kiogimwenda/AR_Windscreen/hardware/README.md

# Hardware

The custom hardware of the two-box hub: `docs/BUILD_GUIDE.md` Part 4.8 is the design, Part 14
Phase 12B the plan.

| Directory | Contents | Status (2026-10-06) |
|---|---|---|
| `gen/` | The board descriptions, the power board's drawing, and the tools that turn them into KiCad files and check them | Done |
| `pod_board/` | KiCad 10 project: STM32F405RGT6, 8 MHz crystal, USB-C, diode-OR'd 5 V to 3.3 V, IMU / GNSS / gesture / SWD / ELM327 headers, status LEDs, DB-25 with series resistors and input filters. 4-layer. | Schematic done, ERC clean, cross-checked; **placed** (77 parts, 0 DRC errors, matches the schematic); **routing to do** (`LAYOUT_GUIDE.md`) |
| `power_board/` | KiCad 10 project: 12 V fuse, TVS and reverse-polarity diode; TPS54360 5 V (TI reference design); 3.3 V; 74HCT244 buffer; BTS7960 and ACS712 module headers; magnet and relay MOSFETs with flyback diodes; fail-safe pull-downs; SN65HVD230 CAN; presence MOSFET; PC817 brake-light input; terminals for the kill relay, E-stop, relays, actuator, LiDAR and OBD lead; DB-25. 2-layer, 2 oz. | Schematic done, ERC clean, cross-checked; **placed** (82 parts, 0 DRC errors, matches the schematic); **routing to do** (`LAYOUT_GUIDE.md`) |
| `enclosures/` | OpenSCAD: LiDAR roof mount, power-box chassis and box drilling templates; shared board outlines (`common/boards.scad`). See its README. | LiDAR mount and power box designed; pod, E-stop and gesture puck wait for the parts and the car |

Each board folder also has `<board>.pdf` (the schematic, for reading without KiCad) and
`<board>_bom.csv` (parts grouped by value and footprint).

## How the schematics are made and checked

```bash
hardware/gen/check.sh
```
1. `gen/generate.py` writes both `.kicad_sch` files from `gen/pod_board.py` and
   `gen/power_board.py`. Each part names its KiCad symbol, footprint and value and maps **pin
   numbers to net names**; the generator copies the real library symbols in.
   - **Both boards are drawn (2026-10-07).** `gen/power_board_drawing.py` places every part by hand
     on one of eight function sheets (12 V input, 5 V converter, 3.3 V and feeds, brake actuator,
     signal relays, CAN, status inputs, DB-25), and `gen/kisheet.py` routes **real wires** between
     the pins, puts power symbols on power pins, names each net with a label, and draws a root
     sheet that is the **block diagram**: one box per sheet, the cable signals wired between them.
     Open `power_board.kicad_pro`, start on the block diagram, double-click a box to enter it.
     `gen/pod_board_drawing.py` does the same for the pod: power, USB-C, the MCU (in the middle,
     every pin straight out to a port), sensors and local connectors, status LEDs, and the cable
     interface (series resistors, pull-ups and filters fanning in to the DB-25 without a crossing).
2. KiCad's ERC must report **0 violations**. For each drawn board, the label-only version is also
   generated (in a scratch directory) and `gen/compare_nets.py` requires the two netlists to be
   **identical**: same parts, values and footprints, every net joining the same pins under the
   same name. The drawing therefore cannot have changed the circuit. The wire router never lets two
   nets touch; a wire may only cross another at right angles over a plain run (no dot, no
   connection), never at a bend, pin or junction.
3. `gen/check_nets.py` reads the exported netlists and verifies, against the sources of truth:
   - every pin in `firmware/.../Config.h` is on the right STM32 pin of the pod board;
   - every DB-25 pin on both boards matches the table in BUILD_GUIDE 4.8.3 (parsed from the guide);
   - pod: each cable line passes through a series resistor; inputs read safe when unplugged;
   - power board: every pod-driven line is pulled to its safe state (Part 4.8.4's rule);
   - no misspelt single-connection nets; no pin in two nets (two parts sharing a reference,
     which KiCad's ERC does not report); every footprint exists in KiCad's library.

   It was tested by breaking the design on purpose (a relay moved to the wrong MCU pin, a
   pull-down removed, two cable pins swapped); each was caught.

**Change the design in `gen/*.py`, never only in KiCad's editor**, then run `check.sh`. Edits made
only in the `.kicad_sch` are overwritten by the next generation. (Once layout starts, the
schematic can be frozen and edited in KiCad directly; then stop regenerating and keep running the
netlist check: export the netlist from KiCad and run `check_nets.py` on it.)

## Choices made during schematic capture (see also decisions.md)

- **Reverse polarity: a B560C Schottky, not a P-MOSFET.** SOT-23 P-MOSFETs are rated −30 V, too
  close to the TVS's ~39 V clamp. The diode drops ~0.6 V (~1 W at 2 A) and needs no gate circuit.
- **5 V converter: TI's TPS54360 reference design, unchanged** (datasheet SLVSBB4G, Figure 34):
  600 kHz, 8.2 µH, B560C, 2 × 47 µF, compensation 13.0 k / 6800 p / 39 p, start 8 V / stop 6.25 V.
  Copying a validated design is the right call for a first board; it is rated well beyond our
  ~1 A load.
- **Relays and magnet: logic-level MOSFETs driven straight from the cable lines** (AO3400A turns
  fully on at 2.5 V); the 74HCT244 buffers only the BTS7960 module's three 5 V inputs.
- **Back-powering:** each pod output has a 1 k series resistor (330 Ω on CAN_TX for its 500 kbit/s
  edges), so a pod running on USB cannot push more than ~3 mA per line into an unpowered box.
- **Module headers are placeholders for breakouts** (BNO085, NEO-M8N): the pin order on `J2` and
  `J3` of the pod board must be matched to the actual breakouts bought **before layout**.

## What remains for Phase 12B (Ian's work)

**Both boards are placed (2026-10-08): routing, finishing and ordering remain, step by step in
[`LAYOUT_GUIDE.md`](LAYOUT_GUIDE.md).** `gen/layout.sh` built each `.kicad_pcb` from the board
descriptions: every footprint from KiCad's library, each pad on its net (from KiCad's own
netlist), placed per `gen/placement.py` (each position with its reason, listed in
`<board>/placement.md`, pictured in `<board>/placement.png`), linked to its schematic symbol, the
net classes and fab rules (`gen/pcb_rules.py`, track widths from IPC-2221) and the copper planes
in place; then KiCad's DRC with the schematic-parity check: 0 errors, exact parity. The schematic
generator now gives every object a deterministic id, so the links survive regeneration and the
files only change when the design does.

The notes below are the layout principles the placement follows (and the guide expands).

**Pod board (4-layer: signal / ground / power / signal).**
- Decoupling capacitors (C3–C9) at their VDD pins, each with its own via to the ground plane.
  VCAP capacitors (C10, C11) right at pins 31 and 47.
- Crystal (Y1, C12, C13) within ~5 mm of PH0/PH1, nothing routed underneath, guard with ground.
- USB D+/D− as a matched pair (~90 Ω differential), short, the ESD chip (U4) right at the socket.
- The GNSS breakout at the board edge that faces the glass, away from the MCU and the USB; keep
  the ground plane unbroken under it.
- The IMU breakout on standoffs at a fixed, known orientation (record it: Part 12.2.2 calibrates
  it, but a sensible starting orientation makes the calibration easy to check).
- DB-25 at one end, the series resistors and input filters right behind it.
- Status LEDs on the edge that faces the driver.

**Power board (2-layer, 2 oz copper).**
- The TPS54360's power loop is the critical path: input capacitors (C21, C22), the IC, the catch
  diode (D13) and the inductor (L1) as close together as possible, the SW node small (it is the
  board's noise source), the feedback divider (R44, R45) away from L1 and the SW node. Follow the
  datasheet's layout example (its "Layout" section) closely.
- Wide traces or pours for the 12 V input, the actuator rail (ACT_12V) and the relay coils' +12 V;
  the actuator's heavy current itself runs in wire on the BTS7960 module, not on this board.
- Fuse holders and terminal blocks along the edges, grouped by what they connect to (12 V in,
  actuator side, car-wiring side).
- The SN65HVD230 and its ESD diode (D20) right at the OBD terminal block.
- The 10 k pull-downs close to the DB-25, so the lines are defined as soon as they enter the board.

**Then:** DRC clean, a 1:1 paper print to check every footprint against the real part, Gerbers,
order (JLCPCB / PCBWay), assemble, and bring up with Part 4.7 before the bench gate is re-run on
this hardware (three consecutive passes of all six items).

## Board outlines: the one constraint shared with the enclosures

```bash
python3 hardware/gen/outlines.py           # --force to overwrite a .kicad_pcb already being laid out
```
`gen/outlines.py` holds each board's size, corner radius, M3 mounting holes and the positions of
its edge connectors (DB-25, USB-C, fuses, terminal blocks, LEDs, headers). It writes the starter
`<board>.kicad_pcb` (outline on Edge.Cuts, hole positions on User.Drawings, connector boxes on
User.Comments: place H1–H4 and the connectors on them) and `enclosures/common/boards.scad`, which
the enclosure models include. Pod board 70 × 53 mm, 4 layers; power board 95 × 66 mm, 2 layers (compacted 2026-10-08 from 80 × 55 and 110 × 80; the power board 5 mm wider again on 2026-10-09 for its silkscreen labels).
If a layout needs a change, change it there and regenerate both. The starter files passed KiCad's
DRC with no errors.

**Placed and routed (2026-10-09):** `gen/layout.sh` places every part (`gen/placement.py`, with
each position's reason and the silkscreen names), `gen/route.sh` routes both boards to the
specification and keeps a board only with 0 unconnected, 0 DRC errors and exact schematic parity,
and `gen/routespec.sh` checks what the DRC cannot (planes, crystal, converter, widths). How it was
done and how to review it: `LAYOUT_GUIDE.md`.
