kiogimwenda/AR_Windscreen/docs/report/final/README.md

# Final report: draft sections

Drafts of the final report's sections that need no test results, following BUILD_GUIDE Part 16.1's
structure. They are written from the design as built (the guide, `docs/decisions.md`, the code)
on 2026-10-16, for Ian to rewrite in his own voice and check against his supervisor's template.

Citations use the proposal's keys, `{{cite:key}}`, so `docs/report/proposal/src/references.py`
can resolve them. Places that need a test result, a photograph or a final figure are marked
**[RESULT: …]** or **[FIGURE: …]**; nothing in these drafts claims a measurement that has not been
made.

| Part 16.1 section | File | State |
|---|---|---|
| 1. Executive Summary | — | after the results |
| 2. Motivation and Scope | `02_motivation_scope.md` | drafted |
| 3. System Architecture | `03_system_architecture.md` | drafted; the diagram to redraw |
| 4. Software Architecture | `04_software_architecture.md` | drafted |
| 5. Actuation Safety Design | `05_actuation_safety.md` | drafted; bench evidence slots |
| 6. Precision Navigation Overlay Design | `06_navigation_overlay.md` | drafted; Part 12.4 figures slot |
| 7. Hardware Bill of Materials | — | needs the actual costs |
| 8. Calibration | — | needs the results |
| 9. Testing and Validation | `09_testing_validation.md` | 9.1 circuit simulations drafted, with their figures (`figures/`); bench and road tests wait |
| 10. Results and Discussion | — | needs the results |
| 11. Future Work | `11_future_work.md` | drafted |
| 12. Conclusion | — | after the results |
