kiogimwenda/AR_Windscreen/hardware/pod_board/placement.md

<!-- Generated by hardware/gen/layout.py from placement.py: do not edit. -->

# pod_board: placement (70 x 53 mm, 4 layers)

x, y: mm from the board's top-left corner (y down); rotation: degrees, counter-clockwise; the position is the footprint's origin (pin 1 for connectors and headers, the centre for most SMD parts). See hardware/LAYOUT_GUIDE.md.

| Ref | Value | x | y | Rot | Why it is there |
|---|---|---|---|---|---|
| C1 | 1u | 49.50 | 18.60 | 0 | LDO input capacitor |
| C2 | 4.7u | 54.50 | 22.40 | 90 | LDO output capacitor |
| C3 | 100n | 26.20 | 7.70 | 0 | 100 nF at VDD pin 64 / VSS 63 (top-left pins) |
| C4 | 100n | 36.60 | 12.50 | 90 | 100 nF at VDD pin 48 (right side) |
| C5 | 100n | 23.90 | 24.60 | 90 | 100 nF at VDD pin 19 / VSS 18 (bottom-left pins) |
| C6 | 100n | 34.30 | 25.60 | 90 | 100 nF at VDD pin 32 |
| C7 | 4.7u | 39.70 | 16.50 | 90 | 4.7 uF bulk beside the MCU |
| C8 | 1u | 15.60 | 23.60 | 90 | 1 uF on VDDA, pin 13 |
| C9 | 100n | 19.00 | 23.30 | 0 | 100 nF on VDDA, pin 13: the smaller capacitor nearer the pin |
| C10 | 2.2u | 32.00 | 25.60 | 90 | 2.2 uF at VCAP1, pin 31: right at the pin |
| C11 | 2.2u | 36.60 | 16.30 | 90 | 2.2 uF at VCAP2, pin 47: right at the pin |
| C12 | 15p | 13.00 | 18.55 | 90 | crystal load capacitor beside Y1 pin 1 |
| C13 | 15p | 13.00 | 10.05 | 90 | crystal load capacitor beside Y1 pin 2 |
| C14 | 100n | 6.60 | 22.00 | 90 | NRST capacitor beside the RESET button |
| C15 | 4.7n | 58.00 | 23.80 | 0 | USB shield capacitor |
| C54 | 10n | 21.15 | 29.90 | 90 | cable line conditioning, in line with DB-25 pin 12 |
| C57 | 10n | 18.38 | 29.90 | 90 | cable line conditioning, in line with DB-25 pin 13 |
| C60 | 10n | 36.38 | 29.90 | 90 | cable line conditioning, in line with DB-25 pin 19 |
| C65 | 100n | 26.69 | 29.90 | 90 | cable line conditioning, in line with DB-25 pin 10 |
| D1 | SS14 | 49.50 | 14.50 | 0 | USB VBUS into the pod supply (diode-OR) |
| D2 | SS14 | 49.50 | 10.20 | 0 | cable +5 V into the pod supply (diode-OR) |
| D3 | green | 10.00 | 2.10 | 0 | POWER LED (green), top edge |
| D4 | blue | 14.20 | 2.10 | 0 | LINK LED (blue), top edge |
| D5 | amber | 18.40 | 2.10 | 0 | ARMED LED (amber), top edge |
| D6 | red | 22.60 | 2.10 | 0 | FAULT LED (red), top edge |
| H1 | M3 | 4.00 | 4.00 | 0 | mounting hole (outlines.py) |
| H2 | M3 | 66.00 | 4.00 | 0 | mounting hole |
| H3 | M3 | 4.00 | 38.50 | 0 | mounting hole, above the DB-25 band |
| H4 | M3 | 66.00 | 38.50 | 0 | mounting hole, above the DB-25 band |
| J1 | USB-C | 65.80 | 13.50 | 90 | USB-C opening on the right edge (enclosure cut-out) |
| J2 | IMU (BNO085 breakout) | 42.00 | 4.50 | 270 | IMU breakout header on the top edge: the breakout stands above the top-middle area on standoffs |
| J3 | GNSS (NEO-M8N breakout) | 60.50 | 4.50 | 270 | GNSS cable header at the top edge: the antenna lead goes up to the pod's roof face |
| J4 | Gesture puck (JST-GH) | 66.00 | 25.50 | 90 | Gesture puck cable (JST-GH) on the right edge, below the USB |
| J5 | SWD (ST-Link) | 3.50 | 9.40 | 0 | SWD header on the left edge: reachable with the board mounted |
| J6 | ELM327 fallback (USART3) | 12.00 | 27.00 | 0 | ELM327 fallback header: an internal lead to the module inside the pod, so inboard, leaving the left edge to the programming controls |
| J7 | DB-25 to power box | 51.62 | 45.22 | 0 | DB-25 on the bottom edge, flange flush, centred (the enclosure's cut-out) |
| J8 | IMU reset (optional wire) | 46.00 | 4.50 | 0 | IMU reset pin beside J2: an optional jumper wire to the breakout's RST |
| R1 | 10k | 9.50 | 13.50 | 90 | BOOT0 pull-down |
| R2 | 5.1k | 57.80 | 9.30 | 0 | USB-C CC1 5.1 k, at the socket |
| R3 | 5.1k | 57.80 | 17.80 | 0 | USB-C CC2 5.1 k, at the socket |
| R4 | 1M | 58.00 | 21.30 | 0 | USB shield bleed resistor |
| R5 | 4.7k | 41.50 | 8.50 | 0 | IMU I2C pull-up (SCL), below J2 |
| R6 | 4.7k | 41.50 | 11.00 | 0 | IMU I2C pull-up (SDA), below J2 |
| R7 | 2.2k | 59.00 | 27.20 | 0 | gesture I2C pull-up (SCL), beside J4 |
| R8 | 2.2k | 59.00 | 29.70 | 0 | gesture I2C pull-up (SDA), beside J4 |
| R30 | 1k | 10.00 | 5.20 | 0 | POWER LED resistor |
| R31 | 1k | 14.20 | 5.20 | 0 | LINK LED resistor |
| R32 | 1k | 18.40 | 5.20 | 0 | ARMED LED resistor |
| R33 | 1k | 22.60 | 5.20 | 0 | FAULT LED resistor |
| R40 | 1k | 40.54 | 41.00 | 90 | cable line conditioning, in line with DB-25 pin 5 |
| R41 | 1k | 35.00 | 41.00 | 90 | cable line conditioning, in line with DB-25 pin 7 |
| R42 | 1k | 32.23 | 41.00 | 90 | cable line conditioning, in line with DB-25 pin 8 |
| R43 | 1k | 29.46 | 41.00 | 90 | cable line conditioning, in line with DB-25 pin 9 |
| R44 | 1k | 50.23 | 37.30 | 90 | cable line conditioning, in line with DB-25 pin 14 |
| R45 | 1k | 47.46 | 37.30 | 90 | cable line conditioning, in line with DB-25 pin 15 |
| R46 | 1k | 44.69 | 37.30 | 90 | cable line conditioning, in line with DB-25 pin 16 |
| R47 | 1k | 41.92 | 37.30 | 90 | cable line conditioning, in line with DB-25 pin 17 |
| R48 | 1k | 39.15 | 37.30 | 90 | cable line conditioning, in line with DB-25 pin 18 |
| R49 | 330 | 33.61 | 37.30 | 90 | cable line conditioning, in line with DB-25 pin 20 |
| R50 | 1k | 28.07 | 37.30 | 90 | cable line conditioning, in line with DB-25 pin 22 |
| R51 | 1k | 22.53 | 37.30 | 90 | cable line conditioning, in line with DB-25 pin 24 |
| R52 | 1k | 21.15 | 41.00 | 90 | cable line conditioning, in line with DB-25 pin 12 |
| R53 | 10k | 21.15 | 33.60 | 90 | cable line conditioning, in line with DB-25 pin 12 |
| R55 | 1k | 18.38 | 41.00 | 90 | cable line conditioning, in line with DB-25 pin 13 |
| R56 | 10k | 18.38 | 33.60 | 90 | cable line conditioning, in line with DB-25 pin 13 |
| R58 | 1k | 36.38 | 37.30 | 90 | cable line conditioning, in line with DB-25 pin 19 |
| R59 | 10k | 36.38 | 33.60 | 90 | cable line conditioning, in line with DB-25 pin 19 |
| R61 | 100 | 30.84 | 37.30 | 90 | cable line conditioning, in line with DB-25 pin 21 |
| R62 | 10k | 30.84 | 33.60 | 90 | cable line conditioning, in line with DB-25 pin 21 |
| R63 | 100 | 25.30 | 37.30 | 90 | cable line conditioning, in line with DB-25 pin 23 |
| R64 | 1k | 26.69 | 41.00 | 90 | cable line conditioning, in line with DB-25 pin 10 |
| R66 | 100k | 26.69 | 33.60 | 90 | cable line conditioning, in line with DB-25 pin 10 |
| SW1 | RESET | 2.10 | 24.20 | 270 | RESET button on the left edge, below the SWD header |
| SW2 | BOOT | 2.10 | 30.00 | 270 | BOOT button (hold at reset for USB DFU) on the left edge, below RESET |
| U1 | STM32F405RGT6 | 28.00 | 16.00 | 0 | STM32F405 in the middle: every subsystem fans out to it |
| U3 | AP2112K-3.3 | 49.50 | 22.40 | 0 | 3.3 V LDO between the supply diodes and the MCU |
| U4 | USBLC6-2SC6 | 57.50 | 13.50 | 0 | USB ESD protection right at the socket's data pins |
| Y1 | 8MHz | 17.60 | 14.30 | 90 | 8 MHz crystal, upright, within 5 mm of OSC_IN/OUT (pins 5, 6); nothing routed under it |
