kiogimwenda/AR_Windscreen/hardware/power_board/placement.md

<!-- Generated by hardware/gen/layout.py from placement.py: do not edit. -->

# power_board: placement (95 x 66 mm, 2 layers)

x, y: mm from the board's top-left corner (y down); rotation: degrees, counter-clockwise; the position is the footprint's origin (pin 1 for connectors and headers, the centre for most SMD parts). See hardware/LAYOUT_GUIDE.md.

| Ref | Value | x | y | Rot | Why it is there |
|---|---|---|---|---|---|
| C20 | 47u 63V | 20.40 | 38.00 | 0 | 47 uF bulk on +12 V before the converter |
| C21 | 2.2u 100V | 36.60 | 20.50 | 90 | input capacitor right above VIN (pin 2): the hot loop |
| C22 | 2.2u 100V | 40.00 | 20.50 | 90 | second input capacitor, beside the first |
| C23 | 100n | 40.40 | 27.00 | 270 | bootstrap capacitor beside U1, between BOOT (pin 1) and SW (pin 8) |
| C24 | 47u | 57.50 | 22.00 | 90 | output capacitor at the inductor's output |
| C25 | 47u | 57.50 | 28.00 | 90 | second output capacitor |
| C26 | 6800p | 29.80 | 41.60 | 0 | compensation capacitor, below R46 |
| C27 | 39p | 29.80 | 39.10 | 180 | compensation high-frequency capacitor |
| C28 | 10u | 37.00 | 43.20 | 0 | LDO input capacitor |
| C29 | 10u | 37.00 | 50.80 | 0 | LDO output capacitor |
| C30 | 10u | 30.00 | 19.80 | 0 | 5V_POD capacitor after the polyfuse |
| C31 | 100n | 67.00 | 32.50 | 0 | 74HCT244 decoupling |
| C32 | 100n | 41.50 | 50.50 | 0 | transceiver decoupling, beside its VCC pin 3 (the right side stays clear for the CAN_STBY line to pin 8) |
| D10 | SMCJ33CA | 21.50 | 15.50 | 90 | TVS straight after the fuse: clamps transients before anything else |
| D11 | B560C | 21.50 | 26.50 | 90 | reverse-polarity Schottky after the TVS |
| D12 | green | 16.40 | 40.40 | 0 | 12 V present LED near the input |
| D13 | B560C | 37.50 | 35.00 | 180 | catch diode right below the SW pin, cathode to it: the hot loop |
| D14 | SS14 | 82.00 | 45.50 | 180 | magnet flyback diode right below the magnet terminal J7: its cathode on the actuator-rail zone, its anode facing inboard (clear of the rail) for MAG_NEG |
| D15 | SS14 | 55.00 | 46.00 | 90 | relay LEFT flyback diode, beside its MOSFET |
| D16 | SS14 | 60.08 | 46.00 | 90 | relay RIGHT flyback diode, beside its MOSFET |
| D17 | SS14 | 65.16 | 46.00 | 90 | relay HAZARD flyback diode, beside its MOSFET |
| D18 | SS14 | 70.24 | 46.00 | 90 | relay HORN flyback diode, beside its MOSFET |
| D19 | SS14 | 75.32 | 46.00 | 90 | relay BEAM flyback diode, beside its MOSFET |
| D20 | NUP2105L | 51.00 | 50.30 | 0 | CAN ESD diode between the transceiver and the terminal |
| D21 | 1N4148W | 17.20 | 47.00 | 0 | opto LED reverse protection |
| F1 | 3A | 4.50 | 10.00 | 0 | 3 A input fuse, top-left (reachable when the lid is off) |
| F2 | 500mA | 34.00 | 12.00 | 0 | 500 mA polyfuse for the pod's supply, near DB-25 pins 1-2 |
| F3 | 3A | 4.50 | 18.00 | 0 | 3 A LiDAR fuse, below F1 |
| H1 | M3 | 4.00 | 4.00 | 0 | mounting hole |
| H2 | M3 | 91.00 | 4.00 | 0 | mounting hole |
| H3 | M3 | 4.00 | 51.50 | 0 | mounting hole, above the bottom terminal row |
| H4 | M3 | 91.00 | 51.50 | 0 | mounting hole, above the bottom terminal row |
| J1 | DB-25 to pod | 28.38 | 7.78 | 180 | DB-25 on the top edge, flange flush (the box's front-wall cut-out) |
| J2 | 12 V ACC in | 5.75 | 27.92 | 270 | 12 V ACC input terminal on the left edge, below its fuse |
| J3 | LiDAR 12 V out | 5.75 | 39.42 | 270 | LiDAR 12 V terminal on the left edge, below J2 |
| J4 | Relay coils | 55.00 | 60.80 | 0 | relay coils: common +12 V and five returns |
| J5 | Actuator 12 V from kill relay | 89.25 | 16.08 | 90 | actuator 12 V from the kill relay: right edge, the 10 A path starts here |
| J6 | BTS7960 B+ / B- | 89.25 | 27.58 | 90 | to the BTS7960's B+/B-: next to J5, so the 10 A path is ~12 mm |
| J7 | Cable magnet | 89.25 | 39.08 | 90 | cable magnet, on the same actuator rail |
| J8 | Kill relay coil feed | 3.60 | 60.80 | 0 | kill relay coil feed (via the E-stop) |
| J9 | E-stop sense contact | 15.12 | 60.80 | 0 | E-stop sense contact |
| J10 | Brake-light switch | 26.72 | 60.80 | 0 | brake-light switch input |
| J11 | OBD-II lead | 38.34 | 60.80 | 0 | OBD-II lead (CAN-H, CAN-L, GND) |
| J12 | Bench: HX711 | 58.00 | 32.50 | 0 | bench HX711 header (bench only), beside the converter's output |
| J13 | BTS7960 module | 75.00 | 11.50 | 0 | BTS7960 logic header, beside its module (the box puts it next to this edge) |
| J14 | ACS712 module | 75.00 | 35.50 | 0 | ACS712 module header |
| L1 | 8.2u | 48.50 | 25.00 | 0 | inductor on the SW side; keep the SW copper small |
| Q2 | AO3400A | 63.00 | 37.00 | 0 | cable-magnet MOSFET |
| Q3 | AO3400A | 55.00 | 52.00 | 0 | relay LEFT MOSFET, beside its J4 terminal |
| Q4 | AO3400A | 60.08 | 52.00 | 0 | relay RIGHT MOSFET, beside its J4 terminal |
| Q5 | AO3400A | 65.16 | 52.00 | 0 | relay HAZARD MOSFET, beside its J4 terminal |
| Q6 | AO3400A | 70.24 | 52.00 | 0 | relay HORN MOSFET, beside its J4 terminal |
| Q7 | AO3400A | 75.32 | 52.00 | 0 | relay BEAM MOSFET, beside its J4 terminal |
| Q8 | 2N7002 | 62.00 | 13.50 | 0 | BOX_PRESENT MOSFET near DB-25 pin 13 |
| R40 | 4.7k | 16.40 | 43.20 | 0 | its resistor |
| R41 | 523k | 30.00 | 25.10 | 0 | UVLO divider (top) left of U1, its EN pad on the channel |
| R42 | 84.5k | 30.00 | 27.20 | 180 | UVLO divider (bottom), its EN pad on the channel |
| R43 | 162k | 30.00 | 29.30 | 180 | RT resistor (600 kHz), its RT pad on the channel |
| R44 | 53.6k | 29.80 | 34.10 | 0 | feedback divider (top): its FB pad right below R45's (one straight link) |
| R45 | 10.2k | 29.80 | 31.60 | 180 | feedback divider (bottom) beside FB, pin 5, away from L1 and the SW node |
| R46 | 13.0k | 29.80 | 36.60 | 180 | compensation resistor, its COMP pad facing pin 6 |
| R47 | 10k | 70.00 | 35.00 | 0 | current-sense divider (top), by the ACS712 header |
| R48 | 20k | 70.00 | 37.50 | 0 | current-sense divider (bottom) |
| R50 | 10k | 39.46 | 12.50 | 90 | fail-safe resistor in line with DB-25 pin 5, where the line enters the board |
| R51 | 10k | 45.00 | 12.50 | 90 | fail-safe resistor in line with DB-25 pin 7, where the line enters the board |
| R52 | 10k | 47.77 | 12.50 | 90 | fail-safe resistor in line with DB-25 pin 8, where the line enters the board |
| R53 | 10k | 50.54 | 12.50 | 90 | fail-safe resistor in line with DB-25 pin 9, where the line enters the board |
| R54 | 10k | 29.77 | 16.20 | 90 | fail-safe resistor in line with DB-25 pin 14, where the line enters the board |
| R55 | 10k | 32.54 | 16.20 | 90 | fail-safe resistor in line with DB-25 pin 15, where the line enters the board |
| R56 | 10k | 35.31 | 16.20 | 90 | fail-safe resistor in line with DB-25 pin 16, where the line enters the board |
| R57 | 10k | 38.08 | 16.20 | 90 | fail-safe resistor in line with DB-25 pin 17, where the line enters the board |
| R58 | 10k | 40.85 | 16.20 | 90 | fail-safe resistor in line with DB-25 pin 18, where the line enters the board |
| R59 | 10k | 46.39 | 16.20 | 90 | fail-safe resistor in line with DB-25 pin 20, where the line enters the board |
| R60 | 10k | 51.93 | 16.20 | 90 | fail-safe resistor in line with DB-25 pin 22, where the line enters the board |
| R61 | 10k | 66.50 | 12.50 | 0 | presence gate divider (top) |
| R62 | 100k | 66.50 | 15.00 | 0 | presence gate divider (bottom) |
| R63 | 4.7k | 17.20 | 50.50 | 0 | opto LED resistor |
| U1 | TPS54360DDA | 36.00 | 27.00 | 270 | TPS54360 at the heart of the converter block, turned so its SW pin (8) is the corner nearest both D13 and L1: the switch node is a few mm, on the top layer |
| U2 | AP2112K-3.3 | 37.00 | 47.00 | 0 | 3.3 V LDO for the transceiver |
| U3 | 74HCT244 | 67.00 | 24.00 | 0 | 74HCT244 buffer between the DB-25 lines and the BTS7960 header |
| U4 | SN65HVD230 | 44.00 | 46.00 | 0 | SN65HVD230 right above the OBD terminal: the bus stub is the lead only |
| U5 | PC817 | 24.00 | 46.50 | 0 | PC817 optocoupler above the brake-light terminal |
