kiogimwenda/AR_Windscreen/docs/decisions.md

# Implementation Decisions

A short index of implementation choices made where `BUILD_GUIDE.md` was ambiguous, under-specified,
or internally inconsistent. One line of rationale each — the detailed narrative lives in
`progress-log.md`, and the two files are never merged.

---

## Phase 0 — Scaffold

**Repository root name.** The guide's Part 1 tree is rooted at `ar-drive-assist/`; this repository
is `AR_Windscreen`. The tree's *contents* were created at the repository root rather than nested
inside a second `ar-drive-assist/` directory, since the guide's tree describes repository layout,
not a subdirectory.

**`cmake/` directory.** Not listed in Part 1's tree, but Part 5.2 requires
`cmake/FindTensorRT.cmake`. Created at the repository root, which is where Part 5.2's relative path
points.

**`FindTensorRT.cmake` include path.** Part 5.2 writes
`include(${CMAKE_SOURCE_DIR}/../cmake/FindTensorRT.cmake)`. That snippet assumed `host/` was the
top-level CMake source directory; here the repository root is, so `${CMAKE_SOURCE_DIR}/..` would
resolve outside the repository. Changed to `${CMAKE_CURRENT_SOURCE_DIR}/../cmake/...`, which is
correct both now and if the tree is relocated.

**`host/src/` mirrors `host/include/` with header-only exceptions.** Part 1 says "one .cpp per .h".
Six headers are header-only by nature and were given no `.cpp`: `common/Types.h`,
`common/RingBuffer.h` (a template), `vehicle/HubProtocol.h` (packed structs),
`vehicle/Crc16.h` (a single `inline` function), `lidar/GroundPlaneModel.h` (a struct), and
`render/DisplaySink.h` (a pure-virtual interface). An empty translation unit for each would add
build-graph noise with no benefit. `vehicle/Crc16.h` and `vehicle/HubProtocol.h` additionally must
stay byte-for-byte identical to their firmware counterparts, so nothing may be moved out of them.

**`common/schemas/` and `common/RingBuffer.h`.** Not in Part 1's tree, but required by Part 3.5 and
Part 5.3 respectively. Created as stubs in Phase 0 alongside everything else so the structure is
stable; contents land in Phase 3.

**`.clang-format` added.** CI's `format-check` job (Part 13.5) runs `clang-format --dry-run
--Werror` but the guide specifies no style file, which would leave CI enforcing LLVM defaults by
accident. Pinned to Google style with a 100-column limit and 4-space indents, matching the code
samples throughout the guide itself.

**`host/test/CMakeLists.txt` does not add `test/unit/`.** Part 5.2's `add_subdirectory(test)` and
Part 13.1's "unit tests build as their own lightweight CMake project" pull in opposite directions.
Resolved in favour of 13.1, which states the reason explicitly: pulling `unit/` into the main build
would silently give it CUDA/TensorRT/SDL2 dependencies and break the GPU-less CI runner. The unit
suite is configured separately via `cmake -S host/test/unit -B host/test/unit/build`.

**`file(GLOB_RECURSE ...)` given `CONFIGURE_DEPENDS`.** The guide specifies a bare glob, which only
re-evaluates on reconfigure — meaning a newly added `.cpp` silently fails to build until something
else triggers a reconfigure. `CONFIGURE_DEPENDS` costs a stat sweep per build and removes that
failure mode.

**LICENSE: MIT.** The guide lists `LICENSE` in the tree without specifying a license. MIT chosen as
a permissive default; change it if the institution's FYP submission rules require otherwise.

**Firmware build is not driven from the top-level `CMakeLists.txt`.** The firmware is a PlatformIO
project with its own toolchain (Part 4.7). Keeping the two build systems separate mirrors the hard
host/hub boundary from Part 0.

## Phase 0 — Environment

**OpenCV 4.14.0-pre (source build at `/usr/local`) accepted in place of the guide's 4.10.0.** Part
2.5 pins 4.10.0, but the OpenCV already installed on this machine is a 4.14.0 source build with
CUDA 13.1 + cuDNN 9.19.1 and working `cv::cuda` on `sm_120`. Part 2.4's stronger rule — use the
CUDA/TensorRT versions already validated here, do not mix major versions — points the same way:
4.10.0 predates CUDA 13 and would not build against the installed toolkit. `find_package(OpenCV
4.10 REQUIRED)` is a minimum-version check, so the guide's CMake is unchanged. The Python `cv2`
4.10.0 in `~/ml-env` is an unrelated pip wheel with no CUDA and is not what the C++ build links.

**PCL requested by component, not as a whole.** Debian 13's VTK 9.3 CMake package declares link
dependencies on targets it never calls `find_dependency()` for (`JsonCpp::JsonCpp`, then
`MPI::MPI_C`, and more behind those), so any PCL lookup that reaches VTK fails at configure time.
Requesting `common filters segmentation kdtree search sample_consensus` avoids VTK entirely and is
correct on its own terms — Part 8.1 needs exactly those, and this project renders through OpenCV
and SDL2, never `pcl::visualization`. `io` is excluded specifically because it re-admits VTK; if
Phase 6 wants debug point-cloud dumps, write the PCD directly.

**`lib_deps = FreeRTOS` replaced with `stm32duino/STM32duino FreeRTOS@^10.3.3`.** Part 4.1's bare
name resolves to feilipu's AVR-only `Arduino_FreeRTOS_Library` and fails on `<avr/io.h>` when
cross-compiling for ARM. The STM32 port exposes the native FreeRTOS API (`xTaskCreate`,
`vTaskStartScheduler`) that Part 4.3 uses directly, so no Part 4.3 code needs rewriting — a
CMSIS-RTOS wrapper would have forced that.

**OSRM built from source (v6.0.0) rather than `apt install osrm-tools`.** Part 2.7's package does
not exist in Debian 13 under any name. Built against system Boost 1.83 and oneTBB 2022.1 into
`~/src/osrm-backend`. The same gap affects Part 13.5's CI job, which installs `libosrm-dev` on
`ubuntu-latest` — that will need addressing before Phase 8 puts anything in `test_map_matcher.cpp`.

**STM32 board left as the guide's `blackpill_f411ce` placeholder.** Part 4.1 says to substitute the
exact board on hand; that board has not been identified yet. To be revisited at the start of
Phase 2.

**OSRM built as a pinned v6.0.0 against system Boost/oneTBB, installed to `/usr/local`.** Source
kept in `~/src/osrm-backend`, outside this repository — it is a system dependency, not project
source. Using the distribution's Boost 1.83 and oneTBB rather than bundled copies keeps a single
copy of each in the host process, which matters because the host binary links OSRM alongside PCL
and PCL also uses Boost. Its build needs `-Wno-error=array-bounds` and friends passed via
`CMAKE_CXX_FLAGS_RELEASE` (not `CMAKE_CXX_FLAGS`, where OSRM's own appended `-Werror` would defeat
them) to get past GCC 14 false positives in OSRM's vendored fmt/sol2 headers.

## Phase ordering under a hardware-free start

**Phase 0 treated as complete-except-check-4, rather than blocking all work.** Part 2.10's camera
check cannot pass until hardware is purchased. The guide's rule against starting a phase before the
previous one's exit criteria are met exists so that later work is not built on an unverified
foundation — and nothing in Phase 1 (the shared protocol and its CRC tests) depends on a camera
existing. Blocking Phase 1 on check 4 would serve the letter of the rule against its purpose. The
check stays explicitly open in `progress-log.md` rather than being waived.

## Phase 1 — Shared protocol

**`#include <cstddef>` added to `Protocol.h`.** Part 3.1's snippet uses `size_t` while including
only `<cstdint>`, which compiles only where `<cstdint>` transitively provides it.

**Frame geometry constants added** (`HEADER_SIZE`, `CRC_SIZE`, `CRC_COVERED_OFFSET`,
`MAX_FRAME_SIZE`). Derived from Part 3.1's frame diagram, which otherwise leaves `VehicleInterface`
and `CommsTask` to re-derive the same offsets independently. The CRC covered range especially: a
mismatch there leaves both ends self-consistent and mutually incompatible, which surfaces only on
a bench.

**`static_assert` on every struct size and on `sizeof(float)`/`sizeof(double)`.** The two ends are
different architectures and compilers; `#pragma pack(push, 1)` removes padding but nothing
otherwise verifies that it did. These turn a silent layout disagreement into a build failure on
whichever side drifts. Negative-tested on the ARM cross-compile, not assumed.

**HEARTBEAT defined as a zero-payload message.** Part 3.3 requires it but specifies no struct.
Nothing needs to travel in it: the hub only needs evidence the host is alive, and staleness of an
actual request is already covered by `ActuationCommand::hostTimestampMs`.

**CRC test vectors duplicated in the host and firmware suites rather than shared.** The point of
Part 3's "implemented twice, kept identical" rule is independent confirmation. `protocol-sync-check`
proves the files match; the two suites prove each copy independently yields the standard results. A
shared vector header would reduce that to a single point of failure.

**`CommsTask.cpp` includes `Protocol.h` while still otherwise a stub.** `static_assert`s only fire
in a translation unit that compiles the header, and both test suites run on x86-64 — so without
this, the cross-architecture layout claim would be untested on the architecture it is about. A bare
`pio run` now checks it on ARM. `CommsTask` owns framing per Part 4.3, so the include belongs here.

**`[env:native]` added to `platformio.ini`, with `default_envs = stm32f4_hub`.** Gives Phase 1 an
automatable firmware-side test with no board attached, while keeping a bare `pio run` — which is
what CI's `firmware-build` job runs — building only the STM32 target.

**`.clang-format-ignore` patterns need `**`, not `*`.** Patterns are globs relative to the ignore
file and `*` does not cross `/`, so `.pio/*` matches nothing useful.

## Hardware procurement

**Bill of materials kept at `docs/bill-of-materials.md`.** Part 1's tree has no BOM file; it lives
beside `decisions.md` because it is a planning record, not code. Sourcing assumes Kenya (the dev
machine's timezone is Africa/Nairobi), local shops first, imports only where nothing local exists.

**STM32F401CC Black Pill proposed over the guide's F411.** The F411 is out of stock locally; the
F401 (K-Technics, KES 900) still meets Part 4.1's minimum. If bought, `platformio.ini`'s board
becomes `blackpill_f401cc` at the start of Phase 2.

**Level converters on every 3.3 V → 5 V module input.** BTS7960 boards' 74HC input buffers and
opto relay boards do not switch reliably from 3.3 V; marginal logic on a brake PWM line is not
acceptable under the Part 0 safety rule.

**Brake actuator purchase deferred pending a mechanical design decision.** Locally sold actuators
are non-back-drivable lead screws, which would hold the brake applied after a power cut if rigidly
coupled, contradicting the hard rule. Candidate direction (pull-only cable, fail-safe electromagnet
release, fast low-force actuator) recorded in the BOM's note B for supervisor review, not adopted.

**Two guide gaps flagged, not yet changed:** brake-light-switch sensing via optocoupler as a
fallback for `obdBrakePedalActive` (BOM note C), and Part 15.2's USB-C PD laptop charger being
undersized for an RTX 5060 laptop (BOM note D).

## Phase 3 — Host skeleton (software part)

**Phase 3 split: software parts built before Phase 2.** `RingBuffer`, `EventLog` and
`SystemManager` need no hardware. `VehicleInterface` and the Phase 3 exit test (loopback against the
real hub) wait for Phase 2. Phase 3 is not marked complete until then.

**`RingBuffer` drop-oldest is done by the consumer (`popLatest`), not the producer.** In an SPSC
queue only the consumer owns `tail_`; a producer that discarded the oldest item would race the
consumer reading that slot. `push` returns false when full and the caller applies the policy, as
Part 5.3's own comment on `push` says.

**`RingBuffer` capacity must be a power of two, and is exactly N.** Monotonic counters with
`% N` are only correct across counter wrap when N divides 2^64.

**Bus messages are FlatBuffers object-API structs (`--gen-object-api`), not serialized buffers.**
In-process hops gain nothing from serialisation; the byte form stays available for replay.

**`flatc` 24.3.25 built from OSRM's vendored source and installed to `/usr/local/bin`.** OSRM
installs FlatBuffers 24.3.25 headers into `/usr/local/include`, shadowing Debian's 23.5.26, and its
own public headers need them, so the host standardises on 24.3.25. `FlatBufferSchemas.cmake` fails
configure if `flatc` and the headers disagree.

**`EventLog`: raw `write()` per line; `fsync()` only for actuation, ack and fault lines.** `write()`
alone survives a process crash (Part 11.6's requirement). `fsync` adds power-loss durability where
it matters, without its cost on routine lines.

**`EventLog` failure latches `healthy()` false rather than throwing mid-run.** A throw from a logging
call inside a subsystem thread would take the thread down. The flag lets Phase 10's arbiter refuse
to actuate without an evidence trail.

**`OSRM::osrm` defined in `cmake/FindOSRM.cmake` instead of the guide's bare `osrm`.**
`libosrm.a` is static and records none of its dependencies, and OSRM's `libosrm.pc` is broken
(CMake target names in `Libs.private`). The target names Boost date_time/iostreams/thread, TBB,
zlib and rt explicitly.

**yaml-cpp added as a dependency.** Part 2.3 lists no YAML library, but the config files are
YAML. yaml-cpp is packaged on both Debian and Ubuntu and is CPU-only, so the unit suite stays
GPU-free.

**`start<T>(args...)` forwards constructor arguments** instead of Part 11.5's
`start<T, Sinks...>(Sinks&...)`. Phase 11 will construct the `WindowedSink` and pass it, e.g.
`start<ArRenderer>(sink)`.

**Subsystem contract: `void run(const std::atomic<bool>& stop)`.** Part 11.5 leaves it
unspecified. A throw or early return from `run()` shuts the whole system down.

**Shutdown joins every subsystem before the final-command hook runs.** That guarantees the zeroed
command is the last thing sent. The heartbeat gap during joins may trip the hub watchdog, which
fails safe.

**Crash signals write a pre-registered zeroed frame with one `write()`, then re-raise.** It is the
only async-signal-safe way to meet Part 5.4's "crash-triggered" shutdown requirement.

**`main` defaults: `host/config` and `logs/session.log`, run from the repo root.** Part 5.4's
`"config/"` assumed a working directory of `host/`, while `logs/` is at the repository root.
Both are overridable by argv.

**CI installs no OSRM until Phase 8.** `libosrm-dev` does not exist on Ubuntu.

## Phase 5 — ML inference

**Lane model: UFLDv2 CULane ResNet-18 at 320×1600.** Part 7.1's 800×288 is UFLD v1's size; v2
ships 320×800 (TuSimple) or 320×1600 (CULane). CULane's conditions are nearer Nairobi roads.

**Depth model: MiDaS v2.1 Small at 256×256.** "v3.1 Small at 384×384" matches no checkpoint.
v3.1's SwinV2-T weights do not load under timm ≥ 0.7, and timm 0.6 does not run on Python 3.13.
Depth is relative and secondary to LiDAR range.

**Detector: COCO-pretrained YOLOv8m. Part 7.1's classes are a mapping from COCO classes.** COCO
has no generic "obstacle" class.

**Exports verified against PyTorch through ONNX Runtime; UFLD loads with `strict=True` and
`weights_only=True`.** UFLD's own demo uses `strict=False`, which silently leaves mismatched
layers random.

**Export environment layered over `~/ml-env` rather than installing into it.** `~/ml-env` is
shared with unrelated CUDA work.

**`TrtEngine` targets TensorRT 10's name-based API; inference is split into `enqueue()` and
`sync()`.** Part 7.4's single `infer()` would serialise the three models. The engine rejects
dynamic shapes, non-FP32 I/O and multiple inputs at load.

**GPU tests live in `host/test/integration/` under ctest label `gpu`, outside CI.** Consistent
with Part 13.1 and Part 13.5.

**YOLOv8m at 1280×736 instead of 640×640.** At ~70° HFOV, a pedestrian stays ≥12 px out to
~148 m (enough for ~100 km/h plus tracking), and close objects stay within YOLOv8's trained scale
range (≤ ~960 px). Measured 6.6 ms median; camera-native 2560 measured 26.5 ms and would push close
objects outside that range. Revisit once Phase 4 measures the real FOV.

**MiDaS at 448×256 (16:9), ~1.75× its standard scale; UFLD stays 1600×320.** MiDaS's own small
transform caps the long side at 256 (256×128 for 16:9). 448×256 is a moderate increase for sharper
depth edges. The same entry previously said "native 256 short side", which was wrong (corrected
2026-09-24, after reading MiDaS's transform). UFLD's fully-connected head fixes its input size.

**`build_tensorrt_engines.sh` omits Part 7.3's `--shapes`.** TensorRT rejects it for fully static
models. The script verifies the built engine's input shape instead.

**UFLD export substitutes a no-op `utils.common` and reads its config with `runpy`.** Its real
`utils.common` pulls in DALI, tensorboard and other training-only packages. `strict=True` loading
proves every weight is replaced.

**COCO → Part 7.1 class map.** Motorcycles are Cyclists (two-wheelers with exposed riders). Large
animals are Obstacles. Birds and non-road classes are dropped. Classes are mapped before NMS.

**Post-processing never suppresses a pedestrian box because of overlap with another class.** No
"rider suppression": a missed pedestrian is the unsafe error.

**The lane model sees a CULane-shaped (2.78:1) band of the frame, positioned by config.** It is not
fed the whole 16:9 frame squashed.

**`MlInferenceEngine` loads its engines in the constructor, not a separate `init()`.** A bad model
set then fails at `SystemManager::start`, before any thread runs.

**Depth maps travel on their own bus; `DetectionFrame::depth_map_ref` is the frame sequence
number.** This follows Part 3.5's "handle, not inlined" without shared mutable storage.

**Lane band top defaults to 0.32 of frame height.** It was tuned on the Kraków footage and must be
re-tuned in Part 12 for the real camera mount.

**Offline footage: Kraków city drive (CC BY 3.0), 2560×1440.** It is used for pipeline and timing
validation only, not as an accuracy measure for Kenyan roads.

## Phase 5 extension — road-sign behaviours (design)

**A fourth model, a dedicated sign detector trained on MTSD, is added beyond the guide.** Ian
observed that COCO-trained YOLOv8m misses most signs. COCO knows only stop signs and traffic
lights. Part 7.2 allows fine-tuning for a failure mode found in testing.

**Sign behaviours are specified in `docs/architecture/sign-behaviours.md`.** Signs inform and never
actuate. Signs are shown only after multi-frame confirmation, in priority order, drawn under hazard
boxes, and degrade to screen-fixed banners when road geometry is missing. A detected sign confirms
or overrides OSM priors.

**Horizontal-flip augmentation is disabled for sign training.** Flipping swaps the meanings of
left/right-specific signs (no-left-turn and no-right-turn, keep-left and keep-right).

## Phase 5 extension — traffic-sign detector (overnight run)

**Only the fully annotated MTSD parts are downloaded.** Ian's signed MTSD links cover 11 zips. They
were identified by the MD5 lists shipped beside them and by reading each zip's central directory
from a ranged request: annotations (0.12 GB), val (4.57 GB, 5,320 images), train.0/1/2 (10.4 GB
each, ~11.8k images each), test (8.96 GB, 10,544 images; labels not public, skipped) and the
partially annotated set (annotations + 4 zips of ~11.9 GB, skipped). The three train zips are
assigned .0/.1/.2 by the alphabetical key range of their contents; the MD5 list confirms this
after download.

**Bandwidth forces training on train.0 only.** The measured aggregate download rate was ~2 MB/s
over five parallel streams, so the 35.8 GB needed would finish at ~03:30, leaving 2 h of training.
Following the plan's fallback, train.1 and train.2 were paused so that annotations + val + train.0
(15 GB) get all the bandwidth, and training starts as soon as those are unpacked. train.1/2 then
continue downloading in the background for later runs.

**Kenyan evaluation imagery comes from KartaView only (plus any openly licensed Commons photos).**
KartaView's v2 API rejects bounding-box sequence queries ("Restricted access"), so sequences are
listed through the v1 `list` endpoint over 0.05° tiles and each sequence's photos are fetched
through the v2 photo endpoint. Every 12th photo is kept, at most 10 per sequence, to spread the
set over many roads. The already-blurred ("proc") images are used.

**Plan change at ~23:55 (Ian): wait for ALL fully annotated training data, train until 08:00.**
This supersedes the "train on train.0 only" choice above. A run had been started at 23:53 on the
6,314 train images extracted by then; it was stopped within two minutes, before its first epoch
ended, so it produced no weights. Its directory is kept as
`host/models/training/signs_v1_partial_superseded/` (only `args.yaml`). train.1 and train.2 were
resumed. If the downloads are not complete by 03:00 EAT, training starts on everything complete
by then.

**Speed-limit variants whose unit is mph or unclear are dropped, not merged.** Crops of every
`maximum-speed-limit-*` variant were inspected. The round red-ringed designs (g1, and the LED
variants) are km/h and are merged into the speed classes. The rectangular white "SPEED LIMIT NN"
designs are US/Canadian and so usually mph: `30--g3`, `40--g3`, `40--g6` (a "41"-like sign) and
`50--g6` (plain white rectangle, unit unclear) have their boxes dropped (listed in
`host/scripts/mtsd_uncertain_unit_speed_variants.json`). Speed values with no target class (5, 15,
25, 35, 45, 55, 65 and the truck limit) go to other_regulatory. `100--g3` ("MAXIMUM 100 km/h")
is km/h and is kept.

**Narrow merges.** keep_left_or_right is keep-left, keep-right, pass-on-either-side and the
US-style warning "pass left or right". Mandatory turn-only / straight-only signs are NOT merged
into it (different meaning) and stay in other_regulatory. no_overtaking excludes the
heavy-goods-vehicle variant. end_of_restriction is end-of-maximum-speed-limit-*,
end-of-prohibition and end-of-speed-limit-zone; end-of-no-parking, end-of-priority-road and the
end-of-lane-type signs stay in other_regulatory. road_hump is warning--road-bump only (uneven-road
stays in other_warning).

**`information--pedestrians-crossing` (2,272 boxes, the blue square European design) is dropped**
as the brief requires for all information--* labels, so only the warning-triangle designs train
pedestrian_crossing. This is a real loss of a common sign: a blue pedestrian-crossing square will
be background to this model. Flagged for Ian.

**Panoramas are skipped** (260 of the images converted so far): equirectangular images with boxes
that wrap the edge, unlike the forward-facing production camera.

**Back to the original timeline (00:00).** The requested extension of training to 08:00 could not
be applied in this unattended run (the change was blocked by the session's permission checks, as
it moved the hard 07:00 deadline). The original brief therefore stands: training ends by 05:30
and the report is due by 06:45. Under that brief, a full download (~03:10 at the measured
2.2 MB/s) would leave well under 4 h of training, so its fallback applies: train.1/train.2 are
paused again, train.0 gets all the bandwidth, and training starts as soon as annotations + val +
train.0 are complete and converted. train.1/2 resume downloading after that, for later runs.
Ian should decide whether to retrain on the full set.

## Guide amendment: GPU overlay rendering (2026-09-25, at Ian's instruction)

**Part 10 now renders AR overlays on the GPU (OpenGL shaders in `WindowedSink`) instead of OpenCV
CPU drawing.** The holographic style (translucency, glow, gradients, pulsing) is per-pixel blending
over several full-screen 2K layers per frame, which would compete with the pipeline for the frame
budget on the CPU.

**The Part 10.1 `DisplaySink` interface changed:** `CompositedFrame` now carries the video frame
plus an `OverlayScene` (a draw list) instead of pre-composited pixels. It is the cleaner seam for
the optical phase: a `ProjectorSink` can draw only the overlays. **The FYP report's description
of this interface must be updated to match.**

**Road-locked overlay items are given in vehicle-frame metres and projected in the vertex shader
with the Part 12 calibration.** Barriers and the route band therefore land where perception places
them.

**Driver view shows hazard highlights styled by threat level, not a box around every detection.**
Per-class boxes with confidences remain in the debug viewer.

**Video upload via PBO; CUDA/GL interop not assumed under WSLg.** WSLg's OpenGL runs on Mesa's
D3D12 layer, not NVIDIA's GL driver. To be confirmed in the 10.4 benchmark.

## Hazard overlays replace boxes (2026-09-25, Ian's design)

**No rectangles on the driver display.** Hazards use the same road-placed language as signs:
- barriers at collision-risk objects;
- an amber → red route-line grade;
- a following-distance zone for tailgating;
- a red lane-line glow towards a swerving neighbour;
- ground rings under pedestrians and animals.

In addition, the object itself gets a subtle shimmering glow along its outline, coloured by a
risk level `r` (TTC + Part 9.2 flags, thresholds in config). Ordinary traffic gets nothing.

**Rule 4 changed from "draw nothing over a hazard" to "never hide a hazard".** The glow is a rim
plus ≤ ~25% tint. Road graphics are masked by object silhouettes so they appear behind objects.

**Object detection moves to YOLOv8m-seg (COCO).** The glow needs per-object masks, and boxes alone
would make it rectangular. It is the same class set and export path, plus a mask output. The work
is deferred until the sign-detector training finishes, so the GPU isn't shared with training.
A missing mask falls back to a soft ellipse.

**`sign-behaviours.md` became `docs/architecture/ar-overlay-design.md`** (signs + hazards + a
shared visual-language table). Earlier log entries naming the old file are left as written.

**`BUILD_GUIDE.md` Part 7.1 brought up to date:** YOLOv8m-seg, the sign detector row, and the
actual lane/depth models and sizes. The Part 7.3 commands are superseded by the scripts.
`detections.fbs` gains `mask_ref` in the guide. The schema file itself changes with the seg
implementation.

## Mask-based LiDAR fusion and startup extrinsic check (2026-09-25, Ian's proposal)

**Part 8.3 associates LiDAR points with objects through their YOLOv8m-seg masks,** not boxes or
cluster centroids. A box is mostly background, and box-selected points mix a pedestrian's range
with the wall behind. The rules are: motion-compensate, erode masks, take the nearest dominant
depth cluster, depth-test for parallax, report "no range" honestly, locate signs via
high-intensity returns inside their box, and treat unexplained LiDAR clusters in the corridor as
`UNKNOWN` obstacles. The camera may never veto the LiDAR.

**Part 12.2.1 adds `ExtrinsicMonitor`: startup and continuous verification with *bounded*
refinement** (~1°, ~3 cm) around the Part 12.2 checkerboard baseline. It is not a from-scratch
self-calibration, which can converge confidently to a wrong answer on a poor scene.
- It scores edge alignment plus mask agreement.
- It accepts a refinement only with enough varied evidence, held-out improvement, and a solution
  off the bounds.
- `DEGRADED` keeps the baseline, logs a fault, falls back to screen-fixed display, and makes the
  arbiter use LiDAR-only corridor ranges.
- Every start begins from the baseline, so errors don't accumulate.
- Intrinsics and camera-to-vehicle are not auto-adjusted.
- Braking never depends on an unverified refinement.

## Motion prediction (2026-09-25, Ian's proposal)

**Part 9.1's constant-velocity tracker is replaced by an IMM tracker with a `MotionPredictor`.**
- Models: CV for pedestrians, animals and unknown obstacles; CTRV via a UKF, with an explicit ω→0
  branch, for vehicles; a stopping model.
- Per-class process noise in `config/motion_prediction.yaml`.
- Tracking in a world-fixed frame via the EKF pose.
- The Appendix Q.7 loop (predict → Mahalanobis → Hungarian → gate → update → lifecycle) is kept.

**Prediction is object-level, measured from mask-fused LiDAR points**: L-shape fits and cluster
registration, never centroids. The non-repetitive Livox scan has no point-to-point
correspondence. Centroid shifts from changing visibility fake lateral velocity, which would
falsely trip the swerving rule.

**Risk for warnings and display uses closest point of approach and collision probability**
against a predicted ego path. TTC alone is blind to crossing traffic and cut-ins.

**Predictions are distributions, not lines.** Horizons above ~1.5 s are treated as intent, not
physics (uncertainty ≈ √(σv²t² + σa²t⁴/4)). Honesty is checked by NIS (chi-square) and by
ADE/FDE on recordings.

**Braking (Part 9.3 rule 1) uses only the current tracked range and closing speed,** never
forecasts, CPA, collision probability or IMM model probabilities. This avoids phantom braking and
keeps the brake rule auditable. Because the IMM changes the closing-speed estimate,
`test_motion_predictor.cpp` must bound its error and lag before Phase 10.

**Physics-based (verifiable) first.** Map-aware prediction next; a learned predictor only as a
display-only stretch goal.

**The renderer draws object-anchored overlays at their positions predicted for display time**
(latency compensation), plus predicted-path ribbons and `PREDICTED_ONLY` ghosts.

**YOLOv8m-seg masks are decoded on the CPU at prototype-grid resolution (¼), cropped to the box.**
Cost is small (≈ +1.8 ms whole-pipeline, measured), and it is exact to ultralytics for large
objects and slightly generous at box edges for tiny ones. Upsampling to full resolution is left to
the renderer.

**The engine type is recognised by its outputs** (two = segmentation). `mask_ref` was appended
last in `detections.fbs`, as FlatBuffers schema evolution requires.

## Phase 7 — Fusion and tracking

**EKF (ego): CTRV with IMU yaw rate as a measurement, not a control input.** IMU longitudinal
acceleration is unused in v1 (OBD observes speed). Joseph-form updates. `VehiclePose.heading_deg`
is the maths convention (CCW from east); compass conversion happens only at display.

**Tracker IMM: shared [px, py, ψ, v, ω] state, UKF prediction, asymmetric switching (rare entry
into STOP).** Symmetric rates biased cruise speed ~9% low (measured).

**Two-point velocity initialisation on a track's second sighting.** The speed+heading state
cannot learn direction from rest. A Cartesian CV model for pedestrians is the recorded
improvement for the remaining post-birth speed overshoot.

**Late measurements are replayed from snapshots within 500 ms.** Anything older than every
snapshot is dropped and counted, never applied out of order.

**Per-class motion noise lives in `config/motion_prediction.yaml`, as starting values.** They are
tuned against recordings via the NIS check (Part 9.1.3), never by eye.

**Collision probability is a Monte-Carlo estimate over sampled futures, drawn with exactly the
filter's own process noise, seeded by track id.** CPA (t*, d*) covers crossing traffic that
range/closing-speed TTC misses. Neither ever reaches the brake (Part 9.3).

**Prediction still uses the tracking noise, and that overstates lateral spread for
lane-following vehicles (measured: head-on 0.75, oncoming-in-other-lane 0.25).** Warning
thresholds are set on these measured values. The fixes are recorded, not applied by tuning:
prediction-specific noise calibrated on recorded drives (ADE/FDE, Part 9.1.4), then lane-aware
prediction once lanes are tracked.

**The filter reports speed as non-negative.** The models may internally hold (−v, ψ). The
reported state is flipped to (v, ψ+π), so the models are never flipped one by one and mixing
stays coherent.

**Mask-based fusion is pure geometry on plain values; bus adaptation waits for LidarProcessor
(Phase 6).** Every Part 8.3 rule is then testable on synthetic scenes.

**Fusion tests use ray-cast scenes, not hand-placed points.** The LiDAR is on the roof, offset
from the camera, and its angular scan stops at the first surface. Occlusion, parallax and angular
point density are therefore physically right, and camera-view masks are ray-cast too.

**Rules 2 (erosion) and 4 (depth test) are defence in depth behind rule 3.** In the test scenes,
rule 3 alone still recovered the range. What the two rules measurably do is raise the share of
mask-selected points that belong to the object:
- erosion: 49% → 89%;
- depth test: 35% → 85%.

That share is published as `points / maskPoints` for ExtrinsicMonitor (Part 12.2.1), since a
falling average is a symptom of extrinsic drift.

**Unexplained LiDAR obstacles ignore points more than 2.5 m above the road.** Gantries and
branches cannot hit the car. An object's points hidden by the depth test are still claimed by it
(inside its mask, within its depth band), so it never reappears as a duplicate UNKNOWN obstacle.

**MiDaS estimates fit rel = a/z + b** (MiDaS is affine-invariant in inverse depth, not only
scale-invariant) to at least two LiDAR-ranged objects in the frame. They are flagged ESTIMATED
and are never usable for braking.

## Navigation: three-layer road status, TomTom live layer (2026-09-26, Ian's requirement)

**Test area: Nairobi and everything within 100 km of its CBD.** Geofabrik Kenya, clipped with
`osmium extract` to lon 35.92–37.72, lat −2.19 to −0.38 (the box enclosing the 100 km circle).
The first box stopped at 1.10°S and missed Thika; Ian asked for a 100 km radius.

**Road status comes from three layers:**
- base OpenStreetMap, refreshed nightly (atomic swap, a failed build keeps the previous map);
- a live network layer (traffic and incidents) when connected;
- the car's own sensors.

The offline base stays because navigation must work without signal, and map-matching at 5–10 Hz
needs local geometry.

**Rule: the map is an expectation, the sensors are the truth.** Map and live data plan beyond
sensor range and never overrule what the sensors measure ahead. Nothing from a map reaches
braking.

**Live provider: TomTom (Intermediate Traffic API), behind a provider-neutral adapter.**
- TomTom's coverage table lists Kenya for flow and incidents.
- Its OpenLR references decode onto OSM, so traffic re-weights our own OSRM graph (MLD,
  `osrm-customize`, shared-memory hot swap).

Rejected alternatives:
- **HERE:** Kenya not in its traffic coverage table.
- **Waze for Cities:** public agencies and road operators only.
- **Google:** gives finished routes, not per-road speeds, and its terms on use with non-Google
  maps are unconfirmed.

Several providers are not used at the start: the conflict-resolution and cost burden come before
any evidence it is needed, and the sensors are already an independent second source.

**Gate on the live layer:**
- access and cost;
- quality on three of Ian's own Nairobi drives;
- terms for caching and display.

If any check fails, the live layer is deferred and layers 1 and 3 ship alone.

## Phase 8 — Navigation

**CI stays OSRM-free.** `libosrm-dev` does not exist on Ubuntu, and building OSRM 6 in CI costs
about 20 minutes per run. Instead:
- `MapMatcher`'s logic and the route geometry run in CI behind a `MatchBackend` interface, with a
  fake backend.
- `RoadStatus`'s rules are pure, so they run in CI too.
- OSRM routing, matching and re-weighting are `osrm`-labelled integration tests. They run against
  an OSM network the test writes with known geometry, and against the real Nairobi map.

**One local frame, on the WGS-84 ellipsoid.** SensorFusion and MapMatcher share
`common/Geo.h`'s `LocalFrame`. It uses the meridional radius M for north and N·cos(lat) for east,
at the origin. The first frame used the equatorial radius for both, which read north-south
distances 0.67% long at Nairobi (7 m per km) and disagreed with OBD speed. The EKF projection test
had encoded that error and was corrected against reference values (110.574 km per degree of
latitude at the equator).

**Route arc lengths use the same tangent-plane metric as projection.** Progress, offsets and step
positions share one scale. Step positions are projected onto our geometry, not taken from OSRM's
own distances.

**Road re-weighting: pristine copy plus reload, not shared memory.** See the guide amendment to
11.2.1. It was measured at 1.2 s from closure to reroute on the Nairobi map.

**Map matching sends a trace.** Committed points are at least 1 s apart, and the newest is
replaced by the current pose. Progress is clamped non-decreasing. Off route and wrong way each
need 3 consecutive matches. The throttle applies after failed matches too.

**A moving car departs within ±45° of its heading** (OSRM bearings), so a route never starts with
a U-turn across a dual carriageway.

**`LiveRoadStatus` (TomTom) is deferred until its three gates are checked** (access and cost,
Nairobi quality, terms). `RoadStatus` already holds provider-neutral live records, so the adapter
is the only missing piece.

**Sign detector: v2 stays deployed; v3 (ambiguous signs painted out) is rejected (2026-09-27).**
On v2's unmasked validation set, v3 was lower on mAP50 (0.702 vs 0.716), mAP50-95 (0.564 vs 0.581)
and recall. On Kenyan imagery it lost a correct 30 below the 0.5 floor and grew more confident in
a 30 → 50 misread (0.798 vs 0.574). Details: `docs/experiments/2026-09-26-sign-detector.md` §9.
Speed-digit errors are the next target: a digit-reading second stage, and Kenyan data.

## Phase 9 — Road-surface projector

**The projector outputs vehicle-frame 3D points as well as image points, with their pose
timestamp.** Fields are appended to `road_projected_route.fbs`. The renderer needs 3D to draw a
road-space band and to move the line with ego motion.

**Lanes give two corrections.** Heading is a pose error, so it rotates the whole line. Lateral is
the lane position: it holds along the current road and tapers out after the next turn.
`lateral_correction_max_m` is applied as a per-frame rate limit on a persistent correction. An
absolute cap would never reach a normal 1.75 m lane offset from the OSM centre line.

**Heights:**
- measured patch (onMeasuredSurface);
- fitted plane where the patch has a gap, NOT marked measured;
- flat ground beyond the LiDAR's range.

**One camera model (`common/Camera.h`) for fusion and projection,** with an iterative inverse
distortion for pixel → ground.

**For Phase 11, noted now (Part 10.3 latency compensation):** in video see-through, the driver
sees a camera frame that is already old. Overlays must be placed where things were **when the
displayed frame was captured**, not at the display time. Predicting to display time would make
overlays lead the video they sit on. What compensation must cover is the gap between the
detection/pose data and the capture time of the frame actually shown: the renderer may show a
newer frame than the one the detections came from. The 10.3 wording ("predicted for the display
time") should be read that way, and amended when the renderer is built.

**TomTom live-layer checks, first results (2026-09-27, Ian's free key).** The key is stored
outside the repo, in `~/.config/ar_windscreen/`, mode 600, and never printed.

1. **Access: partly met.**
   - The **Intermediate Traffic** feed (bulk, OpenLR) is **not self-service**. TomTom's docs:
     "a secure API that uses an API Key in combination with a client certificate". An evaluation
     variant has "limited geographic coverage".
   - The standard **Traffic API works** on the free key: flow segment data v4, incident details
     v5.
   - Design consequence: without the bulk feed, the live layer polls flow along the ROUTE, not
     the whole network. It uses incidents by bounding box.
2. **Quality: first look only** (Sunday 09:35; the real test is a weekday rush hour, plus Ian's
   drives).
   - **Flow:** major roads covered (Thika Rd, Uhuru Hwy, Mombasa Rd, Waiyaki Way; confidence
     0.98–1.0). At zoom 18, minor roads partly covered: Ngong Rd and a Kileleshwa estate road
     yes, Eastleigh 1st Avenue no (snapped 1.5 km away). Segments are long (3–20 km), so speeds
     are coarse averages. Most roads read current = free-flow speed at that hour, so the data
     could not yet be told apart from a default.
   - **Incidents:** 78 in central Nairobi (19 jams, 54 road closed, 5 road works).
     - Of the 54 closures, 51 are only "probable", 15 were last reported over 30 days ago, and
       5 over a year ago (oldest 2024-08-04, Ralph Bunche Rd ↔ Woodlands Rd), none with an end
       time.
     - **Rule added for when the layer is built:** a live closure makes a road impassable only if
       it is "certain" or was reported within 24 h. Older "probable" closures become a routing
       penalty, not a closure. Sensor closures are unaffected and still win.
3. **Terms: not yet checked.** TomTom's terms page loads its text with JavaScript, which the
   available tools cannot read. Caching and display terms remain unconfirmed.

**TomTom gate 3 (terms): NOT met for our use → the live layer (11.2.1 layer 2) stays deferred
(2026-09-27).**
Source: TomTom Portal Terms & Conditions (docs.tomtom.com/legal/terms-and-conditions), read from
Ian's 23-page PDF export of 2026-09-27. A few lines are lost at the PDF's page breaks; none of the
clauses below is affected. This is a reading of the terms, not legal advice.

- **2.1:** the licence to use the Maps APIs excludes "any **Automotive Usage** or **Navigation
  Functionality** except as specifically permitted to you by TomTom under a **separate written
  agreement**".
  - "Automotive Usage" means a solution "integrated with a vehicle".
  - "Navigation Functionality" means "the real-time provision of directions ... that guide a user
    through each turn in a route ... and which may include the ability to change the route in
    real time".
  
  The AR windscreen is both.
- **2.2:** the free licence is for "**Evaluation Use only**", defined as "internal evaluation and
  testing".
- **11.4:** results may be cached only when cache-control headers are present, and no longer than
  their max-age. (Our 15-minute staleness window must also respect the header.)
- **11.6.1:** no "secondary or derived database populated wholly or partially" with the delivered
  content. Re-weighting our own OSRM graph with TomTom speeds is at least arguably that.
- **11.6.9:** no use "in connection with ... high-risk systems ... critical to the health and
  safety ... of people". A driver-assistance system with a braking path is at least arguably one,
  even though map data never reaches the brake here.
- **20.2.3:** no combining TomTom content with open data or software in a way that could make it
  subject to an open-source or copyleft licence. Our base map is OpenStreetMap (ODbL,
  share-alike).
- **18:** API keys are confidential information. The key is already kept outside the repo and
  never printed.

**Consequence:**
- The checks already done (a few hundred requests, on the desk) fit "internal evaluation and
  testing".
- Routing a car with TomTom data, even for our own test drives, needs TomTom's written permission.
  Merging it into the OSM graph conflicts with 11.6.1 and 20.2.3 regardless.
- Per 11.2.1, layer 2 is deferred. Layers 1 (refreshed OSM) and 3 (own sensors) are complete on
  their own.
- If a live layer is wanted later, the route is a written request to TomTom (for an academic
  research prototype, stating the in-vehicle use and the OSM combination). Only an explicit
  permission changes this decision.

**The terms PDF is not committed.** It is TomTom's copyrighted document, and a 6 MB binary; the
reference above is the URL.

## Phase 10 — Decision / Arbiter

**Rule 1's conditions are explicit and each is tested:**
- ARMED means: a fresh hub report (≤ 100 ms), kill switch off, an AckStatus with no fault, and a
  healthy EventLog. Unknown is not armed.
- Only a CONFIRMED track with a LiDAR-measured range (≤ 200 ms), in the ego path, closing, with
  finite values, may brake.
- The gap is measured from the front bumper.

**Triple clamp on the brake intensity:** `brake_request_intensity`, then
`brake_actuator_max_intensity`, then the hub's compiled 90. SystemManager refuses a configured
ceiling above 90. The Phase 3 loader accepted up to 255, and that test was changed deliberately.

**The warning and the brake share one ego-frame computation (`toEgoFrame`),** so they cannot
disagree about what is in the lane.

**Tailgating = the ego car's time gap to its lead**, matching the overlay design's
following-distance zone.

**Swerving threshold 0.25 m, from a discrimination table.** Slow weaves (period ~4 s) are not
separable from quick lane changes in a 3 s history, and are not flagged (documented limit).

**Tracker two-point initiation fixed (Phase 7 defect, found by Phase 10):**
1. **The second sighting of a new track is gated by the class's maximum plausible speed in any
   direction** (`max_speed_mps` in motion_prediction.yaml), not by the velocity-less filter.
   Before, any object moving more than ~0.5 m per frame, which includes every car on a real road
   in the world frame, restarted its track every frame and was never confirmed.
2. **Two-point initiation re-seeds position AND velocity** from the two measurements (with the
   consistent cross-covariance) instead of Kalman-updating the position from the birth prior.
   The prior's thin covariance dragged the position back up to 1.5 m for fast objects travelling
   off-axis.

## Phase 11 — AR renderer and display

**Display path: WSLg (Part 10.4).**
- Measured render and swap rate at 2560×1440 with the full overlay scene: 54–82 fps against a
  24 fps target.
- WSLg ignores vsync, so the on-screen rate is checked by eye, and again with the real camera.
- The native-Windows fallback is not needed now.

**GPU selection is explicit.** WindowedSink sets `GALLIUM_DRIVER=d3d12` and
`MESA_D3D12_DEFAULT_ADAPTER_NAME=NVIDIA` before the GL context exists, then verifies
`GL_RENDERER`. The defaults were llvmpipe (software), and, forced to D3D12, the integrated Intel
GPU.

**The sink draws into an offscreen framebuffer at video resolution, then scales it into the
window.** The same frame can be read back, so rendering is checked by eye (captures) and by GPU
tests.

**Road items interpolate perspective-correctly.** The vertex shader projects with distortion
itself, then outputs w = depth. With w = 1, band edges were a sawtooth (seen in the first
capture).

**Rule 4 is depth-aware** (occluders carry depth). **The route band is translucent** (core 60%),
so lane markings show through.

**`DisplaySink::init` takes the camera model.** The shader's projection is tested against
`CameraModel::project` to 2 px, through distortion. The test samples separate dashes near the
image edge, because a continuous-band version could not see distortion errors.

**`SignTracker`** implements rules 2, 3 and 7 and speed-value agreement. **Map-geometry
behaviours** (no-turn barriers, roundabout exits) are banners until the map supplies junction
geometry.

**Renderer tuning values are code defaults** until Part 13 tunes them. Then they move to config.

## Phase 12 preparation — hub firmware and bench tooling (no hardware yet)

**Ian has no hub hardware yet; the brake actuator design (BOM note B) is pending supervisor
approval.** Phase 12's gate is physical. The code is prepared so bring-up can start the day parts
arrive; nothing here counts toward the gate.

**Every hub safety rule is in one hardware-free class (SafetyCore), tested natively.** Tasks are
thin wrappers. WatchdogTask releases directly, without the core mutex.

**Re-arm only on a heartbeat received while all other conditions hold; disarm forgets the
command.** Zeroed commands always release. Commands that request something must have a strictly
newer `hostTimestampMs`.

**Kill-switch sense line: NC to ground, pull-up, HIGH = engaged,** so a broken wire reads engaged.

**Parser resynchronisation.** Re-scanning after a failure, plus early delivery of a frame embedded
behind a corrupted length. Without it, a bit error in a length field could hold back ~300 ms of
heartbeats and trip the 200 ms link timeout (safe, but spurious).

**`BENCH_TELEMETRY` (0x05) appended to both protocol copies; sent by the bench build only.**
Item 5 (USB unplug) is measured BY THE HUB, because nothing is observable from the laptop while
the cable is out. An oscilloscope on the BTS7960 enable line is the recommended independent
cross-check.

**The firmware ceiling is now a literal (90) in `BrakeActuatorDriver.h`,** so the host's
`RealConfigMatchesTheFirmwareCeiling` test switched from "documented value" to an exact
cross-check.

**Bench tool: `tools/bench_rig/log_actuator_bench.py`** (`selftest`, `checklist --attempt N`,
`status`). It records all five items per attempt under `bench_runs/`. Those records are the
actuation evidence for the report and are meant to be committed. Items 1, 3 and 4 need the
operator's confirmation; the tool cannot pass the push-back check by itself.

## Two-box hub: windscreen pod, power box, roof LiDAR (2026-09-30, Ian's design)

**Ian's design, agreed after discussion (2026-09-29/30): a custom-PCB hub split into a windscreen
pod behind the mirror (MCU, camera, IMU, GNSS) and an under-dash power box, with the LiDAR on the
roof.** BUILD_GUIDE Part 4.8 is the full design; this is the index of the choices inside it.

**The LiDAR is not in the pod.** The Livox manual forbids anything, glass included, in its field
of view; a windscreen reflects and refracts 905 nm at its shallow angle (and athermic coatings block
much of it); the cabin would hide most of the 360°; the Mid-360 is rated to 55 °C; 265 g is too
much for a glass-bonded mount. It goes on the roof **tilted 15° forward**: level, its −7° lower edge
reaches the road only 12.6 m ahead, tilted about 4–5 m (bonnet-limited), where the 10 km/h brake
decision is made.

**The MCU is in the pod (Option A), not in the power box with a CAN link to a pod sensor node
(Option B).** One MCU and one firmware; Ian agreed. The cost is a 25-way cable (DB-25, sold
locally). It is made safe by one rule: **every line into the power board has a 10 kΩ pull-down**, so
reset, power loss or an unplugged cable leaves the brake released, the magnet off and the relays
off, in hardware. Relays therefore became active-high (MOSFET drivers with gate pull-downs); the old
relay module was active-low and would not have been off by default.

**STM32F405RGT6 instead of the F411 placeholder:** two bxCAN controllers, LQFP64 (hand-solderable),
sold locally as a development board (BOM 1.1). **An 8 MHz crystal is mandatory:** USB needs 48 MHz
within ±0.25 %, the internal oscillator is ~1 %, and the F405 has no crystal-less USB recovery. The
firmware sets its own clock (`src/SystemClock.cpp`), falling back to the internal oscillator rather
than halting if the crystal fails (hub alive and released; the unreliable link never arms it).

**OBD-II straight from the car's CAN bus replaces the ELM327 + HC-05**, which stay as a build-time
fallback (`env:hub_elm327`) for a pre-CAN car. Imports now entering Kenya must be first registered in
2019 or later (KEBS, from January 2026), and CAN has been the OBD norm since about 2008. The code
follows one rule: never disturb the car's bus. Listen silently at each candidate rate before ever
transmitting; send each request once (no retransmission); only service 01; ~20 requests/s at most.
All of it is in `include/hub/ObdCan.h`, tested natively.

**The CAN transceiver sits in the power box, beside the OBD lead, not in the pod.** Running CAN_H/L
2.5 m up to the pod would hang a long unterminated stub on the car's bus, which reflects at
500 kbit/s. 3.3 V logic (TX, RX, standby) goes up the cable instead; the transceiver's standby and
TX lines are pulled to "silent" on the power board.

**The pod has two power sources, diode-OR'd:** +5 V from the power box and USB VBUS. With the USB
cable out, the pod stays up and its firmware watchdog is what releases (bench item 5 stays a test of
the watchdog, measured by the hub); with the inter-box cable out, the pod stays up on USB and reports
the power box's absence.

**Power-box absence is fault 5**, above the kill switch in priority (an unplugged cable also opens
the kill-sense line: report the cause). **The current reading is ignored while the box is absent**:
the floating line reads ~0 V, which the ACS712 conversion turns into ~25 A, and trusted it would latch
a false overcurrent needing a power cycle. The presence line is pulled low by a MOSFET fed from the
box's own 5 V, so "present" means connected **and** powered; it also gives `ignitionOn`, which was a
hard-coded 1.

**A sixth bench item:** pull the inter-box cable with the actuator applied. Phase 12's gate is now
six items, three consecutive passes, and a new **Phase 12B** (PCBs and enclosures) must pass it again
on the PCB hardware.

**The IMU is tilted with the camera, so its readings are rotated into the vehicle frame
(`fusion/ImuMount`) and calibrated** in two steps from data the hub already sends: roll and pitch
from gravity at rest, yaw from straight-line acceleration and braking (sign from OBD speed). At a
12° pitch, raw readings would make the yaw rate 2 % low and add 21 % of the body's roll rate in
corners. `tiltErrorDeg()` detects a knocked pod at every stop.

**Version 1 PCBs keep the risky parts as modules:** BNO085 and NEO-M8N breakouts on standoffs, the
BTS7960 and ACS712 modules on the power board. What goes onto the boards is what was never the risk
(MCU, power, buffering, connectors).

**Found while doing this: the existing firmware had no USB stack.** `-DUSB_CDC_ON_BOOT=1` is an
ESP32 flag; STM32duino needs `-D PIO_FRAMEWORK_ARDUINO_ENABLE_CDC`, without which `Serial` was a
hardware UART and the host link could never have worked. It would have surfaced on the first day of
Phase 2 bring-up. Fixed; confirmed by the USB device symbols now in the linked firmware.

## Phase 12B, part 1 — hub PCB schematics (2026-10-06)

**The schematics are generated from Python descriptions and checked against the firmware and the
guide.** `hardware/gen/` describes each part (KiCad symbol, footprint, value, pin-number-to-net map);
`check.sh` writes KiCad 10 schematics, requires 0 ERC violations, and `check_nets.py` verifies the
netlists against `Config.h` (by STM32 pin name), the BUILD_GUIDE 4.8.3 cable table (parsed from the
guide, both boards), the fail-safe pull rules and footprint existence. Reason: the pins already
live in the firmware and the pinout in the guide; one description checked against both turns a
disagreement into a failed check instead of a respin. The checker was mutation-tested (wrong MCU
pin, missing pull-down, swapped cable pins): all caught.

**Reverse polarity: B560C Schottky instead of a P-MOSFET.** The SOT-23 P-MOSFETs in the library are
−30 V parts, too close to the bidirectional SMCJ24CA's ~39 V clamp. ~1 W at 2 A is acceptable.
*(The TVS became an SMCJ33CA on 2026-10-16, clamping at up to ~53 V: the diode, rated 60 V, still fits.)*

**5 V: TI's TPS54360 5 V reference design, unchanged** (SLVSBB4G Fig. 34). Proven values over a
custom design for a first board.

**Relays and magnet driven directly by logic-level MOSFETs from the cable lines** (with the 10 k
pull-downs); the 74HCT244 only buffers the BTS7960's three 5 V inputs. Fewer parts, same fail-safe
default.

**Pod outputs have 1 k series resistors (330 ohm on CAN_TX)**, limiting back-power into an unpowered
power box to ~3 mA per line. Inputs from the cable: 10 k pull-up to the safe reading, 1 k + 10 nF
filter (none on CAN_RX/HX711_DOUT, which are data).

**Four more MCU pins are wired and defined in Config.h but not used yet:** BNO085 INT (PC4) and RST
(PC5), APDS-9960 INT (PC7), GNSS PPS (PB4). Free to route now, costly to add later.

**The IMU and GNSS headers are placeholders for breakouts:** their pin order must be matched to the
purchased boards before layout (hardware/README.md).

## Hub reports into the EKF (2026-10-06)

**A pure feeder (`fusion/HubReportFeeder`) between the decoded SensorReport and SensorFusion**, so
every rule is tested without hardware; VehicleInterface calls it once it exists (Phase 3, with the
hub).

**Each field at its own sensor's rate, not the report's 50 Hz.** GNSS only on a new fix (valid and
moved), OBD speed at most every 100 ms, compass at most once a second (the in-car magnetometer is
biased; GNSS motion corrects heading), gyro every report. Repeats would make the filter falsely
confident.

**Hub time, not host arrival time**, for dt; gaps over 1 s and hub resets are not predicted across.

**Protocol semantics tightened (no layout change):** the firmware now sends `gpsFixValid = 1` only
while the fix is under 1.5 s old, and `obdSpeedKph = NaN` when OBD has no valid reading. Before,
a lost GNSS kept reporting its last fix as valid indefinitely, and a lost OBD reported 0 km/h, which
the EKF would have taken as "stopped". Both protocol copies updated identically (field comments).

**The IMU's longitudinal acceleration became the EKF's control input** (`predict(dt, a)`), with
`accelInputStd = 1.5 m/s^2` chosen by sweeping 0.5/1.0/1.5/2.0 in a simulated drive whose
accelerometer carries a 3 % grade's bias: 0.5 trusted the biased input over OBD (0.60 m/s steady
error); 1.5 gave 0.26 m/s steady and 0.17 m/s lag after 3 s of -3 m/s^2 braking, against 1.13 m/s
with no input. The plain `predict(dt)` is unchanged for other callers.

**The IMU mount comes from `vehicle_params.yaml: imu_mount_rpy_deg`**, validated at startup (three
angles, each within +-180 deg).

## VehicleInterface, built against a simulated hub (2026-10-06)

**Built and tested before the hub exists, against `tools/hub_sim`, which compiles the firmware's
own SafetyCore and FrameParser** (only HubSim.cpp sees the firmware headers: the two protocol
copies cannot share a translation unit). The host is therefore tested against the hub logic the
STM32 will run, not against a mock of it.

**The host has its own frame codec (`FrameDecoder`), written independently and tested against the
firmware's** in both directions, byte for byte, with every single-bit corruption rejected.

**A zeroed command after 150 ms without a new request, and a 300 ms hold on brake commands.**
Part 3.3 requires "no request" to be said explicitly; this also means a stalled arbiter cannot leave
a brake standing (measured: released 134 ms after the last request, with the link healthy).

**Heartbeats every 50 ms**, twice the 10 Hz minimum, so one late heartbeat never brushes the 200 ms
watchdog.

**Acks are logged when they show the brake applied or the hub's state changes**, not every one: a
persisting fault would otherwise fsync a line seven times a second.

**The port opens in the constructor when started from main**, so a missing hub fails startup naming
the device, instead of failing on the subsystem thread after "running" was printed. The EKF objects
are declared before SystemManager so they outlive its threads.

**ModemManager** (desktop Linux) probes new ACM devices with AT commands; that would trip the hub's
frame-error fault at every connection. Documented in Appendix D (found via the simulator's
pseudo-terminal echo, which did the same).

## Board outlines and the first enclosures (2026-10-06)

**One file sets both boards' outlines, holes and edge-connector positions** (`hardware/gen/outlines.py`),
and writes both the starter KiCad PCBs and `hardware/enclosures/common/boards.scad`. The enclosure
standoffs and cut-outs therefore move with the board; the two can only disagree if someone edits a
generated file. Pod board 80 × 55 mm (was "about 70 × 50": the DB-25 alone is 53 mm wide and the
corners need M3 holes); power board 110 × 80 mm (room for the 2 oz high-current tracks and ten
terminal blocks along one edge).

**LiDAR mount: two aluminium plates and a printed wedge, rather than a bent or machined bracket.**
Flat 3 mm plates can be cut by any fabricator from the DXF, or drilled by hand from the 1:1
templates; the 15° lives in the printed part, so a different tilt (set at installation from the
bonnet, Part 4.8.6) is a re-print, not a new bracket. The top plate is the Livox heatsink. Pot
magnets with rubber coating hold without touching the paint; the tether is not optional.

**Power box: a bought ABS junction box with a printed chassis plate, not a printed box.** Six
automotive relays (28 mm sockets) beside the 110 × 80 board need about 240 × 140 mm of floor; a
printed box that size exceeds a 220 × 220 bed, and an IP65 junction box is stronger and sealed. The
chassis is screwed up through the floor into inserts, so nothing depends on the bought box's
internal bosses. The board sits against the front wall so the DB-25 passes straight through it;
all car-side leads leave through glands in the opposite wall.

**Drilling templates are generated from the models' own hole lists** (`make_templates.py`), and
checked for true scale by rasterising at 10 px/mm, so the paper and the model cannot disagree.

## The power board schematic drawn as wired sheets (2026-10-07)

**Ian found the label-only schematics hard to follow**, and he was right: connecting every pin by
net label is exact, but parts that touch in the circuit can sit far apart, and the reader has to
match names by eye. The power board is now **eight function sheets under a block-diagram root**,
with real wires.

**Still generated, not hand-drawn.** The circuit stays in `power_board.py`; a separate drawing file
says only where each part goes and which way round; a small maze router draws the wires. So the
existing checks (Config.h, the 4.8.3 cable table, the fail-safe pull-downs, footprints) keep
running, and a later change to the circuit redraws itself. Hand-tidying the old sheet in KiCad
was the alternative: it would have ended regeneration, and every later change would be by hand.

**Proof that the drawing did not change the circuit:** `check.sh` builds the label-only version as
well and requires the two exported netlists to be identical (82 parts with the same values and
footprints, 59 nets joining the same pins under the same names). The router itself never lets two
nets touch: a crossing is allowed only at right angles over a plain run, where KiCad does not
connect.

**Pull-downs moved next to the circuits they protect** (actuator, relay and CAN sheets), so the
fail-safe rule is visible at the point where it acts, rather than in a block of its own.

**Pod board, the same (2026-10-07).** Six function sheets around an MCU sheet. The MCU is drawn with
every pin running straight out to a hierarchical port, the usual way to draw a large chip: its
support parts (reset, boot, crystal, VCAP capacitors) sit beside the pins they serve, and nothing
else crowds it. Where many lines fan into a connector (the DB-25 on the cable sheet), each line's
vertical run is assigned a column so that the fan-in has no crossings. Power symbols now show the
rail's name (+3V3, VBUS, +5V, +12V), which the first drawing of the power board lacked.

## Camera pipeline: undistorted frames carry their own camera model (2026-10-07)

**The frames on frameBus are undistorted, and the camera model that describes them is published
with them: `CameraPipeline::frameModel()` (zero distortion, the new camera matrix).** Part 6 says to
undistort; `CameraModel::project()`, used by SceneReconstruction and RoadSurfaceProjector, applies
the lens distortion itself. Both are right only if the model handed to the projectors describes the
frames they see. Given the raw calibration, they would distort an already-undistorted image again:
34.7 px off near the edges for the test lens (test_camera_pipeline). Undistorting once, at the
source, also gives the lane model straight lines. `getOptimalNewCameraMatrix` with alpha = 0 crops
to valid pixels, so no black border reaches the detector.

**Remap through precomputed maps, not `cv::undistort()` per frame:** identical output, the maps built
once; 3.9 ms per 2K frame on the CPU, so CUDA is not needed (Part 6.2's condition).

**A camera that stops is a fault, not a degraded mode.** Bounded reads (GStreamer read timeout), and
`stall_timeout_s` without a frame shuts the system down, leaving the hub's watchdog to release.

**Phase 4 exit check by measurement:** `camera_check` passes a size only at >= 95 % of the requested
rate with **no lost frame**, because the average hides losses (29.8 fps with a lost frame, on a test
source, is a FAIL). The 2K-or-1080p decision waits for the real camera through usbipd.

## The whole system on a recorded drive, before any hardware (2026-10-07)

**Replay public, synchronised camera + LiDAR + GPS/IMU data (KITTI raw) through the complete host,
with the simulated hub running the firmware's SafetyCore.** Synthesising LiDAR from the video would
have been circular. KITTI is real data with real calibration (checked by projecting the LiDAR into
the image), CC BY-NC-SA 3.0 (non-commercial; credit the authors). It is a Velodyne, not the
Livox Mid-360: good for exercising the pipeline, not for judging the Mid-360's coverage.

**A deterministic frame-by-frame replay (`replay_inspect`) alongside the real-time one.** The same
classes in lock-step make every result reproducible, so a false brake can be traced frame by frame;
the real-time run proves the threads, buses, timing and shutdown.

**The injected test obstacle is fixed in the world on the road the car drove, and seen by both
sensors.** A LiDAR-only box let the camera masks of objects behind it claim its points; a box fixed
in the car's frame swung round with the car in a bend. Each gave misleading results.

**Five changes to perception and the decision, each from a failure on the replay** (progress log):
the ground fitted per scan instead of a flat road; objects measured at their near face; duplicate
measurements of one surface merged; rule 1 needing the straight path as well as the curved one;
rule 1 needing a 200 ms unbroken LiDAR-measured run. The last two change Part 9.3's safety rule
and are for Ian (and the supervisor) to review. A one-missed-frame tolerance on the run was tried
and rejected on the evidence (it let a false brake through).

**Optimised builds by default; the GL library is never unloaded while the process runs** (Mesa's
D3D12 driver threads crashed the process on every shutdown with the window open).

**Two more, from the replay with real-time timing variations (`replay_inspect --jitter SEED`: a
frame sometimes gets the scan before the newest, and the hub clock is shifted up to +-60 ms):**
- *Rule 1 starts braking only once its condition has held on the same target, and the LiDAR has
  measured that target again at least 100 ms after it first qualified* (`brake_confirm_ms`); once
  braking, it continues while any target qualifies. Every false brake
  found under jitter (6 of 40 clean runs) lasted one cycle: a velocity spike from one scan (closing
  at up to 37 m/s while the car did 6 m/s), or a parked car flickering across the path's edge. A
  time, not a count of cycles, so that it spans two LiDAR scans at any camera rate; and a later
  measurement, not a prediction, because predictions now continue through cycles without a scan
  (below) and one carried a kerbside cyclist's track into the path. Cost: 100 ms.
  For Ian to review with the other rule-1 changes.
- *A frame with no usable LiDAR scan is not a miss.* The tracker had treated it as "looked and saw
  nothing": every track missed, every measured run restarted, and with one frame in three without
  a scan a stopped car in the lane was never braked for. Such a batch is now `observed = false`:
  tracks are predicted only. Rule 1's own condition (a LiDAR range within 200 ms) is unchanged, so a
  LiDAR outage still cannot lead to a brake.

## The live Livox Mid-360 capture, built before the LiDAR is bought (2026-10-07)

**Decode the SDK's packets ourselves, from bytes, and hold the offsets to the SDK with
`static_assert`.** The decoding and scan assembly (`lidar/LivoxPackets`) need no SDK, so they are
unit-tested in CI with synthetic packets; `lidar/LivoxCapture` is only the SDK glue, built when the
SDK is installed. A changed SDK layout fails to compile rather than silently mis-decoding.

**Map the LiDAR's clock onto the host's with the smallest observed offset over 2 s**, not PTP: no
PTP master or GNSS pulse is wired to the Mid-360 in this build. The smallest (arrival - LiDAR time)
is the packet that waited least; one late packet never moves it.

**No voxel downsampling or PCL clustering in the capture** (departing from Part 8.1's sketch): fusion
already clusters in linear time; downsampling would only cost near-field detail. To be timed on real
Mid-360 clouds in Part 13.3.

**Appendix C corrected:** the Mid-360's address is 192.168.1.1xx (from its serial number), not .100.

## Calibration tools, and the system's own recorder (2026-10-08)

**The system records itself** (`--record DIR`, `system/Recorder.h`) in the replay format. One
format for KITTI, for the project's own drives and for calibration captures means every tool and
the whole host can be run on any of them. The recorder taps the sensors and queues; it never
blocks them, and it counts what it drops.

**LiDAR–camera calibration from board planes, not hand-picked corners** (departing from Part
12.2): the Mid-360's non-repeating pattern puts no point on a corner, but over a held second it
covers the board. Each held pose gives one plane from the camera; the solve puts the LiDAR's board
points on those planes. It refuses pose sets that leave a direction unconstrained.

**ExtrinsicMonitor: edge alignment, decided on held-out frames.** The score and its safeguards
each came from a failure on KITTI's real frames (BUILD_GUIDE 12.2.1, amended): one-sided depth
edges, texture, a drifting weak axis, a "peak" test that passed a 2.5° error, and a turn read as a
rotation. Rotation only by default. A refinement moves the camera's projection only; braking's LiDAR
geometry stays calibrated. Integration tests, not unit tests (OpenCV), departing from Part 13.1.

**Calibration tests run in CI on synthetic scenes with known answers** (Python): the camera
intrinsics on rendered checkerboards through a known lens, the LiDAR–camera tool on a synthetic
recording. Measured against the truth, the thresholds were set from what such methods achieve
(stated in the tests), not tuned until they passed.

## PCB placement generated and checked (2026-10-08); routing by hand, later reversed (see 2026-10-09)

**Placement is generated from the board descriptions; routing is Ian's.** `hardware/gen/layout.sh`
places every part (each position with its reason, `placement.py`), sets the net classes and rules,
and proves the result with KiCad's own DRC and schematic-parity check. Routing is left to be done
by hand with the guide: it is where the engineering judgement is learnt and examined, and an
autorouter's output would be neither.

**The power board's terminal blocks are on three edges** (car wiring, actuator, input/LiDAR), not
one: they need ~138 mm and the bottom edge has 92. Only the DB-25 passes through a wall.

**Deterministic schematic ids** (seeded per board): the PCB links each footprint to its symbol by
id, so ids that changed on every generation would have broken the links.

**Track widths from IPC-2221** (outer layer, 10 °C rise), checked in code: the actuator rail 4.0 mm
on 2 oz (3.6 needed for its 10 A fuse) or a zone; supplies 1.0 mm (0.68 needed for 3 A).

## Boards compacted to the routability limit (2026-10-08)

**Pod 70 × 53 mm, power 90 × 66 mm**, each squeeze kept only if an autorouted throwaway copy still
routed every signal with no DRC error (`hardware/gen/routecheck.sh`, Freerouting 2.5). The autorouter
is a test of the placement; the routing itself stays by hand (decision above). The power box keeps
its bought size (the relay row sets it); its printed plate shrinks to 210 × 112 mm.

## Both boards routed by script, labelled, terminals turned outward (2026-10-09)

**Routing is generated, not drawn by hand** (reversing 2026-10-08, at Ian's request: "do the PCB
routing too as per specification and design"). `hardware/gen/route.sh` routes each placed board
with Freerouting inside rules that encode LAYOUT_GUIDE's specification, then proves it with
KiCad's DRC and schematic-parity check: it keeps a board only with 0 errors, 0 unconnected and
exact parity. The guide becomes the explanation and the review checklist of that routing.

**Planes are not routed; every pad gets its own via.** GND (both boards) and +3V3 (pod) are
net classes the router is told to ignore. Before routing, each SMD pad on them gets a via beside
it (the pod MCU's: straight out from the pin's tip), and the pod MCU's +3V3 pins a short track
to their decoupling capacitor. Routing them as tracks had made Freerouting neck them down below
the fab minimum at small pins and box pins into islands.

**The converter is fixed by placement, not by laying its tracks first.** Measured on the first
routing, the switch node was 78 mm with four vias and the feedback line 40 mm with four vias: U1's
switch pin faced away from D13. U1 is turned 270° and the converter rearranged around it (TI's
layout): now 16 mm and 7 mm, top layer, no vias. Laying those nets before routing (locked) was
tried and dropped: Freerouting then left +5V in pieces in all 13 attempts.

**5V_POD has its own 0.5 A class** (it is behind the pod's 500 mA polyfuse), not the 3 A supply
class: the width check had demanded 0.68 mm of a net that cannot carry more than 0.5 A.

**Fabrication outputs are generated and gated** (`hardware/gen/finish.sh`): the bottom-silkscreen
identification, then gerbers, drill, BOM and positions from the board's bottom-left corner, only
when the DRC passes. Teardrops stay a manual GUI step (KiCad's scripting cannot make them; the fab
does not need them).

**What Freerouting gets wrong is mended, then checked, in code:** a neck-down below the minimum
width is widened (or, on GND only, removed when widening would crowd another net); a group of
plane copper left unjoined (a pin or a piece of pour boxed in by tracks) gets a short track to
the main group; a scrap of pour touching nothing is removed. Freerouting varies run to run, so a
board that fails is routed again from a fresh placement (up to five attempts).

**Facts found on the way** (Specctra export): KiCad exports rule areas as keepouts that block vias
too, and Freerouting treats even a wire_keepout as closed to vias: the pod's In1 is declared a
power layer instead. The session import replaces all wiring, so what was placed before routing is
put back. `routecheck.sh` let the router use In1 for signals, so its "routable" verdicts for the
compaction were optimistic; `route.sh` is the real test.

**Screw terminals turned to open outward.** The 3D view showed every power-board terminal's wire
entry facing into the board (wires would have crossed the parts). They are rotated 180° with
their bodies in the same place, the bottom row 0.55 mm further out (flush with the edge, clear of
the holes); the relay drivers sit one terminal pitch left of their J4 pins (J4 pin 1 is the
coils' common +12 V) so D14 keeps its place.

**RESET and BOOT are side-push switches on the pod's left edge** (Panasonic EVQ-P7C, plungers
flush with the edge, below the SWD header), pressed through pin-holes in the enclosure wall: all
programming controls on one edge, recessed against accidental presses. The ELM327 fallback header
(an internal lead) moved inboard to make room.

**Every terminal, port, header and button is named on the silkscreen**, title with reference plus
each pin, from `placement.LABELS`; header pins carry the breakout module's pin names. Reference
designators move to the first clear spot; where none exists they stay on the fab layer only.
The power board grew 5 mm (95 × 66) for the right edge's names; the box is unchanged (the plate
already had room). **USB-C footprint:** GCT USB4105 (same 16 pins), because KiCad has no 3D model
of the HRO part.

## Module headers checked against the parts in the BOM (2026-10-11)

**Pod J2 is the Adafruit 4754's JP1 row, pin for pin** (VIN, 3Vo, GND, SCL, SDA, INT), read from
Adafruit's own board file. The old J2 (3V3, GND, SCL, SDA, INT, RST) would have put ground on the
breakout's 3.3 V regulator output and shifted every signal by a pin. 3Vo stays open. RST is on the
breakout's other row: the firmware does not use it (it re-initialises on the sensor's reset report),
so it moved to a one-pin header **J8** for an optional jumper rather than a second socket over the MCU.

**Pod J6 (HC-05 fallback) is fed the pod's 5 V**, not 3.3 V: the HC-05 board needs 3.6–6 V on VCC;
its serial pins are 3.3 V logic.

**Leads, not sockets, for the rest:** GNSS, BTS7960, ACS712 and HX711 boards order their header pins
differently from seller to seller, so they connect by leads matched by name (the silkscreen carries
the module's pin names). The BTS7960 header follows the standard IBT-2 order.

**A buy list per footprint** is in `bill-of-materials.md` §10: the parts each footprint was drawn for.

## A reviewer's two points adopted; the converter simulated (2026-10-15)

**No via in a surface-mount pad, and 0.6 mm round the terminal and fuse-holder pins.** An engineer
reviewing the boards pointed at a via on a ground pad and thin tracks close to the terminals. Both
measured true (9 vias touching ground pads on the power board, 2 on the pod; 5 places under
0.3 mm from a terminal pin). Vias came from stitching and mending steps that let a via sit on its
own net's pad; now no via touches any surface-mount pad. KiCad does not pass a pad's own clearance
to the autorouter, so the terminal pins reach it as copies grown by 0.35 mm; the real pads carry
the 0.6 mm clearance and the DRC checks it. `routespec.sh` checks both rules.

**The 5 V converter simulated with TI's own model** (`hardware/sim/run_buck.sh`), in KiCad's
ngspice: start-up, a 0.2–1.5 A load step (stability) and 9–30 V input, against stated limits;
all pass. TI's model is downloaded on use, not committed (TI's copyright).

## TVS D10: SMCJ33CA instead of SMCJ24CA (2026-10-16)

**Chosen by simulation** (`hardware/sim/run_input.sh`). In a centrally suppressed load dump
(ISO 16750-2 test B: 35 V for up to 400 ms, what modern cars do) the SMCJ24CA, breaking down at
~27 V, tried to hold the car's whole supply down: ~100 ms at up to 141 W, 7 J, against roughly
152 W allowed for that length. The SMCJ33CA breaks down at ~37 V: it does not conduct during that
dump (the rail reaches 33 V; the buck, C20, C21/C22 and D11 are rated 60 V or more) and still
clamps the ISO 7637-2 spikes. Same SMC footprint: the value changed, not the copper. An
unsuppressed load dump (older cars, up to ~100 V) would overwhelm either; then the 3 A fuse opens.

## Boards ordered assembled by the fab (2026-10-16)

**Ian's decision: order the boards already assembled** (JLCPCB's PCB Assembly; PCBWay takes the
same files), 2 of each, instead of hand-soldering them. `finish.sh` now also writes each board's
fab-format BOM and placement file from `hardware/gen/sourcing.py`, which ties every BOM line to an
exact part number (the buy list's, passives from the makers the fab stocks cheaply) and fails if a
part has none. Where the exact number is not certain (the DB-25's 4.94 mm offset, the crystal's
12 pF, the PC817's suffix) the line says what to match, and the fab's matches are checked against
it before ordering. Through-hole parts are assembled too, for boards that arrive complete. The
PCB budget becomes ~KES 30,000–61,000 (was 15,000–28,000 with hand assembly). Tag `pcb-rev1.1`
marks the design ordered.

## Enclosures designed before the parts are bought (2026-10-16)

The E-stop housing, the windscreen pod and the gesture puck are designed around typical
dimensions (a 38 × 38 M12 board camera, a NEO-M8N board with stacked patch, the GY-9960 APDS-9960
module, a 27° windscreen), every such number marked VERIFY in its model, so the printing waits
only on a measurement, not a design. The pod stands upright (79 × 52 × 75 mm) instead of the
guide's 110 × 70 × 45 estimate, so the vertical board and the camera share one carrier wall. The
gesture window has no cover (a clear one reflects the sensor's IR LED back into it).

## R63 4.7 kΩ and the pod's C1/C2 1 µF / 4.7 µF (2026-10-16, Ian's decision)

**From the brake-light and pod-supply simulations** (`hardware/sim/run_brake.sh`,
`run_pod_supply.sh`). R63, the optocoupler LED's resistor, was 2.2 kΩ: 237 mW in a 60 s, 24 V
jump-start, against an 0805's 125 mW; at 4.7 kΩ it is 111 mW, and the weakest PC817 (CTR 25 %)
still reads pressed from 6 V. The pod's C1 and C2 were 10 µF each: with the decoupling about
22 µF behind the USB socket, an 88 µC inrush at attach against USB 2.0's 50 µC; at 1 µF and
4.7 µF (the AP2112K needs 1 µF each side) it is 28 µC. Value changes only, same footprints:
the routed boards' values were edited in place (copper and teardrops untouched), the fab files
regenerated, both simulations rerun with the new values (ALL PASS). The tag `pcb-rev1.1` still
marks the design before these two changes; **`pcb-rev1.2`** (on a0c0c57) marks the design to
order: use its fab files.
