kiogimwenda/AR_Windscreen/hardware/enclosures/estop/drilling_template.pdf

## dash panel: 1:1 drilling template

100 mm: measure before drilling Dash panel behind the E-stop base, seen from the driver, 56 × 56 mm. Coordinates from the bottom-left corner. Measure the box first; if it differs, change box_in in the model and regenerate. Tape the outline to the panel's edges. Print at 100 % (actual size). Centre-punch each red cross, pilot-drill 2.5 mm, then drill to size (a step drill for the large holes). Deburr.

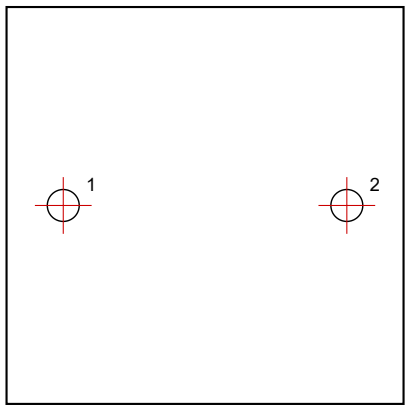
[picture p1: figure]

# | Size | For | (x, y) mm

1 | Ø 4.5 mm | M4 to the dash panel | (8.0, 28.0)
2 | Ø 4.5 mm | M4 to the dash panel | (48.0, 28.0)
