kiogimwenda/AR_Windscreen/hardware/enclosures/pod/drilling_template.pdf

## glass plate: 1:1 drilling template

100 mm: measure before drilling Aluminium 3 mm, bonded to the glass (VHB), seen from the cabin; roof end up, 50 × 60 mm. Coordinates from the bottom-left corner. Measure the box first; if it differs, change box_in in the model and regenerate. Tape the outline to the panel's edges. Print at 100 % (actual size). Centre-punch each red cross, pilot-drill 2.5 mm, then drill to size (a step drill for the large holes). Deburr.

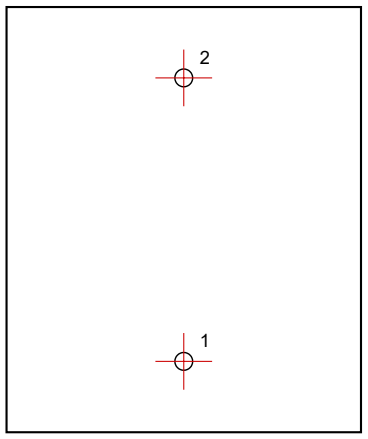
[picture p2: figure]

# | Size | For | (x, y) mm

1 | Ø 2.5 mm | drill 2.5, tap M3 (rail screws) | (25.0, 10.0)
2 | Ø 2.5 mm | drill 2.5, tap M3 (rail screws) | (25.0, 50.0)
