kiogimwenda/AR_Windscreen/hardware/enclosures/power_box/drilling_templates.pdf

## front wall: 1:1 drilling template

100 mm: measure before drilling Front wall (DB-25), seen from outside, 246 × 98 mm. Coordinates from the bottom-left corner. Measure the box first; if it differs, change box_in in the model and regenerate. Tape the outline to the panel's edges. Print at 100 % (actual size). Centre-punch each red cross, pilot-drill 2.5 mm, then drill to size (a step drill for the large holes). Deburr.

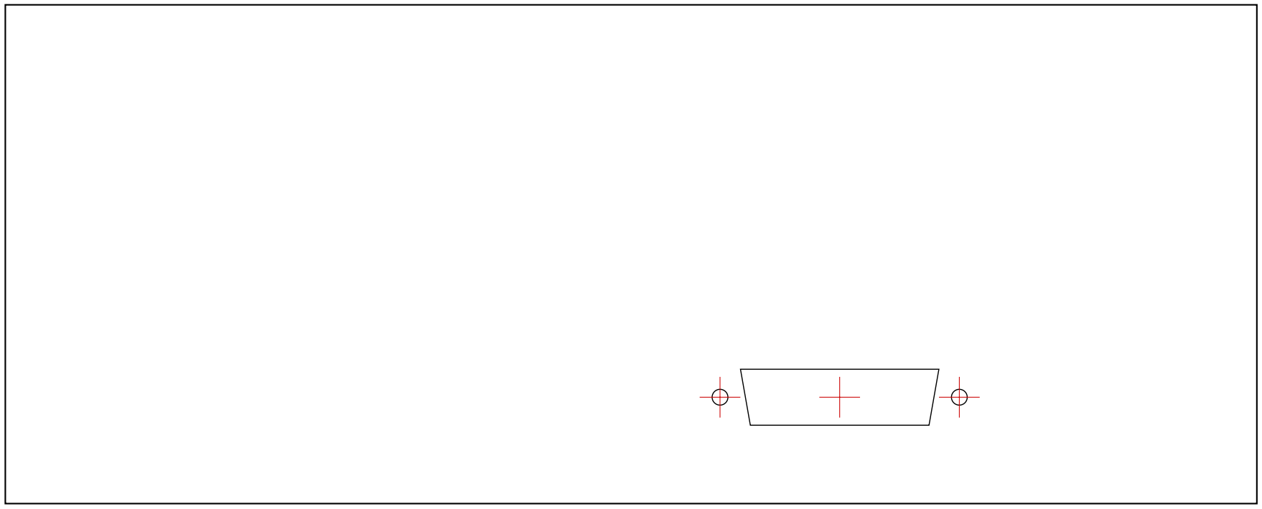
[picture p3: figure]

# | Size | For | (x, y) mm

D | 39 × 11 mm D, 2 × Ø 3.1 on 47.04 | DB-25 to the pod: VERIFY the shell against the cut-out. Drill the corners, cut, file to the line. | (164.0, 20.9)

## rear wall: 1:1 drilling template

Rear wall (cable glands), seen from outside, 246 × 98 mm. Coordinates from the bottom-left corner. Measure the box first; if it differs, change box_in in the model and regenerate. Tape the outline to the panel's edges. Print at 100 % (actual size). Centre-punch each red cross, pilot-drill 2.5 mm, then drill to size (a step drill for the large holes). Deburr.

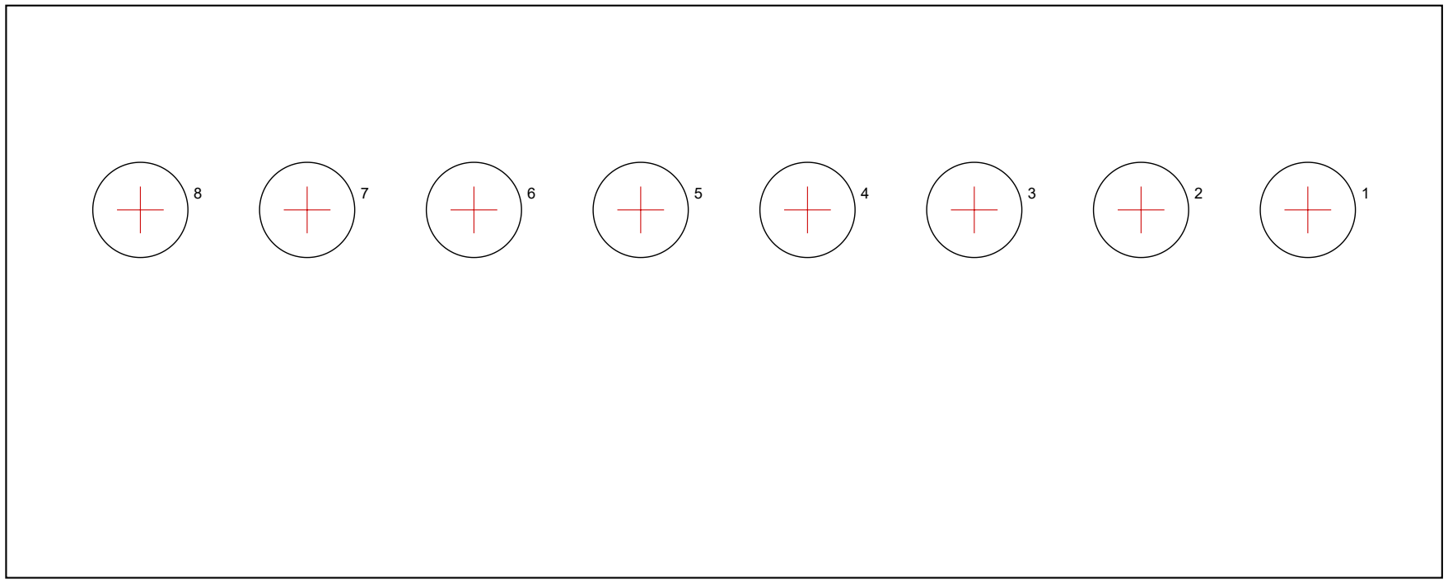
[picture p4: figure]

# | Size | For | (x, y) mm

1 | Ø 16.3 mm | M16 gland: LiDAR 12 V (M12 lead) | (223.0, 63.0)
2 | Ø 16.3 mm | M16 gland: OBD-II lead (CAN, keep it ~0.5 m) | (194.4, 63.0)
3 | Ø 16.3 mm | M16 gland: brake-light switch | (165.9, 63.0)
4 | Ø 16.3 mm | M16 gland: relay contacts to the car's switch wiring | (137.3, 63.0)
5 | Ø 16.3 mm | M16 gland: 12 V ACC (switched) in | (108.7, 63.0)
6 | Ø 16.3 mm | M16 gland: E-stop (kill relay coil) | (80.1, 63.0)
7 | Ø 16.3 mm | M16 gland: actuator + cable magnet | (51.6, 63.0)
8 | Ø 16.3 mm | M16 gland: 12 V battery feed (fused at the battery) | (23.0, 63.0)

## left wall: 1:1 drilling template

Left wall (vents by the BTS7960 heatsink), seen from outside, 146 × 98 mm. Coordinates from the bottom-left corner. Measure the box first; if it differs, change box_in in the model and regenerate. Tape the outline to the panel's edges. Print at 100 % (actual size). Centre-punch each red cross, pilot-drill 2.5 mm, then drill to size (a step drill for the large holes). Deburr.

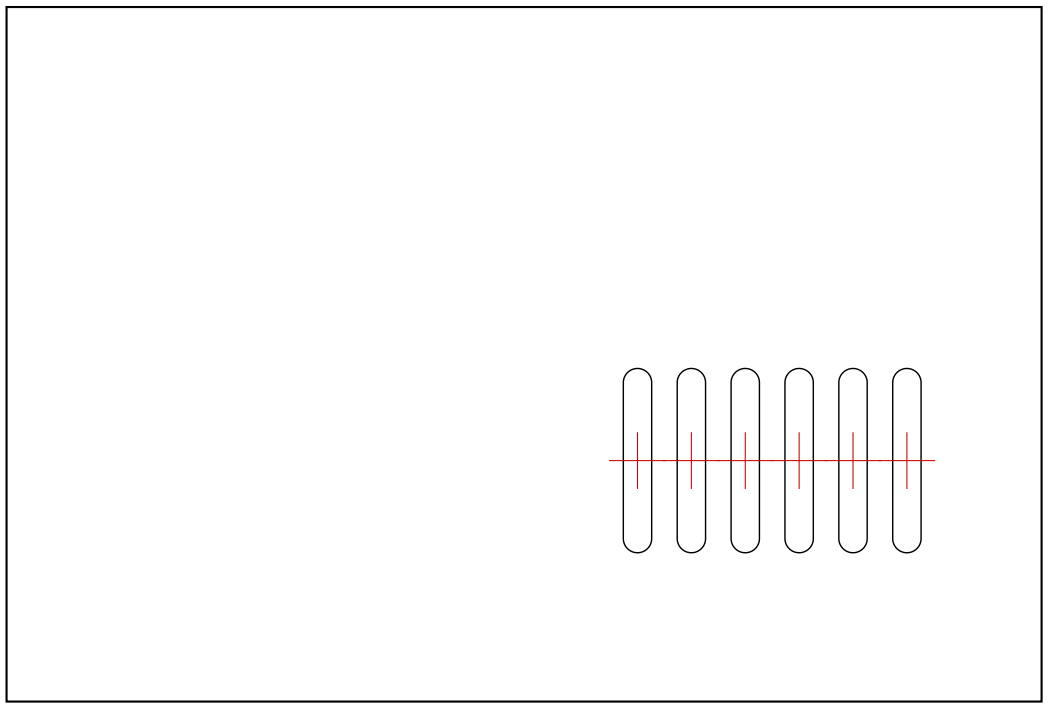
[picture p5: figure]

# | Size | For | (x, y) mm

slot | 4 × 26 mm | vent slot | (127.0, 34.0)
slot | 4 × 26 mm | vent slot | (119.4, 34.0)
slot | 4 × 26 mm | vent slot | (111.8, 34.0)
slot | 4 × 26 mm | vent slot | (104.2, 34.0)
slot | 4 × 26 mm | vent slot | (96.6, 34.0)
slot | 4 × 26 mm | vent slot | (89.0, 34.0)

## floor: 1:1 drilling template

Box floor, seen from INSIDE with the front wall at the bottom (or mark through the printed chassis), 240 × 140 mm. Coordinates from the bottom-left corner. Measure the box first; if it differs, change box_in in the model and regenerate. Tape the outline to the panel's edges. Print at 100 % (actual size). Centre-punch each red cross, pilot-drill 2.5 mm, then drill to size (a step drill for the large holes).

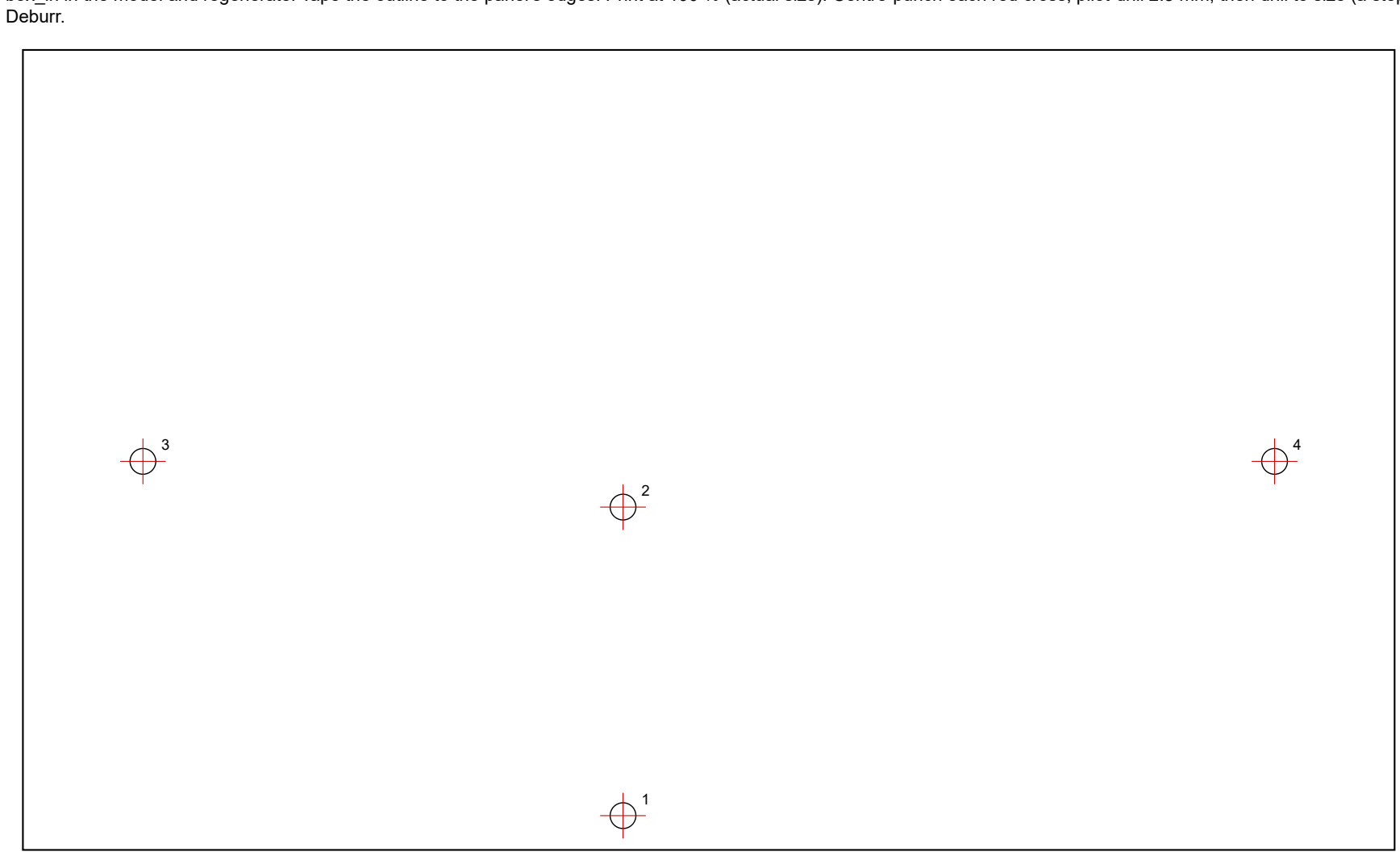
[picture p6: figure]
Deburr.

# | Size | For | (x, y) mm

1 | Ø 4.5 mm | M4 to the chassis insert | (105.0, 6.0)
2 | Ø 4.5 mm | M4 to the chassis insert | (105.0, 60.0)
3 | Ø 4.5 mm | M4 to the chassis insert | (21.0, 68.0)
4 | Ø 4.5 mm | M4 to the chassis insert | (219.0, 68.0)
