kiogimwenda/AR_Windscreen/docs/report/evidence/figures/fig_ar_views.png

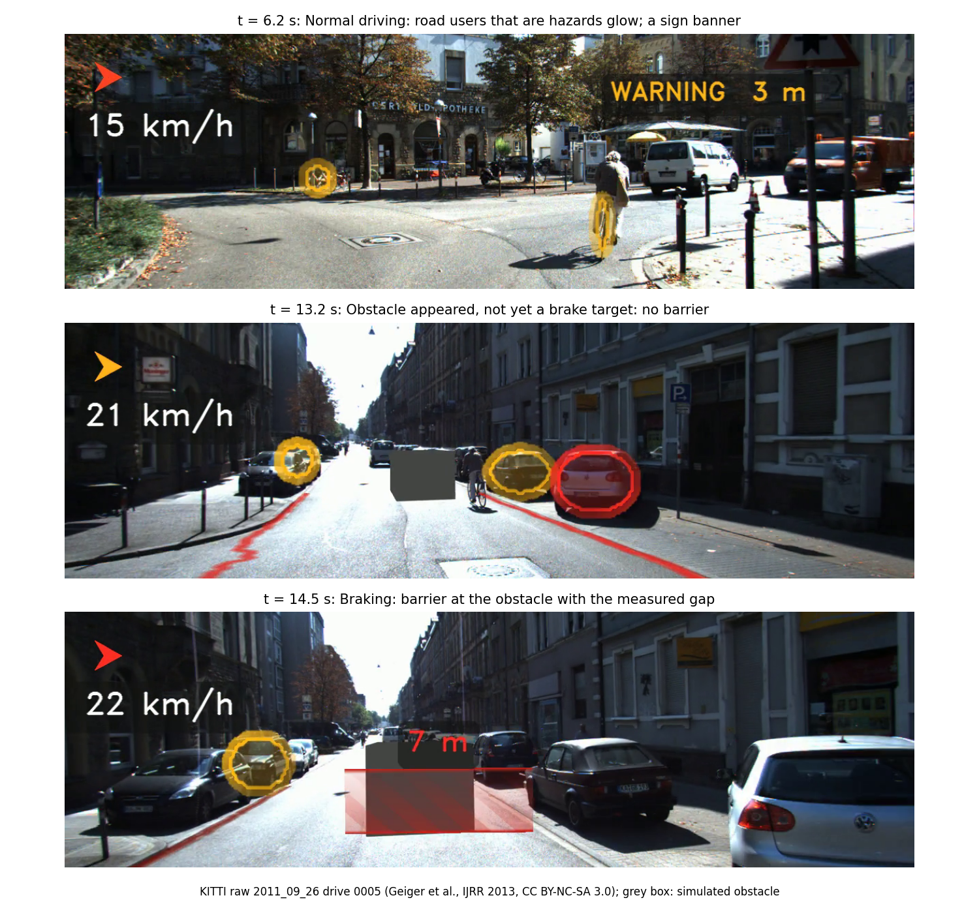
docs/report/evidence/figures/fig_ar_views.png
