kiogimwenda/AR_Windscreen/docs/report/evidence/figures/fig_brake_timeline.png

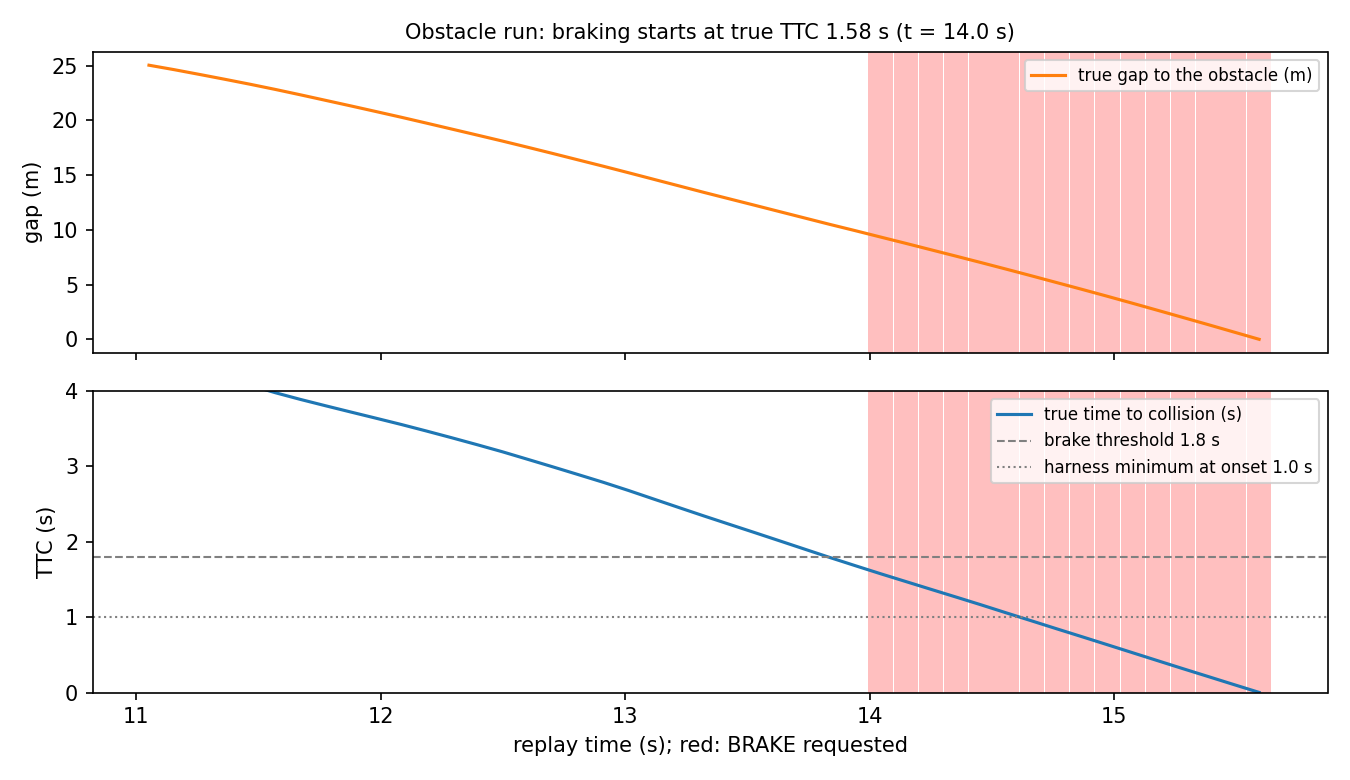
docs/report/evidence/figures/fig_brake_timeline.png
