kiogimwenda/AR_Windscreen/docs/report/evidence/figures/fig_demo_frame.png

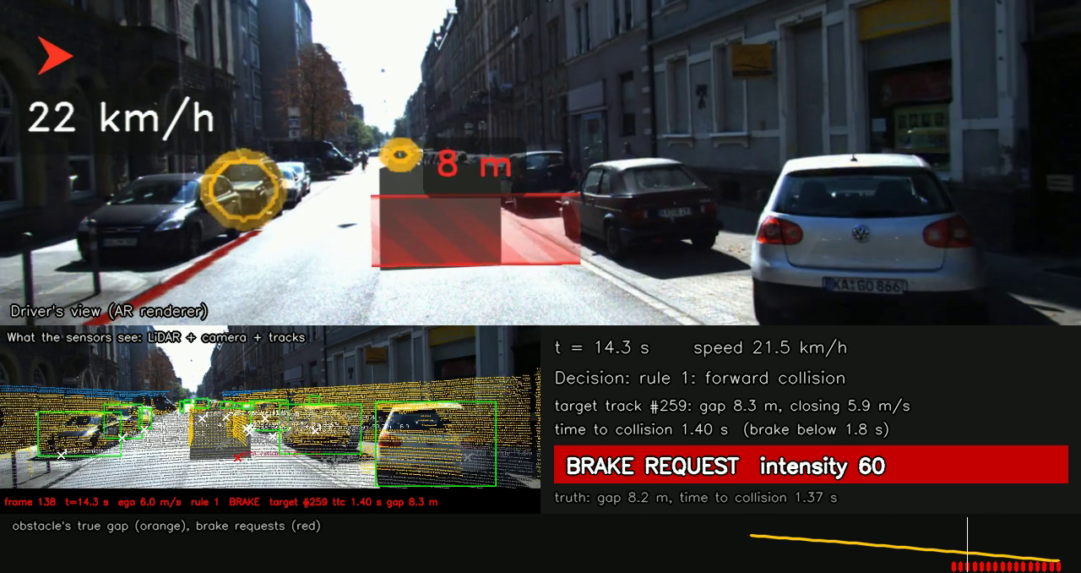
docs/report/evidence/figures/fig_demo_frame.png
