kiogimwenda/AR_Windscreen/docs/report/evidence/figures/fig_jitter.png

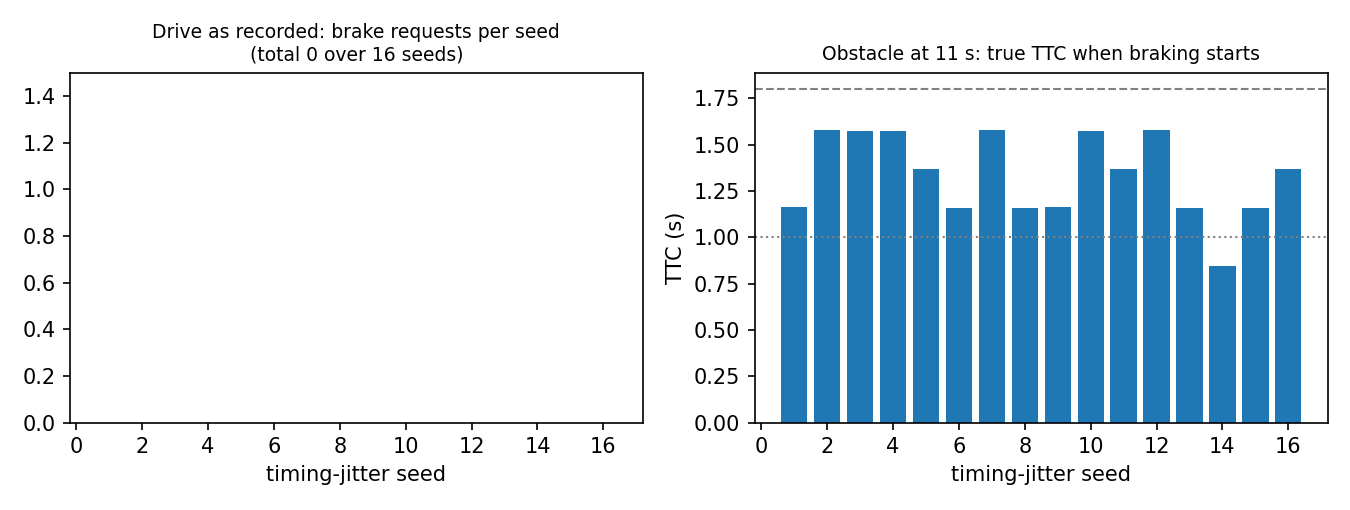
docs/report/evidence/figures/fig_jitter.png
