kiogimwenda/AR_Windscreen/docs/report/proposal/figures/ar_render_krakow.jpg

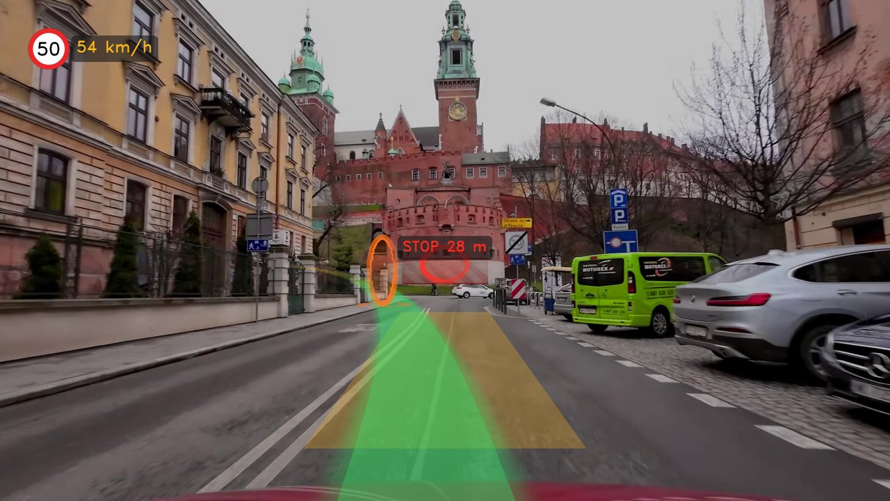
docs/report/proposal/figures/ar_render_krakow.jpg
