kiogimwenda/AR_Windscreen/docs/report/proposal/figures/perception_krakow_lanes.jpg

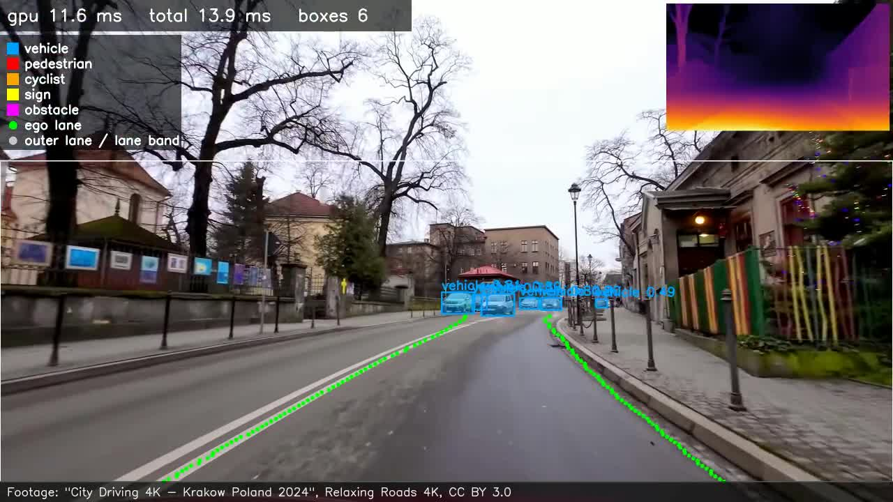
docs/report/proposal/figures/perception_krakow_lanes.jpg
