kiogimwenda/AR_Windscreen/docs/report/proposal/figures/perception_krakow_seg.jpg

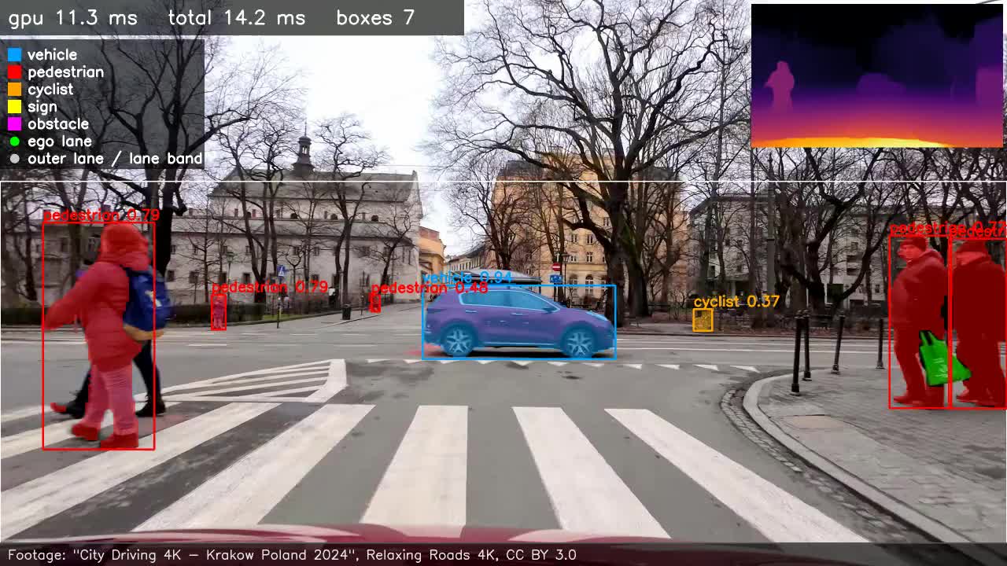
docs/report/proposal/figures/perception_krakow_seg.jpg
