kiogimwenda/AR_Windscreen/docs/report/proposal/figures/sign_speed_hump_kenya.jpg

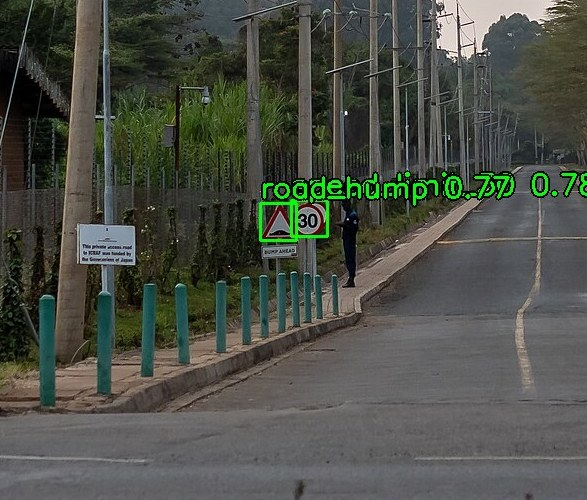
docs/report/proposal/figures/sign_speed_hump_kenya.jpg
