kiogimwenda/AR_Windscreen/docs/report/proposal/figures/sign_stop_kenya.jpg

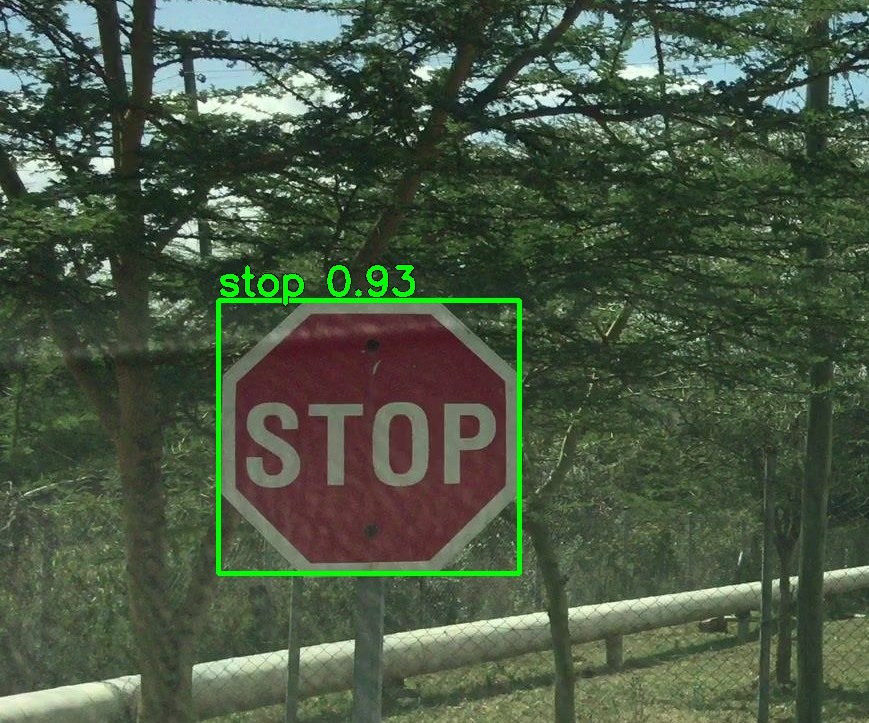
docs/report/proposal/figures/sign_stop_kenya.jpg
