kiogimwenda/AR_Windscreen/hardware/enclosures/lidar_mount/side.png

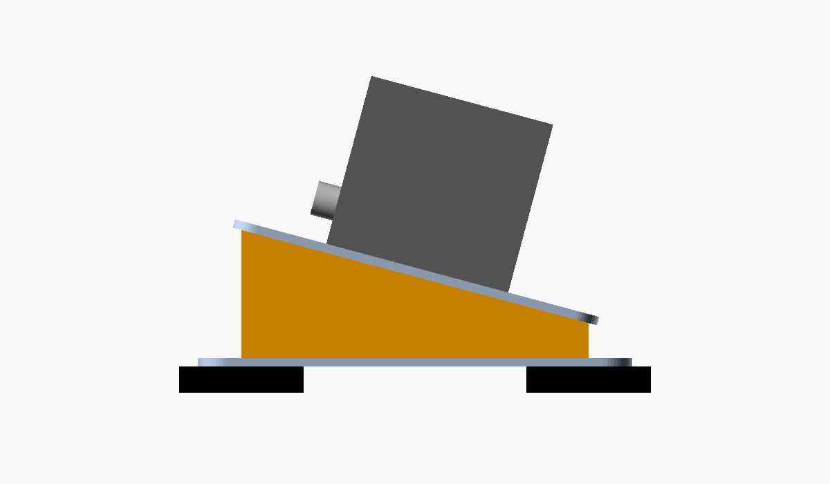
hardware/enclosures/lidar_mount/side.png
