kiogimwenda/AR_Windscreen/hardware/enclosures/pod/rear.png

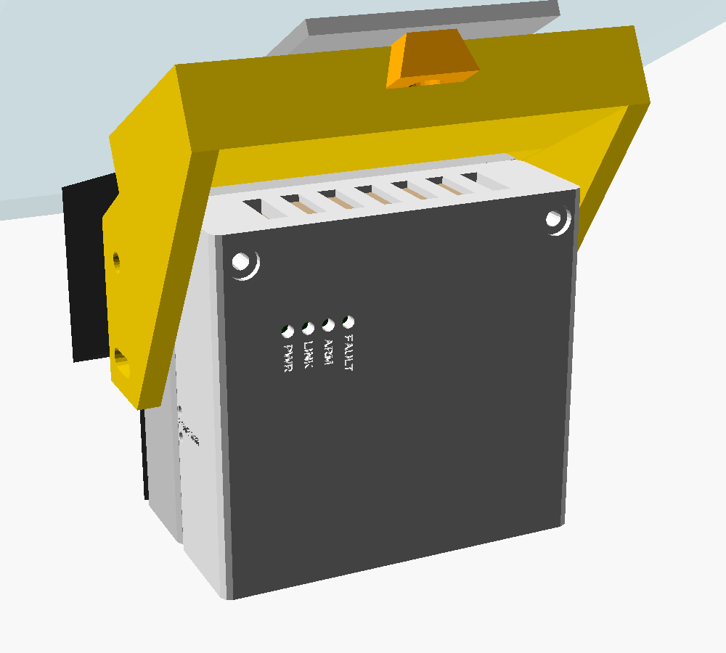
hardware/enclosures/pod/rear.png
