kiogimwenda/AR_Windscreen/hardware/enclosures/pod/side.png

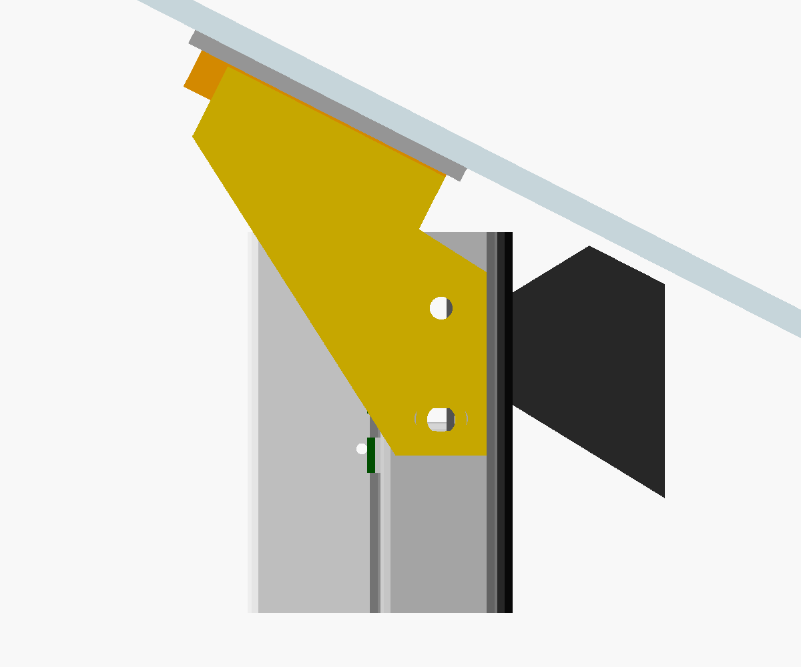
hardware/enclosures/pod/side.png
