kiogimwenda/AR_Windscreen/hardware/enclosures/power_box/top.png

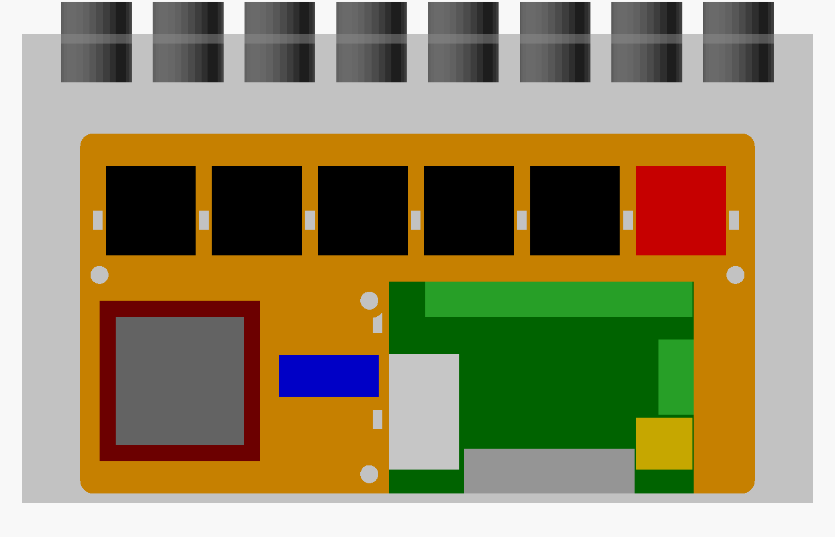
hardware/enclosures/power_box/top.png
