kiogimwenda/AR_Windscreen/hardware/pod_board/fab/review/B_Cu.png

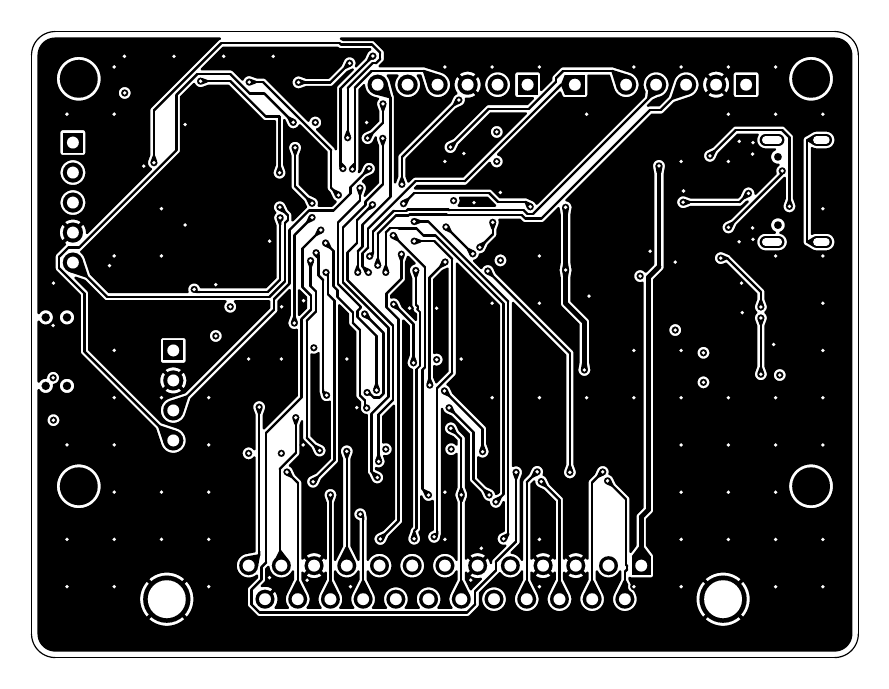
hardware/pod_board/fab/review/B_Cu.png
