kiogimwenda/AR_Windscreen/hardware/pod_board/fab/review/B_Mask.png

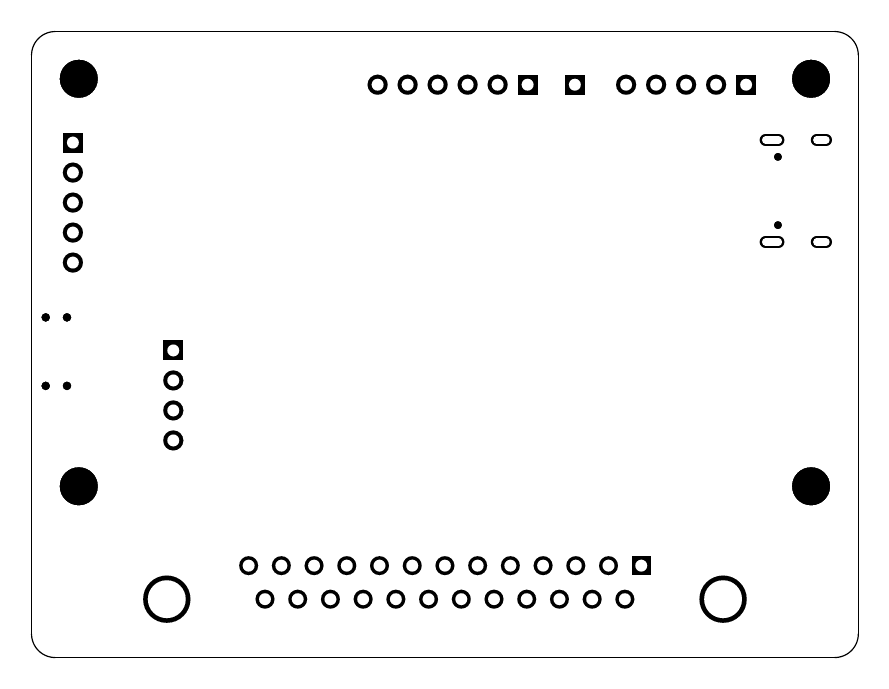
hardware/pod_board/fab/review/B_Mask.png
