kiogimwenda/AR_Windscreen/hardware/pod_board/fab/review/B_Paste.png

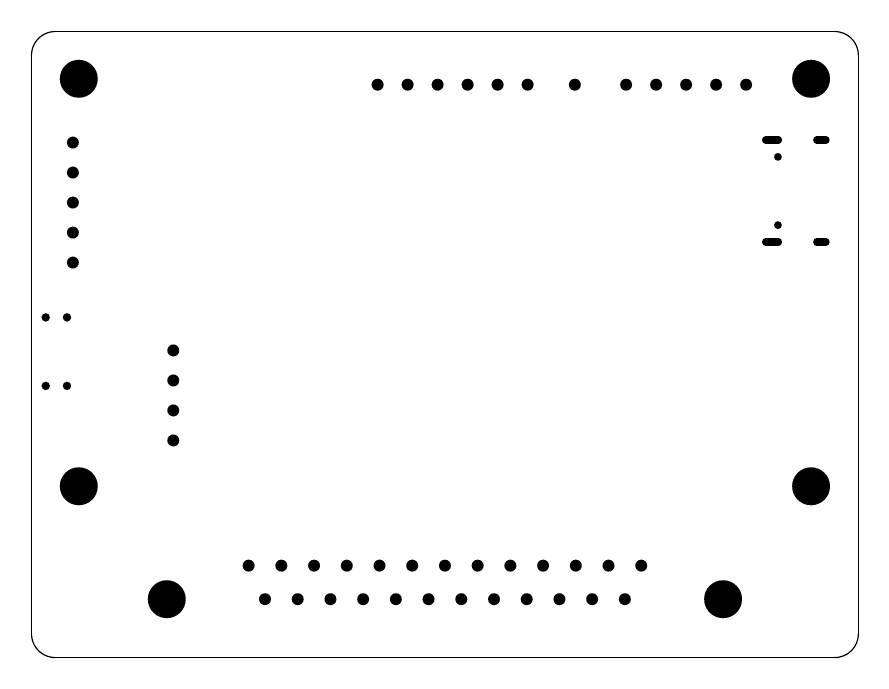
hardware/pod_board/fab/review/B_Paste.png
