kiogimwenda/AR_Windscreen/hardware/pod_board/fab/review/F_Cu.png

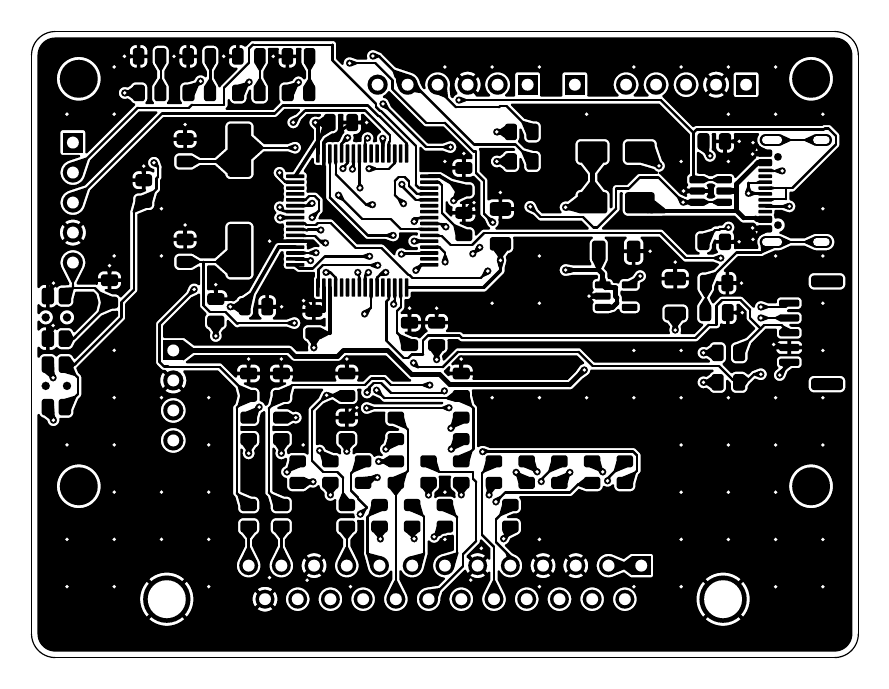
hardware/pod_board/fab/review/F_Cu.png
