kiogimwenda/AR_Windscreen/hardware/pod_board/fab/review/F_Mask.png

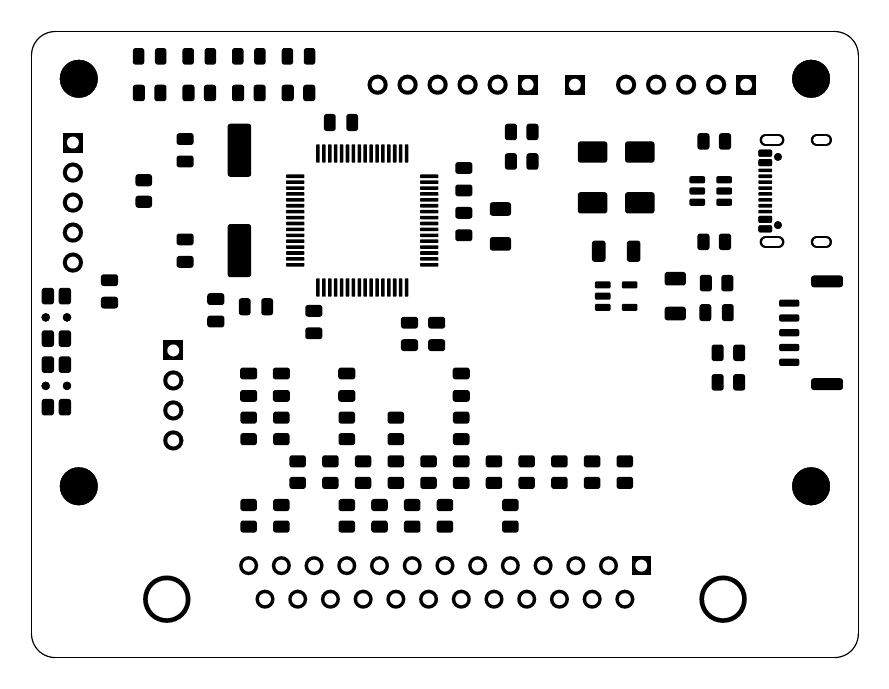
hardware/pod_board/fab/review/F_Mask.png
