kiogimwenda/AR_Windscreen/hardware/pod_board/fab/review/F_Paste.png

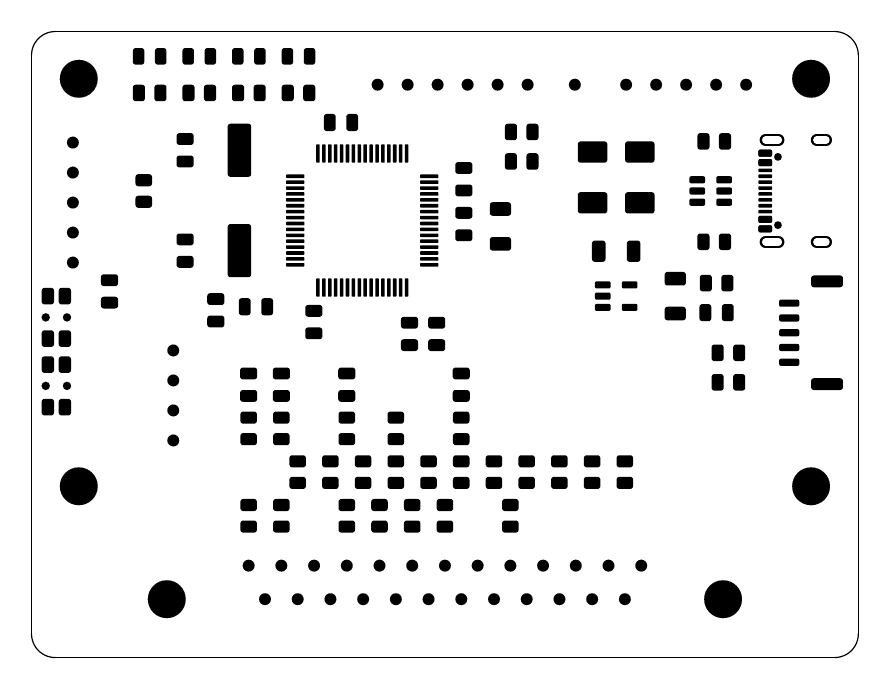
hardware/pod_board/fab/review/F_Paste.png
