kiogimwenda/AR_Windscreen/hardware/pod_board/fab/review/F_Silkscreen.png

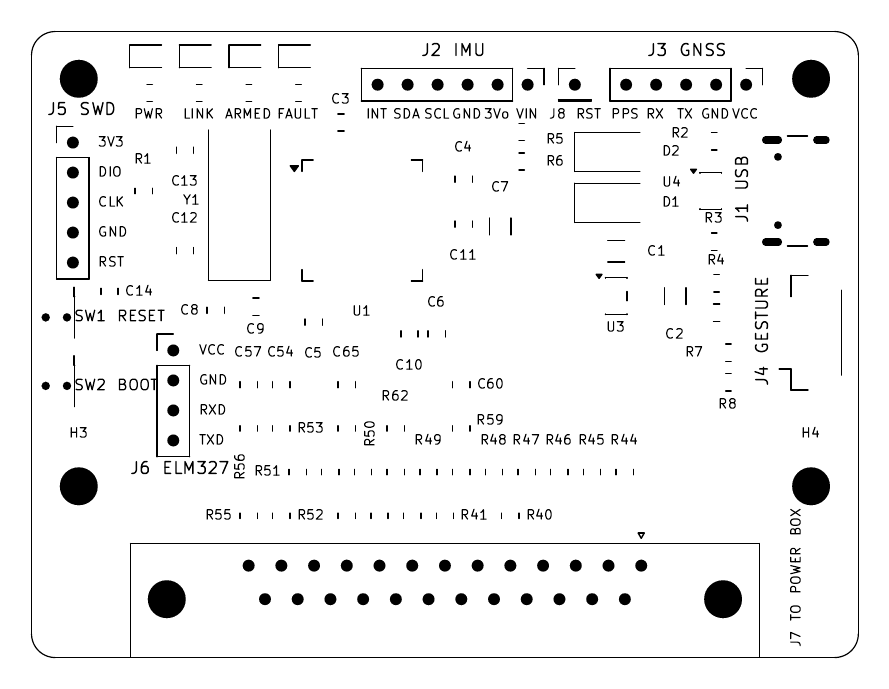
hardware/pod_board/fab/review/F_Silkscreen.png
