kiogimwenda/AR_Windscreen/hardware/pod_board/fab/review/In1_Cu.png

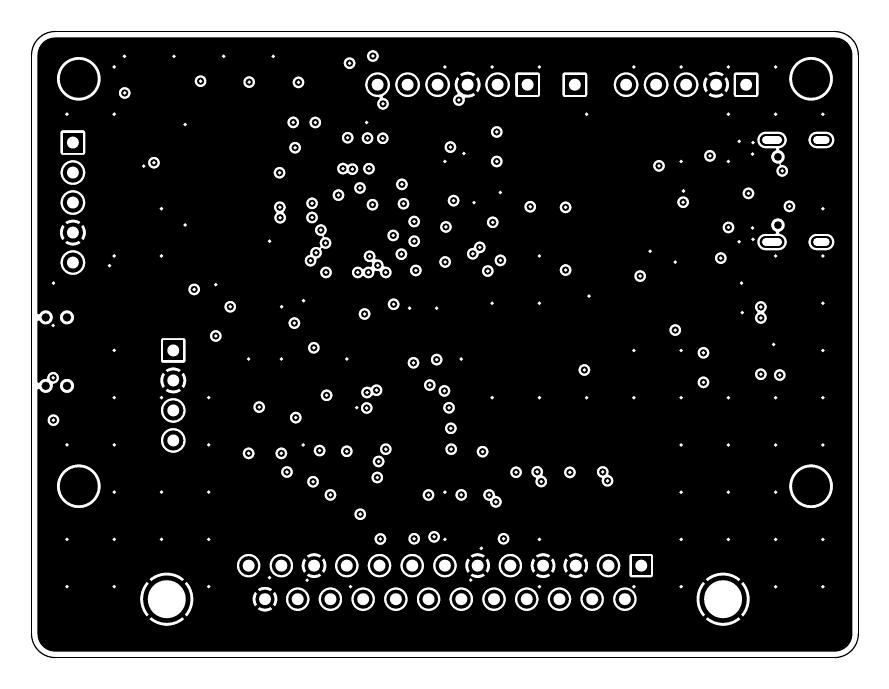
hardware/pod_board/fab/review/In1_Cu.png
