kiogimwenda/AR_Windscreen/hardware/pod_board/fab/review/In2_Cu.png

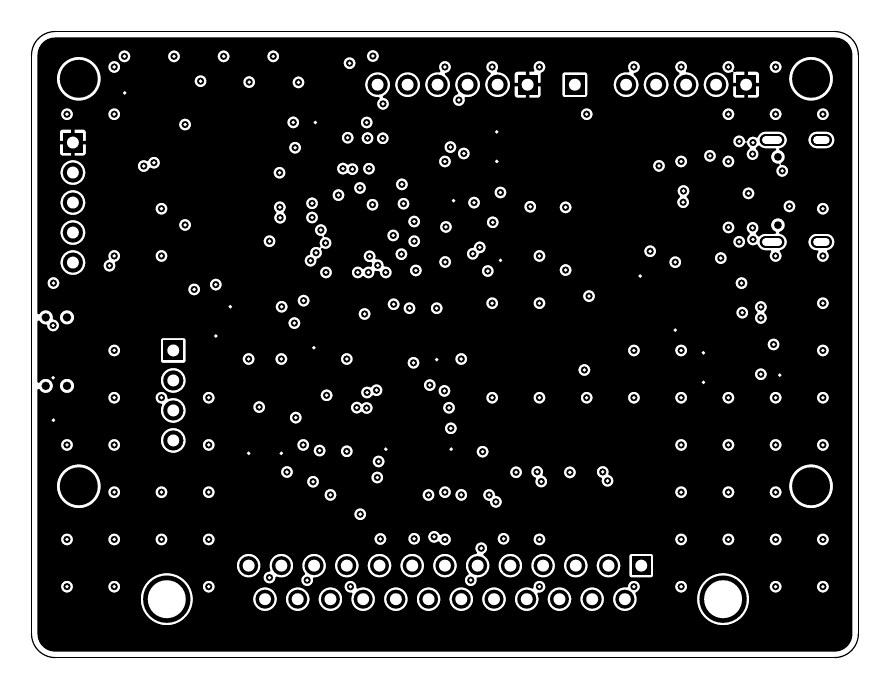
hardware/pod_board/fab/review/In2_Cu.png
