kiogimwenda/AR_Windscreen/hardware/pod_board/routed.png

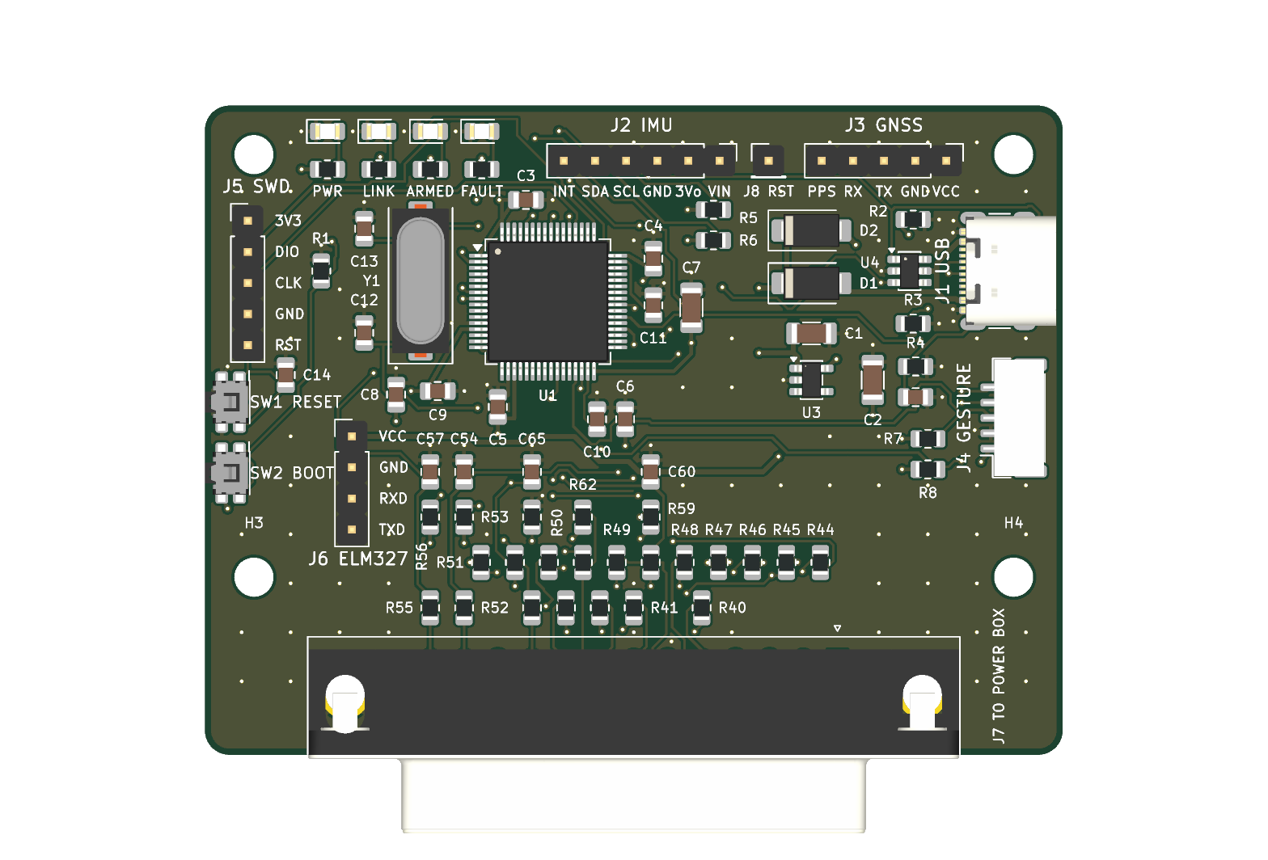
hardware/pod_board/routed.png
