kiogimwenda/AR_Windscreen/hardware/power_board/fab/review/B_Cu.png

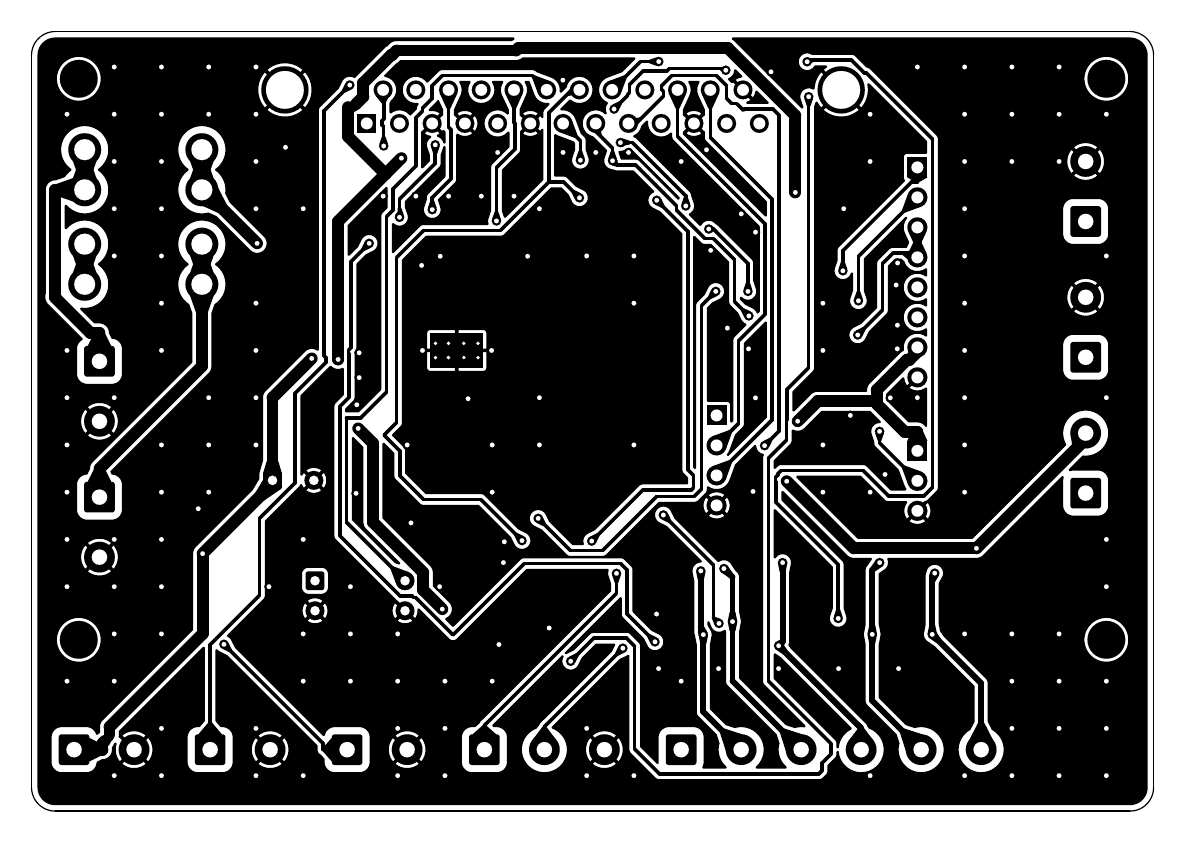
hardware/power_board/fab/review/B_Cu.png
