kiogimwenda/AR_Windscreen/hardware/power_board/fab/review/B_Mask.png

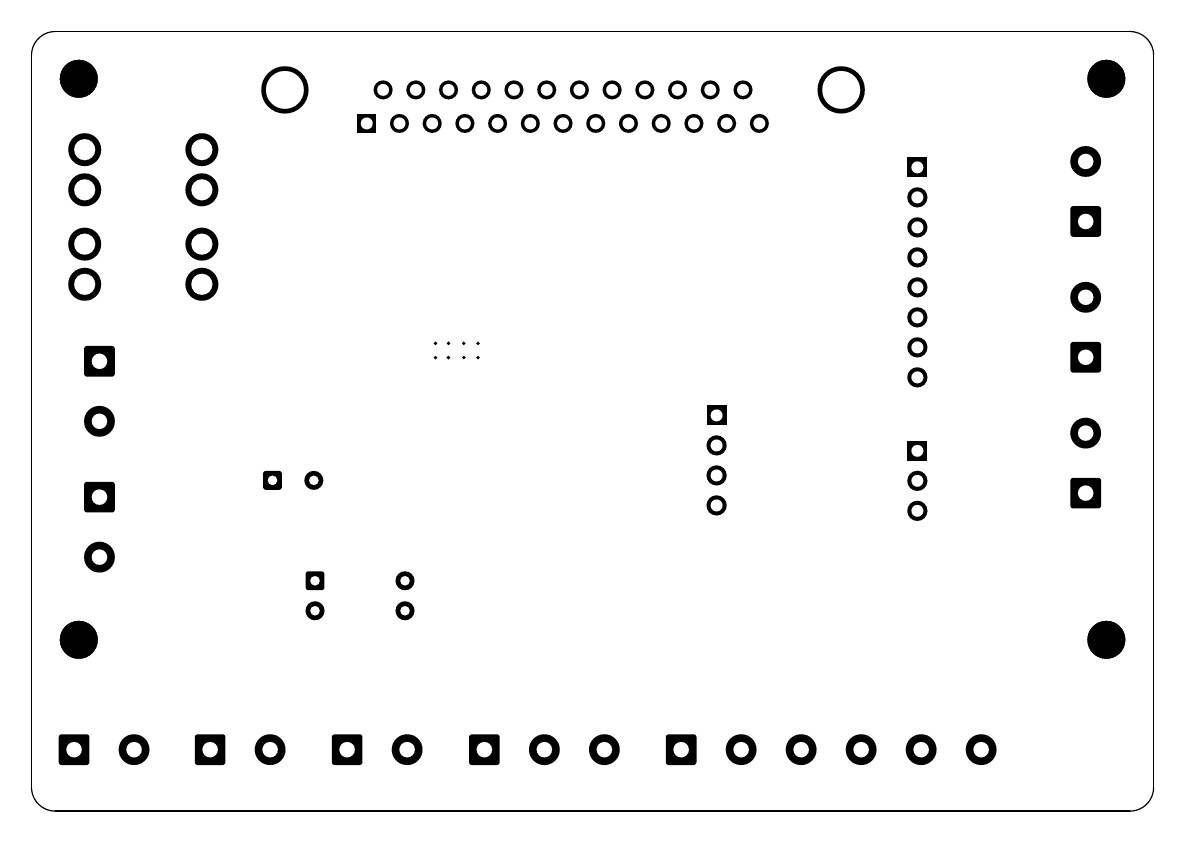
hardware/power_board/fab/review/B_Mask.png
