kiogimwenda/AR_Windscreen/hardware/power_board/fab/review/B_Paste.png

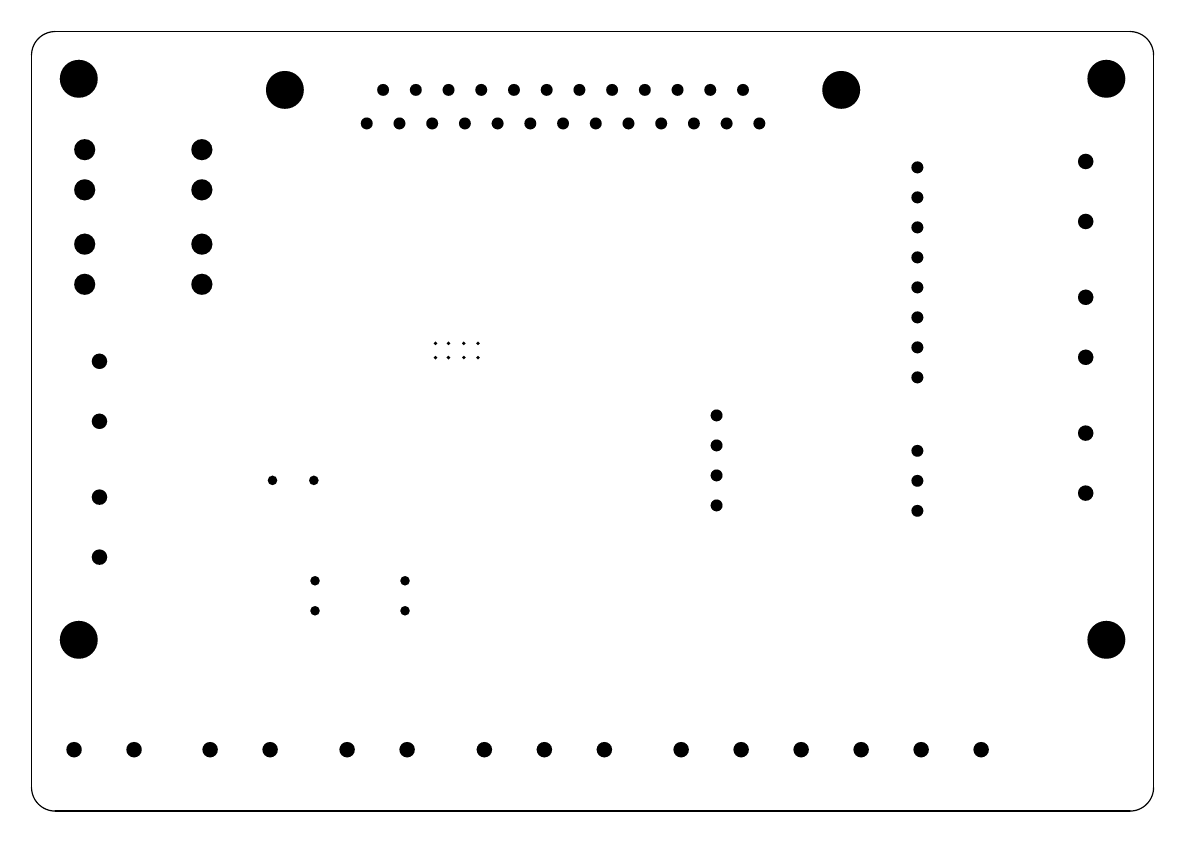
hardware/power_board/fab/review/B_Paste.png
