kiogimwenda/AR_Windscreen/hardware/power_board/fab/review/F_Cu.png

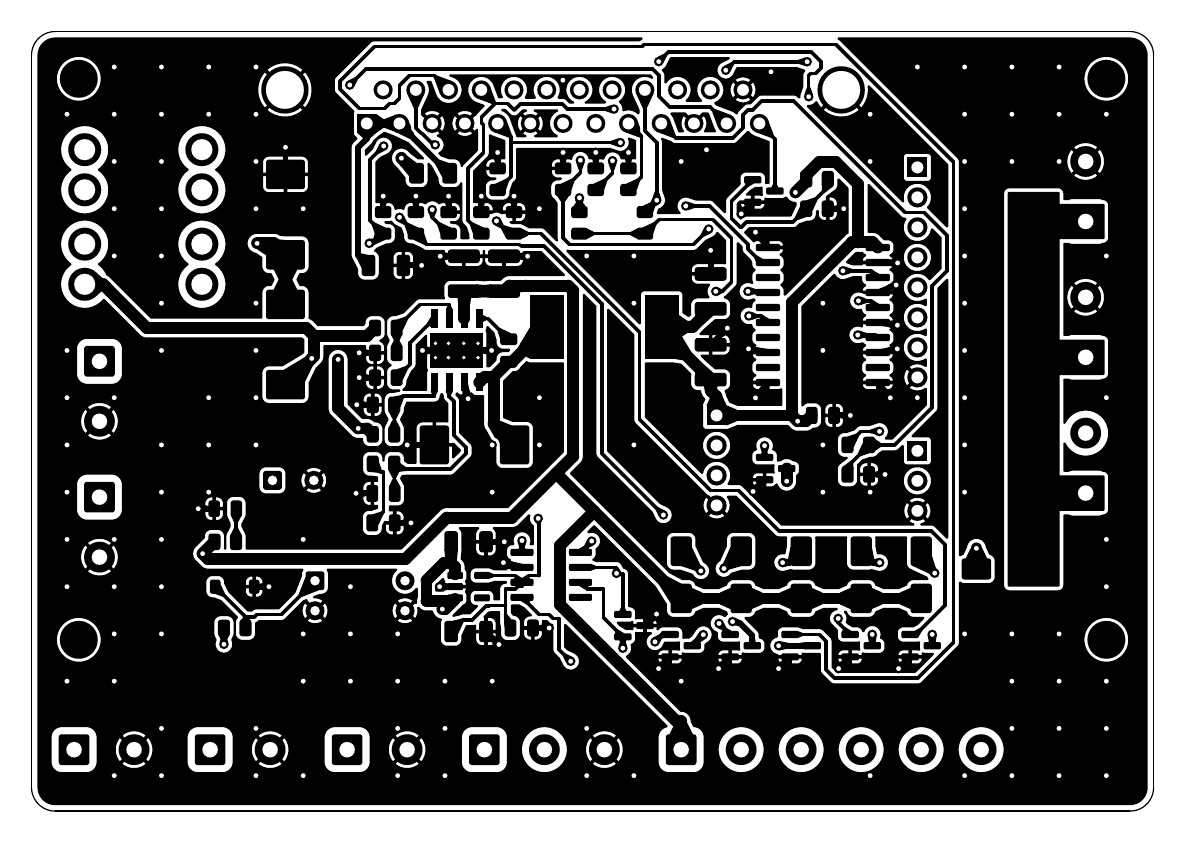
hardware/power_board/fab/review/F_Cu.png
