kiogimwenda/AR_Windscreen/hardware/power_board/fab/review/F_Mask.png

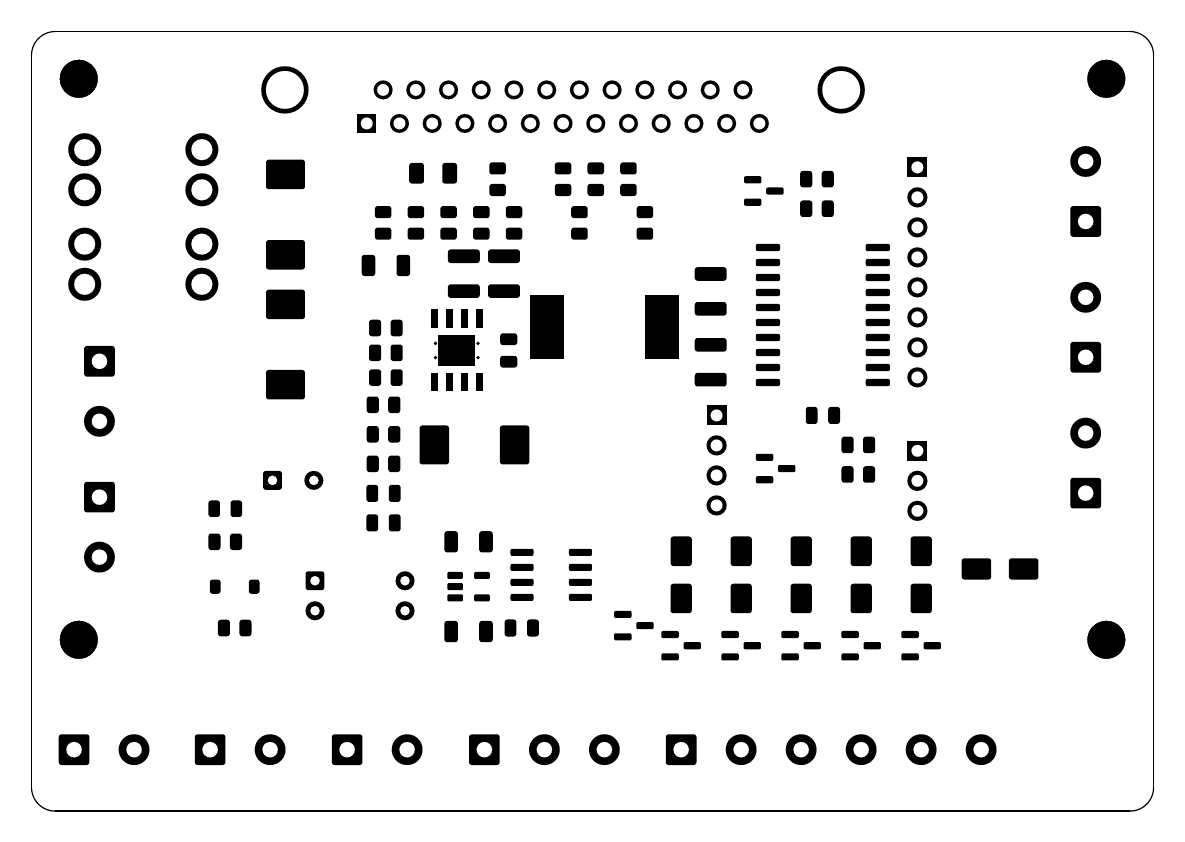
hardware/power_board/fab/review/F_Mask.png
