kiogimwenda/AR_Windscreen/hardware/power_board/fab/review/F_Paste.png

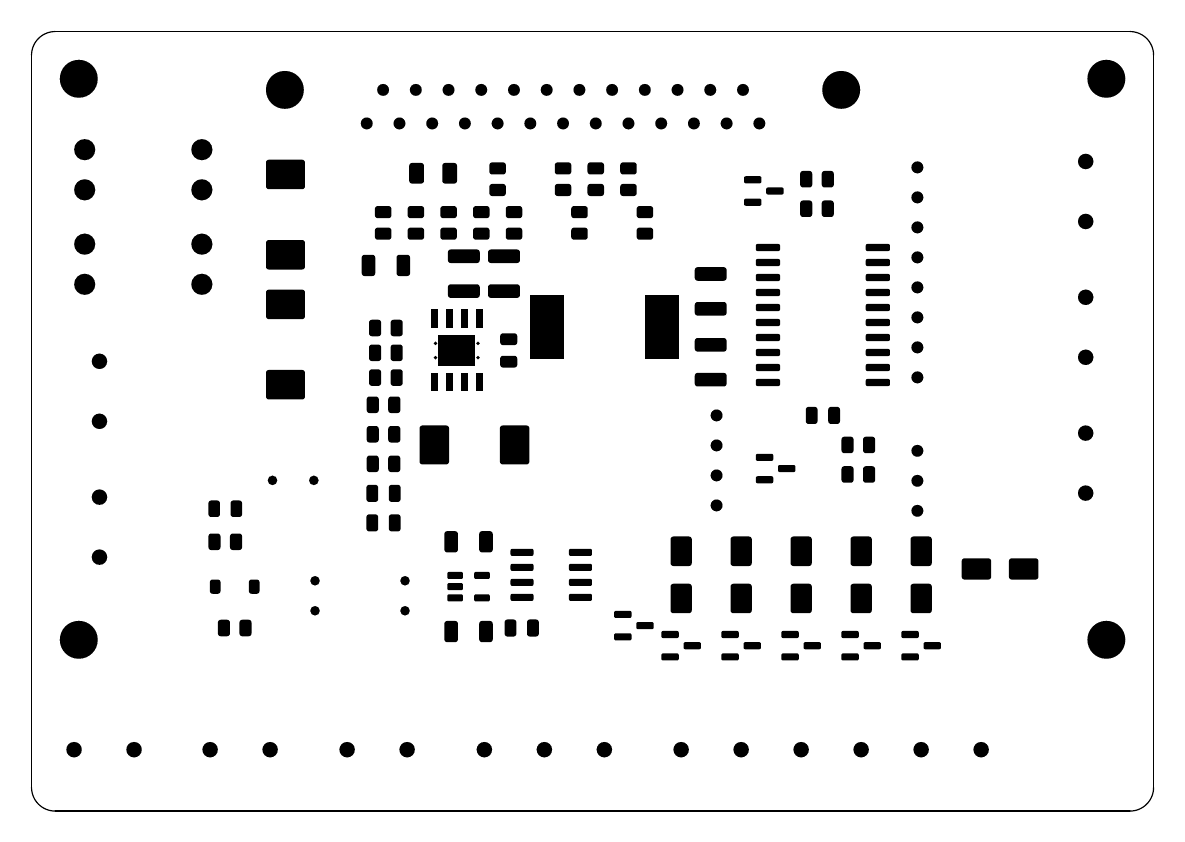
hardware/power_board/fab/review/F_Paste.png
