kiogimwenda/AR_Windscreen/hardware/power_board/fab/review/F_Silkscreen.png

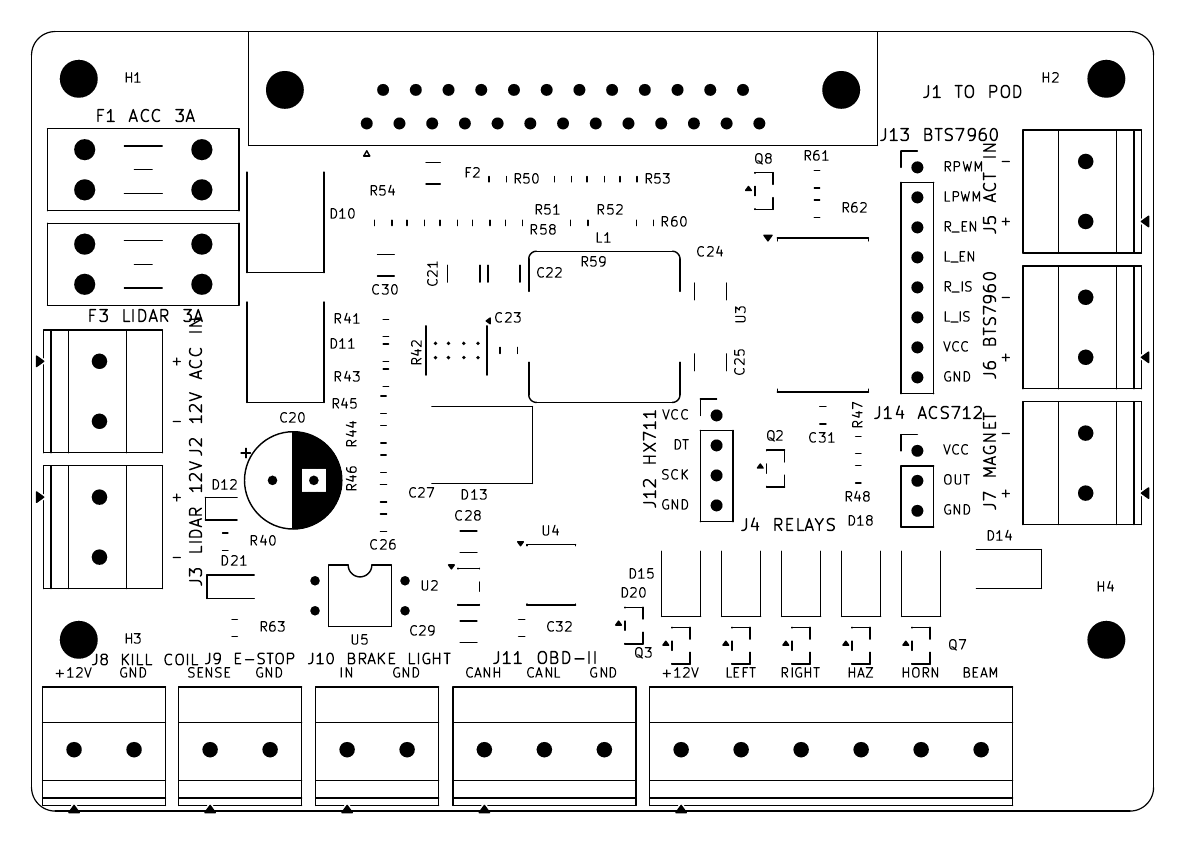
hardware/power_board/fab/review/F_Silkscreen.png
