kiogimwenda/AR_Windscreen/hardware/power_board/routed.png

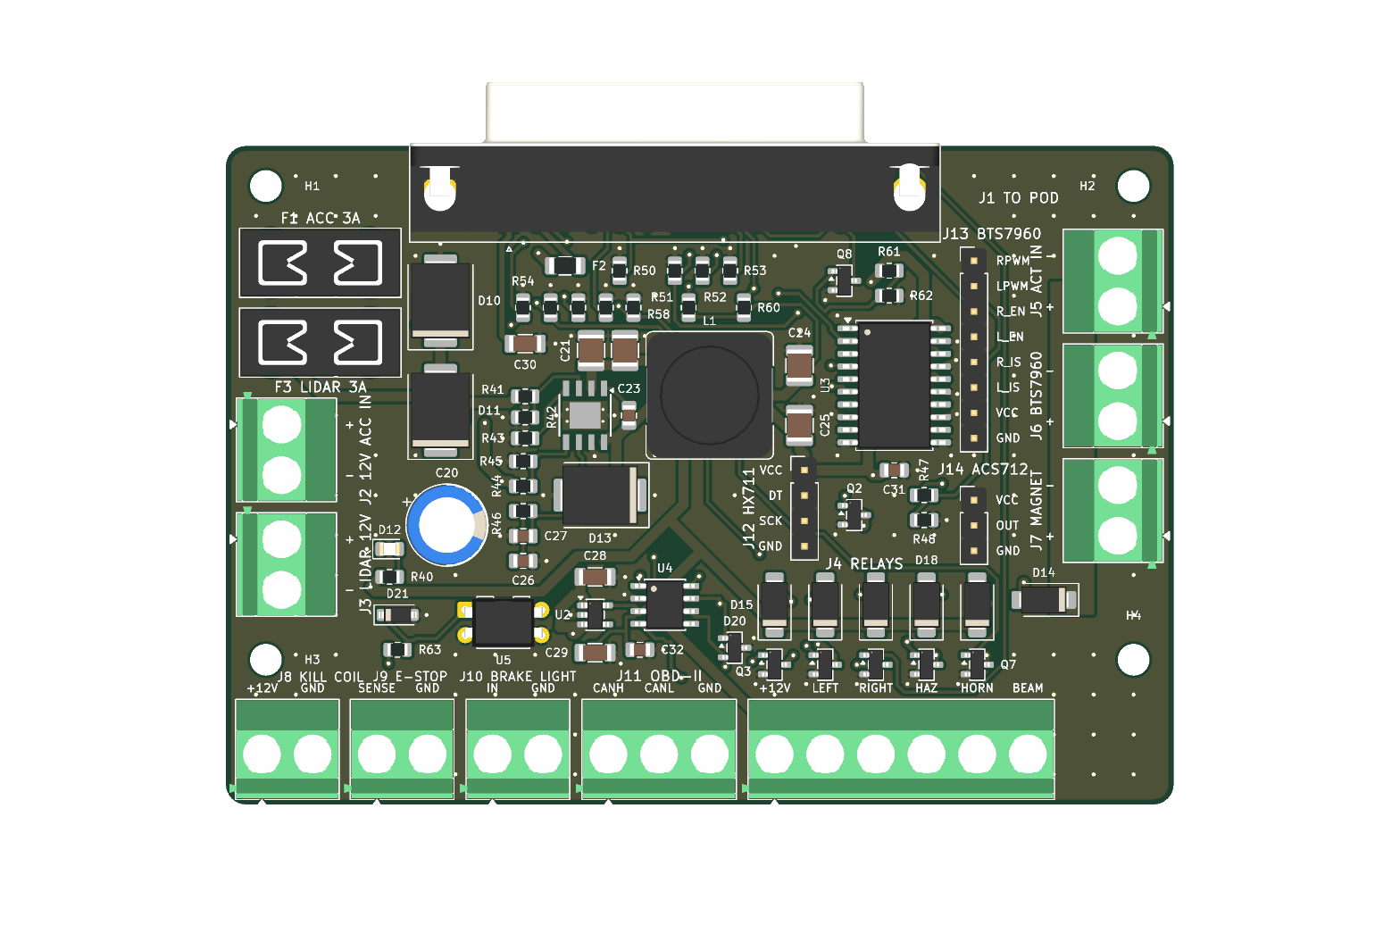
hardware/power_board/routed.png
