kiogimwenda/AR_Windscreen/docs/bill-of-materials.md

# Bill of Materials

Hardware needed to take the build past Phase 1. Every line traces to a section of `BUILD_GUIDE.md`.
Sourcing is **Kenya-first**: a local supplier is listed wherever one was found online, and an import
route is given only where nothing suitable is sold locally.

> **Amended 2026-09-30: the two-box hub** (`BUILD_GUIDE.md` Part 4.8, `decisions.md`). The hub is
> now a windscreen pod (MCU, camera, IMU, GNSS) and an under-dash power box, joined by a 25-way
> cable, later built on two custom PCBs (§9). OBD-II is read straight from the car's CAN bus. Items
> marked **Superseded** stay listed for the record; do not buy them unless their note says so.
> New prices below are **estimates** made on 2026-09-30, not shop quotes: confirm before buying.

Prices were researched on **2026-09-24**. Kenyan maker shops go out of stock often, and several items
below showed as sold out that day. **Before you travel to a shop, confirm stock by phone or WhatsApp.**
"Est." means no price was published and the figure is a market estimate.

**Local suppliers used**

| Shop | Where | Contact |
|---|---|---|
| K-Technics | Munyu Rd Business Centre, 2nd flr, Rm C6, Nairobi CBD | +254 712 799 123 · ktechnics.com |
| Pixel Electric | Nairobi | pixelelectric.com |
| Nerokas | Nairobi | store.nerokas.co.ke |
| ArduinoTech Kenya | Nairobi CBD pickup | +254 724 011 572 (WhatsApp) · arduinotech.co.ke |
| Jumia / Kilimall | Online, countrywide delivery | jumia.co.ke · kilimall.co.ke |
| Auto-spares strip (Kirinyaga Rd / Luthuli Ave), used-parts yards | Nairobi | walk-in |

---

## 1. Sensor & Actuator Hub (Part 4)

| # | Item | Spec that matters | Source | Price (KES) | Status |
|---|---|---|---|---|---|
| 1.1 | **STM32F405RGT6 development board** (bring-up, until the pod board exists) | The pod board's MCU (two bxCAN controllers for OBD over CAN, LQFP64). **Check it has an 8 MHz crystal** (USB needs it; the firmware assumes 8 MHz, `HSE_VALUE`). | K-Technics | 3,200 | In stock |
| 1.1b | ~~STM32F401CCU6 "Black Pill" v3.0~~ | **Superseded 2026-09-30:** no CAN controller. | K-Technics | 900 | — |
| 1.2 | ST-Link V2 (mini clone) | SWD flashing and real breakpoint debugging. USB DFU can also flash, but it cannot debug a stuck FreeRTOS task. | K-Technics | 750 | In stock |
| 1.3 | ~~Logic-level converter, 4-ch (×2)~~ | **Superseded 2026-09-30:** a 74HCT244 on the power board (item 1.6) does the level shifting and adds the fail-safe pull-downs. Note A still explains why. | K-Technics | 150 each | — |
| 1.4 | Perfboard, header pins, JST/Dupont leads, screw terminals | Bring-up: the pod side and "power box v0" | K-Technics / Pixel | ~1,000 est. | Common |
| 1.5 | **DB-25 male + female connectors (×2 pairs) and a shielded 25-core cable, ~2 m, ALL 25 wired** | The inter-box cable (Part 4.8.3). Cheap printer cables often skip pins: buy loose shielded multicore, or check every pin. | Electronics shops, Luthuli Ave / Jumia | est. 1,000–1,500 | Common |
| 1.6 | 74HCT244, logic-level MOSFETs (AO3400A ×8, 2N7002 ×2), 10 k/100 k resistors, 1N4007/SS14 diodes | Power box v0: buffered, pulled-down outputs (fail-safe with the cable out), relay and magnet drivers | Pixel / Nerokas / K-Technics | est. 500–1,000 | Common |
| 1.7 | **SN65HVD230 CAN transceiver breakout** (3.3 V) | OBD-II over the car's CAN bus, at the power box beside the OBD lead | Pixel / K-Technics / Jumia | est. 400–700 | Listed |
| 1.8 | **OBD-II (J1962) male plug with a ~0.5 m pigtail** | Pins 4/5 ground, 6 CAN_H, 14 CAN_L, 16 battery. Keep it short: it is the stub on the car's CAN bus. | Jumia / auto-electrical shops | est. 800–1,500 | Listed |

**1.1 is the firmware target** (`platformio.ini`: `genericSTM32F405RG`, since 2026-09-30). The F405
runs at 168 MHz with 1 MB of flash and two CAN controllers. Before buying, confirm the board's
crystal is 8 MHz (printed on the metal can): USB depends on it, and the firmware assumes it. A board
with a different crystal needs `HSE_VALUE` and `Config.h`'s `kHseHz` changed to match.

## 2. Sensors (Part 4.2, Part 6, Part 8)

| # | Item | Spec that matters | Source | Price (KES) | Status |
|---|---|---|---|---|---|
| 2.1 | **BNO085 IMU breakout** (Adafruit 4754 or equivalent) | On-chip sensor fusion. Part 4.1 already pins the `Adafruit BNO08x` library. | **Import.** No Kenyan listing found. | ~US$25 | See §7 |
| 2.1b | *Local fallback:* BNO055 breakout | Similar fusion IMU, but needs a different driver library (decision needed). | Jumia | est. 2,500–4,000 | Listed |
| 2.2 | **u-blox NEO-M8N GPS** with antenna | 72-ch multi-GNSS, UART. Get a board with a u.FL/SMA connector if the antenna will go on the roof (Part 15.2 step 1). | Pixel Electric (GY-GPSV3) / Nerokas (with EEPROM + antenna) | 1,800 | **Both sold out.** Ring them. NEO-6M (~1,100) is a fallback at lower accuracy. |
| 2.3 | ELM327 OBD-II adapter, Bluetooth | **Fallback only (2026-09-30):** buy only if the test car turns out to be pre-CAN (K-line). Then get a genuine PIC18F25K80 ("v1.5"). | Jumia / Kilimall | est. 1,000–2,000 | Only if needed |
| 2.4 | HC-05 Bluetooth module | **Fallback only**, with 2.3, on the pod's USART3 header. | K-Technics 650 / Pixel 600 | 600–650 | Only if needed |
| 2.5 | APDS-9960 gesture sensor | I2C, shares the bus with the IMU | Pixel Electric | 800 | **Sold out.** Ring them, or check Jiji. PAJ7620 (Pixel) is a fallback but needs a different library. |
| 2.6 | **USB camera, 1440p ("2K")** | Must allow **manual focus lock** over UVC/V4L2. Autofocus invalidates the Part 12.1 intrinsics every time it moves. Check this before buying. Serves the bench (Phases 4–13). | Jumia (e.g. UGREEN CM778, other 2K models) | 6,000–13,000 | Listed |
| 2.6b | *Recommended for the pod:* **UVC board camera, 2K, M12 lens with locking ring** (e.g. ELP modules) | Fits the pod on the carrier plate; focus fixed by construction; glass lens; operating range to **≥ 60 °C** (behind the windscreen). Choose a lens giving ~90° horizontal field of view. | **Import**, add to §7 | ~US$40–70 | See §7 |
| 2.7 | **Livox Mid-360 LiDAR** | 360°×59° FoV, 9–27 V DC, 100 Mbit Ethernet, the Livox-SDK2 device Part 2.8 installs | **Import.** No Kenyan stockist found. | ~US$749 list | See §7 |
| 2.8 | Livox three-wire aviation cable (M12 → RJ45 + power + function) | **Not included** with the Mid-360. Without it you cannot power or talk to the LiDAR. | Import with 2.7 (DJI or third-party) | ~US$20 | See §7 |
| 2.10 | Active GNSS antenna, roof (magnetic, SMA) | **Only if** the windscreen's coating blocks GNSS at the pod (Part 4.8.2). | Jumia | est. 800–1,500 | If needed |
| 2.9 | USB 3.0 → Gigabit Ethernet adapter | **Only if your laptop has no RJ45 port.** Part 2.2/Appendix C also use it as the `usbipd` fallback. | Jumia (UGREEN, generic) | est. 1,000–2,500 | Listed |

## 3. Actuation and safety (Part 4.2, Part 13.3, Part 15.2)

> **Do not buy the brake actuator yet.** See note B. The actuator's mechanical design is an open
> safety decision, and the obvious local purchase would violate the guide's hard rule.

| # | Item | Spec that matters | Source | Price (KES) | Status |
|---|---|---|---|---|---|
| 3.1 | **BTS7960 43 A H-bridge module** | PWM plus direction, with built-in current-sense (IS) pins | Jumia (listed) / Pixel (1,800, sold out) | est. 1,200–1,800 | Listed on Jumia |
| 3.2 | ACS712-20A current sensor | An independent, calibratable current reading for Part 4.5's overcurrent latch and Part 13.3 logging. The BTS7960's IS pins vary ±20 % part-to-part. | Nerokas / K-Technics / Jumia | est. 400–600 | Listed |
| 3.3 | **Brake actuator** | *Pending note B.* Pull-only coupling, bounded force, fast enough to matter. | — | — | **Blocked on design** |
| 3.4 | **Emergency-stop switch**, 22 mm mushroom, twist-release, **NC contact + a second contact block** | Driver-reach kill switch (Part 0 property 2). The second contact drives the hub's sense line. | Industrial electrical suppliers (Luthuli Ave / Industrial Area). Not found online. | est. 800–1,500 | Walk-in |
| 3.5 | 12 V automotive relay, 40 A, SPST-NO, with socket (×2) | The E-stop switches this relay's **coil**, and the relay carries the actuator current. Contacts are closed only while the E-stop is released, so the kill path fails safe. | Auto-spares strip | est. 300–500 each | Common |
| 3.6 | **12 V automotive relays with sockets (×5)** | Indicators, hazards, horn, high beam, driven by MOSFETs on the power board (active-high, off by default). **Replaces** the 4-ch 5 V relay module (superseded 2026-09-30: its active-low inputs are not off by default when the cable is out). | Auto-spares strip | est. 1,500–2,500 | Common |
| 3.7 | PC817 optocoupler module (2-ch) | *Recommended addition, not in the guide.* Reads the car's brake-light switch so the hub knows the driver is braking. See note C. | Pixel / K-Technics | est. 150–300 | Common |

## 4. Power (Part 15.2 step 8)

| # | Item | Spec that matters | Source | Price (KES) | Status |
|---|---|---|---|---|---|
| 4.1 | 12 V → 5 V buck converter, **rated to 60 V input**, ≥ 1 A | The power box's 5 V (pod, buffer, ACS712, transceiver). 60 V because the TVS (4.1b) lets ~39 V through a load dump; MP1584 (28 V) and LM2596 (40 V) modules are not enough. Relay coils are 12 V now. | Jumia / Nerokas (or on the power board, §9) | est. 800–1,500 | Check listing |
| 4.1b | SMCJ33CA TVS diode, B560C Schottky (reverse polarity; also the buck's catch diode), 3 A and 10 A fuses | Input protection of the logic feed (Part 4.8.4) | Pixel / auto-spares | est. 500 | Common |
| 4.2 | Inline blade-fuse holders plus assorted ATO fuses | Separate fuses for the peripheral rail, the actuator rail and the LiDAR | Auto-spares strip | est. 500 | Common |
| 4.3 | Wire: 1.5 mm² and 2.5 mm² automotive, red and black; heat-shrink; crimp ring terminals | Actuator and LiDAR runs | Auto-spares / electrical shops | est. 1,500 | Common |
| 4.4 | **Laptop in-car power**. See note D. | The guide's USB-C PD car charger will not run this laptop under GPU load. | — | — | **Decision needed** |

## 5. Bench rig (Part 4.7, Part 13.3)

| # | Item | Spec that matters | Source | Price (KES) | Status |
|---|---|---|---|---|---|
| 5.1 | Bench 12 V supply, ≥10 A (or a car battery plus charger) | Powers the actuator, LiDAR and hub off-vehicle | Jumia / electrical shops | est. 2,500–5,000 | Common |
| 5.2 | Load cell, 50 kg, with HX711 amplifier | Measures the **applied force** Part 13.3 step 2 logs. Without it, "force" is only inferred from current. | Nerokas (50 kg cell 1,700; HX711 separately) | ~2,000 | Check stock |
| 5.3 | Used brake-pedal assembly (any car) | The "pedal fixture" in Part 13.3 step 1. A real pedal, pivot and return spring. | Used-parts yards | est. 1,000–3,000 | Walk-in |
| 5.4 | Plywood/steel base, brackets, bolts | Rigid mounting so the rig measures the actuator, not the rig flexing | Hardware store | est. 1,500 | Common |
| 5.5 | Multimeter (skip if you own one) | — | K-Technics / Pixel | est. 1,500 | Common |

## 6. Installation (Part 15)

| # | Item | Source | Price (KES) |
|---|---|---|---|
| 6.1 | Adjustable laptop mount (seat-bolt or passenger-side floor pole) | Jumia | est. 3,000–6,000 |
| 6.2 | Windscreen pod glass bracket (small aluminium/steel plate) and **3M VHB tape**; isopropyl alcohol | Fabricator / hardware store | est. 500–1,000 |
| 6.3 | LiDAR roof mount: **3 mm aluminium plate ≥ 100 × 100 mm on a 15° wedge** (Livox: ≥ 3 mm, ≥ 10,000 mm² as heatsink), roof-bar clamps or magnetic base, safety tether. *Designed 2026-10-06:* two plates 130² and 150² (DXF for laser cutting, or drill from the templates), 4 × D43 rubber-coated pot magnets (M6), M3 × 7, 3 × 5 dowels, M4 inserts and screws (`hardware/enclosures/README.md`) | Fabricator (Kariokor / Industrial Area) | est. 3,000–5,000 |
| 6.3b | **3D-printing filament, ASA or PETG, 1 kg** (never PLA: softens at ~55 °C) and printing time | Pod, power box, gesture puck | Nairobi 3D-printing shops / Jumia | est. 2,500–4,500 |
| 6.3c | Power-box enclosure: ABS junction box ~250 × 150 × 100 mm (IP65), 8 × M16 cable glands, M3/M4 heat-set inserts and screws (amended 2026-10-06: the 150 × 100 × 60 box cannot hold the six relays; parts list in `hardware/enclosures/README.md`) | Holds the printed chassis | Electrical shops | est. 1,500–3,000 |
| 6.4 | Add-a-fuse tap for the switched ACC circuit | Auto-spares strip | est. 300 |
| 6.5 | Cable ties, split loom, trim tools | Auto-spares strip | est. 800 |

---

## 7. Import order: bundle it into one shipment

Four items were not found in any Kenyan shop: the **Mid-360 (2.7)**, its **cable (2.8)**, the
**BNO085 (2.1)**, and, depending on note B, the **actuator (3.3)**. Put them in **one** order.
*(2026-09-30: add the M12 board camera (2.6b) to it. The PCBs of §9 come from the board house as a
separate parcel; order them early enough to clear customs with the rest if possible.)* Duty and
clearing costs are per consignment, so four separate parcels cost roughly four times as much to clear.

Rough landed cost for the Mid-360 bundle, assuming ≈ US$810 CIF and an exchange rate of about
129 KES/USD:

| Charge | Basis | Approx. |
|---|---|---|
| Import duty | 0–25 % of CIF depending on how KRA classifies a LiDAR; assume the worst case | up to US$200 |
| IDF | 2.5 % of CIF | US$20 |
| RDL | 2 % of CIF | US$16 |
| VAT | 16 % of (CIF + duty + IDF + RDL) | ~US$168 |
| **Landed** | | **≈ US$1,050–1,220 → KES 135k–157k** |

**Get a written quote from a clearing agent before paying for anything.** A university purchase order
can sometimes qualify for education duty relief. Ask your department before you order, not after the
parcel is held at customs.

DJI's own store returned "not available in your country/region" when fetched on 2026-09-24. Verify from
Kenya. If it holds, buy from an authorised Livox reseller that ships to Kenya, and confirm it is a
genuine unit with a serial number. The Mid-360's default IP is derived from that serial number.

## 8. Budget summary

| Block | Approx. KES |
|---|---|
| Hub + sensors bought locally (§1, §2 excl. 2.1/2.7/2.8; ELM327/HC-05 now fallback only) | 15,000 – 26,000 |
| Actuation + safety, excluding the actuator (§3) | 5,500 – 9,500 |
| Power, excluding the laptop solution (§4) | 3,000 – 4,000 |
| Bench rig (§5) | 8,000 – 13,000 |
| Installation, including the pod bracket, LiDAR wedge plate and enclosures (§6) | 10,000 – 18,000 |
| **Local subtotal** | **≈ 41,000 – 71,000** |
| Import bundle (§7), dominated by the LiDAR (+ the M12 camera) | ≈ 140,000 – 170,000 |
| Custom PCBs, assembled by the fab, and their shipping (§9) | ≈ 30,000 – 61,000 |
| Actuator + laptop power | open, see notes B and D |
| **Total** | **≈ 210,000 – 303,000**, plus the notes B/D items |

*Amended 2026-09-30:* the two-box hub adds about KES 25,000–50,000 over the single-box estimate
(≈ 170,000–220,000): the F405 board, cable and connectors, automotive relays, protection parts,
enclosures and the two custom PCBs. It removes the ELM327, HC-05, level shifters and relay module.

The LiDAR is about three-quarters of the budget. If that is a problem, raise it with your supervisor
**before** buying. Dropping it breaks Part 8, the near-field ground model in Part 11.4, and the
guide's headline navigation-precision objective. It is not a cheap substitution.

---

## 9. Custom PCBs (Phase 12B, `BUILD_GUIDE.md` Part 4.8)

Estimates for version 1, made 2026-09-30; get a quote from the board house's online calculator
before ordering.

| # | Item | Notes | Est. |
|---|---|---|---|
| 9.1 | Pod board, 4-layer, 70 × 53 mm, ×5 | Four layers for a solid ground under the GNSS and IMU | US$15–35 |
| 9.2 | Power board, 2-layer, 2 oz copper, 95 × 66 mm, ×5 | 2 oz for the actuator and relay currents | US$10–25 |
| 9.3 | **Assembly by the fab** (JLCPCB PCBA; PCBWay alike), **2 of each board**: the parts (bought by the fab, matched from `hardware/<board>/fab/<board>-jlc-bom.csv`, every line with its part number: §10), setup, stencil, "extended part" fees, through-hole assembly (terminals, DB-25, fuse holders, headers, C20, U5) | Decided 2026-10-16: boards arrive assembled. Parts the fab does not stock (some connectors) are bought through its global sourcing or sent to it; the quote shows which | US$150–300 |
| 9.4 | Spares for repair: STM32F405RGT6, TPS54360DDAR, AO3400A ×5, SS14 ×5, mini blade fuses 3 A ×10 | Bought with the order | US$20–30 |
| 9.5 | Courier to Kenya and duty/VAT | Express courier; duty and VAT on the declared value (higher for assembled boards) | US$40–80 |
| | **Total** | at ~129 KES/US$ | **≈ KES 30,000 – 61,000** |

The BNO085 and NEO-M8N stay as breakouts on standoffs in version 1 (2.1, 2.2); the BTS7960 and
ACS712 stay as modules on the power board (3.1, 3.2). Only the parts that were never the risk go
onto the boards themselves.

---

## 10. PCB parts list (Rev 1.1, assembled by the fab)

*Changed 2026-10-16:* the boards are ordered **assembled by the fab**. The fab buys and fits these
parts from `hardware/<board>/fab/<board>-jlc-bom.csv` (made from `hardware/gen/sourcing.py`, the
same part numbers as below); this list is what to check its matches against, and what to buy for
repairs. Every part below fits the footprint on the board; **a substitute must have the same package
and ratings**. A different package will not fit its pads. Quantities are **per board**; for two
assembled boards of each, buy ×2 and add spares (10 % on passives, which come in strips of 10–50;
one spare of each IC). Generated from the boards' own BOMs (`hardware/<board>/fab/<board>-bom.csv`,
2026-10-11). Sources: LCSC, Mouser or DigiKey (§9.3); "e.g." parts are examples of the right type.

**Common passives (both boards):** resistors 0805, 1 %, 1/8 W, thick film (e.g. Yageo RC0805FR-07…);
capacitors 0805/1206/1210 MLCC, X7R or X5R unless C0G is stated, voltage as listed.

### 10.1 Pod board (70 × 53 mm)

| Refs | Qty | Part | Fits footprint | Notes |
|---|---|---|---|---|
| U1 | 1 | **STM32F405RGT6** | LQFP-64 10×10, 0.5 mm | |
| U3 | 1 | **AP2112K-3.3TRG1** (3.3 V LDO, 600 mA) | SOT-23-5 | |
| U4 | 1 | **USBLC6-2SC6** (USB ESD) | SOT-23-6 | |
| Y1 | 1 | 8.000 MHz crystal, HC-49/US **SMD**, load capacitance **12 pF**, ≤ 50 ppm | HC49-SD | 12 pF to suit C12/C13 = 15 pF |
| J1 | 1 | **GCT USB4105-GF-A** (USB-C, 16-pin) | USB4105 | |
| J7 | 1 | DB-25 **female**, right-angle PCB, through-hole, 2.77 × 2.84 mm pitch, **4.94 mm** front-face-to-pin offset, board locks (e.g. TE 2311766-1, Norcomp 178-025 series) | DSUB-25 socket, EdgePinOffset 4.94 mm | **check the 4.94 mm offset on the datasheet** before buying |
| SW1, SW2 | 2 | **Panasonic EVQP7C01P** (side-push tactile) | SW_SPST_EVQP7C | distributors list it as 3.5 × 2.9 mm |
| J2 | 1 | 1×6 **female** socket, 2.54 mm (e.g. Sullins PPTC061LFBN-RC) | PinHeader 1×06 | the BNO085 breakout plugs in (§10.3) |
| J3, J5 | 2 | 1×5 male pin header, 2.54 mm | PinHeader 1×05 | leads to GNSS / ST-Link |
| J6 | 1 | 1×4 male pin header, 2.54 mm | PinHeader 1×04 | fallback HC-05 only |
| J8 | 1 | 1×1 male pin, 2.54 mm (cut from a strip) | PinHeader 1×01 | optional IMU reset wire |
| J4 | 1 | **JST SM05B-GHS-TB(LF)(SN)** + mating GHR-05V-S housing and crimped leads | JST GH 5-pin | gesture puck cable |
| D1, D2 | 2 | **SS14** (1 A 40 V Schottky) | SMA | |
| D3 / D4 / D5 / D6 | 1 each | 0805 LEDs: green / blue / amber / red (e.g. Kingbright APT2012SGC, -QBC/D, -SYCK, -SURCK) | LED 0805 | **D4 blue: see note below** |
| C1 / C2 | 1 / 1 | 1 µF 50 V X7R / 4.7 µF 25 V X5R | 1206 | Samsung CL31B105KBHNNNE / CL31A475KAHNNNE; no larger: USB attach inrush (`hardware/sim/run_pod_supply.sh`, 2026-10-16) |
| C7 | 1 | 4.7 µF 25 V X5R | 1206 | |
| C3–C6, C9, C14, C65 | 7 | 100 nF 50 V X7R | 0805 | e.g. CL21B104KBCNNNC |
| C8 | 1 | 1 µF 25 V X7R | 0805 | |
| C10, C11 | 2 | 2.2 µF 16 V X7R, low ESR | 0805 | the MCU's VCAP pins: ceramic only |
| C12, C13 | 2 | 15 pF 50 V **C0G** | 0805 | crystal load |
| C15 | 1 | 4.7 nF 100 V X7R | 0805 | USB shield |
| C54, C57, C60 | 3 | 10 nF 50 V X7R | 0805 | |
| R30–R33, R40–R48, R50–R52, R55, R58, R64 | 19 | 1 kΩ | 0805 | |
| R1, R53, R56, R59, R62 | 5 | 10 kΩ | 0805 | |
| R2, R3 | 2 | 5.1 kΩ | 0805 | USB-C CC |
| R4 / R66 | 1 / 1 | 1 MΩ / 100 kΩ | 0805 | |
| R5, R6 / R7, R8 | 2 / 2 | 4.7 kΩ / 2.2 kΩ | 0805 | I2C pull-ups |
| R49 / R61, R63 | 1 / 2 | 330 Ω / 100 Ω | 0805 | |
| H1–H4 | 4 | M3 × 6 mm standoffs and screws | 3.2 mm hole | |

**Note on D4 (LINK, blue):** it is driven from a 3.3 V pin through 1 kΩ, and a blue LED needs about
2.9–3.2 V, so it will glow faintly at best. Either buy a blue LED rated **≤ 2.8 V at 1 mA**, or fit
any other colour (the silkscreen says "LINK", not a colour).

### 10.2 Power board (95 × 66 mm, order with 2 oz copper)

| Refs | Qty | Part | Fits footprint | Notes |
|---|---|---|---|---|
| U1 | 1 | **TPS54360DDAR** (60 V 3.5 A buck) | SO-8 PowerPAD (DDA) | solder its thermal pad |
| L1 | 1 | **Bourns SRR1260-8R2Y** (8.2 µH) | SRR1260 | Isat > 4.5 A |
| U2 | 1 | **AP2112K-3.3TRG1** | SOT-23-5 | |
| U3 | 1 | **SN74HCT244DWR** | SOIC-20 **wide** (7.5 mm) | HCT, not HC |
| U4 | 1 | **SN65HVD230DR** | SOIC-8 | |
| U5 | 1 | **PC817** (e.g. Sharp PC817X) | DIP-4 | |
| Q2–Q7 | 6 | **AO3400A** (30 V N-MOSFET) | SOT-23 | |
| Q8 | 1 | **2N7002** | SOT-23 | |
| D10 | 1 | **SMCJ33CA** (TVS, bidirectional, 33 V) | SMC | not the 24 V part: see BUILD_GUIDE 4.8.4 |
| D11, D13 | 2 | **B560C-13-F** (5 A 60 V Schottky) | SMC | |
| D14–D19 | 6 | **SS14** | SMA | flyback |
| D20 | 1 | **NUP2105LT1G** (CAN ESD) | SOT-23 | |
| D21 | 1 | **1N4148W-7-F** | SOD-123 | |
| D12 | 1 | green LED (e.g. Kingbright APT2012SGC) | LED 0805 | |
| F1, F3 | 2 | **Keystone 3568** mini-blade fuse holder + **3 A mini-blade (ATM) fuses** | Keystone 3568 | buy spare fuses |
| F2 | 1 | 500 mA polyfuse, ≥ 6 V (e.g. Bourns MF-NSMF050-2) | 1206 | |
| J1 | 1 | DB-25 female, same part as the pod's J7 | as pod J7 | |
| J2, J3, J5–J10 | 8 | **Phoenix MKDS 1,5/2-5,08** (1715721) | MKDS 2-pin 5.08 | |
| J11 | 1 | **Phoenix MKDS 1,5/3-5,08** (1715734) | MKDS 3-pin | |
| J4 | 1 | **Phoenix MKDS 1,5/6-5,08** (1715763) | MKDS 6-pin | |
| J13 / J14 / J12 | 1 / 1 / 1 | male pin headers 1×8 / 1×3 / 1×4, 2.54 mm | PinHeader | leads to the modules |
| C20 | 1 | 47 µF **63 V** aluminium, Ø 8 mm, 3.5 mm pitch, 105 °C (e.g. Panasonic EEU-FR1J470) | CP radial 8 mm | |
| C21, C22 | 2 | 2.2 µF **100 V** X7R (e.g. Murata GRM32ER72A225KA35L) | 1210 | the converter's input |
| C24, C25 | 2 | 47 µF 16 V X5R (e.g. Murata GRM32ER61C476KE15L) | 1210 | the converter's output |
| C23, C31, C32 | 3 | 100 nF 50 V X7R | 0805 | |
| C26 / C27 | 1 / 1 | 6.8 nF 50 V X7R / 39 pF 50 V **C0G** | 0805 | compensation |
| C28–C30 | 3 | 10 µF 25 V X5R | 1206 | |
| R47, R50–R61 | 13 | 10 kΩ | 0805 | |
| R41 / R42 / R43 | 1 each | 523 kΩ / 84.5 kΩ / 162 kΩ, **1 %** | 0805 | converter EN and frequency |
| R44 / R45 / R46 | 1 each | 53.6 kΩ / 10.2 kΩ / 13.0 kΩ, **1 %** | 0805 | converter feedback, compensation |
| R40 / R48 / R62 / R63 | 1 each | 4.7 kΩ / 20 kΩ / 100 kΩ / 4.7 kΩ | 0805 | R63 4.7 kΩ, not 2.2 kΩ: a 24 V jump-start (`hardware/sim/run_brake.sh`, 2026-10-16) |
| H1–H4 | 4 | M3 standoffs and screws | 3.2 mm hole | |

### 10.3 Modules and breakouts: how they connect (pin orders checked 2026-10-11)

| Board header | Module | Connection | Checked against |
|---|---|---|---|
| Pod **J2** | BNO085 breakout, **Adafruit 4754** (2.1) | **Plugs straight in**, face up, body over the board: J2 is its JP1 row pin for pin (VIN, 3Vo, GND, SCL, SDA, INT; 3Vo left open). Solder a **male** header on its JP1 row only. Its RST (JP2 pin 4) to pod **J8** by an optional wire. | Adafruit's board file (Adafruit-BNO085-PCB, JP1/JP2 pad nets) |
| Pod J3 | NEO-M8N board (2.2) | A 4-wire lead, **matching names**: the board's labels are the module's (VCC, GND, TX, RX). These boards' 4-pin headers come in different orders and most have **no PPS pin**: J3's PPS stays free unless yours has one. Takes 3–5 V. | sellers' listings (orders differ) |
| Pod J6 | HC-05 (2.4, fallback) | A lead, matching names; **J6's VCC is the pod's 5 V** (the HC-05 board needs 3.6–6 V); RXD/TXD are 3.3 V logic. | HC-05 (ZS-040) listings |
| Power J13 | BTS7960 / IBT-2 (3.1) | 8-wire lead, **pin for pin**: RPWM, LPWM, R_EN, L_EN, R_IS, L_IS, VCC, GND, the standard IBT-2 order. Check your board's silkscreen: one seller lists another order. | Handsontec IBT-2 datasheet |
| Power J14 | ACS712-20A (3.2) | 3-wire lead, matching names (VCC, OUT, GND); clones order these differently. | sellers' listings (orders differ) |
| Power J12 | HX711 (5.2, bench) | 4-wire lead, matching names (VCC, DT, SCK, GND); orders differ between boards. | sellers' listings (orders differ) |

## Notes

**A. 3.3 V logic against 5 V modules.** *(2026-09-30: now solved by the power board's 74HCT244,
whose TTL input threshold of 2.0 V reads 3.3 V logic correctly; the reasoning below still applies.)* The STM32 drives 3.3 V. Most BTS7960 boards put a 74HC-family
buffer in front of the IC, powered at 5 V, and that buffer needs about 3.5 V to see a logic "high".
3.3 V sits just below that line, so the output works on some boards and fails on others. Opto-isolated
relay boards have the reverse problem: with the input driven to 3.3 V, the opto LED can stay partly
lit, so the relay chatters or never fully releases. On a brake PWM line, "works on some boards" is
not acceptable. Put a level converter on every output that goes to these modules.

**B. The brake actuator: do not buy the obvious one.** The local listings (Nerokas 900 N lead-screw
actuator, Jumia generic 12 V actuators) are all **lead-screw** designs. Three problems follow, and
each one conflicts with the guide's hard rule:

1. **A lead screw is not back-drivable.** When power is cut, it stays wherever it stopped. If it is
   rigidly linked to the pedal, a kill-switch cut or watchdog release leaves the brake **applied**.
   That is the exact opposite of "defaults released on any fault."
2. **900 N is well above a driver's push.** A rigid linkage at that force can out-force the driver.
3. **It is too slow.** These actuators move at 5–15 mm/s, so pressing a pedal 40 mm takes 3–8 s. That
   is useless for a TTC-triggered brake.

A design direction worth taking to your supervisor, not a decision made here:
- a **pull-only coupling**: a cable or strap that can pull the pedal down but goes slack if the driver
  presses further, so the pedal linkage can never be blocked;
- a **fail-safe release in that cable**: for example, a 12 V holding electromagnet powered through the
  kill-switch relay (3.5). If power is lost for any reason, the cable drops free. Its rated holding
  force also becomes a **mechanical force ceiling** that no firmware bug can exceed. That would be a
  third ceiling after the arbiter and `kMaxSafeIntensity`;
- a **faster, lower-force actuator**, around 50–100 mm/s and 100–200 N, which on a boosted brake is
  already enough for firm braking. These are mostly import items (AliExpress "high speed linear
  actuator"), so fold one into the §7 bundle once the design is agreed.

Measure the chosen design on the §5 rig, per Part 13.3, before anything else depends on it.

**C. Brake-pedal detection.** Part 3.1's `obdBrakePedalActive` comes from an OBD PID that many cars do
not expose. In that case it reads `0xFF` and the arbiter cannot tell whether the driver is already
braking. Tapping the brake-light switch through an optocoupler (3.7) works on every car and is
galvanically isolated from the vehicle wiring. This is a suggested addition to Part 4.2, not a change
made yet.

**D. Laptop power.** A laptop with an RTX 5060 and a Core Ultra 7 275HX ships with a roughly 200–280 W
barrel-jack adapter. A 100–140 W USB-C PD car charger (Part 15.2 step 8) cannot keep up under
inference load, so the battery drains during a drive. Options:
- a **300 W+ pure-sine inverter** wired to the battery through its own fuse, running the laptop's own
  adapter (a cigarette-lighter socket is usually fused at 10–15 A, which is too little);
- accept **battery-only** runs for the short Stage B–D test windows, and charge between runs.
Either way, record it in `decisions.md` when Phase 15 arrives. The second option costs nothing and
may be sufficient.
