kiogimwenda/AR_Windscreen/hardware/power_board/power_board_bom.csv

Reference | Value | Footprint | QUANTITY | Description
C20 | 47u 63V | Capacitor_THT:CP_Radial_D8.0mm_P3.50mm | 1 | bulk: damps the harness inductance
C21,C22 | 2.2u 100V | Capacitor_SMD:C_1210_3225Metric | 2
C23,C31,C32 | 100n | Capacitor_SMD:C_0805_2012Metric | 3
C24,C25 | 47u | Capacitor_SMD:C_1210_3225Metric | 2
C26 | 6800p | Capacitor_SMD:C_0805_2012Metric | 1
C27 | 39p | Capacitor_SMD:C_0805_2012Metric | 1
C28-C30 | 10u | Capacitor_SMD:C_1206_3216Metric | 3
D10 | SMCJ33CA | Diode_SMD:D_SMC | 1 | fast-transient clamp, above the 35 V suppressed load dump (bidirectional: survives reversed leads)
D11,D13 | B560C | Diode_SMD:D_SMC | 2 | catch diode,reverse-polarity protection: 60 V, 5 A; ~0.6 V drop, ~1 W at 2 A
D12 | green | LED_SMD:LED_0805_2012Metric | 1
D14-D19 | SS14 | Diode_SMD:D_SMA | 6 | flyback
D20 | NUP2105L | Package_TO_SOT_SMD:SOT-23 | 1 | CAN bus ESD
D21 | 1N4148W | Diode_SMD:D_SOD-123 | 1 | reverse protection for the opto LED
F1,F3 | 3A | Fuse:Fuseholder_Blade_Mini_Keystone_3568 | 2 | LiDAR feed
F2 | 500mA | Fuse:Fuse_1206_3216Metric | 1 | the pod's supply up the cable
H1-H4 | M3 | MountingHole:MountingHole_3.2mm_M3 | 4
J1 | DB-25 to pod | Connector_Dsub:DSUB-25_Socket_Horizontal_P2.77x2.84mm_EdgePinOffset4.94mm_Housed_MountingHolesOffset4.94mm | 1 | shield (shell) bonded to ground at this end only
J2 | 12 V ACC in | TerminalBlock_Phoenix:TerminalBlock_Phoenix_MKDS-1,5-2-5.08_1x02_P5.08mm_Horizontal | 1 | switched ACC (ignition) feed; its own fuse at the car's fuse box too
J3 | LiDAR 12 V out | TerminalBlock_Phoenix:TerminalBlock_Phoenix_MKDS-1,5-2-5.08_1x02_P5.08mm_Horizontal | 1
J4 | Relay coils | TerminalBlock_Phoenix:TerminalBlock_Phoenix_MKDS-1,5-6-5.08_1x06_P5.08mm_Horizontal | 1 | five 12 V automotive relays in sockets; coil common to +12V
J5 | Actuator 12 V from kill relay | TerminalBlock_Phoenix:TerminalBlock_Phoenix_MKDS-1,5-2-5.08_1x02_P5.08mm_Horizontal | 1 | the 40 A kill relay's contacts (BOM 3.5); its coil via the E-stop (J8)
J6 | BTS7960 B+ / B- | TerminalBlock_Phoenix:TerminalBlock_Phoenix_MKDS-1,5-2-5.08_1x02_P5.08mm_Horizontal | 1 | the module's motor supply, from the kill relay
J7 | Cable magnet | TerminalBlock_Phoenix:TerminalBlock_Phoenix_MKDS-1,5-2-5.08_1x02_P5.08mm_Horizontal | 1 | 12 V holding magnet; powered only through the kill relay
J8 | Kill relay coil feed | TerminalBlock_Phoenix:TerminalBlock_Phoenix_MKDS-1,5-2-5.08_1x02_P5.08mm_Horizontal | 1 | +12V -> E-stop NC contact -> 40 A relay coil -> GND (off-board wiring)
J9 | E-stop sense contact | TerminalBlock_Phoenix:TerminalBlock_Phoenix_MKDS-1,5-2-5.08_1x02_P5.08mm_Horizontal | 1 | E-stop second contact block, NC: closed (released) pulls KILL_SENSE low
J10 | Brake-light switch | TerminalBlock_Phoenix:TerminalBlock_Phoenix_MKDS-1,5-2-5.08_1x02_P5.08mm_Horizontal | 1
J11 | OBD-II lead | TerminalBlock_Phoenix:TerminalBlock_Phoenix_MKDS-1,5-3-5.08_1x03_P5.08mm_Horizontal | 1 | J1962 pin 6 CAN_H, pin 14 CAN_L, pins 4/5 ground; ~0.5 m
J12 | Bench: HX711 | Connector_PinHeader_2.54mm:PinHeader_1x04_P2.54mm_Vertical | 1 | load-cell amplifier on the bench rig only
J13 | BTS7960 module | Connector_PinHeader_2.54mm:PinHeader_1x08_P2.54mm_Vertical | 1 | module header: RPWM LPWM R_EN L_EN R_IS L_IS VCC GND (R_EN and L_EN tied)
J14 | ACS712 module | Connector_PinHeader_2.54mm:PinHeader_1x03_P2.54mm_Vertical | 1
L1 | 8.2u | Inductor_SMD:L_Bourns_SRR1260 | 1 | SRR1260-8R2Y or similar, Isat > 4.5 A
Q2-Q7 | AO3400A | Package_TO_SOT_SMD:SOT-23 | 6
Q8 | 2N7002 | Package_TO_SOT_SMD:SOT-23 | 1
R40,R63 | 4.7k | Resistor_SMD:R_0805_2012Metric | 2 | ~2.3 mA LED current at 12 V; 4.7k keeps a 24 V jump-start within 0805
R41 | 523k | Resistor_SMD:R_0805_2012Metric | 1 | UVLO: start 8 V
R42 | 84.5k | Resistor_SMD:R_0805_2012Metric | 1 | UVLO: stop 6.25 V
R43 | 162k | Resistor_SMD:R_0805_2012Metric | 1 | 600 kHz
R44 | 53.6k | Resistor_SMD:R_0805_2012Metric | 1
R45 | 10.2k | Resistor_SMD:R_0805_2012Metric | 1
R46 | 13.0k | Resistor_SMD:R_0805_2012Metric | 1
R47,R50-R61 | 10k | Resistor_SMD:R_0805_2012Metric | 13 | fail-safe: off when not driven,present = connected AND powered,recessive when not driven,standby (cannot transmit) when not driven,x2/3 divider: nothing above 3.3 V on the cable
R48 | 20k | Resistor_SMD:R_0805_2012Metric | 1
R62 | 100k | Resistor_SMD:R_0805_2012Metric | 1
U1 | TPS54360DDA | Package_SO:TI_SO-PowerPAD-8_ThermalVias | 1 | 60 V, 3.5 A buck
U2 | AP2112K-3.3 | Package_TO_SOT_SMD:SOT-23-5 | 1 | 3.3 V for the CAN transceiver
U3 | 74HCT244 | Package_SO:SOIC-20W_7.5x12.8mm_P1.27mm | 1 | TTL-threshold buffer: 3.3 V logic in, 5 V out to the BTS7960 module
U4 | SN65HVD230 | Package_SO:SOIC-8_3.9x4.9mm_P1.27mm | 1 | beside the OBD lead: the stub on the car's bus is the lead only. No termination.
U5 | PC817 | Package_DIP:DIP-4_W7.62mm | 1
