kiogimwenda/AR_Windscreen/hardware/enclosures/estop/body.stl

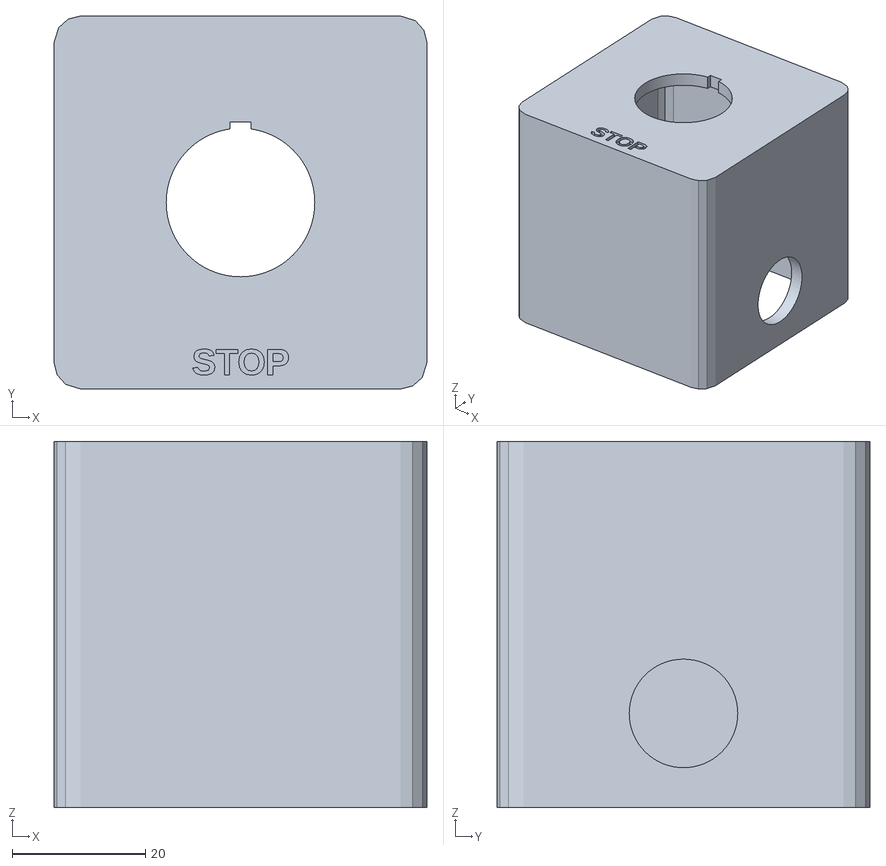
[picture p38: CAD file, 2026-10-16]
hardware/enclosures/estop/body.stl
56.0 x 56.0 x 55.0
