kiogimwenda/AR_Windscreen/hardware/enclosures/gesture_puck/base.stl

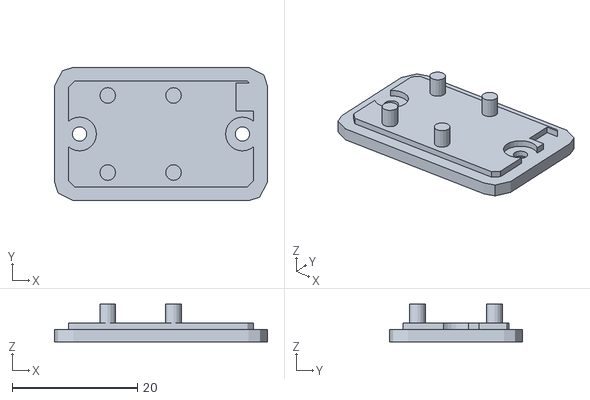
[picture p39: CAD file, 2026-10-16]
hardware/enclosures/gesture_puck/base.stl
34.0 x 21.3 x 6.00
