kiogimwenda/AR_Windscreen/hardware/enclosures/lidar_mount/base_plate_2d.dxf

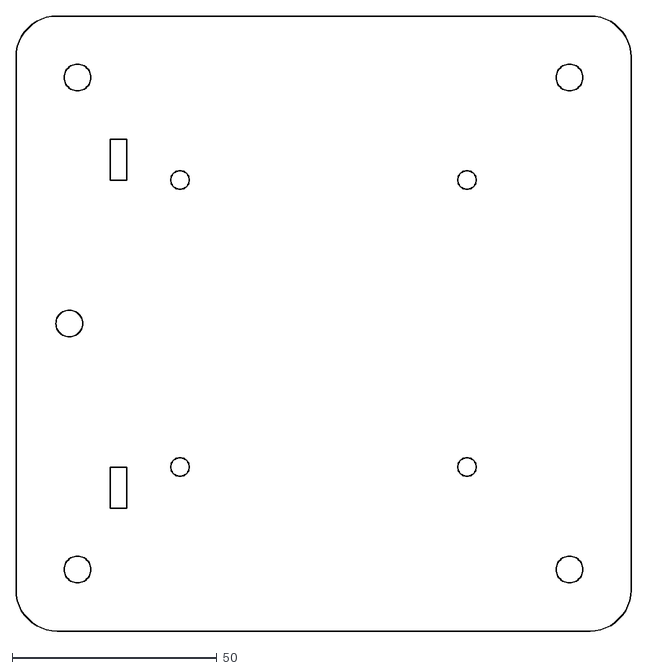
[picture p40: CAD file, 2026-10-07]
hardware/enclosures/lidar_mount/base_plate_2d.dxf
150.0 x 150.0
