kiogimwenda/AR_Windscreen/hardware/enclosures/pod/front_plate.stl

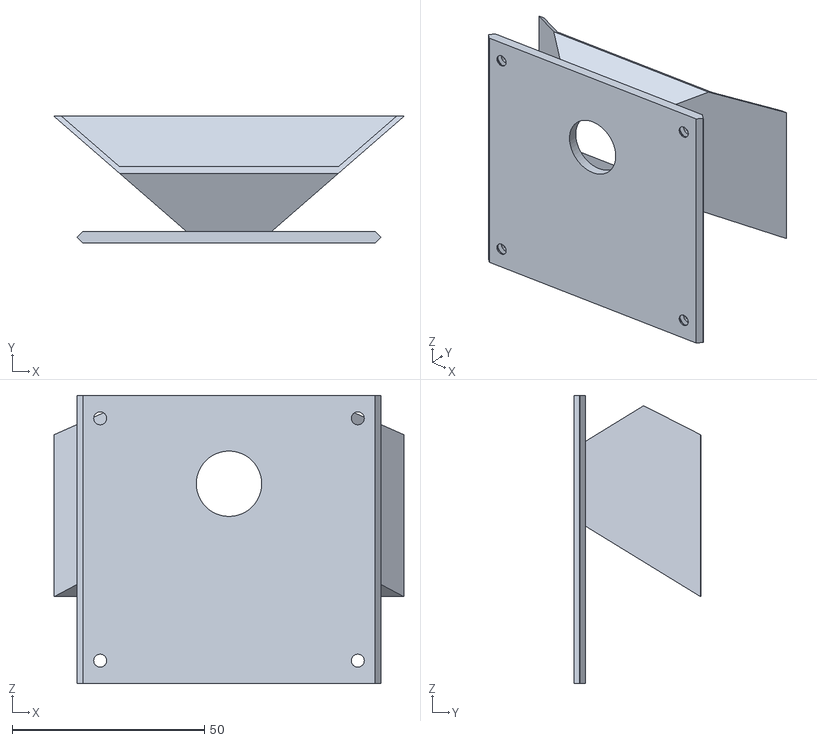
[picture p41: CAD file, 2026-10-16]
hardware/enclosures/pod/front_plate.stl
91.0 x 33.0 x 75.0
