kiogimwenda/AR_Windscreen/hardware/enclosures/power_box/chassis.stl

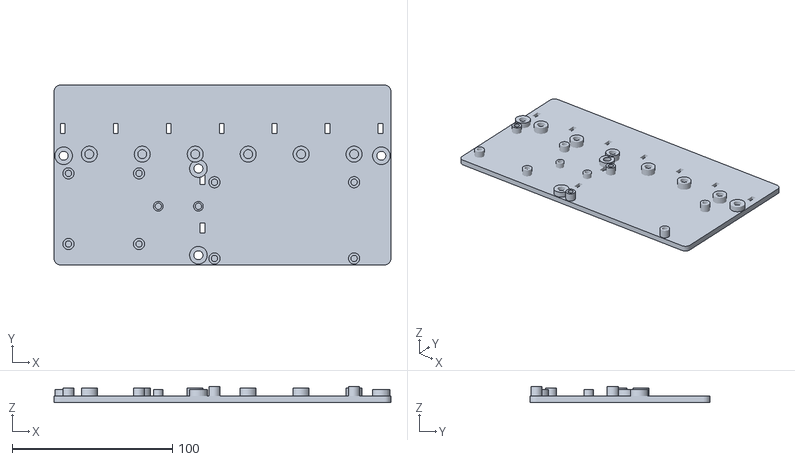
[picture p42: CAD file, 2026-10-11]
hardware/enclosures/power_box/chassis.stl
210.0 x 112.0 x 10.0
