kiogimwenda/AR_Windscreen/hardware/enclosures/estop/base.stl

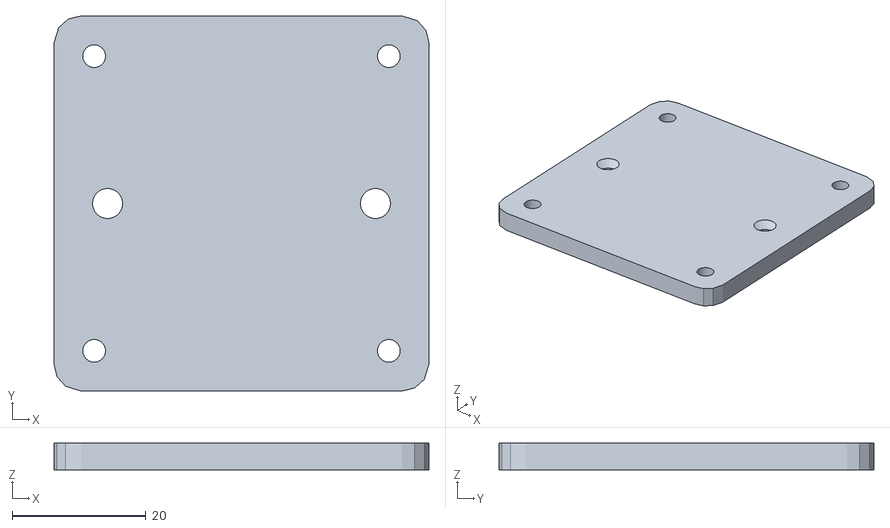
[picture p43: CAD file, 2026-10-16]
hardware/enclosures/estop/base.stl
56.0 x 56.0 x 4.00
