kiogimwenda/AR_Windscreen/hardware/enclosures/gesture_puck/shell.stl

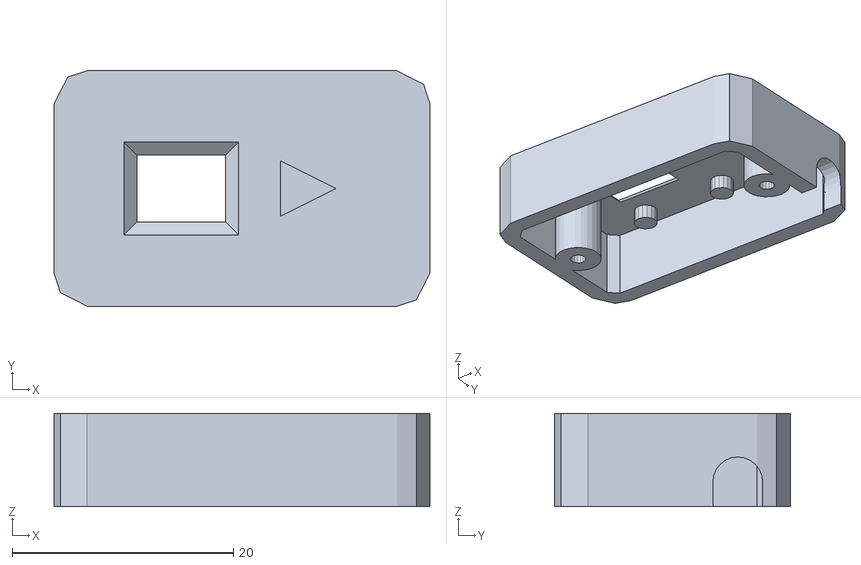
[picture p44: CAD file, 2026-10-16]
hardware/enclosures/gesture_puck/shell.stl
34.0 x 21.3 x 8.45
