kiogimwenda/AR_Windscreen/hardware/enclosures/lidar_mount/top_plate_2d.dxf

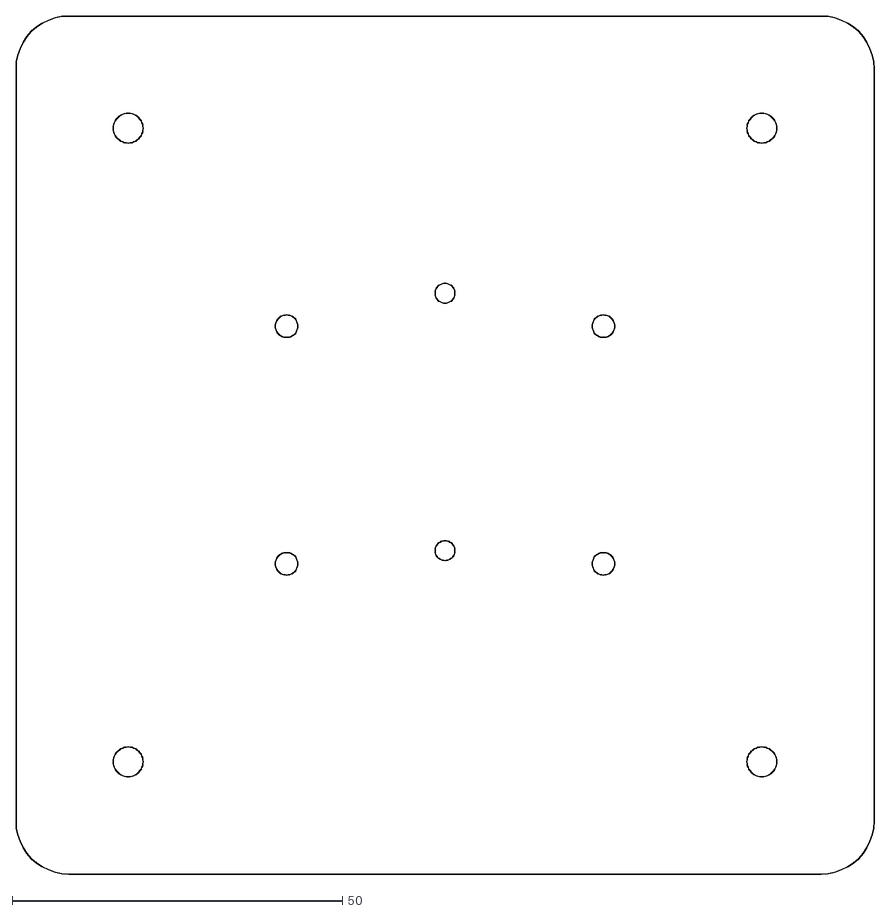
[picture p45: CAD file, 2026-10-07]
hardware/enclosures/lidar_mount/top_plate_2d.dxf
130.0 x 130.0
