kiogimwenda/AR_Windscreen/hardware/enclosures/pod/rail.stl

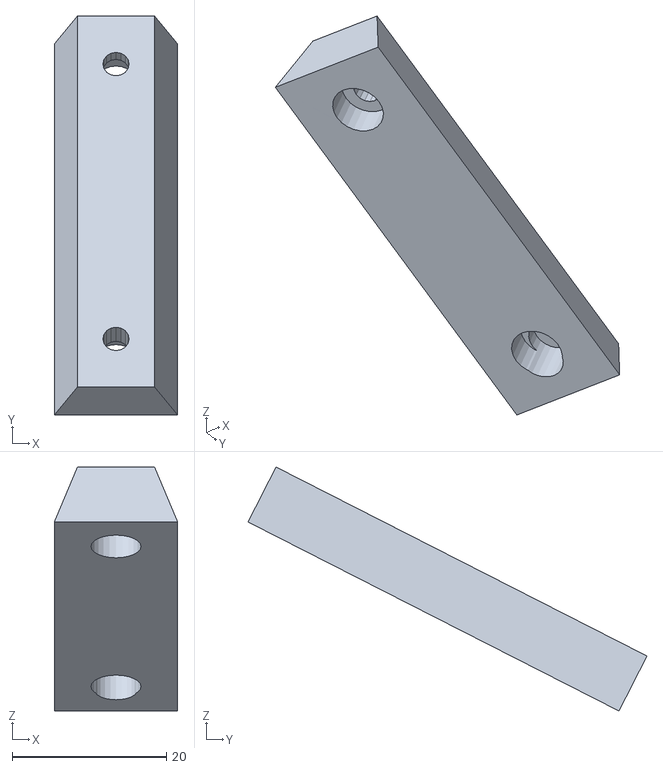
[picture p46: CAD file, 2026-10-16]
hardware/enclosures/pod/rail.stl
16.0 x 51.7 x 31.6
