kiogimwenda/AR_Windscreen/hardware/enclosures/lidar_mount/wedge.stl

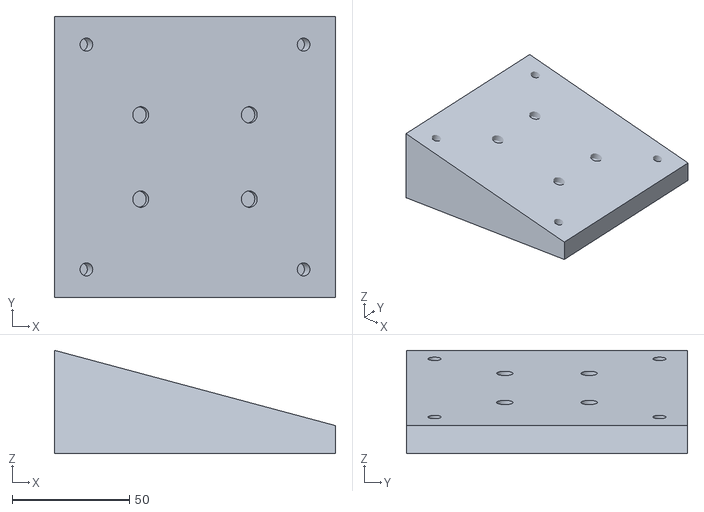
[picture p47: CAD file, 2026-10-07]
hardware/enclosures/lidar_mount/wedge.stl
120.0 x 120.0 x 44.2
