kiogimwenda/AR_Windscreen/hardware/enclosures/pod/front_shell.stl

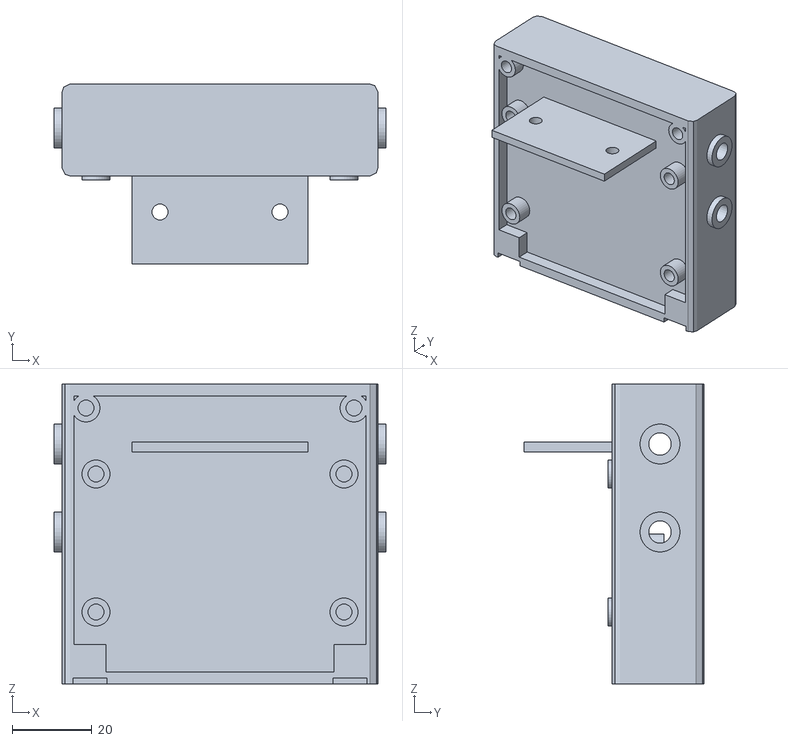
[picture p48: CAD file, 2026-10-16]
hardware/enclosures/pod/front_shell.stl
83.0 x 45.0 x 75.0
