kiogimwenda/AR_Windscreen/hardware/enclosures/pod/rear_cover.stl

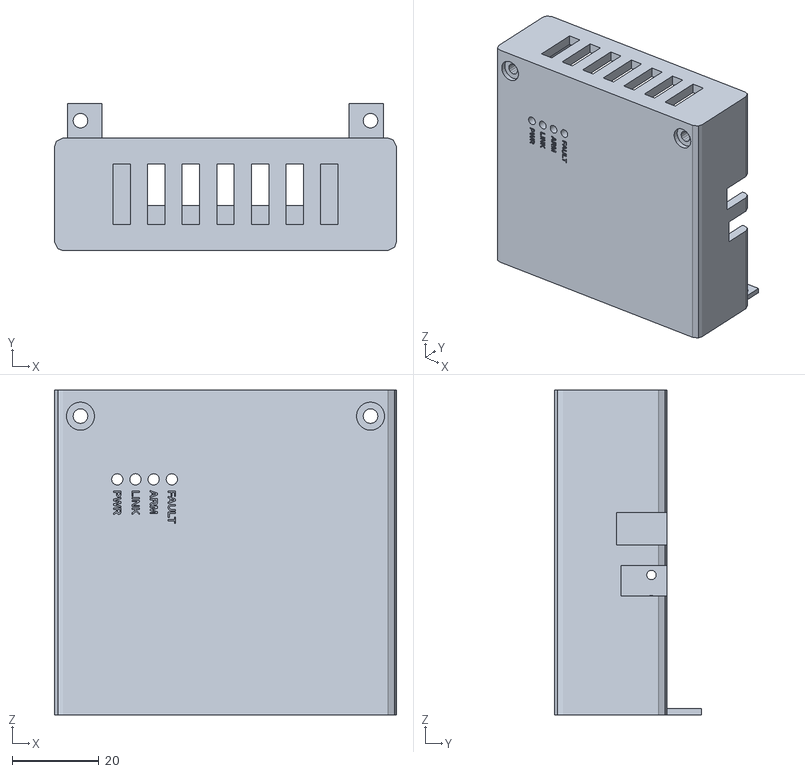
[picture p49: CAD file, 2026-10-16]
hardware/enclosures/pod/rear_cover.stl
79.0 x 34.0 x 75.0
