kiogimwenda/AR_Windscreen/hardware/enclosures/pod/cradle.stl

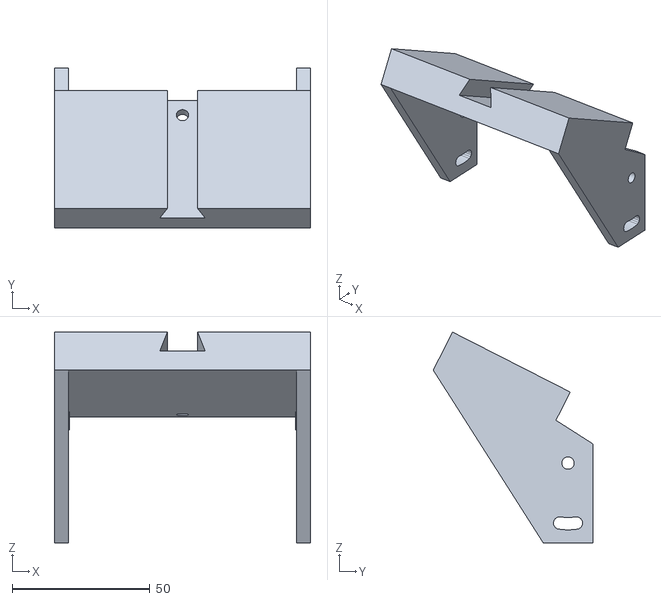
[picture p50: CAD file, 2026-10-16]
hardware/enclosures/pod/cradle.stl
93.0 x 58.0 x 76.6
