kiogimwenda/AR_Windscreen/hardware/enclosures/common/boards.scad

// Generated by hardware/gen/outlines.py: do not edit; change the board there.
// Board origin: top-left corner, x right, y DOWN (KiCad). Units: mm.

pod_board = [70.0, 53.0, 1.6];  // w, h, thickness
pod_board_r = 2.0;
pod_board_holes = [[4.0, 4.0], [66.0, 4.0], [4.0, 38.5], [66.0, 38.5]];
pod_board_keeps = [[8.5, 39.0, 53.0, 14.0], [60.5, 8.0, 9.5, 11.0], [8.0, 0.5, 17.0, 3.0], [0.5, 7.5, 6.0, 25.5], [63.0, 20.0, 7.0, 11.0]];  // x, y, w, h
// pod_board_keeps[0]: DB-25 (J7): flange flush with the bottom edge, centred
// pod_board_keeps[1]: USB-C (J1): flush with the right edge
// pod_board_keeps[2]: Status LEDs D3-D6: top edge, facing the driver
// pod_board_keeps[3]: SWD header (J5) and the RESET/BOOT plungers (SW1, SW2): left edge
// pod_board_keeps[4]: Gesture cable (J4): right edge, below the USB

power_board = [95.0, 66.0, 1.6];  // w, h, thickness
power_board_r = 2.0;
power_board_holes = [[4.0, 4.0], [91.0, 4.0], [4.0, 51.5], [91.0, 51.5]];
power_board_keeps = [[18.5, 0.0, 53.0, 14.0], [0.5, 7.5, 17.5, 16.0], [0.5, 55.0, 83.0, 11.0], [73.0, 7.5, 22.0, 36.0], [0.0, 24.5, 11.0, 23.5]];  // x, y, w, h
// power_board_keeps[0]: DB-25 (J1): flange flush with the top edge
// power_board_keeps[1]: Fuse holders F1, F3: top-left
// power_board_keeps[2]: Car-wiring terminals J8-J11, J4: bottom edge
// power_board_keeps[3]: Actuator terminals J5-J7 + module headers J13, J14: right edge
// power_board_keeps[4]: Input and LiDAR terminals J2, J3: left edge
