kiogimwenda/AR_Windscreen/docs/assembly/README.md

<!-- Generated by hardware/gen/assembly.py from hardware/gen/{power,pod}_board.py. Do not edit: change the board description or the generator, then run it. -->

# Assembly day

Generated from the board descriptions, so a pin or a value here always matches the schematics. In
order:

1. [`db25_cable.md`](db25_cable.md): build and test the inter-box cable, alone.
2. [`power_board_bringup.md`](power_board_bringup.md): the power board, current-limited, then its
   fail-safe state, then each line by hand.
3. [`power_box_wiring.md`](power_box_wiring.md): the box's off-board wiring and its checks.
4. [`pod_board_bringup.md`](pod_board_bringup.md): the pod on USB, flashing, Part 4.7's checks,
   then with the box.
5. [`bench_rig.md`](bench_rig.md): Part 13.3's gate, before any vehicle.

Regenerate after any board change: `python3 hardware/gen/assembly.py` (`--check` in review).
