kiogimwenda/AR_Windscreen/docs/assembly/bench_rig.md

<!-- Generated by hardware/gen/assembly.py from hardware/gen/{power,pod}_board.py. Do not edit: change the board description or the generator, then run it. -->

# Bench rig: setup

BUILD_GUIDE Part 13.3, the mandatory gate before the vehicle. The actuator and a pedal fixture on a
bench, **never in a car**. The run itself is `tools/bench_rig/log_actuator_bench.py checklist`
(it records everything under `bench_runs/`).

1. **Supply:** a 12 V bench supply able to deliver the actuator's stall current (see its
   datasheet; at least 10 A), feeding the power box's battery input (through the 10 A fuse and the
   kill relay, exactly as in the car) and J2 (logic).
2. **Pedal fixture** with the load cell between the actuator's cable and the pedal; the HX711
   amplifier on power board **J12** (pin 1: +5V, pin 2: HX711_DOUT, pin 3: HX711_SCK, pin 4: GND), which
   travels up the cable on pins 23/24.
3. **Pod** on USB to the laptop, running the bench build: `pio run -e bench -t upload`.
4. **E-stop** wired and within reach of the person at the pedal.
5. **Oscilloscope** (once, recommended) on J13 pin 3 (EN_5V): the independent timing of item 5.
6. Before the first sweep: `log_actuator_bench.py selftest`, then `status` shows the load cell
   valid and the hub armed only when expected.
7. Run `log_actuator_bench.py checklist --attempt N` three times on three separate occasions (Part
   13.4 Stage A). **Item 3, the push-back, is the most important check in the project.**
