kiogimwenda/AR_Windscreen/hardware/enclosures/estop/assembly.png

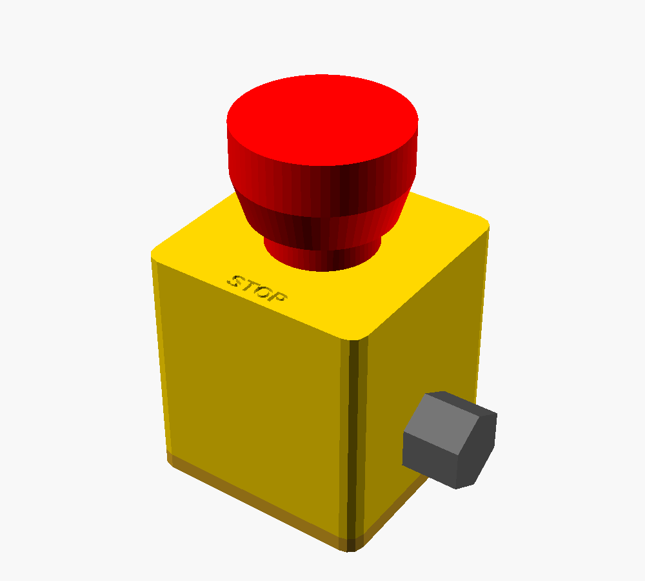
hardware/enclosures/estop/assembly.png
