kiogimwenda/AR_Windscreen/hardware/enclosures/gesture_puck/assembly.png

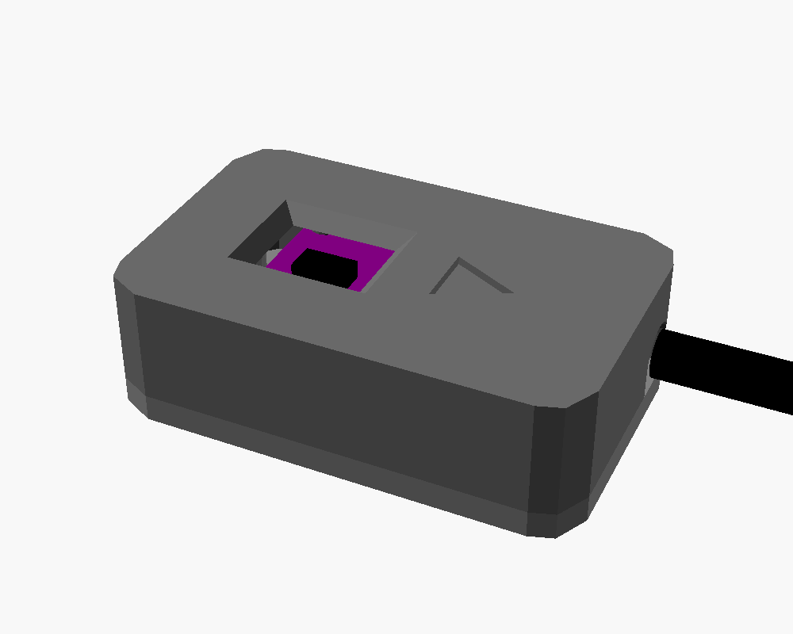
hardware/enclosures/gesture_puck/assembly.png
