kiogimwenda/AR_Windscreen/hardware/enclosures/lidar_mount/assembly.png

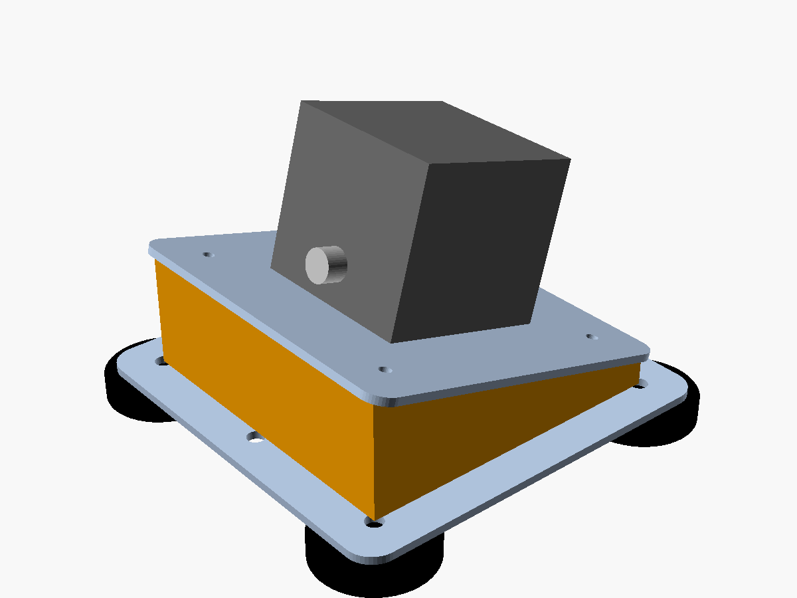
hardware/enclosures/lidar_mount/assembly.png
