kiogimwenda/AR_Windscreen/hardware/enclosures/pod/assembly.png

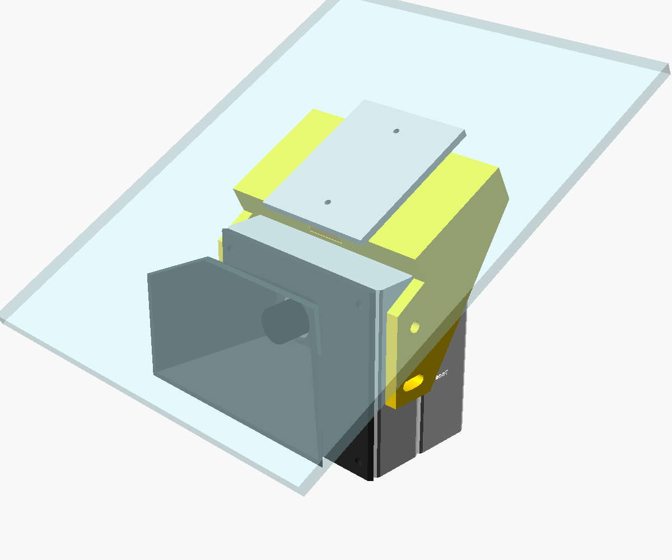
hardware/enclosures/pod/assembly.png
