kiogimwenda/AR_Windscreen/hardware/enclosures/power_box/assembly.png

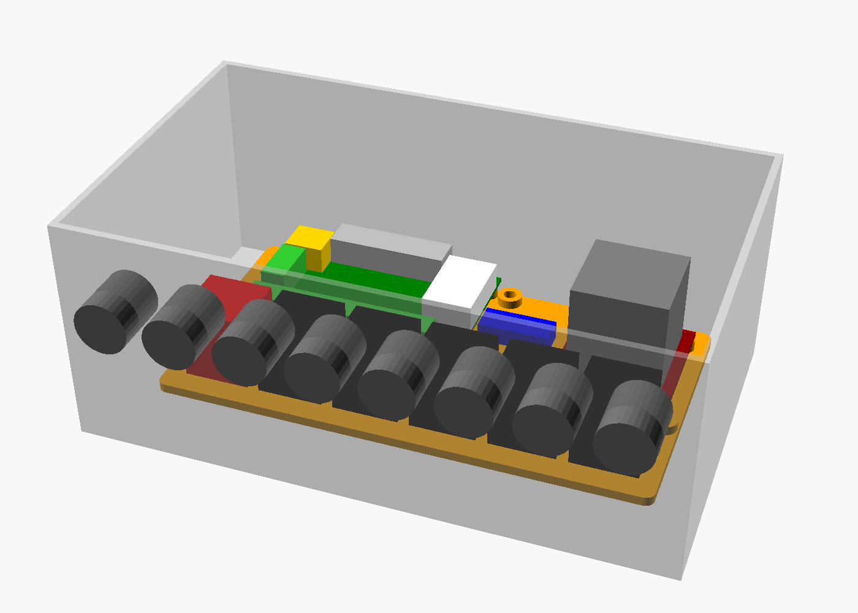
hardware/enclosures/power_box/assembly.png
