kiogimwenda/AR_Windscreen/docs/assembly/pod_board_bringup.md

<!-- Generated by hardware/gen/assembly.py from hardware/gen/{power,pod}_board.py. Do not edit: change the board description or the generator, then run it. -->

# Pod board: bring-up

BUILD_GUIDE Parts 4.7 and 4.8.2. The pod is powered by USB (VBUS through D1) or by the cable's
5 V (through D2); bring it up on **USB through a USB power meter** first, cable unplugged.

## 1. Before power

- Under magnification: U1 (STM32F405, LQFP-64) pin 1 and no bridges; U3 (AP2112K) and U4 (USBLC6)
  orientation; D1/D2 bands; the crystal Y1 and its load capacitors C12/C13.
- Resistance to GND: VIN_POD (C1 +) and +3V3 (C2 +) well above 1 kΩ.

## 2. First power: USB through a power meter

1. USB-C to a USB power meter, then to a charger (not yet the laptop). Expect tens of milliamps;
   over 200 mA means a fault: unplug.
2. **D3** (green, power) lights. +3V3 at C2 +: **3.30 V**. VIN_POD at C1 +: USB's 5 V less D1's
   drop, about 4.7 V.

## 3. Flash

- **ST-Link on J5** (SWD: 3V3, SWDIO, SWCLK, GND, NRST):
  `cd firmware/sensor_actuator_hub && pio run -t upload` (the vehicle build), or
  `pio run -e bench -t upload` for the bench rig (Part 13.3; never in the car).
- **Without an ST-Link, USB DFU:** hold **BOOT** (SW2), press and release **RESET** (SW1), release
  BOOT: the MCU's ROM bootloader enumerates as `0483:df11`. Then
  `dfu-util -a 0 -s 0x08000000:leave -D .pio/build/stm32f4_hub/firmware.bin`.
- Reset. The firmware enumerates as an **ST virtual COM port, `0483:5740`**, which also proves the
  8 MHz crystal runs (Part 4.7: on the internal oscillator USB may not enumerate at all). Attach it
  to WSL2 (`attach_usb_devices.ps1`); it appears as `/dev/ttyACM0`.

## 4. Part 4.7's checks, cable still unplugged

- `SensorReport` at **50 Hz** (`log_actuator_bench.py status`, or the host).
- The cable-side inputs read their fail-safe values (the pod's own pull-ups):

| Pin | Line | Unplugged |
|---|---|---|
| 12 | KILL_SENSE | 3.3 V (10 k pull-up): reads as E-stop **engaged** |
| 13 | BOX_PRESENT | 3.3 V (10 k pull-up): reads as box **absent** (`ignitionOn` 0) |
| 19 | BRAKE_LIGHT | 3.3 V (10 k pull-up): reads as pedal **not pressed** |
| 21 | CAN_RX | 3.3 V (10 k pull-up): recessive: the bus looks idle |

- Hence `killSwitchEngaged = 1`, `ignitionOn = 0`, AckStatus fault **5** (box absent), and nothing
  can be armed.
- The three status LEDs: LINK (blue, D4), ARMED (amber, D5), FAULT (red, D6) as the firmware drives
  them.
- Sensors one at a time, fitted to J2 (IMU), J3 (GNSS), J4 (gesture): each appears in
  `SensorReport` (Part 4.7). **Match each breakout's pin order to the header before fitting**
  (J2/J3 were drawn before the exact breakouts were chosen).

## 5. With the power box

Cable (tested per `db25_cable.md`) between pod J7 and power board J1, the box on its bench supply:
the cable sheet's "once both boards are up" table, then Part 4.7's remaining checks (a relay from a
hand-crafted `ActuationCommand`; release within 200 ms of pulling USB) and the bench rig.
