kiogimwenda/AR_Windscreen/docs/assembly/power_board_bringup.md

<!-- Generated by hardware/gen/assembly.py from hardware/gen/{power,pod}_board.py. Do not edit: change the board description or the generator, then run it. -->

# Power board: bring-up

BUILD_GUIDE Parts 4.7 and 4.8.4. **Nothing connected but the bench supply** until step 6. A bench
supply with a current limit, a multimeter, and (once, step 5) a 3.3 V source through 1 kΩ.

## 1. Before any power: look, then measure

- Under magnification: every IC's pin 1 where the silkscreen says (U1 TPS54360, U2 AP2112K,
  U3 74HCT244, U4 SN65HVD230, U5 PC817), the diodes' bands (D10 is bidirectional; D11, D13-D19, D21
  band to the cathode), no bridges on U1's PowerPAD or U3's pins.
- Resistance to GND, supply off (a short here is found now, not with smoke):

| Net | Measure at | Expect |
|---|---|---|
| +12V | D11 cathode / C20 + | well above 1 kΩ (the UVLO divider R41+R42 is 608 kΩ; C20 charges from the meter at first) |
| +5V | C24 + | well above 1 kΩ (feedback divider R44+R45: 63.8 kΩ) |
| +3V3 | C29 + | well above 1 kΩ |
| 5V_POD | DB-25 pin 1 | the same as +5V (F2 is a polyfuse, a few ohms when cold) |

- The fail-safe resistors, at the DB-25 (J1) pins, supply off:

| Pin | Net | Expect |
|---|---|---|
| 5 | BRAKE_RPWM | 10 kΩ to GND (R50) |
| 7 | BRAKE_LPWM | 10 kΩ to GND (R51) |
| 8 | BRAKE_EN | 10 kΩ to GND (R52) |
| 9 | MAGNET_EN | 10 kΩ to GND (R53) |
| 14 | RELAY_LEFT | 10 kΩ to GND (R54) |
| 15 | RELAY_RIGHT | 10 kΩ to GND (R55) |
| 16 | RELAY_HAZARD | 10 kΩ to GND (R56) |
| 17 | RELAY_HORN | 10 kΩ to GND (R57) |
| 18 | RELAY_BEAM | 10 kΩ to GND (R58) |
| 20 | CAN_TX | 10 kΩ to +3V3 (R59) |
| 22 | CAN_STBY | 10 kΩ to +3V3 (R60) |

## 2. First power: current-limited

1. Bench supply to **J2** (ACC_IN, GND): 12.0 V, current limit **100 mA**.
2. Switch on. The supply must not sit in current limit. Idle current with nothing connected: tens
   of milliamps at most (D12's LED ~2 mA, the buck's own quiescent current and the 5 V dividers).
   If it limits: off, and find the short (step 1 again, then U1's area).
3. **D12** (green) lights: 12 V is through F1 and D11 (D10, the TVS, only clamps to ground).

## 3. Rails

| Rail | Measure at | Expect |
|---|---|---|
| +12V | C20 + | the supply less D11's drop: about 0.3-0.5 V below it at this current |
| +5V | C24 + | **5.00 V** (0.8 V reference x (1 + 53.6k/10.2k)), within 2 % |
| +3V3 | C29 + | 3.30 V (AP2112K-3.3) |
| 5V_POD | DB-25 pin 1 | as +5V |
| LIDAR_12V | J3 pin 1 | as +12V (through F3) |

**Under-voltage lockout** (R41/R42): lower the supply slowly: +5V collapses near **6.25 V**; raise
it: +5V returns near **8 V**. A car's cranking dip must not brown the board out half-way.

## 4. The fail-safe state, with the pod NOT connected

| Check | Measure | Expect |
|---|---|---|
| BTS7960 inputs off | J13 pins 1-3 (RPWM_5V, LPWM_5V, EN_5V) to GND | 0 V |
| Relays off | Q3-Q7 drains (J4 pins 2-6) | 12 V (coils not pulled down) |
| Magnet off | Q2 drain (J7 pin 2, MAG_NEG) | no voltage across J7 |
| CAN silent | U4 pin 8 (Rs) and pin 1 (D) | 3.3 V: standby, recessive |
| Present | DB-25 pin 13, with the 3.3 V source through 10 kΩ on it; supply on / off | near 0 V (Q8 on) / 3.3 V |
| Current sense idle | DB-25 pin 10 to GND, ACS712 module fitted | **1.67 V** (2.5 V zero-current output x0.667) |

## 5. Each pod-driven line, by hand

With the 3.3 V source through 1 kΩ, touch each DB-25 pin in turn (the pull-down holds it low
otherwise):

| Pin | Line | Expect while high |
|---|---|---|
| 14-18 | RELAY_LEFT .. RELAY_BEAM | that relay clicks (fit the relays in their sockets first); the others stay off |
| 9 | MAGNET_EN | 12 V across J7 (an LED + resistor stands in for the magnet) |
| 8 | BRAKE_EN | J13 pin 3 rises to ~5 V |
| 5 | BRAKE_RPWM | J13 pin 1 rises to ~5 V |
| 7 | BRAKE_LPWM | J13 pin 2 rises to ~5 V (**never** used in the car: the drive is one-directional) |
| 22 | CAN_STBY pulled LOW instead (through 1 kΩ to GND) | U4 pin 8 goes low: the transceiver is enabled |

Release each: it returns to off by itself. That is the property the whole split rests on.

## 6. The off-board parts, one at a time

Wire each per `power_box_wiring.md`, and check:
- **Kill chain:** with J8 wired through the E-stop to the 40 A relay coil, the relay pulls in at
  power-up and drops the instant the E-stop is pressed (ACT_12V at J5 goes to 0 V); KILL_SENSE (DB-25
  pin 12) is 0 Ω to GND released and open pressed.
- **Brake light:** 12 V on J10 pulls DB-25 pin 19 low; removing it releases it.
- **BTS7960 and ACS712:** only on the bench rig, with the actuator, through Part 13.3 (`bench_rig.md`).

Then the pod: `pod_board_bringup.md`, and the cable sheet's "once both boards are up" table.
