kiogimwenda/AR_Windscreen/hardware/sim/brake/results.md

<!-- Generated by the simulation script: do not edit. -->

# Brake-light input simulation results

Overall: **ALL PASS**. Plots: `brake_results.png`.

| Case | Check | Result | Limit | |
|---|---|---|---|---|
| sweep_ctr25 | pin at 9 V (pressed) | 0.20 V | <= 0.99 V | PASS |
| sweep_ctr25 | reads pressed from | 5.99 V | reported |  |
| sweep_ctr25 | LED current at 9 / 12 / 16 V | 1.7 / 2.3 / 3.2 mA | reported |  |
| sweep_ctr25 | R63 dissipation at 16 V | 47 mW | <= 125 mW | PASS |
| sweep_ctr25_2k2 | pin at 9 V (pressed) | 0.15 V | <= 0.99 V | PASS |
| sweep_ctr25_2k2 | reads pressed from | 3.38 V | reported |  |
| sweep_ctr25_2k2 | LED current at 9 / 12 / 16 V | 3.6 / 4.9 / 6.7 mA | reported |  |
| sweep_ctr25_2k2 | R63 dissipation at 16 V | 100 mW | <= 125 mW | PASS |
| sweep_ctr25 | LED current, maximum (16 V) | 3.2 mA | <= 50 mA | PASS |
| sweep_ctr600 | pin at 0.5 V on the line (released) | 3.30 V | >= 2.31 V | PASS |
| sweep_ctr600 | stops reading released (pin < 2.31 V) from | 0.98 V | reported |  |
| sweep_ctr600 | reads pressed from | 1.12 V | reported |  |
| reverse | LED reverse voltage | 0.63 V | <= 6 V | PASS |
| reverse | D21 current | 2.9 mA | <= 300 mA | PASS |
| reverse | pin (reads released) | 3.30 V | >= 2.31 V | PASS |
| jump_24 | R63 dissipation (60 s) | 111 mW | <= 125 mW (0805) | PASS |
| jump_24 | LED current | 4.9 mA | reported |  |
| jump_24_2k2 | R63 dissipation (60 s) | 237 mW (0805 rated 125 mW) | reported |  |
| jump_24_2k2 | LED current | 10.4 mA | reported |  |
| dump_35 | R63 dissipation (400 ms) | 244 mW | <= 780 mW (short-time overload) | PASS |
| dump_35 | LED current | 7.2 mA | reported |  |
| timing | line on -> pin reads pressed | 27 us | reported |  |
| timing | line off -> pin reads released | 173 us | reported |  |

Models: no SPICE model is published for the PC817; it is built from the datasheet (see `brake.py`). CTR 25 % is the 50 % minimum halved for heat, ageing and the low LED current; 600 % is the datasheet's maximum (an unranked PC817 may be anywhere between).

MCU thresholds: 0.3 x VDD and 0.7 x VDD, the CMOS levels the STM32F405's datasheet guarantees.

**Findings.** (1) The input's threshold is the LED's forward voltage: a strong PC817 reads pressed from about 1 V on the line, a weak one from about 6 V. A lamp-outage check that puts a volt or more on a dark brake-lamp line would read as the pedal pressed (the safe direction: the system yields to the driver). A resistor across the LED (1 k on a later revision: nothing conducts below about 3 V) would make the threshold definite. (2) R63 was 2.2 k: 100 mW at 16 V, within its 125 mW, but 237 mW during a 60 s, 24 V jump-start (the `_2k2` cases). Changed to 4.7 k on 2026-10-16 (a value change, same footprint): the weakest part still reads pressed from 6 V.
