kiogimwenda/AR_Windscreen/hardware/sim/pod_supply/results.md

<!-- Generated by the simulation script: do not edit. -->

# Pod supply simulation results

Overall: **ALL PASS**. Plots: `pod_supply_results.png`.

| Case | Check | Result | Limit | |
|---|---|---|---|---|
| cable_only | +3V3, lowest (with the gesture LED's pulses) | 3.294 V | >= 3.2 V | PASS |
| cable_only | VIN_POD, lowest / LDO headroom | 4.20 V / 907 mV | reported |  |
| cable_only | from the cable / from USB (mean) | 237 mA / -0 mA | reported |  |
| cable_only | F2 current (mean) | 237 mA | <= 500 mA (hold) | PASS |
| cable_only | LDO dissipation | 204 mW (SOT-23-5: ~0.4 W at 70 C ambient) | reported |  |
| usb_only | +3V3, lowest (with the gesture LED's pulses) | 3.294 V | >= 3.2 V | PASS |
| usb_only | VIN_POD, lowest / LDO headroom | 3.90 V / 603 mV | reported |  |
| usb_only | from the cable / from USB (mean) | -0 mA / 237 mA | reported |  |
| both | +3V3, lowest (with the gesture LED's pulses) | 3.294 V | >= 3.2 V | PASS |
| both | VIN_POD, lowest / LDO headroom | 4.55 V / 1256 mV | reported |  |
| both | from the cable / from USB (mean) | 60 mA / 178 mA | reported |  |
| cable_only_10u | +3V3, lowest (with the gesture LED's pulses) | 3.294 V | >= 3.2 V | PASS |
| cable_only_10u | VIN_POD, lowest / LDO headroom | 4.27 V / 979 mV | reported |  |
| cable_only_10u | from the cable / from USB (mean) | 236 mA / -0 mA | reported |  |
| cable_out | +3V3, lowest after the cable is pulled | 3.294 V | >= 3.0 V | PASS |
| cable_out_10u | +3V3, lowest after the cable is pulled | 3.294 V | >= 3.0 V | PASS |
| usb_plugin | inrush peak | 4.38 A | reported |  |
| usb_plugin | inrush charge (above the running load), first 100 us | 28 uC | <= 50 uC (USB 2.0) | PASS |
| usb_plugin | +3V3 up (to 3.2 V) after attach | 36 us | reported |  |
| usb_plugin_10u | inrush peak | 8.83 A | reported |  |
| usb_plugin_10u | inrush charge (above the running load), first 100 us | 88 uC (limit 50 uC) | reported |  |
| usb_plugin_10u | +3V3 up (to 3.2 V) after attach | 61 us | reported |  |
| backfeed | current into the sleeping laptop's VBUS (25 C model) | 0.2 uA, VBUS at 0.18 V | reported |  |

Models: no SPICE model is published for the AP2112K; it is behavioural, from the datasheet (see `pod_supply.py`): it shows dropout and current limiting, not the regulator's own fast transient response, which the datasheet gives as tens of millivolts for a 100 mA step. SS14 as in the relay simulation; its leakage at 25 C (it rises about tenfold by 75 C).

USB inrush: USB 2.0 allows a device to present at most 10 uF at attach (the 50 uC figure). With the 10 uF C1 and C2 first fitted (the `_10u` cases) the pod presented about 22 uF and drew 88 uC; C1 and C2 became 1 uF and 4.7 uF on 2026-10-16 (value changes, same footprints; the AP2112K needs 1 uF on each side).
