kiogimwenda/AR_Windscreen/hardware/sim/input/results.md

<!-- Generated by the simulation script: do not edit. -->

# 12 V input protection simulation results

Overall: **ALL PASS**. Plots: `input_results.png`.

| Case | Check | Result | Limit | |
|---|---|---|---|---|
| normal_12 | rail never above 60 V | max 11.5 V | <= 60 V | PASS |
| normal_12 | rail never below -1 V | min 0.00 V | >= -1 V | PASS |
| normal_12 | rail / fuse current | 11.45 V / 1.90 A | reported |  |
| normal_12 | D11 drop / dissipation | 0.38 V / 0.72 W | reported |  |
| normal_12 | fuse current within its 3 A | 1.90 A | <= 2.4 A (80 %) | PASS |
| normal_12 | TVS (SMCJ33CA) | not conducting | reported |  |
| normal_14.4 | rail never above 60 V | max 13.9 V | <= 60 V | PASS |
| normal_14.4 | rail never below -1 V | min 0.00 V | >= -1 V | PASS |
| normal_14.4 | rail / fuse current | 13.86 V / 1.83 A | reported |  |
| normal_14.4 | D11 drop / dissipation | 0.38 V / 0.68 W | reported |  |
| normal_14.4 | fuse current within its 3 A | 1.83 A | <= 2.4 A (80 %) | PASS |
| normal_14.4 | TVS (SMCJ33CA) | not conducting | reported |  |
| reverse | rail never above 60 V | max 0.0 V | <= 60 V | PASS |
| reverse | rail never below -1 V | min -0.00 V | >= -1 V | PASS |
| reverse | current drawn from the reversed battery | 0.0 mA | reported |  |
| reverse | TVS (SMCJ33CA) | not conducting | reported |  |
| reverse | fuse I^2t (a 3 A blade fuse melts at a few A^2s) | 0.00 A^2s | reported |  |
| jump_24 | rail never above 60 V | max 23.4 V | <= 60 V | PASS |
| jump_24 | rail never below -1 V | min 0.00 V | >= -1 V | PASS |
| jump_24 | rail / fuse current | 23.44 V / 1.98 A | reported |  |
| jump_24 | D11 drop / dissipation | 0.38 V / 0.75 W | reported |  |
| jump_24 | fuse current within its 3 A | 1.98 A | <= 2.4 A (80 %) | PASS |
| jump_24 | TVS (SMCJ33CA) | not conducting | reported |  |
| ld_SMCJ24CA | rail never above 60 V | max 30.7 V | <= 60 V | PASS |
| ld_SMCJ24CA | rail never below -1 V | min 0.00 V | >= -1 V | PASS |
| ld_SMCJ24CA | TVS (SMCJ24CA) peak power vs its rating for 97.4 ms | 141 W | <= 152 W | PASS |
| ld_SMCJ24CA | TVS energy | 6.96 J | reported |  |
| ld_SMCJ24CA | fuse I^2t (a 3 A blade fuse melts at a few A^2s) | 3.66 A^2s | reported |  |
| ld_SMCJ33CA | rail never above 60 V | max 33.2 V | <= 60 V | PASS |
| ld_SMCJ33CA | rail never below -1 V | min 0.00 V | >= -1 V | PASS |
| ld_SMCJ33CA | TVS (SMCJ33CA) | not conducting | reported |  |
| ld_SMCJ33CA | fuse I^2t (a 3 A blade fuse melts at a few A^2s) | 1.97 A^2s | reported |  |
| p1_SMCJ24CA | rail never above 60 V | max 3.1 V | <= 60 V | PASS |
| p1_SMCJ24CA | rail never below -1 V | min 0.00 V | >= -1 V | PASS |
| p1_SMCJ24CA | TVS (SMCJ24CA) peak power vs its rating for 1.4 ms | 398 W | <= 1269 W | PASS |
| p1_SMCJ24CA | TVS energy | 0.28 J | reported |  |
| p1_SMCJ24CA | fuse I^2t (a 3 A blade fuse melts at a few A^2s) | 0.08 A^2s | reported |  |
| p1_SMCJ33CA | rail never above 60 V | max 3.1 V | <= 60 V | PASS |
| p1_SMCJ33CA | rail never below -1 V | min 0.00 V | >= -1 V | PASS |
| p1_SMCJ33CA | TVS (SMCJ33CA) peak power vs its rating for 1.3 ms | 492 W | <= 1329 W | PASS |
| p1_SMCJ33CA | TVS energy | 0.31 J | reported |  |
| p1_SMCJ33CA | fuse I^2t (a 3 A blade fuse melts at a few A^2s) | 0.06 A^2s | reported |  |
| p2a_SMCJ24CA | rail never above 60 V | max 28.6 V | <= 60 V | PASS |
| p2a_SMCJ24CA | rail never below -1 V | min 0.00 V | >= -1 V | PASS |
| p2a_SMCJ24CA | TVS (SMCJ24CA) peak power vs its rating for 0.0 ms | 43 W | <= 9764 W | PASS |
| p2a_SMCJ24CA | TVS energy | 0.00 J | reported |  |
| p2a_SMCJ24CA | fuse I^2t (a 3 A blade fuse melts at a few A^2s) | 0.07 A^2s | reported |  |
| p2a_SMCJ33CA | rail never above 60 V | max 29.2 V | <= 60 V | PASS |
| p2a_SMCJ33CA | rail never below -1 V | min 0.00 V | >= -1 V | PASS |
| p2a_SMCJ33CA | TVS (SMCJ33CA) | not conducting | reported |  |
| p2a_SMCJ33CA | fuse I^2t (a 3 A blade fuse melts at a few A^2s) | 0.07 A^2s | reported |  |

Models from datasheet figures (no vendor SPICE models): see `input.py`. The converter and the LiDAR are constant-power loads (6 W, 8 W), all five relay coils on.

Suppressed load dump (ISO 16750-2 test B): the car's own suppression holds the supply at 35 V for up to 400 ms. A TVS that starts conducting below 35 V tries to hold the whole car's supply down through its fuse: far beyond its rating. One that starts above 35 V lets the 35 V through to the 60 V-rated converter and clips only the fast spikes.
