kiogimwenda/AR_Windscreen/hardware/sim/relay/results.md

<!-- Generated by the simulation script: do not edit. -->

# Relay and magnet driver simulation results

Overall: **ALL PASS**. Plots: `relay_results.png`.

| Case | Check | Result | Limit | |
|---|---|---|---|---|
| relay_9 | gate high level | 2.99 V | >= 2.5 V | PASS |
| relay_9 | MOSFET on-voltage | 3.2 mV | <= 100 mV | PASS |
| relay_9 | coil current / voltage | 106 mA / 9.00 V | reported |  |
| relay_9 | drain peak at turn-off | 9.3 V | <= 30 V | PASS |
| relay_9 | diode peak current | 107 mA | <= 1 A | PASS |
| relay_9 | current down to 10 % after switch-off | 8.5 ms | reported |  |
| relay_9 | gate rise (to 90 %) | 2.5 us | reported |  |
| relay_12 | gate high level | 2.99 V | >= 2.5 V | PASS |
| relay_12 | MOSFET on-voltage | 4.3 mV | <= 100 mV | PASS |
| relay_12 | coil current / voltage | 141 mA / 12.00 V | reported |  |
| relay_12 | drain peak at turn-off | 12.3 V | <= 30 V | PASS |
| relay_12 | diode peak current | 152 mA | <= 1 A | PASS |
| relay_12 | current down to 10 % after switch-off | 8.7 ms | reported |  |
| relay_12 | gate rise (to 90 %) | 2.6 us | reported |  |
| relay_14.4 | gate high level | 2.99 V | >= 2.5 V | PASS |
| relay_14.4 | MOSFET on-voltage | 5.1 mV | <= 100 mV | PASS |
| relay_14.4 | coil current / voltage | 169 mA / 14.39 V | reported |  |
| relay_14.4 | drain peak at turn-off | 14.7 V | <= 30 V | PASS |
| relay_14.4 | diode peak current | 170 mA | <= 1 A | PASS |
| relay_14.4 | current down to 10 % after switch-off | 8.8 ms | reported |  |
| relay_14.4 | gate rise (to 90 %) | 2.3 us | reported |  |
| magnet_12 | gate high level | 2.99 V | >= 2.5 V | PASS |
| magnet_12 | MOSFET on-voltage | 7.6 mV | <= 100 mV | PASS |
| magnet_12 | coil current / voltage | 250 mA / 11.99 V | reported |  |
| magnet_12 | drain peak at turn-off | 12.3 V | <= 30 V | PASS |
| magnet_12 | diode peak current | 258 mA | <= 1 A | PASS |
| magnet_12 | current down to 10 % after switch-off | 6.6 ms | reported |  |
| magnet_12 | gate rise (to 90 %) | 2.6 us | reported |  |
| magnet_14.4 | gate high level | 2.99 V | >= 2.5 V | PASS |
| magnet_14.4 | MOSFET on-voltage | 9.1 mV | <= 100 mV | PASS |
| magnet_14.4 | coil current / voltage | 300 mA / 14.39 V | reported |  |
| magnet_14.4 | drain peak at turn-off | 14.8 V | <= 30 V | PASS |
| magnet_14.4 | diode peak current | 307 mA | <= 1 A | PASS |
| magnet_14.4 | current down to 10 % after switch-off | 6.7 ms | reported |  |
| magnet_14.4 | gate rise (to 90 %) | 2.3 us | reported |  |
| unplugged | coil current | 0.00 uA | < 1 mA | PASS |
| unplugged | gate | 0.000 V | < 0.5 V | PASS |

Models: no vendor SPICE model is published for the AO3400A or SS14; both are built from their datasheet figures (see `relay.py`). The coils are typical values for parts not yet bought: relay 85 Ohm / 0.35 H, magnet 48 Ohm / 0.15 H. Measure the real ones and rerun.

Release time: with a plain flyback diode the coil current decays with the coil's own time constant (L/R), so a relay or the magnet lets go some milliseconds after switch-off. A relay drops out well before its current reaches 10 %; the 10 % figure is the slow, cautious bound.
