kiogimwenda/AR_Windscreen/hardware/sim/buck/results.md

<!-- Generated by hardware/sim/run_buck.sh: do not edit. -->

# 5 V converter (TPS54360) simulation results

Overall: **ALL PASS**. Plots: `buck_results.png`. Model: TI's TPS54360 transient model (Final 1.10) with the power board's component values.

| Case | Check | Result | Limit | |
|---|---|---|---|---|
| startup | reaches 4.75 V | 2.26 ms | yes | PASS |
| startup | overshoot | 0.9 % | <= 3 % | PASS |
| step | 0.2 -> 1.5 A: deviation | 179 mV (3.6 %) | <= 5 % | PASS |
| step | 0.2 -> 1.5 A: back within 1 % | 123 us | <= 300 us | PASS |
| step | 0.2 -> 1.5 A: ringing (sign changes > 0.3 %) | 0 | <= 2 | PASS |
| step | 1.5 -> 0.2 A: deviation | 129 mV (2.6 %) | <= 5 % | PASS |
| step | 1.5 -> 0.2 A: back within 1 % | 147 us | <= 300 us | PASS |
| step | 1.5 -> 0.2 A: ringing (sign changes > 0.3 %) | 2 | <= 2 | PASS |
| vin_9 | output | 5.002 V | 4.90-5.10 V | PASS |
| vin_9 | ripple | 8.0 mV | <= 50 mV | PASS |
| vin_9 | switching | 602 kHz | 540-660 kHz | PASS |
| vin_9 | efficiency at 1 A | 95 % | reported |  |
| vin_12 | output | 5.002 V | 4.90-5.10 V | PASS |
| vin_12 | ripple | 7.4 mV | <= 50 mV | PASS |
| vin_12 | switching | 602 kHz | 540-660 kHz | PASS |
| vin_12 | efficiency at 1 A | 94 % | reported |  |
| vin_14.4 | output | 5.002 V | 4.90-5.10 V | PASS |
| vin_14.4 | ripple | 7.6 mV | <= 50 mV | PASS |
| vin_14.4 | switching | 602 kHz | 540-660 kHz | PASS |
| vin_14.4 | efficiency at 1 A | 94 % | reported |  |
| vin_30 | output | 5.001 V | 4.90-5.10 V | PASS |
| vin_30 | ripple | 35.1 mV | <= 50 mV | PASS |
| vin_30 | switching | 602 kHz | 540-660 kHz | PASS |
| vin_30 | efficiency at 1 A | 92 % | reported |  |

Assumptions: output ceramics 2 x 25 uF (47 uF derated at 5 V), 3 mOhm ESR; input 2 x 2.2 uF; L1 8.2 uH, 17 mOhm; D13 a generic 5 A / 60 V Schottky; supply 20 mOhm. See the docstring of `buck.py`.

What this does and does not show: it checks the converter's DESIGN (the values: output voltage, switching frequency, compensation, start-up) with TI's model. It does not include the board's layout (track inductance, switch-node ringing, noise), the real diode's forward voltage (the efficiency is somewhat optimistic for that reason), or temperature. The load-step and steady cases start from a preset state and settle for their first 0.3 ms; the measurements skip it.
