kiogimwenda/AR_Windscreen/docs/report/evidence/figures/fig_calibration.png

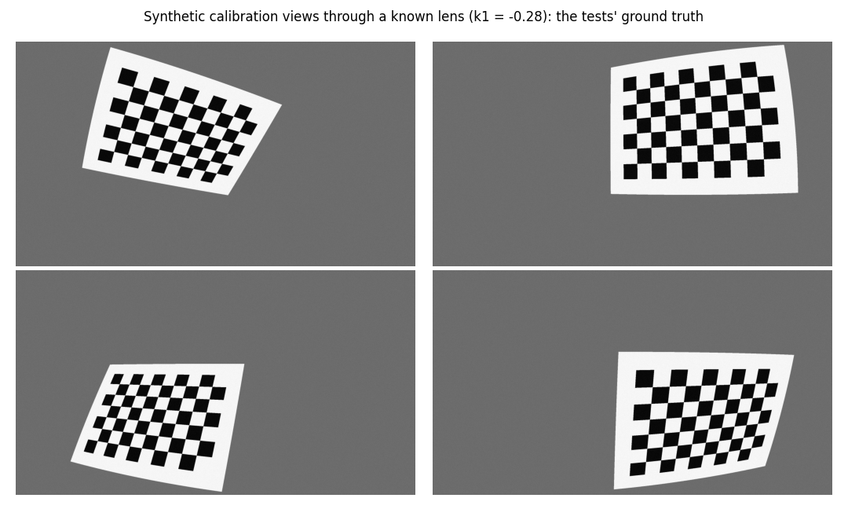
docs/report/evidence/figures/fig_calibration.png
