kiogimwenda/AR_Windscreen/hardware/sim/buck/buck_results.png

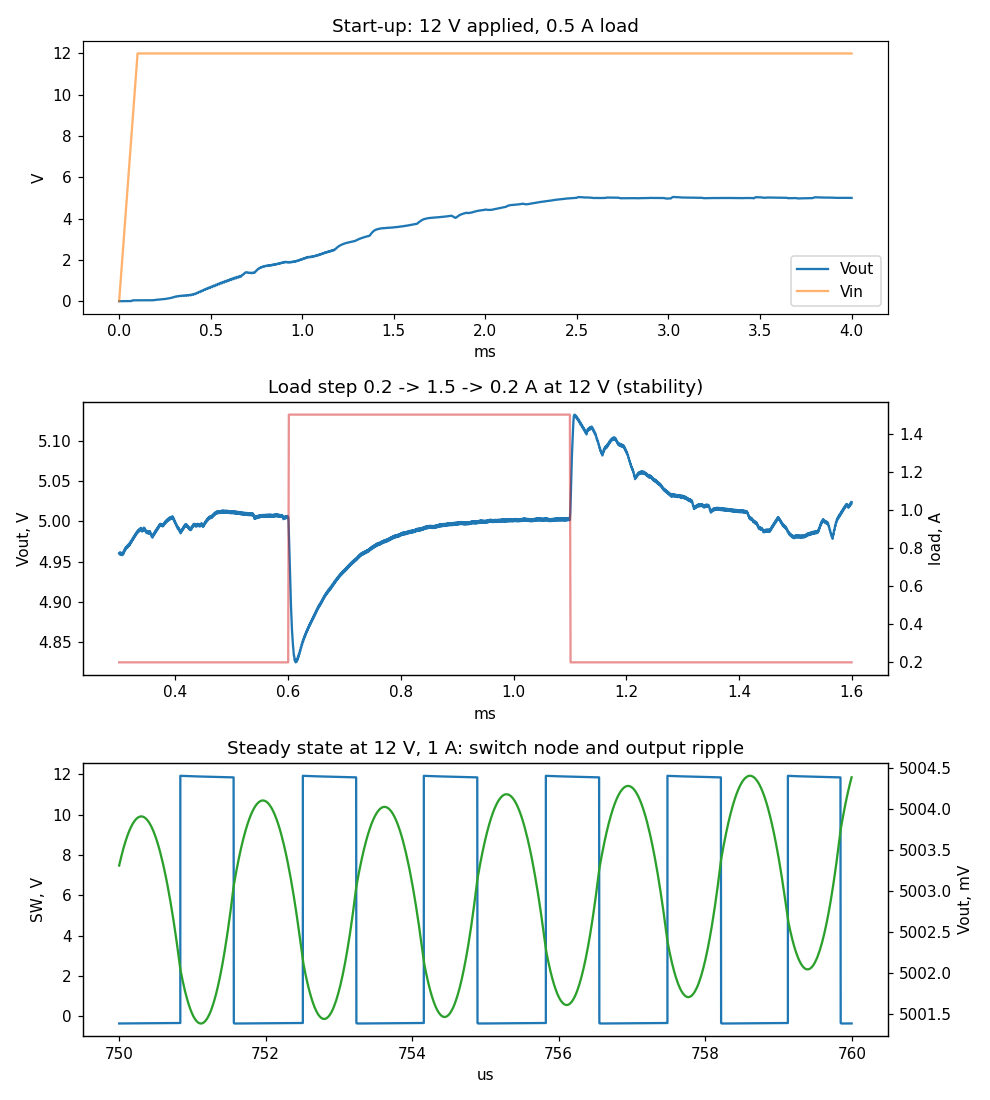
hardware/sim/buck/buck_results.png
