kiogimwenda/AR_Windscreen/hardware/sim/input/input_results.png

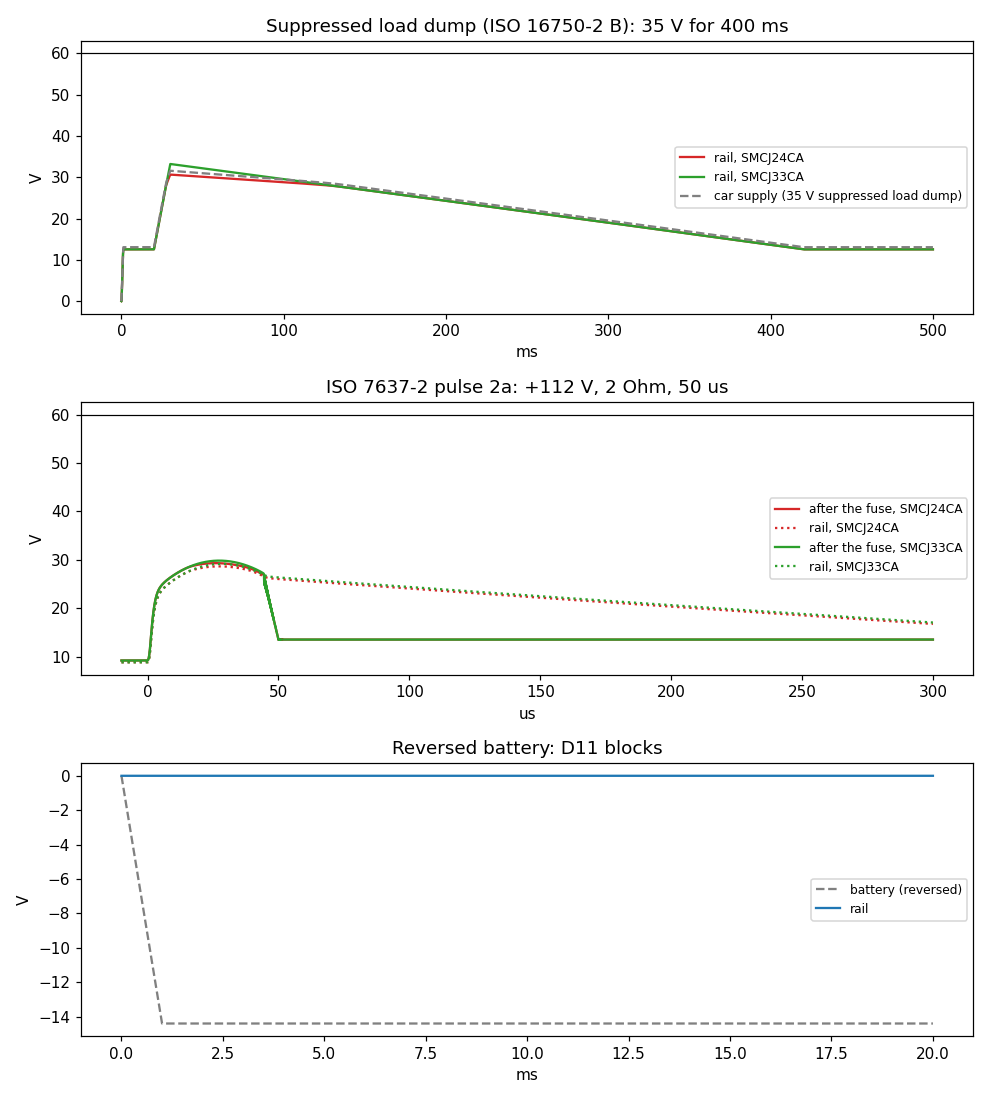
hardware/sim/input/input_results.png
