kiogimwenda/AR_Windscreen/docs/progress-log.md

# Progress Log

A dated, per-task record of work on this project — one entry per discrete task, written as the task
finishes. Separate from `decisions.md`, which is the short index of choices made under ambiguity.

Format is fixed by `BUILD_GUIDE.md` Part 1.1.

---

## 2026-09-18 — Phase 0: repository scaffold (Part 1 tree)

**Attempted:** Create the complete Part 1 directory tree with stub files in a single pass, before
any real logic exists, so the structure stays stable while individual files are filled in phase by
phase. This is Part 1's explicit instruction for Phase 0 and the first half of that phase's
deliverables.

**Built/changed:** Repository root now holds `README.md` (rewritten to describe the system and lead
with the safety rule), `LICENSE` (MIT), `.gitignore` (with `.claude/` as its literal first line per
Part 1.2), `.clang-format`, and a top-level `CMakeLists.txt` that adds `host/` and nothing else.
Created `docs/` (this file, `decisions.md`, `BUILD_GUIDE.md` itself, `architecture/`, `report/`,
`presentation/`), `cmake/FindTensorRT.cmake` (written in full — it is a build dependency, not
project logic), `firmware/sensor_actuator_hub/` (`platformio.ini` per Part 4.1, three `include/hub/`
headers, `main.cpp`, four task stub pairs, six driver stub pairs, one test stub),
`host/include/ar_drive_assist/` (23 header stubs across 12 subsystem directories, plus four `.fbs`
schema stubs), `host/src/` (17 `.cpp` stubs mirroring the headers, plus `main.cpp`),
`host/config/` (six YAML files carrying the templates the guide specifies literally),
`host/scripts/` (five stubs), `host/test/` (six unit-test stubs, a standalone `unit/CMakeLists.txt`,
an aggregating `test/CMakeLists.txt`, an `integration/README.md`), `tools/bench_rig/` (two stubs),
and `.github/workflows/build.yml` (Part 13.5, verbatim).

**Reasoning:** Stubs carry a `#pragma once` and a `TODO(Part N)` comment naming both the guide Part
that specifies the file and the phase that fills it, so the tree itself records the execution plan
and a stale stub is obvious at a glance. Safety-critical stubs carry more than a pointer:
`BrakeActuatorDriver.h` states up front that it is the second, independent force ceiling and that
`kMaxSafeIntensity` is never raised without a bench re-test, so that constraint is present in the
file from before the file does anything. `host/include/.../vehicle/HubProtocol.h` and `Crc16.h` were
created as literal copies of their firmware counterparts rather than as separately-worded stubs, so
CI's `protocol-sync-check` diff is green from the first commit and any later drift is a real signal
rather than pre-existing noise. Config YAML files were given the guide's literal template values
rather than left empty, since those values are specification, not logic — with measured quantities
(camera matrix, extrinsics) left as empty lists so a placeholder can never be mistaken for a real
calibration.

**Problems hit:** Part 5.2's `include(${CMAKE_SOURCE_DIR}/../cmake/FindTensorRT.cmake)` resolves
outside the repository once `host/` is a subdirectory of a top-level project rather than the
top-level project itself; changed to `CMAKE_CURRENT_SOURCE_DIR`. Part 5.2's `add_subdirectory(test)`
also conflicts with Part 13.1's requirement that the unit suite build standalone without CUDA/SDL2;
resolved in favour of 13.1, whose rationale (GPU-less CI) is stated explicitly. Both logged in
`decisions.md`, along with four smaller under-specifications (missing `cmake/` directory, no license
named, no clang-format style, "one .cpp per .h" against six header-only files).

**Still open:** Every stub is still a stub — no logic anywhere. The environment half of Phase 0
(Part 2.10's five checks) has not been run yet, and `cmake` configuring `host/` will fail until the
missing dependencies are installed. `platformio.ini`'s board is a placeholder until the exact F4
board on hand is confirmed. `attach_usb_devices.ps1` cannot be completed until `usbipd list` on the
Windows side gives the three bus IDs.

## 2026-09-18 — Phase 0: development environment (Part 2)

**Attempted:** Bring the WSL2 Debian instance up to Part 2's dependency list and run Part 2.10's
five verification checks, which are the environment half of Phase 0's exit criteria.

**Built/changed:** Surveyed what was already present (CUDA 13.1, TensorRT, PlatformIO 6.1.19,
Eigen3, spdlog, GTest, GStreamer) and installed the rest of Part 2.3/2.6 via apt: `libpcl-dev`
(1.15.0), `libsdl2-dev` (2.32.4), `libglm-dev`, `libflatbuffers-dev` + `flatbuffers-compiler`
(23.5.26), `v4l-utils`, plus `libjsoncpp-dev`. Fixed `firmware/sensor_actuator_hub/platformio.ini`
and filled in `src/main.cpp` enough to link. Amended `host/CMakeLists.txt`'s PCL lookup. Cloned and
configured OSRM v6.0.0 from source into `~/src/osrm-backend` (build running).

**Reasoning:** Part 2.4 says to use the CUDA/TensorRT versions already validated on this machine
rather than mixing major versions, so nothing GPU-side was reinstalled — only verified. The
existing OpenCV turned out to be a source build at `/usr/local` (4.14.0-pre, CUDA 13.1 + cuDNN
9.19.1, CUDA modules present), which is what the C++ build links against; the 4.10.0 reported by
`import cv2` is an unrelated pip wheel inside `~/ml-env` with no CUDA, which is why the earlier
survey looked contradictory. The installed build satisfies Part 2.10's intent (OpenCV with working
CUDA) at a newer version than the guide names, and is arguably the version that *should* be there:
the guide's 4.10.0 predates CUDA 13 and would not build against the toolkit actually installed.

**Verification (Part 2.10, five checks):**
1. `nvcc --version` — PASS, CUDA 13.1.115.
2. Trivial CUDA kernel compiles and runs — PASS. A `saxpy` kernel built with `-arch=sm_120` runs on
   the "NVIDIA GeForce RTX 5060 Laptop GPU", reported as `sm_120`, max error 0.0. This confirms
   Blackwell compute capability 12.0 directly, which is the number Part 2.5 warns is the single
   most common copy-paste mistake when reusing old build scripts (the Orin Nano's 8.7).
3. OpenCV with CUDA — PASS with a documented version deviation. A C++ program linking the
   `/usr/local` OpenCV reports 1 CUDA-enabled device, `sm_120`, and a GPU `cv::cuda::multiply`
   returning correct results.
4. USB camera at `/dev/video0` — **NOT YET RUN.** No `/dev/video*` node exists because nothing has
   been attached through `usbipd-win` on the Windows side. Requires physical action.
5. `pio run` on the firmware project — PASS, after two fixes (below). Firmware links at 0.8% RAM /
   2.1% flash on the F411CE.

Additionally, `cmake -S . -B build` configures the whole project without error — the other half of
Phase 0's exit criteria — locating OpenCV 4.14.0, PCL 1.15.0, Eigen3, glm, spdlog, SDL2, CUDA 13.1,
Flatbuffers, GTest and TensorRT (via the project's own `cmake/FindTensorRT.cmake`).

**Problems hit:** Three real defects, none of them cosmetic.

*Part 4.1's `lib_deps = FreeRTOS` is wrong for this target.* That bare name resolves in the
PlatformIO registry to feilipu's `Arduino_FreeRTOS_Library`, which is an AVR port and fails
immediately on `#include <avr/io.h>` when cross-compiling for ARM. Replaced with
`stm32duino/STM32duino FreeRTOS@^10.3.3`, which is the STM32 port and — importantly — exposes the
native FreeRTOS API (`xTaskCreate`, `vTaskStartScheduler`) that Part 4.3 uses directly, rather than
a CMSIS-RTOS wrapper that would have required rewriting Part 4.3's task setup.

*Firmware would not link with a comment-only `main.cpp`.* PlatformIO's Arduino framework supplies
its own `main()` which calls `setup()` and `loop()`, so both must exist. Written as a documented
stub explaining why `loop()` stays permanently empty under FreeRTOS.

*Debian 13's VTK 9.3 CMake package is broken, and PCL drags it in.* `find_package(PCL)` fails at
configure time because VTK's config declares link dependencies on targets (`JsonCpp::JsonCpp`, then
`MPI::MPI_C`, and more behind them) without ever calling `find_dependency()` to define them.
Installing `libjsoncpp-dev` and finding it first cleared the first error and revealed the next, so
chasing the chain would have meant linking OpenMPI into a real-time driving system to satisfy a
packaging bug. Instead PCL is now requested by component — `common filters segmentation kdtree
search sample_consensus`, exactly what Part 8.1 needs — which avoids VTK entirely. `io` is
deliberately excluded because it is what pulls VTK back in.

*Part 2.7's `apt install osrm-tools` does not work on Debian 13* — OSRM is not packaged in trixie at
all, under any name. Building v6.0.0 from source against system Boost 1.83 and oneTBB 2022.1
instead; it configures cleanly and the compile is running.

**Still open:** Part 2.10 check 4 (camera at `/dev/video0`) needs `usbipd-win` attachment from the
Windows side — a physical/host-side action. The OSRM source build is still running; until it
installs, `host/CMakeLists.txt`'s `osrm` link entry will fail at *link* time (it configures fine,
since a bare library name is passed straight to the linker without a configure-time check). Part
13.5's CI `host-unit-tests` job installs `libosrm-dev`, which does not exist on `ubuntu-latest`
either — that job will need the same treatment before Phase 8, and is noted but not yet fixed.
`platformio.ini`'s board is still the guide's placeholder `blackpill_f411ce`.

## 2026-09-18 — Phase 0: OSRM built from source (Part 2.7)

**Attempted:** Provide the OSRM routing/map-matching dependency that Part 11.2–11.4 are built on,
since Part 2.7's `apt install osrm-tools` has no package on Debian 13.

**Built/changed:** Cloned OSRM v6.0.0 into `~/src/osrm-backend` (outside this repository — it is a
system dependency, not project source), built it against system Boost 1.83 and oneTBB 2022.1, and
installed to `/usr/local`. Provides `osrm-extract`, `osrm-partition`, `osrm-customize`,
`osrm-contract`, `osrm-datastore`, `osrm-routed`, plus `libosrm.a` and headers under
`/usr/local/include/osrm`.

**Reasoning:** v6.0.0 rather than master, so the version is pinned and reproducible for the report.
Built against the distribution's Boost and oneTBB rather than OSRM's bundled alternatives, to keep
one copy of each library in the process — this matters because the host binary will link OSRM
alongside PCL, which also uses Boost.

**Problems hit:** The first build failed at 87% with seven `-Werror=array-bounds` errors, all of
them GCC 14 false positives inside OSRM's *own* vendored third-party headers (fmt 10 and sol2), not
in OSRM's code or ours. OSRM adds `-Werror` to `CMAKE_CXX_FLAGS` via `cmake/warnings.cmake`.
Suppressing it needed care: passing `-Wno-error=array-bounds` in `CMAKE_CXX_FLAGS` would have been
silently defeated, because OSRM *appends* its own flags to that variable and later flags win — so
`-Werror` would land after the exemption and re-enable it. Putting the exemptions in
`CMAKE_CXX_FLAGS_RELEASE` instead works, because CMake emits `${CMAKE_CXX_FLAGS}` followed by
`${CMAKE_CXX_FLAGS_<CONFIG>}`, placing them after `-Werror`. Rebuilt clean.

**Verification:** A C++ program including `<osrm/osrm.hpp>`, `<osrm/route_parameters.hpp>` and
`<osrm/match_parameters.hpp>` compiles, links against `libosrm`, and constructs an `EngineConfig`
with the MLD algorithm — the exact API surface Part 11.2 and 11.3 specify. This is the real proof
the dependency is usable, rather than just that files landed on disk.

**Still open:** `pkg-config --modversion libosrm` reports the literal string `packagejson.version`
— an unexpanded variable in OSRM's installed `.pc` file. Harmless here since `host/CMakeLists.txt`
links OSRM by plain library name, but worth knowing before anyone tries to drive the link line from
pkg-config. Part 13.5's CI job still installs the nonexistent `libosrm-dev`; unchanged, and still
due before Phase 8.

## 2026-09-19 — Phase 0: check 4 reclassified as blocked on procurement, not on setup

**Attempted:** Close Part 2.10's fifth check (a USB camera appearing as `/dev/video0` after a
`usbipd-win` attach), the last outstanding item in Phase 0.

**Built/changed:** Nothing built. The check is reclassified from "pending a Windows-side attach" to
"blocked until hardware is purchased" and the earlier entry's framing is corrected here rather than
edited away.

**Reasoning:** The 2026-09-18 entry recorded check 4 as not yet run "because nothing has been
attached through usbipd-win", which implied a camera existed and was merely unattached. No project
hardware has been bought at all. That matters well beyond this one check: it means the guide's Part
14 roadmap cannot be walked straight through in order, because Phases 2, 3, 4, 6, 11, 12, 13, 14
and 15 all have exit criteria that require physical hardware in hand, and Phases 7 and 9 can be
written but not fully verified without it.

**Problems hit:** The error was mine in the earlier entry — I inferred from a missing `/dev/video*`
node that a camera was present but unattached, rather than asking. Recorded here rather than
silently rewritten, since the point of this log is what actually happened.

**Still open:** Part 2.10 check 4 stays open until a camera exists. Phase 0's other six criteria
(the four other Part 2.10 checks, `cmake` configuring `host/`, and `pio run` building the firmware)
all pass, so Phase 0 is complete except for that one hardware-gated item. A hardware bill of
materials and a decision on which non-hardware phases to bring forward are both now on the critical
path, and neither exists yet.

## 2026-09-19 — Phase 1: shared protocol headers (Part 3.1, 3.2)

**Attempted:** Implement `Protocol.h` and `Crc16.h` — the host<->hub wire format and its checksum —
as two byte-for-byte identical copies, one under `firmware/`, one under `host/`.

**Built/changed:** `firmware/sensor_actuator_hub/include/hub/Crc16.h` and `.../hub/Protocol.h`,
copied verbatim to `host/include/ar_drive_assist/vehicle/Crc16.h` and `.../vehicle/HubProtocol.h`.
`Crc16.h` is Part 3.2's bit-serial CRC-16/CCITT-FALSE. `Protocol.h` carries Part 3.1's
`START_BYTE`, `MAX_PAYLOAD`, `MessageType` and the three packed payload structs, plus four
additions described below.

**Reasoning:** Four things were added beyond Part 3.1's literal text, all in service of the
"identical on both ends" requirement rather than in spite of it.

*Frame geometry constants* (`HEADER_SIZE`, `CRC_SIZE`, `CRC_COVERED_OFFSET`, `MAX_FRAME_SIZE`) are
derived from Part 3.1's ASCII frame diagram. Without them, `VehicleInterface` (Part 11.1) and
`CommsTask` (Part 4.3) would each re-derive the same offsets by reading that diagram — and the CRC
covered range in particular is the single most likely framing bug, because getting it wrong leaves
both ends self-consistent and mutually incompatible, which only shows up on a bench.

*`static_assert` on every struct size.* This is the important one. The two ends are different
architectures — Cortex-M4 at 32 bits, x86-64 — with different compilers. `#pragma pack(push, 1)`
is what removes padding, but nothing checks that it worked. These asserts turn a silent layout
disagreement (the hub reading a brake intensity out of what the host thought was a timestamp) into
a build failure. They cost nothing at runtime and are checked on both sides because both sides
compile this same file.

*`#include <cstddef>`.* Part 3.1's snippet uses `size_t` but includes only `<cstdint>`. It happens
to compile where `<cstdint>` transitively drags in `<cstddef>`, which is not guaranteed.

*A note that HEARTBEAT carries no payload.* Part 3.3 requires the message but defines no struct for
it. Recorded as length 0 explicitly, so the next person does not have to infer it. Staleness of a
real request is already covered by `ActuationCommand::hostTimestampMs`, so the heartbeat needs to
carry nothing.

**Problems hit:** Nothing went wrong in writing the headers. The one thing worth recording is what
the struct sizes turned out to be: `SensorReport` is 63 bytes against a `MAX_PAYLOAD` of 64. One
byte of headroom. A `static_assert` now guards that, because adding a single `float` to
`SensorReport` would push it over the cap and frames would start being rejected as oversized with
no obvious connection to the change that caused it.

**Still open:** Nothing from this task. Framing encode/decode belongs to `VehicleInterface` and
`CommsTask` in Phases 3 and 2 respectively, per Part 11.1 — this file deliberately holds only the
shared format, not the shared machinery.

## 2026-09-19 — Phase 1: CRC and layout tests, both sides of the link

**Attempted:** Satisfy Phase 1's exit criteria — a passing host-side CRC test, a matching
firmware-side test confirming identical behaviour, and a green `protocol-sync-check`.

**Built/changed:** `host/test/unit/test_crc16.cpp` (12 GoogleTest cases) and
`firmware/sensor_actuator_hub/test/test_protocol_crc.cpp` (7 Unity cases). Wired up
`host/test/unit/CMakeLists.txt` with an `add_unit_test()` helper so later phases add one line each,
and added a `[env:native]` PlatformIO environment plus `default_envs = stm32f4_hub` so `pio test -e
native` runs the firmware's tests on this machine while a bare `pio run` still builds only the
STM32 target (which is what CI's `firmware-build` job invokes). Added `#include "hub/Protocol.h"`
and `"hub/Crc16.h"` to the otherwise-still-stubbed `CommsTask.cpp`.

**Reasoning:** The CRC vectors are deliberately duplicated between the two test files rather than
factored into a shared header. CI's `protocol-sync-check` already proves the two headers are
byte-identical; what the tests add is that each copy independently produces the *standard* results.
A shared vector header would collapse that into one point of failure, which is the opposite of what
Part 3's "implemented twice, kept identical" rule is for. The canonical check value
(`crc16_ccitt_false("123456789") == 0x29B1`) is asserted on both sides specifically because it
proves the implementation is the standard CRC-16/CCITT-FALSE rather than merely self-consistent —
a self-consistent but non-standard CRC would pass every other test in both files.

The `CommsTask.cpp` include is not premature scaffolding. `Protocol.h`'s `static_assert`s only
execute in a translation unit that compiles the header, and the layout question they answer is
specifically about the Cortex-M4 — but both test suites run on x86-64. Without something in the
firmware including the header, Phase 1's "identical on both ends" claim would have rested entirely
on two tests that ran on the same architecture. `CommsTask` is the task that genuinely owns framing
(Part 4.3), so this is where the include belongs anyway.

**Verification:** Host suite 12/12 via `ctest`. Firmware suite 7/7 via `pio test -e native`. `pio
run` cross-compiles the firmware for ARM successfully, which is what actually exercises the layout
asserts on the real target. Both `diff`s in CI's `protocol-sync-check` are clean, and the
`format-check` command passes.

The layout assert was then negative-tested rather than assumed: changing the expected
`SensorReport` size to 64 and running `pio run` fails the ARM build with `static assertion failed:
SensorReport layout changed - update BOTH copies`, and restoring it builds clean again. A safety
net that has never been observed to catch anything is not yet known to be a safety net.

**Still open:** Nothing from this task. The five later test stubs remain stubs; their targets are
listed as comments in `host/test/unit/CMakeLists.txt` against the phases that will add them.

## 2026-09-19 — Fix: `.clang-format-ignore` was silently matching nothing

**Attempted:** Confirm CI's `format-check` command passes when run locally.

**Built/changed:** Corrected `.clang-format-ignore` from `firmware/sensor_actuator_hub/.pio/*` to
`**/.pio/**` and `**/build/**`.

**Reasoning:** In a clang-format ignore file, patterns are globs relative to the file's directory
and `*` does not cross a `/`. `.pio/*` therefore matched only the first level under `.pio` and
nothing beneath it, so the vendored Arduino/FreeRTOS/Adafruit sources were still being checked.

**Problems hit:** This was a false pass on 2026-09-18, not a new break. That day's check reported
clean only because `.pio/` had just been wiped, so there was nothing for the broken pattern to fail
to match. The ignore file was written and never actually exercised. Fixed and then verified in both
directions: the full command now reports zero violations, and dropping a deliberately misformatted
file into `host/src/` still produces violations, confirming the ignore is not simply swallowing
everything.

**Still open:** Nothing.

## 2026-09-24 — Hardware bill of materials with Kenyan sourcing

**Attempted:** Produce the hardware bill of materials that the 2026-09-19 entry identified as
being on the critical path, sourcing from local (Kenyan) suppliers first and naming an import route
only where nothing suitable is sold locally.

**Built/changed:** `docs/bill-of-materials.md` — every hardware item referenced by Parts 4, 6, 8,
13.3 and 15, grouped as hub, sensors, actuation/safety, power, bench rig and installation, each with
the spec that matters, a supplier, a price and stock status as seen on 2026-09-24. Includes an
import-bundle cost estimate and a budget summary. Four entries added to `decisions.md`.

**Reasoning:** Suppliers were checked online (K-Technics, Pixel Electric, Nerokas, Jumia, Kilimall).
Four items had no local listing: the Livox Mid-360, its aviation cable (not included with the
sensor), the BNO085, and a suitable brake actuator. These are grouped into a single import so duty
and clearing are paid once. The camera line requires manual focus control because autofocus moving
the lens would silently invalidate the Part 12.1 intrinsics.

**Problems hit:** Three issues that the guide does not surface, found while matching parts to specs.
First, every locally sold linear actuator is a lead-screw type, which holds position when unpowered.
Coupled rigidly to the pedal, it would leave the brake applied after a kill-switch cut, directly
contradicting the hard safety rule. The actuator is therefore marked "do not buy" pending a design
decision, not substituted. Second, the STM32's 3.3 V outputs sit below the input threshold of the
common BTS7960 and relay modules. Third, a 100–140 W USB-C car charger cannot power an RTX 5060
laptop under load. Many shop listings showed "sold out" (GPS, APDS-9960, F411 board, Pixel's
BTS7960), so all prices are marked for phone confirmation before purchase.

**Still open:** Brake actuator mechanical design (BOM note B), to be agreed with the supervisor.
Laptop in-car power approach (note D). BNO085 import vs local BNO055 plus a driver change. A clearing
agent's quote for the LiDAR, and whether departmental education duty relief applies. Part 2.10
check 4 remains open until the camera is bought.

## 2026-09-24 — Phase 3 (software part): `RingBuffer` message bus (Part 5.3)

**Attempted:** Implement the single-producer/single-consumer ring buffer that every host
subsystem communicates through. Phase 3 was started with its hardware-free parts only
(`RingBuffer`, `EventLog`, `SystemManager`); `VehicleInterface` and the Phase 3 exit test wait for
the Phase 2 hub.

**Built/changed:** `host/include/ar_drive_assist/common/RingBuffer.h`: `push` (copy and move),
`pop`, `popLatest`, `sizeApprox`. `host/test/unit/test_ring_buffer.cpp` has 9 tests, 2 of them
two-threaded. It is registered in `host/test/unit/CMakeLists.txt` with `Threads::Threads`.
`.gitignore` now also covers `host/test/unit/build-*/` (sanitizer build directories).

**Reasoning:** Both indices are monotonically increasing counters, each written by one thread
only, so no compare-and-swap is needed. Using counters rather than wrapped indices gives a
capacity of exactly N instead of N−1; N must be a power of two so the modulo stays correct across
counter wrap. The producer publishes a slot with a `release` store of `head_`, and the consumer's
`acquire` load of `head_` guarantees it sees the fully written item. The mirror-image pair on
`tail_` stops the producer overwriting a slot the consumer is still moving out of. `head_` and
`tail_` sit on separate cache lines to avoid false sharing.

Part 5.3's "drop oldest" policy is realised by the consumer (`popLatest`), not the producer. In an
SPSC queue only the consumer owns `tail_`, so a producer discarding the oldest item would race the
consumer reading it. `push` therefore never overwrites; it returns false and leaves the policy to
the caller, as Part 5.3's own signature comment says. `popLatest` resets discarded slots to `T{}`
so a frame bus doesn't pin up to N stale `cv::Mat` buffers.

**Problems hit:** The first ThreadSanitizer run aborted at startup ("unexpected memory mapping")
because this kernel's address-space randomisation is incompatible with TSan's shadow memory. An
earlier run had appeared to pass only because the random layout happened to work that time. It
now runs under `setarch -R` (randomisation disabled for that process only):
`cmake -S host/test/unit -B host/test/unit/build-tsan -DCMAKE_CXX_FLAGS="-fsanitize=thread -O1 -g"`,
then `setarch -R host/test/unit/build-tsan/test_ring_buffer`.

**Verification:** 9/9 pass in the normal build (21/21 across the suite including CRC). Under TSan,
three consecutive runs are 9/9 with zero race reports. Negative test: weakening the producer's
`head_.store` from `release` to `relaxed` makes TSan report a data race on the consumer's slot
read (`RingBuffer.h:92`), which is exactly the failure the ordering exists to prevent. Restored
and re-verified clean.

**Still open:** Nothing from this task.

## 2026-09-24 — Phase 3 (software part): FlatBuffers message schemas and generation (Part 3.5)

**Attempted:** Fill in the four bus message schemas deferred to Phase 3 by Phase 0, and generate
their C++ headers at build time as Part 3.5 requires. `EventLog` needs the generated
`ActuationRequest` type.

**Built/changed:** `detections.fbs`, `vehicle_pose.fbs`, `actuation_request.fbs` and
`road_projected_route.fbs`, with Part 3.5's definitions verbatim. New
`cmake/FlatBufferSchemas.cmake` provides `ar_add_schema_library()`, which runs
`flatc --cpp --gen-object-api` per schema into the build tree and exposes the output as an
INTERFACE library. `common/Types.h` aliases the generated object-API structs under the guide's
names (`ActuationRequest` = `schema::ActuationRequestT`, and so on) and defines the `Config`
struct. Built `flatc` 24.3.25 from OSRM's vendored FlatBuffers source (`~/src/flatc-24.3.25-build`)
and installed only that binary to `/usr/local/bin/flatc`.

**Reasoning:** The bus carries the object-API structs (`...T`), not serialized buffers. Serialising
and parsing on every hop between two threads of one process buys nothing, and the byte form stays
available for recording and replay (Part 13.2) with no second definition of any type.
`Config` only holds the sections a built subsystem reads (vehicle params, decision thresholds).
Later phases add theirs with the code that consumes them.

**Problems hit:** The first build failed on every generated header with FlatBuffers' own
"Non-compatible flatbuffers version included". Two versions are installed. Debian's 23.5.26 is in
`/usr/include` and matches `/usr/bin/flatc`. OSRM's 24.3.25, installed on 2026-09-18, is in
`/usr/local/include`, which the compiler searches first. Removing OSRM's copy was not an option:
OSRM's public headers (`osrm/engine/api/base_result.hpp`) include it, and the host links OSRM. So
the whole host standardises on 24.3.25, and a matching `flatc` was built from the exact source OSRM
vendors.

To stop this recurring as an unexplained compile error, `FlatBufferSchemas.cmake` now compares
`flatc --version` with the version in the `flatbuffers/base.h` the compiler will see, and fails
configure with both versions and paths named. Verified against the real case: the stale cached
`/usr/bin/flatc` made configure fail with that message, and clearing the cache fixed it. CI is
unaffected: Ubuntu's `flatc` and headers come from the same apt package.

**Still open:** The main host build still has to link `ar_schemas` (done with `SystemManager`,
below).

## 2026-09-24 — Phase 3 (software part): `EventLog` (Part 11.6)

**Attempted:** Implement the host's actuation evidence log. Part 11.6 requires a monotonic
timestamp on every line and flushing that survives a crash.

**Built/changed:** `system/EventLog.h` and `src/system/EventLog.cpp`: `logActuationRequest`,
`logAckStatus`, `logFault`, `logGeneral`, plus `healthy()`. `test_event_log.cpp` has 11 tests.

**Reasoning:** Each line is one POSIX `write()` on an `O_APPEND` descriptor, with no userspace
buffer, so it is in the kernel the moment `write()` returns and survives any crash of the
process. Actuation, ack and fault lines are also `fsync()`'d, so they survive a power cut, which
matters in a car where ignition-off can take the laptop down seconds after an actuation.
`logGeneral` skips `fsync` because it is too slow for routine lines.

Timestamps are `steady_clock` milliseconds since the log opened. Wall-clock time can jump under
NTP or GPS correction and would distort request-to-ack gaps. The `SESSION_START` line records the
UTC wall time for mapping. A per-line sequence number makes a missing line provable. The timestamp
is taken inside the mutex, so line order, sequence order and time order always agree. Values are
quoted and escaped, so one event is always exactly one line.

A write or `fsync` failure latches `healthy()` false and reports to stderr. The log cannot record
its own failure. Phase 10's arbiter is meant to read this flag: a system that can no longer record
actuation evidence should not request actuation. The constructor throws if the file can't be
opened, so the system can't start without its evidence trail.

**Verification:** 11/11 pass, and 32/32 across the unit suite. The key test forks a child that
logs a fault and then `abort()`s (no destructors, no flushing). The parent finds the line on disk
and confirms `SESSION_END` is absent, proving the destructor really never ran. A concurrency test
with 8 threads × 500 lines checks that every line is well-formed, the sequence has no gaps and
matches line order, timestamps never go backwards, and no message is lost or doubled. It is clean
under ThreadSanitizer. The disk-full path is exercised by logging to `/dev/full`.

**Still open:** Wiring `healthy()` into the arbiter's arming check is Phase 10's.

## 2026-09-24 — Phase 3 (software part): `SystemManager` and `main.cpp` (Part 5.4, Part 11.5)

**Attempted:** Implement subsystem lifecycle, config loading, signal handling and the ordered
shutdown with its final zeroed `ActuationCommand`, then wire the real host entry point.

**Built/changed:** `system/SystemManager.h` and `src/system/SystemManager.cpp`: `loadConfig`,
`start<T>(args...)`, `runUntilShutdown`, `requestShutdown`, `setFinalCommandHook`,
`installSignalHandlers`, `registerCrashFrame`. `src/main.cpp` loads config, opens the log, installs
handlers and runs; each later phase adds its own `start<>` line. `test_system_manager.cpp` has 19
tests. yaml-cpp was added to both builds.

**Reasoning:** Shutdown sets `stop`, joins every thread in start order, and only then calls the
final-command hook. Once all threads have returned, nothing can produce a new actuation request,
so the zeroed command is provably the last thing the hub hears. Called earlier, a still-running
arbiter could slip a brake request in behind it.

A subsystem whose `run()` throws, or returns before being asked to, is logged as a FAULT and takes
the whole system down. A pipeline missing a stage is broken, not degraded, and stopping hands
control to the hub watchdog.

Signal handlers only do async-signal-safe things:
- SIGINT/SIGTERM set a lock-free flag, which `runUntilShutdown` polls every 50 ms.
- A second SIGINT/SIGTERM means shutdown is stuck. It writes the crash frame and calls `_exit`.
- Crash signals (SEGV/BUS/FPE/ILL/ABRT) make a single `write()` of a pre-encoded zeroed frame to a
  registered fd, then re-raise, so the process still dies with its real cause.

VehicleInterface will register that frame and fd when it opens the port. This is Part 5.4's
belt-and-braces measure; the hub watchdog does not depend on it.

`loadConfig` fails with the file and key named for anything missing, mistyped or out of range.
The brake ceiling is read as a wide integer and range-checked (0–255) rather than converted
straight to `uint8_t`.

**Problems hit:**
- *Host binary failed to link inside `libosrm.a`* (undefined Boost.Thread symbols). A static
  archive records none of its own dependencies, and `libosrm.a`'s `osrm.cpp.o` contains weak copies
  of `std::string` member functions. Once `main.cpp` used `std::string`, the linker pulled that
  object in, and its Boost references with it. This was confirmed by intersecting our objects'
  undefined symbols with the archive's definitions, not guessed. OSRM's own `libosrm.pc` can't
  supply the missing list: it contains CMake target names instead of linker flags. The new
  `cmake/FindOSRM.cmake` defines `OSRM::osrm` with the dependencies (Boost date_time, iostreams and
  thread, TBB, zlib, rt) and OSRM's compile definitions. This is the link-time failure Phase 0's
  entry predicted.
- *Test expectation wrong about the component name:* demangled type names are fully qualified.
  The test was fixed; the code was right.
- *Format check:* clang-format wrapped an example log line in `EventLog.h`'s comment, making it
  read as two lines. The example was shortened. `.clang-format-ignore` gained `**/build-*/**`.

**Verification:** 51/51 unit tests. SystemManager tests were clean under ThreadSanitizer in 3 runs.
- *Negative test:* with the final-command hook moved before the joins, the ordering test fails (0
  of 3 subsystems finished when the hook ran). Restored.
- *Signal paths, tested in forked children:*
  - SIGINT gives an ordered shutdown, exit 0, and the hook runs.
  - SIGSEGV delivers the registered frame byte-exact through a pipe and still kills the child with
    SIGSEGV.
  - An unregistered frame writes nothing on SIGABRT.
  - With a subsystem that ignores `stop`, a second SIGINT exits 130 and delivers the frame.
- *Live binary:* `build/host/ar_drive_assist` runs, and Ctrl+C gives exit 0 with the log trail
  `shutdown requested by signal → stopping 0 subsystem(s) → shutdown complete → SESSION_END`.
  A missing config dir refuses to start (exit 1, file named).
- A manual "two SIGTERMs back to back" check proved nothing: standard signals sent together
  coalesce into one delivery. That path is covered by the stuck-subsystem unit test instead.

**Still open:** VehicleInterface (Phase 3's hardware half) must call `setFinalCommandHook` and
`registerCrashFrame`, and unregister the frame before closing the port.

## 2026-09-24 — Phase 3 (software part): CI unit job repaired; architecture note on fan-out buses

**Attempted:** Get CI's `host-unit-tests` job green. It has been red since Phase 0, failing at
`apt-get install libosrm-dev`.

**Built/changed:** `.github/workflows/build.yml` drops `libosrm-dev`, which does not exist on
Ubuntu, and adds `flatbuffers-compiler`, `libflatbuffers-dev` and `libyaml-cpp-dev`.
`docs/architecture/system-architecture.md` now states that a bus with several consumers is one
`RingBuffer` per consumer.

**Reasoning:** Nothing in the unit suite needs OSRM until Phase 8's `test_map_matcher.cpp`, which
will have to choose how CI obtains OSRM. On Ubuntu, `flatc` and the FlatBuffers headers come from
one package set, so the version guard passes there. The fan-out note matters because
`frameBus`/`detectionBus` each feed several threads in Part 5.1's table, and sharing one SPSC ring
between two readers would be a data race.

**Still open:** Confirm the job actually goes green after the push.

## 2026-09-24 — Fix: clang-format disagreement between local (22) and CI (18)

**Attempted:** Confirm CI after pushing the Phase 3 software work.

**Built/changed:** `struct sigaction sa{}` became `struct sigaction sa = {}` in `SystemManager.cpp`,
and a one-statement scope block in `test_event_log.cpp` became a temporary `EventLog{path};`.

**Reasoning:** `host-unit-tests` went green, its first green run since Phase 0, which confirms the
CI dependency fix. `format-check` failed on three lines that pass locally: this machine has
clang-format 22.1.0, and CI's `ubuntu-latest` installs 18. The two versions disagree about the
spacing in `sa{}` and about collapsing a one-statement block onto a single line. The CI version
(18.1.8) was reproduced exactly in a scratch venv (`pip install "clang-format>=18,<19"`), and the
three CI errors matched. Both constructs were rewritten into forms the two versions format
identically, rather than reformatting with one version and breaking the other.

**Verification:** Both clang-format 22 and 18 report 0 violations across all tracked
firmware/host sources. 51/51 unit tests; the host binary builds.

**Still open:** The two versions can diverge again on any new code. Checking with the scratch
clang-format 18 before pushing avoids surprises until CI's formatter is pinned. `ubuntu-latest`
moves to Ubuntu 26 on 2026-10-19 per GitHub's notice, which will change CI's version again.

## 2026-09-24 — Phase 5: model selection, weights, and the ONNX/engine scripts (Part 7.1–7.3)

**Attempted:** Obtain pretrained weights for the three Part 7.1 models and write the export and
engine-build scripts.

**Built/changed:** `host/scripts/export_onnx.py` (`--model yolov8m|ufld|midas`). Each export is
verified against PyTorch through ONNX Runtime before it counts as a success.
`host/scripts/build_tensorrt_engines.sh` runs `trtexec --fp16` per model and keeps logs and
benchmark numbers in `models/engines/*.log`. Weights were downloaded to the newly gitignored
`host/models/weights/`: `yolov8m.pt` (ultralytics release) and `culane_res18.pth` (UFLDv2 release,
Google Drive). The UFLDv2 source was cloned to `~/src/Ultra-Fast-Lane-Detection-v2`. The export
venv `~/src/ar-export-env` layers over `~/ml-env` via a `.pth` path file and adds only timm 0.9.16,
gdown and onnxslim, leaving `~/ml-env` unchanged.

**Reasoning:** Part 7.1's input sizes do not match the models it names, which was checked against
the upstream sources rather than assumed:
- UFLDv2 ships only 320×800 (TuSimple) and 320×1600 (CULane/CurveLanes). 800×288 is UFLD **v1**.
  I chose CULane ResNet-18 at 320×1600, because CULane (urban, night, crowded, faded markings) is
  nearer to Nairobi roads than TuSimple's clear US highways.
- No "MiDaS v3.1 Small at 384×384" exists. v3.1's small SwinV2-T model fails to load under
  timm ≥ 0.7 (layer restructuring: size mismatches in every downsample layer). timm 0.6.x, the
  version MiDaS pins, does not import on Python 3.13. MiDaS **v2.1** Small (256×256) is used. Depth
  is relative, and metric near-field depth comes from the LiDAR.
- YOLOv8m is COCO-pretrained, so Part 7.1's five classes will be a mapping from COCO classes in
  post-processing. COCO has no generic "obstacle" class.

**Problems hit:**
- timm 0.6.12 raises a dataclass error on import under Python 3.13, and MiDaS's hub file imports
  timm even for models that don't use it.
- MiDaS small pulls a second torch-hub repository for its backbone, which prompted for trust
  interactively. It was added to `~/.cache/torch/hub/trusted_list`.
- **Running the exports was stopped by the permission classifier.** Loading the downloaded UFLD
  checkpoint with `torch.load(weights_only=False)` executes pickled code from an external file.
  The script now uses `weights_only=True` for UFLD. YOLOv8m's load inside ultralytics still
  unpickles, and MiDaS runs torch-hub repository code. No export has been run, pending Ian's
  decision.

**Still open:** Run the three exports and the engine build once permitted, then check the
`trtexec` latencies against Part 7.1's FPS targets.

## 2026-09-24 — Phase 5: `TrtEngine` (Part 7.4)

**Attempted:** Implement the per-model TensorRT wrapper against the installed TensorRT 10.16.

**Built/changed:** `inference/TrtEngine.h` and `src/inference/TrtEngine.cpp`: `load`, `enqueue`,
`sync`, `inferBlocking`, `deviceInput`, `hostOutput`, `input` and `outputs`. The new
`host/test/integration/test_trt_engine.cpp` has 7 GPU tests, ctest label `gpu`, and is not in CI.
`enable_testing()` was added to the top-level and host CMake files so ctest discovers the
integration tests.

**Reasoning:** TensorRT 10 has no binding indices or `enqueueV2`, the API Part 7.4's snippet
assumes. Tensors are found by name and given device addresses once at load with
`setTensorAddress`, and inference is `enqueueV3`.

Inference is split into `enqueue()` and `sync()`, so that MlInferenceEngine can queue all three
models before waiting on any. That is what lets the Part 7.4 streams overlap. Each engine gets a
*non-blocking* stream, so that any stray default-stream call cannot re-serialise them.

Outputs are copied into pinned host memory, so the copy is truly asynchronous. The input is a
device pointer that pre-processing writes into on the same stream, so frames never round-trip
through host memory.

The engine is rejected at load if it has a dynamic shape, non-FP32 I/O, or more than one input.
All three are signs that the wrong engine was loaded, and each would otherwise corrupt a buffer
size silently.

**Problems hit:** The `cudaMallocHost(float**)` overload lives in `cuda_runtime.h`, not the C
API header that was included. Fixed by allocating into `void*`.

**Verification:** The test needs no downloaded model. It builds its own two-output network
(`y = 2x+1`, `r = relu(x)`) with TensorRT's builder API, serialises it, and loads it through
`TrtEngine`. 7/7 pass on the RTX 5060:
- every output element is exact;
- repeated runs see their own input;
- two engines on separate streams, both enqueued before either is synced, are both correct;
- wrong-sized input throws;
- missing and garbage engine files throw.
Formatting was checked clean with clang-format 22 and 18.

**Still open:** Pre-processing into `deviceInput()` and the per-model post-processing come next.

## 2026-09-24 — Phase 5: model resolution chosen, exports run, TensorRT engines built (Part 7.3)

**Attempted:** Ian permitted running the exports and asked for the highest useful resolution per
model, one that works for both distant and very close objects.

**Built/changed:**
- `export_onnx.py` gained `--width/--height` for yolov8m and midas, and refuses them for ufld.
- Exports at the chosen sizes:
  - `yolov8m.onnx` at 1280×736;
  - `ufld.onnx` at 1600×320 (fixed by the model);
  - `midas.onnx` at 448×256.
- `build_tensorrt_engines.sh` builds all three FP16 engines, and now checks each engine's input
  shape against the expected one.
- `test_trt_engine.cpp` gained a parameterised test over the real engines. It skips when they are
  not built on the machine.

**Reasoning (resolution):**
- **YOLO only:** it is the only model where resolution is a free choice.
- **Far objects:** with an assumed ~70° horizontal FOV (to be replaced by Phase 4's measured
  value), a 1.7 m pedestrian is ≈ 1.39·W/d pixels tall at distance d. At the ~12 px YOLO needs,
  W = 1280 detects out to ~148 m. That covers ~100 km/h stopping distance (~98 m) plus ~1 s of
  tracking history.
- **Close objects:** YOLOv8 trained at 640 with up to 1.5× scale augmentation, so it has seen
  objects up to ~960 px. At 1280 a car 3 m away is ~600 px, inside that range. At 1920 and above,
  close objects exceed it, and close range is what braking depends on.
- **Shape:** 16:9 at 1280×736 (720 rounded up to a multiple of 32) spends no compute on letterbox
  padding.
- **UFLDv2:** cannot change size. Its fully-connected head's input is H/32 × W/32 × 8.
- **MiDaS:** 448×256 at the frame's 16:9 shape. *Correction, same day:* this was first
  described as MiDaS's "native 256 short side". Reading MiDaS's own small-model transform
  (`resize_method="upper_bound"`, 256) showed it caps the *long* side at 256, i.e. 256×128 for
  16:9. 448×256 is therefore ~1.75× its standard scale, a moderate increase for sharper depth
  edges. It is kept moderate because MiDaS far past its training scale loses global consistency.

**Problems hit:**
- *UFLD export failed:* its model file imports `utils.common`, which imports NVIDIA DALI and other
  training-only packages. A stand-in `utils.common` with a no-op `initialize_weights` is
  registered instead. That is safe because every weight is overwritten by the checkpoint, and
  `strict=True` proves nothing is left at its initial value. The config file is read with `runpy`,
  avoiding the `addict` dependency.
- *First engine build failed:* TensorRT rejects Part 7.3's `--shapes` flag for a fully static
  model. The flag was dropped and replaced by a post-build shape check.
- *That check falsely failed at first:* trtexec capitalises "Input binding". The match is now
  case-insensitive.

**Verification:**
- *Exports:* each matches PyTorch through ONNX Runtime. Max |Δ|: YOLO 1.1e-3 on scores, UFLD
  ≤ 8.2e-6 on all four outputs, MiDaS 8.5e-4. The UFLD checkpoint loaded with `strict=True` and
  `weights_only=True`.
- *Engines, median GPU compute each in isolation (RTX 5060 laptop):*

  | Model | Input | Median | Throughput |
  |---|---|---|---|
  | YOLOv8m | 1280×736 | 6.58 ms | 133/s |
  | UFLDv2 | 1600×320 | 2.51 ms | 344/s |
  | MiDaS | 448×256 | 1.57 ms | 556/s |

  All three are well above Part 7.1's targets (30+/30+/15–20), and even run in sequence they total
  ~10.7 ms of a 33 ms frame.
- *YOLO resolution sweep (benchmark-only builds, not kept), median:* 640×384 2.77 ms, 640×640
  3.07, 960×544 3.76, **1280×736 6.58**, 1920×1088 13.97, 2560×1440 26.45 ms. Camera-native would
  use ~80% of the frame budget on detection alone.
- *Engines in C++:* all three load in `TrtEngine` with exactly the expected tensor names and
  shapes, and produce finite outputs on a grey frame. GPU tests 10/10. Both clang-format versions
  are clean.

**Still open:**
- Isolated latencies are not the exit criterion. Part 7.1's FPS must be met on a live feed with
  pre-processing, three concurrent models and display, on a laptop GPU that throttles when hot.
- The 70° FOV assumption must be replaced by the real camera's value once Phase 4 measures it. If
  it is much wider, re-run the range arithmetic.

## 2026-09-24 — Phase 5: output decoding (YOLO boxes, UFLD lanes)

**Attempted:** Turn raw engine outputs into boxes and lane points in source-frame pixels.

**Built/changed:** `inference/Postprocess.h` and `src/inference/Postprocess.cpp` contain
`mapCocoClass`, `InputMapping` (with `letterbox`), `decodeYolo` (with class-aware NMS), `iou` and
`decodeUfld`. `test_postprocess.cpp` has 18 tests and sits in the GPU-free unit suite, so CI runs
it.

**Reasoning:**
- **No OpenCV/CUDA dependency,** so the logic every later decision depends on is checked in CI.
- **COCO → Part 7.1 class mapping:**
  - person → Pedestrian;
  - bicycle and motorcycle → Cyclist (a two-wheeler with an exposed rider, i.e. boda-boda);
  - car, bus, truck → Vehicle;
  - traffic light, stop sign → Sign;
  - large animals (dog, horse, sheep, cow, elephant, bear, zebra, giraffe) → Obstacle. COCO has
    no generic obstacle class, and livestock and wildlife are real hazards on Kenyan roads.
- **Classes are mapped *before* NMS,** so a vehicle scored as both car and truck becomes one box.
- **Safety rule: post-processing never removes a pedestrian box because it overlaps another
  class.** The common "rider suppression" trick (drop a person box overlapping a two-wheeler)
  would also drop a real person standing beside one, and a missed pedestrian is the unsafe
  direction.
- **`decodeUfld` ports UFLDv2's `pred2coords`:** row anchors for the ego-lane boundaries, column
  anchors for the outer lanes, the > ½ and > ¼ presence rules, and a soft-argmax over ±1 cell.
  Its softmax subtracts the max logit first (overflow-safe), and it keeps float coordinates where
  upstream truncates to int.

**Verification:** 18/18, and 69/69 across the unit suite. The expected values are hand-computed:
- the production letterbox (2560×1440 → 1280×720 + 8 px bands) and the 1080p fallback;
- decoding into source pixels, thresholding, unmapped-class handling, NMS, car+truck merge,
  clipping into padding, and `maxDetections`;
- the pedestrian-never-suppressed rule;
- lane anchor rows, both presence thresholds at their exact boundaries, soft-argmax refinement
  towards a strong neighbour, and finiteness with 500-valued logits.

**Still open:** Cross-check both decoders against the upstream Python on *real* model output for
a real road frame (needs footage).

## 2026-09-24 — Phase 5: GPU pre-processing

**Attempted:** Convert a GPU camera frame into each engine's input tensor, on that engine's
stream.

**Built/changed:** `inference/Preprocess.h` and `src/inference/Preprocess.cpp`: `PreprocessSpec`
(`yolo`, `imagenet`) and `Preprocessor::run`. `host/test/integration/test_preprocess.cpp` has 5
GPU tests.

**Reasoning:** The pipeline is region → resize (letterbox for YOLO, pad 114 as in its training)
→ BGR→RGB → /255 → per-channel normalise (ImageNet stats for UFLD/MiDaS, none for YOLO) → HWC to
CHW. The last step is `cuda::split` into three GpuMat headers laid over the engine's input
buffer, so there is no extra copy. Every call is on the caller's stream, so the three models'
pre-processing overlaps like their inference. Scratch buffers are allocated once per model.

The lane model will receive a CULane-shaped band (2.78:1) around the horizon rather than the
whole frame squashed. It was trained on that shape, and squashing 16:9 into it distorts road
geometry by ~1.7× vertically. The band's position will be configuration, because it depends on
the final camera mount.

**Verification:** 5/5 GPU tests with hand-computable expectations:
- a pure-red frame gives exactly `(1−.485)/.229`, `−.456/.224`, `−.406/.225` in the R, G, B
  planes;
- YOLO's 8 padding rows each side are exactly 114/255, with the content exactly 1.0;
- a white square lands where the returned mapping predicts;
- an ROI excludes the rest of the frame and offsets the mapping;
- a bad ROI and a wrong pixel type throw.

Negative test: with BGR→RGB removed, the channel test fails. Restored and re-verified. (The first
two attempts at this negative test printed nothing: my grep pattern had one space where
GoogleTest prints two, in `FAILED  ]`. The failure was confirmed from unfiltered output.)

**Still open:** The Phase 4 camera is not bought yet, so real frames for the band placement and
the live check must come from recorded footage.

## 2026-09-24 — Phase 5: `MlInferenceEngine`, debug viewer, and a first run on real footage

**Attempted:** Assemble the inference thread and check its output on real road video, since the
Phase 4 camera does not exist yet.

**Built/changed:**
- `camera/CameraFrame.h`.
- `inference/MlInferenceEngine.h` and `src/inference/MlInferenceEngine.cpp`: `process()`, `run()`
  (SystemManager contract) and `laneBand()`. It publishes a `DetectionFrame` on the detection bus
  and a `DepthFrame` on its own bus, paired through `depth_map_ref` = frame sequence number.
- `host/tools/inference_viewer.cpp`, a new CMake target outside `src/` so its `main` never enters
  the app. It draws boxes, lanes, the lane band and a depth inset, reports latency percentiles, and
  takes `--band-top`, `--snapshots`, `--out` and `--dump`.
- `Preprocessor::setRoi`.
- Test footage in `data/footage/` (gitignored), with source and CC BY 3.0 attribution in
  `data/README.md`.

**Reasoning:**
- **Upload ordering:** the frame is uploaded once. Each model stream waits on a CUDA event recorded
  after the upload (`cudaStreamWaitEvent`), so the ordering is enforced on the GPU without
  blocking the CPU.
- **Sizes from the engines:** pre-processing sizes come from each engine's input shape, so a
  rebuilt engine at another resolution needs no code change.
- **UFLD outputs by name,** because TensorRT does not guarantee declaration order.
- **Lane band:** UFLD sees the bottom 60% (upstream `crop_ratio`) of a CULane-shaped band. The
  decoder maps against the full band, as upstream does.
- **Footage:** "City Driving 4K – Kraków Poland 2024" (Relaxing Roads 4K, CC BY 3.0). It is
  2560×1440, exactly the planned camera resolution. Only the first 120 s was fetched, in one
  contiguous range request.

**Problems hit:**
- *Clip download:* seeking inside the remote WebM made many range requests and Wikimedia returned
  HTTP 429. It was replaced by a single range request for the first 200 MB, cut locally with
  `ffmpeg -c copy`.
- *Privacy slip, mine:* the earlier `ffprobe` of that URL sent Ian's email address in its
  User-Agent. Wikimedia's policy asks for contact details, but Ian had not agreed to share his
  email with any service. All later requests used a User-Agent without it.
- *Lane band placement:* the default band (top at 0.25) sat too high for this footage (horizon
  ~58% down) and cut off the nearest ~100 px of road. The band top was changed to 0.32, and the
  ego-left lane then followed the double white line down to the bonnet. The 0.32 default fits
  this footage's camera mount, not the project's; Part 12 must re-tune it.
- *Viewer crash:* the viewer aborted with an uncaught exception when run outside the repository
  root, because engine paths are relative. It now reports the error and exits 1, verified.

**Verification:**
- *Timing, 600 frames, 2560×1440, first 10 excluded as warm-up:*

  | Measure | Median | p95 | Max |
  |---|---|---|---|
  | Upload → all three models synced | 10.5 ms | 14.1 ms | 18.4 ms |
  | Including decode | 12.8 ms | 16.6 ms | 20.9 ms |

  That is ~78 FPS at the median. The worst frame is still inside 33 ms, so Part 7.1's 30+/30+/15–20
  targets are met with all three models running concurrently.
- *Visual, frames 0/120/240/360/480:*
  - boxes on parked and moving cars, a van, and a pedestrian crossing ahead (0.87);
  - a distant pedestrian ~48 px tall detected at 0.71;
  - ego-left lane on the double white line;
  - no ego lanes at an unmarked junction, which is correct;
  - depth brightest on the road nearest the car.

  The ego-right lane followed a faint worn marking (plausible, unconfirmed), and the outer-right
  lane was noisy.
- *Independent cross-check:* ultralytics' reference pipeline (its own letterbox + PyTorch FP32 +
  its NMS) on the identical frames, with the same class map:

  | Frame | Ours | Reference | IoU | Confidence difference |
  |---|---|---|---|---|
  | 120 | 5 | 5, all matched | 0.976–0.997 | ≤ 0.03 |
  | 360 | 3 | 3, all matched | 0.964–0.989 | ≤ 0.05 |

  No missing or extra boxes. This validates GPU pre-processing, the TensorRT FP16 engine, the
  decoder and NMS together.
- Unit 69/69, GPU 15/15, and both clang-format versions clean.

**Still open (Phase 5 is NOT complete):**
- Part 14's exit criterion requires a **live camera feed** at target FPS. Recorded footage is not
  a substitute; this needs the Phase 4 camera.
- The UFLD decoder is validated by unit tests and visually (points lie on real markings), but not
  numerically against upstream `pred2coords` on real output.
- The footage is European. Accuracy on Kenyan roads (boda-bodas, matatus, unmarked roads,
  livestock) is untested until the project's own recordings exist.
- Frame upload uses pageable memory. Pinned host memory (`cv::cuda::HostMem`) would make it
  asynchronous if profiling shows the upload matters.

## 2026-09-24 — Phase 5: full annotated run of the test footage, for review

**Attempted:** Ian asked to see the models running on real road footage.

**Built/changed:** `inference_viewer` gained dark backing panels behind its text (it was
unreadable over bright sky), a class/lane legend, and the CC BY 3.0 attribution line the footage
licence requires. It now writes video at the source frame rate, so playback is real-time. The
output is `data/footage/annotated/krakow_annotated.mp4` (120 s, 1280×720, 60 fps, H.264, 133 MB,
gitignored).

**Verification:**
- *Timing, all 7,200 frames at 2560×1440:* median 13.05 ms, p95 16.6 ms, max 25.1 ms. The worst
  frame in two minutes is inside the 33 ms budget. Mean 9.7 boxes per frame. Ego lanes present in
  ~78–79% of frames.
- *Spot-checked frame at 38 s:* stop sign 0.90 and traffic light 0.30. Three pedestrians on the
  pavement, including a child at 0.29, a low-confidence detection of exactly the kind the
  never-suppress rule protects. Ego lane on the kerb and road edge.
- *One clear false positive:* a large "vehicle" box on a building wall at the left frame edge.
  Single-frame false positives like this are what Phase 7's tracker (a detection must persist
  across frames to become a track) is meant to filter.

**Still open:** Ian's review of the full video.

## 2026-09-24 — Road-sign detection extension: scope, overnight training launched, AR behaviours

**Attempted:** Ian found the detector weak on road signs, and chose a dedicated fourth model
trained on the Mapillary Traffic Sign Dataset (MTSD). He also defined the purpose of signs:
understand each sign and show the driver spatially, racing-game style (a holographic stop
barrier, barriers across forbidden turns, the speed limit against actual speed with an F1-style
colour-graded route line), for navigation and safety.

**Built/changed:** `docs/architecture/sign-behaviours.md` gives per-class AR behaviours for all 29
detector classes, 7 cross-cutting rules, and the phase each capability lands in. An overnight
background agent was launched to obtain MTSD, train the model, export and benchmark it, and
evaluate it on openly licensed Kenyan imagery. Its own progress-log entries and report
(`docs/experiments/2026-09-25-sign-detector-overnight.md`) follow.

**Reasoning:**
- **Root cause is vocabulary, not resolution:** COCO has only "stop sign" and "traffic light".
  That rules out threshold or resolution fixes.
- **A separate small model (YOLOv8s)** rather than retraining YOLOv8m keeps the safety-critical
  detector untouched.
- **Speed limits are one class per value,** so the detector reads the number without a second
  classifier.
- **No horizontal flips** in training (they swap left/right meanings).
- **Kenya is left-hand traffic,** which decides which lane boundary "no overtaking" marks and which
  side signs appear on.
- **The overriding rule, kept from Part 9:** signs never actuate. A wrong sign can at worst draw a
  wrong graphic.

**Problems hit:** MTSD needs Ian's own Mapillary login. The download links are emailed and valid
for 5 days, so no unattended process could fetch it without him. Ian chose to let the agent read
**only** the `from:mapillary` email in his Gmail to take the links. At launch the email had not
arrived yet; Ian was asked to request the dataset. The one public mirror checked (Hugging Face) was
a 2,000-image shape-only subset with no licence, so it is unusable. The agent was told not to use
YouTube for Kenyan footage (licence and ToS) and to use KartaView (CC BY-SA 4.0) and Wikimedia
Commons instead.

**Still open:**
- The overnight results.
- Whether ~10 h of wall time allows both the ~42 GB download and meaningful training depends on
  bandwidth.
- The behaviours are design only; implementation lands in Phases 7–11.

## 2026-09-24 — Sign detector: MTSD label mapping and YOLO conversion

**Attempted:** Turn the Mapillary Traffic Sign Dataset (fully annotated part) into a YOLO dataset
with the 29 target classes (stop ... other_regulatory), as the first step of a fourth,
sign-specific detector.

**Built/changed:**
- `host/scripts/prepare_mtsd.py`: reads the real label list (401 labels, 206,386 boxes over
  41,909 annotation files), maps every label, writes `host/scripts/mtsd_class_map.json`, converts
  train/val to `data/datasets/mtsd_yolo/` (long side capped at 2048 px, boxes rescaled through
  normalised coordinates) and writes `mtsd.yaml` and `instance_counts.json`. It is re-runnable:
  images already re-saved are not re-encoded, but labels are always rewritten.
- `host/scripts/mtsd_uncertain_unit_speed_variants.json`: speed-limit designs dropped as mph or
  unclear.
- `host/scripts/extract_growing_zip.py`: extracts complete entries of a zip that is still
  downloading (MTSD stores its JPEGs uncompressed, sizes in each local header, CRC checked), so
  conversion can overlap the slow download.
- `.gitignore`: `host/models/training/` and `data/datasets/`.

**Reasoning:** The mapping was written only after reading the real labels and looking at crops of
every mapped design variant (e.g. the MTSD names are `regulatory--yield`, `warning--road-bump`,
not "give-way"/"speed-bump"). The conservative choices are in docs/decisions.md.

**Verification:** 10 random converted train images drawn with their boxes and looked at (visual
check, not measured): every box sits on a sign and the class names match (stop, give_way,
no_entry, speed_limit_50/60, pedestrian_crossing on a yellow school-crossing diamond,
keep_left_or_right on blue keep-right discs, no_parking on the P-with-slash disc). No conversion
bug found. Val zip MD5 matches Mapillary's list.

**Problems hit:** On the partial data (6,314 train + 5,320 val images) many classes are small:
speed_limit_10 (13 train boxes), 110 (15), 120 (21), end_of_restriction (36), 90 (38) and 20 (39).
The full train set is ~5.8x larger.

**Still open:** train.0/1/2 still downloading (~2.2 MB/s aggregate). Final per-class counts come
from the final conversion run.

## 2026-09-25 — Sign detector: training data ready, training started (train.0 + val)

**Attempted:** Download the fully annotated MTSD parts and start training on what the time budget
allows.

**Built/changed:**
- Downloaded and MD5-verified against Mapillary's own list: annotations (121 MB), val (4.57 GB,
  5,320 images) and train.0 (10.38 GB, 12,197 images; the zip's entry count matches the files
  extracted). train.1 and train.2 (10.4 GB each) are still downloading in the background for a
  later run. Test (no public labels) and the partially annotated set (not fully labelled) were not
  downloaded.
- Final conversion: 12,692 train images (train.0 plus ~500 that train.1/2 had delivered while
  paused) and 5,320 val images; 391 panoramas skipped. Per-class train/val box counts are in
  `data/datasets/mtsd_yolo/instance_counts.json`. Smallest: speed_limit_10 23/12, 110 29/14,
  120 38/14, end_of_restriction 68/37, speed_limit_20 72/28, 90 77/27, 100 89/44.
- `host/scripts/train_sign_detector.py` started at 00:35 EAT: YOLOv8s from COCO `yolov8s.pt`,
  imgsz 1280, batch 8, fliplr 0, flipud 0, amp, 8 workers, `time` = 4.94 h (ends by 05:30).

**Reasoning:** At the measured ~2.2 MB/s the full train set would have arrived around 03:10,
leaving about 2 h of training. That is below the brief's 4 h threshold, so its fallback was used
(docs/decisions.md). A later request to extend training to 08:00 could not be applied in this
run, so the original deadline stands.

**Problems hit:** A first run on partial data (23:53) was stopped before its first epoch ended. It
left no weights (`host/models/training/signs_v1_partial_superseded/`). The overnight session was
also paused by a usage limit around 23:00–23:50; the downloads kept running.

**Still open:** Training results; train.1/2 are for a retrain on the full ~36.6k training images.

## 2026-09-25 — Sign detector: Kenyan evaluation imagery collected

**Attempted:** Collect openly licensed real Kenyan road imagery with signs, to evaluate the sign
detector on the target domain.

**Built/changed:** `host/scripts/fetch_kenya_imagery.py` (KartaView, CC BY-SA 4.0) and
`host/scripts/fetch_commons_kenya.py` (Wikimedia Commons, licence read from Commons metadata,
only CC0/CC BY/CC BY-SA kept). 300 images in `data/footage/kenya/` (199 KartaView from Nairobi and
the A104, 101 Commons), with per-file author/licence manifests. Sources and attribution recorded
in `data/README.md`.

**Reasoning:** Both sources have explicit open licences and public APIs. Requests were serial,
with pauses, back-off on 429/5xx and a User-Agent without personal data.

**Problems hit:** KartaView's v2 bounding-box sequence search answers "Restricted access"; the v1
list endpoint works but returns only ~15 sequences for Nairobi and none for Mombasa, Eldoret,
Kisumu or Thika town. One KartaView storage host returned HTTP 500 for over an hour. Commons began
answering HTTP 429 after ~100 files (the thumbnail width was not a standard size; now fixed to
1280). No Thika Road / Mombasa Road / Waiyaki Way sequences specifically were found.

**Still open:** The set is dominated by one contributor and many frames have no sign. Ian's own
dashcam recordings will be the real test set.

## 2026-09-25 — Sign detector: overnight run reviewed; full-data retrain until no improvement

**Attempted:** Review what the overnight agent completed, then carry out Ian's instruction to keep
training "until its confidence cannot be improved anymore".

**Built/changed:**
- `host/scripts/train_sign_detector.py` gained `--name`, `--epochs`, `--patience` and
  `--end none`. The defaults keep the old behaviour.
- A detached pipeline, `host/models/training/run_signs_v2.sh` (gitignored, log beside it in
  `signs_v2_pipeline.log`):
  - re-extracts train.1 and train.2;
  - verifies every image in all four zips is on disk at full size;
  - converts, skipping already-converted images;
  - trains `signs_v2`, warm-started from `signs_v1/weights/best.pt`, on all ~36.6k training
    images, with `patience=15` and `epochs=60`.

**Reasoning:**
- *What happened overnight:* the agent was stopped twice by usage limits (~23:00 and ~04:50). It
  never received the 08:00 extension. `signs_v1` trained on train.0 only (12,411 images) for
  22 epochs within its 4.94 h budget.
- *Its curve shows it was still improving:* mAP50 0.16 → 0.39 (ep 10) → 0.533 (ep 22); mAP50-95
  0.114 → 0.418. More data and more epochs should help.
- *"Cannot be improved anymore"* is implemented as standard early stopping. Training ends once
  validation fitness (0.1·mAP50 + 0.9·mAP50-95) has not improved for 15 consecutive epochs.
  `epochs=60` is a safety cap, and it also sets the learning-rate decay length. At ~31 min per
  epoch on 36.6k images (extrapolated from v1's ~10.7 min on 12.4k), the cap is ~31 h.
- *Warm start from v1:* it already knows the sign classes, so it converges faster than starting
  from COCO.
- *Detached (`setsid nohup`):* a session or usage-limit cutoff can no longer stop the run. This is
  what cost the night twice.

**Problems hit:** The first extraction of train.1/2 was cut off with the session. The images on
disk (36,314) were short of the ~41.9k expected, and a half-written JPEG would have been skipped
by unzip's no-overwrite mode. The pipeline re-extracts with overwrite and then verifies sizes
against the zip listings before converting.

**Still open:**
- The v2 results.
- v1 was never exported or evaluated on the Kenyan imagery (the agent stopped first). Evaluation
  will be done once, on the final model.
- The overnight report `docs/experiments/2026-09-25-sign-detector-overnight.md` was never
  written.

## 2026-09-25 — Guide amendment: AR overlays rendered on the GPU (Part 10)

**Attempted:** At Ian's instruction, switch the guide's overlay rendering from OpenCV CPU drawing
to GPU work, so the holographic sign behaviours can be drawn at the full 2K resolution. He also
asked what the box overlays are for.

**Built/changed:** `docs/BUILD_GUIDE.md` Part 10.1–10.4 rewritten, and the Phase 11 deliverables
in Part 14 updated:
- `CompositedFrame` carries video + an `OverlayScene` draw list;
- `OverlayItem` geometry is either image-space or road-space (vehicle-frame metres, projected in
  the vertex shader);
- `WindowedSink` draws the video texture (PBO upload) and then an overlay shader pass, at native
  display resolution, with no OS scaling;
- `ArRenderer` builds the scene (`addHazardHighlights`, `addLaneOverlay`, `addNavigationOverlay`,
  `addSignBehaviours`, `addSpeedAndWarnings`) and draws nothing itself;
- the 10.4 benchmark now times the upload and the overlay pass separately, and its native-Windows
  fallback sends video + `OverlayScene` over TCP.

**Reasoning:**
- **Why the GPU:** the translucency, glow, gradients and pulsing are per-pixel blending of
  several 2K layers per frame. That is trivial on the GPU and a real cost on the CPU.
- **Why a draw list instead of composited pixels:** a future optical `ProjectorSink` must draw
  overlays *without* the video, and pre-composited pixels could never support that.
- **Road-locked items:** projecting them with the same calibration as perception means they land
  where the detections are.
- **Checked display facts:** the development laptop's panel is 2560×1600 @ 240 Hz at 150% Windows
  scaling, so a 2560×1440 frame maps 1:1 if OS scaling is avoided. Otherwise it is resampled from
  1707 px and blurred.
- **What the boxes are for (answer to Ian):** they show the driver what the system has noticed
  and judged a hazard (Part 9.2: tailgating, erratic speed, swerving, forward-collision risk), so
  a warning or brake never arrives unexplained. They are also report evidence (Part 16). In the
  driver view they become threat-styled hazard highlights on relevant objects only; the
  every-detection boxes stay in the debug viewer.

**Still open:**
- The report's description of the `DisplaySink` interface must be updated to match.
- Whether CUDA/GL interop is available under WSLg (not assumed) will be settled by the 10.4
  benchmark.

## 2026-09-25 — AR overlay design: hazards join the sign language; guide amended

**Attempted:** Ian's design for hazards. Instead of boxes, a dangerous car, pedestrian, animal or
obstacle is shown with the same road-placed elements as signs, plus a subtle shimmering glow on
the object whose colour follows its risk. Tailgating is shown as a following-distance zone (my
proposal, agreed). He asked for the documentation and guide edits now, and the model work after
the sign training.

**Built/changed:**
- `docs/architecture/ar-overlay-design.md` replaces `sign-behaviours.md`:
  - §0: a shared visual-language table;
  - §1: 8 rules for all overlays. Rule 4 is now "never hide a hazard"; rule 8, "ordinary traffic
    gets nothing", is new;
  - §2: the sign behaviours (unchanged, except that the crossing escalation now uses hazards);
  - §3: hazards, with risk level `r`, the object glow, and forward-collision, pedestrian/animal,
    tailgating, swerving-neighbour and obstacle behaviours;
  - §4: a capability/phase table, adding YOLOv8m-seg masks and `r`.
- `docs/BUILD_GUIDE.md`:
  - Part 3.5: `mask_ref` in `DetectionFrame`;
  - Part 7.1: table amended (YOLOv8m-seg; the sign-detector row; the real lane/depth models and
    sizes), with 7.3 superseded by the scripts;
  - Part 10.1: object-mask geometry, and rule-4 enforcement (rim glow; road items masked by
    silhouettes);
  - Part 10.3: `addHazards`, and the hazards-not-boxes specification;
  - Part 10.4: the benchmark scene now includes shimmering glows;
  - Part 14: Phase 11 deliverables.

**Reasoning:**
- *One visual language:* every element means the same thing, whether it comes from a sign or a
  hazard.
- *The glow follows the object's real outline,* which needs per-object masks. A box-shaped glow
  would reintroduce the rectangle Ian wants gone, so the detector moves to YOLOv8m-seg (same COCO
  classes and export path).
- *`r` comes from the same TTC and Part 9.2 measures the arbiter uses,* so the display and the
  brake decision agree. It never feeds actuation.
- *The shimmer is capped at ~3 Hz* to avoid strobing.
- *Road graphics are masked by silhouettes,* so they sit behind objects, as rule 4 requires.

**Still open:** the YOLOv8m-seg work, deferred until the sign training ends:
- export and engine;
- a mask decoder with unit tests;
- `detections.fbs` `mask_ref` and the mask bus;
- timing against the current 6.6 ms;
- confirming the box outputs match the current detector's behaviour.

The report's descriptions of the display interface and the model table must follow the guide.

## 2026-09-25 — Guide amendment: mask-based LiDAR fusion and startup extrinsic verification

**Attempted:** Two proposals from Ian, written into the guide:
- (1) match each object's YOLOv8m-seg mask with its LiDAR points;
- (2) have the system calibrate the LiDAR–camera mapping when it starts, for the most accurate
  mask/3D matching.

**Built/changed:** `docs/BUILD_GUIDE.md`:
- Part 8.3 rewritten: mask-based fusion, with 7 rules;
- new Part 12.2.1: `ExtrinsicMonitor`, with its states `UNVERIFIED`/`VERIFIED`/`REFINED`/
  `DEGRADED`;
- Part 13.1 gains `test_mask_lidar_fusion.cpp` and `test_extrinsic_monitor.cpp`;
- Part 14 Phase 6/7 deliverables and exit criteria include them.

Decisions logged.

**Reasoning:**
- *Masks over boxes:* masks give each object its own points, so range, ground-contact point,
  velocity and TTC are the object's own. This matters most for the thin or partly hidden
  objects that are hazards.
- *Each fusion rule answers a known failure mode:*
  - motion compensation, because the Livox pattern accumulates over ~100 ms;
  - mask erosion, because ¼-resolution masks are soft and extrinsic error shifts projections;
  - nearest depth mode, because a mean is dragged by stray points;
  - the parallax depth test, because the two sensors sit in different places.
- *The LiDAR-veto rule:* an unexplained cluster in the path is still an obstacle, so a camera
  miss can never hide a real object.
- *Startup calibration is verification + bounded refinement, not from-scratch:*
  - at startup the car is usually stationary in a poor scene, where a free solve can converge
    wrongly with confidence;
  - bounds, held-out checking, and rejection of solutions at the bound make a bad refinement
    detectable rather than silent;
  - in `DEGRADED`, braking relies on LiDAR-only ranges, which need no camera alignment. A wrong
    self-calibration can therefore never reach the brake, in keeping with the hard safety rule.

**Still open:** Implementation in Phases 6–7. The maths (projection, erosion, depth modes,
scoring, bounded search) can be built and unit-tested on synthetic data before the LiDAR exists.
The arbiter's LiDAR-only corridor mode belongs in Phase 10.

## 2026-09-25 — Guide amendment: motion prediction (Part 9.1)

**Attempted:** Ian proposed a model that collects points, derives their velocity vectors and
predicts their motion, and asked for the full mathematical and engineering treatment, then for it
to be written into the guide.

**Built/changed:**
- `docs/BUILD_GUIDE.md`:
  - Part 9.1 rewritten: `MultiObjectTracker` (IMM: CV / CTRV-UKF / stopping) and
    `MotionPredictor`;
  - new 9.1.1 (the limits of prediction), 9.1.2 (closest point of approach and collision
    probability), 9.1.3 (NIS, ADE/FDE) and 9.1.4 (scope);
  - Part 9.2 gains a tracker-based swerving definition plus sudden-braking and crossing/cut-in
    warnings;
  - Part 9.3 gains an explicit statement of what prediction may not do;
  - Part 10.3 gains predicted-path ribbons and latency compensation;
  - Part 13.1 gains `test_motion_predictor.cpp`;
  - Part 14 Phase 7 deliverables and exit criteria updated.
- `docs/architecture/ar-overlay-design.md`: §3.1 `r` includes collision probability; §3.4
  crossing barriers go at the predicted conflict point; new §3.8 (predicted paths, ghosts, latency
  compensation); §4 table.

**Reasoning:**
- *Object-level, not point-level:* the Livox scan is non-repetitive, so individual points have no
  successor, and per-point velocity is noise. Objects measured through their points (L-shape fits,
  ICP registration) give real motion. Centroids are rejected because visibility changes fake
  sideways velocity.
- *IMM:* road users switch behaviour. The stopping model's rising probability gives early warning
  of a lead vehicle braking, and matatus stopping without warning are a real case.
- *The limits are shown with numbers:* ~1.4 m/s raw velocity noise per frame at 10 Hz, and
  pedestrian position uncertainty ~0.35 m at 0.5 s, ~1.1 m at 1 s, ~4.1 m at 2 s. So predictions
  are displayed as regions, and ~1.5 s is the honest physics horizon.
- *CPA:* it covers crossing and cut-in cases, which TTC misses.
- *Braking stays on current measured range and closing speed:* forecast-based braking risks
  phantom stops and would make the brake rule unauditable. The IMM still changes the closing-speed
  estimate, so its error and lag are gated by a test before Phase 10.
- *Latency compensation:* ~40–60 ms is ~0.75 m for a car crossing at 15 m/s. Drawing at the
  predicted display-time position keeps graphics attached to moving objects.

**Still open:** Implementation in Phase 7. All the maths (UKF, IMM mixing, CPA, NIS) can be built
and unit-tested on synthetic trajectories before the LiDAR exists. The per-class noise must be
tuned on real recordings.

## 2026-09-25 — Sign detector: GPU fault at epoch 21 (power-source change); resumed with auto-retry

**Attempted:** A progress check found training stopped since 19:49.

**Built/changed:** `host/models/training/resume_signs_v2.sh` (gitignored) resumes `signs_v2` from
`last.pt` and retries up to 5 times after a crash, 60 s apart. It writes its PID to
`resume_signs_v2.pid`. Training resumed at 19:58 from epoch 21.

**Reasoning:**
- *Evidence:* validation after epoch 20 died with `torch.AcceleratorError: CUDA error: unknown
  error` at 19:49. Windows' System log shows two Kernel-Power "Power source change" events at
  19:48:37–38, one minute earlier. The likely cause is the laptop GPU's power-state transition when
  moving between mains and battery, under full load. It was not a training bug.
- *Nothing lost:* epoch 20 had completed and been saved; it is also the best so far (mAP50 0.684,
  mAP50-95 0.547, from 0.533 / 0.418 for v1).
- *Auto-retry:* a transient GPU fault costs at most the epoch in progress.

**Problems hit:** My liveness check `pgrep -f run_signs_v2.sh` matched the checking shell's own
command line, which contains that string. It kept reporting RUNNING after the pipeline had died.
The background watcher meant to trigger the YOLOv8m-seg work used the same check, so it would
never have fired. It was stopped and replaced by a watcher on the resume job's PID file.

**Still open:** Ultralytics' resume restores the epoch and optimiser state, but the early-stopping
window counts again from the resume point, which is more lenient by at most the epochs already
elapsed since the best. It is noted here in case the stop epoch looks late.

## 2026-09-26 — Sign detector: retry limit raised from 5 to 7

**Attempted:** Ian asked to raise the training job's crash-retry limit from 5 to 7. By then it
had used 3 attempts: crashes at 21:05 and 00:47, the same `CUDA error: unknown error`.

**Built/changed:**
- `host/models/training/resume_signs_v2.sh`: the attempt range is now configurable
  (`START_ATTEMPT`, `MAX_ATTEMPTS`, default 1..7). The new version was written to a temporary file
  and renamed over the old one.
- New `host/models/training/extend_retries.sh`: waits for the running job's PID to exit. If the log
  says it gave up, it continues with attempts 6–7. Both files are gitignored.

**Reasoning:** The live job's `for` loop was parsed when it started, so editing its script cannot
change its limit. Bash also reads scripts incrementally, so editing the file in place under a
running process can corrupt what it executes next. The atomic rename leaves the running process on
its already-open copy, and the extender adds the two extra attempts from outside it. The effective
limit is 7, and the live training was never touched.

**Still open:** None. Training was at epoch 45/60, best mAP50 0.7125 / mAP50-95 0.5696 (epoch 44).

## 2026-09-26 — Sign detector: signs_v2 training complete (60 epochs, full MTSD)

**Attempted:** Finish the full-data retrain until validation stopped improving (Ian's
instruction).

**Built/changed:** `host/models/training/signs_v2/weights/best.pt` (epoch 53) and `last.pt`
(epoch 60). The run finished normally at 16:05:54 on 2026-09-26, after 5 GPU-fault resumes
(epochs 21, 23, 30, 50, 51), all recovered automatically.
`host/scripts/show_results.py` prints `results.csv` as a table, marking the best epoch,
resumes and the mosaic-off epoch. `host/scripts/align_csv.py` was written and tested, then
unused, because Ian cancelled the in-place alignment of `results.csv`.

**Reasoning / results:**
- **Final validation of `best.pt`** (5,210 images, 6,330 signs): P 0.816, R 0.613,
  **mAP50 0.716, mAP50-95 0.572**, against v1's 0.533 / 0.418 (+34% / +37%).
- **The run ended at the 60-epoch cap, not by early stopping.** mAP50-95 had been flat within
  0.5713–0.5727 since ~epoch 47. Mosaic-off (epochs 51–60) gave no final gain. Training losses
  kept falling while validation losses stayed flat: converged, with the onset of overfitting.
- **Per class, strongest (mAP50):** stop 0.869, no_overtaking 0.866, road_hump 0.827,
  no_parking_or_stopping 0.827, pedestrian_crossing 0.818, give_way 0.811.
- **Weakest:** speed limits 10 (0.431), 20 (0.448), 120 (0.530), 60 (0.547), 80 (0.605), with
  low recall (speed_limit_60 R 0.361 despite 88 instances), plus no_left_turn 0.633.
- **The model misses more than it invents.** Precision is ≥ 0.75 for most classes, while
  recall is the limit (0.613 overall, flat since ~epoch 22). That points to data (rare classes;
  confusion between similar speed values), not training length.
- **Recall is per frame, not per sign.** A sign stays in view for many frames on approach, so
  the tracker's multi-frame confirmation sees it several times. Per-sign detection will be
  higher than 0.61, but that needs measuring on video, not assuming.
- **Speed:** ultralytics reports 8.0 ms inference per image at batch 1 in PyTorch. The
  TensorRT FP16 engine is measured next.

**Still open:** Export + engine + benchmark, the Kenyan evaluation, and the overnight report;
then the YOLOv8m-seg work.

## 2026-09-26 — Sign detector: known gaps and the improvement plan

**Attempted:** At Ian's request, record the sign model's gaps and how to close them, with evidence
from the final validation (per-class metrics, `signs_v2/confusion_matrix_normalized.png`,
`data/datasets/mtsd_yolo/instance_counts.json`).

**Gaps found:**

1. **Missed speed-limit signs (the largest gap).** In the confusion matrix, 40–55% of true speed
   limit 10/20/60/80/110/120 signs are predicted as *background*: not detected at all. Other
   speed limits lose ~25–35%. Confusion between values is small (~5–15%: 120→110, 10→70/30).
   - *Correction to my own earlier statement:* limit 60 (R 0.361) was attributed to confusing
     60/80/50. The matrix shows it is mostly missed, not misread.
   - *Also corrected:* training instances on the full data are 79 (10), 195 (20), 95 (110) and
     94 (120), not the 23–38 quoted from the train.0-only run. Limit 60 has 607, so scarcity
     alone cannot explain its recall.
2. **A cause we introduced ourselves: dropped boxes become negatives.**
   - `prepare_mtsd.py` removes boxes flagged `ambiguous` (68,560 across MTSD) and the
     uncertain-unit speed variants. Removing a label does not remove the sign from the image; it
     becomes *background*, so training teaches the model that small, distant or hard-to-read
     signs are "not a sign".
   - That fits the pattern: the most-missed classes are the ones most often small and far away.
   - The same applies to information/complementary signs dropped as background.
3. **False positives concentrate in the catch-all classes.** In the matrix's background column,
   other_warning (~0.4) and other_regulatory (~0.25) fire on non-signs. These are likely the
   dropped information/complementary signs, which look like signs.
4. **Recall is the limit overall.** Recall 0.613 with precision 0.816; recall flat since
   ~epoch 22, while more epochs only lowered training loss. It is a data problem, not a training
   length problem.
5. **Left/right asymmetry.** no_left_turn mAP50 0.633 vs no_right_turn 0.778. Horizontal flip is
   disabled (correctly: it swaps meanings), so each direction learns only from its own examples.
6. **Domain gap: no Kenyan training data.** MTSD is mostly Europe/Americas/Asia. Kenyan signs are
   UK-style, but faded, rusted, hand-painted, vegetation-covered and text-board signs
   ("BUMPS AHEAD", matatu stages) are unrepresented. Kenyan performance is unmeasured until the
   evaluation (next task).
7. **Evaluation gaps.** Recall is per frame. Per-sign recall over a video approach (with the
   tracker's multi-frame confirmation) is unmeasured, as is performance at night and in rain,
   and by sign pixel size.
8. **Resolution.** Images were capped at 2,048 px on the long side and trained at 1,280. Distant
   signs are a few pixels wide at that scale.

**Improvement plan, highest expected payoff first:**

1. **Stop teaching misses. Mask, don't drop.** In `prepare_mtsd.py`, paint ambiguous and excluded
   boxes out of the image (fill with the dataset mean grey), so they count as neither sign nor
   background, instead of deleting the label. Cheap: one retrain. It targets gap 1 at its
   likely cause.
2. **Kenyan data with active learning.** Record Kenyan drives. Run the model; queue for labelling
   the frames with low-confidence or flickering detections (where it is least sure). Label a few
   hundred in CVAT or Label Studio, and fine-tune. This targets gap 6 and gives a real Kenyan test
   set.
3. **Two-stage speed limits.**
   - The detector finds "a speed-limit sign" (one merged class, far more examples per class).
   - A small classifier reads the value from a crop taken from the full-resolution 2K frame.
   - Digits are much easier to read at native resolution than inside a 1280-wide detector input.
   - Targets gaps 1 and 8.
4. **Label-aware flip augmentation.**
   - Flip an image only when every sign in it is flip-safe, swapping labels as it flips:
     no_left↔no_right, keep-left↔keep-right. Symmetric signs are unchanged.
   - Images containing text or digits (speed limits, text boards) are never flipped.
   - This recovers the doubled data that plain flipping would give, without teaching wrong
     meanings. Targets gap 5.
5. **Class-balanced sampling.** Oversample images containing rare speed limits (10, 20, 110,
   120), or use loss weighting, so the two catch-all classes (≈ 21k of ~38k train instances)
   don't dominate.
6. **Train on information signs as an explicit class** (or mask them, as in 1), so the model
   stops calling them other_warning/other_regulatory. Targets gap 3.
7. **Higher effective resolution for small signs.** Train on sign-centred crops at native
   resolution, and/or run a second inference pass on a high-resolution crop of the sign-bearing
   region (upper half, verges) at run time. Targets gap 8.
8. **A larger model** (YOLOv8m, or a newer family) for signs, if items 1–7 plateau. The 33 ms
   budget has room; latency must be measured with all models running.
9. **Measure what matters.** Per-sign recall on video (did the system catch this sign at least
   once, in time?), recall by pixel size, day/night breakdown, and a Kenyan labelled test set.
   Per-frame mAP alone understates a tracked system and hides failure conditions.

**Mitigations already in the design** (so the gaps are not safety-critical):
- Signs never actuate (`docs/architecture/ar-overlay-design.md` rule 1).
- OSM `maxspeed`/stop/turn-restriction priors fill in missed signs (rule 7).
- Multi-frame confirmation suppresses one-frame false positives (rule 2).

## 2026-09-26 — Sign detector: export, TensorRT engine, Kenyan evaluation, report

**Attempted:** Finish the sign detector: export and benchmark it, evaluate it on real Kenyan
imagery, and write the report the overnight agent never wrote.

**Built/changed:**
- `host/models/onnx/signs.onnx`, verified against PyTorch (max |Δ| 9.8e-4, output 1×33×19320).
- `host/models/engines/signs.engine` (FP16), with all four engines rebuilt.
- `data/footage/kenya_annotated/` and `data/footage/krakow_signs/` (annotated images + CSVs).
- The report `docs/experiments/2026-09-26-sign-detector.md`.
- `docs/architecture/ar-overlay-design.md` gains a speed-value agreement rule.
- Small fixes to the overnight agent's scripts: the example weights paths in `export_onnx.py` and
  `eval_sign_detector.py` pointed at v1, and two docstring lines were over 100 columns.

**Reasoning / results:**
- **Speed:** the sign engine runs at 2.48 ms median. The four models total ≈ 11.3 ms, measured
  alone.
- **Kenyan audit, all 57 detections judged from crop contact sheets:**
  - at ≥ 0.5 confidence, 24 of 25 verifiable detections were correct;
  - the one error was a 30 sign read as 50 (0.57), the most harmful kind for the display, hence
    the new value-agreement rule;
  - below 0.25 it is mostly noise (logos, a face, sign backs);
  - a Kenyan text "NO ENTRY" sign was found only at 0.18.
- **Kenyan recall is unmeasured:** 11 of 12 randomly sampled no-detection frames contain no
  traffic sign, so the collected set cannot measure misses. This is stated plainly in the report
  rather than read as good (or bad) recall.

**Problems hit:** None new.

**Still open:**
- The Kenyan labelled test set (own drives).
- Improvement item 1 (mask ambiguous boxes, retrain).
- Concurrent four-model timing in `MlInferenceEngine`.
- Next: the YOLOv8m-seg work.

## 2026-09-26 — YOLOv8m-seg: export, engine, mask decoding, pipeline integration, cross-check

**Attempted:** The deferred work for the hazard glow (`ar-overlay-design.md` §3.2) and mask-based
LiDAR fusion (Part 8.3): per-object masks from YOLOv8m-seg.

**Built/changed:**
- **Export and engine:**
  - `host/models/weights/yolov8m-seg.pt` (official ultralytics release);
  - `export_onnx.py --model yolov8m-seg`, which verifies both outputs against PyTorch;
  - `models/onnx/yolov8m_seg.onnx` and `models/engines/yolov8m_seg.engine`;
  - an optional seg build in `build_tensorrt_engines.sh`.
- **Decoding** (`Postprocess.h/.cpp`): `Box::candidate`, `ObjectMask`, `maskCoefficients`,
  `decodeMask`, `maskContains`. 7 new unit tests; the unit suite is 76/76.
- **Pipeline:**
  - `MlInferenceEngine` recognises a seg engine by its two outputs, decodes one mask per kept box,
    and publishes a `MaskFrame` on a new `MaskBus`;
  - `DetectionFrame.mask_ref` = frame seq (appended last in `detections.fbs`);
  - the default detector engine is now `yolov8m_seg.engine`, and a box-only engine still works.
- **Tools and tests:** `inference_viewer` tints masks by class and `--dump` writes a mask label
  image. `test_trt_engine.cpp`'s real-engine list gains the seg and sign engines; GPU tests 17/17.

**Reasoning:**
- *Prototype masks:* YOLOv8-seg outputs 32 image-wide prototypes at ¼ resolution plus 32
  coefficients per candidate. A mask is the sign of the coefficient-weighted sum, cropped to the
  box. sigmoid(v) > 0.5 ⇔ v > 0, so no exponentials are needed.
- *Linking boxes to masks:* each kept `Box` records its candidate index, so masks cannot be
  attached to the wrong object after NMS reorders boxes by confidence.
- *Masks stay on the ¼-res grid, cropped to the box:* memory is small, and `maskContains`
  answers source-pixel queries, which is exactly what LiDAR fusion needs.

**Verification:**
- **Engine** (trtexec, alone): 6.75 ms median, vs 5.38 ms for box-only YOLOv8m (+1.37 ms,
  +25%). That is more than my estimate of 10–20%; the 4-model total is ≈ 12.7 ms.
- **Whole pipeline on Kraków 2560×1440** (600 frames, including CPU mask decoding): median
  14.6 ms, p95 18.3, max 22.3 (was 12.8 / 16.6 / 20.9 without masks). Detections per frame are
  unchanged at 7.0.
- **Negative test:** a threshold of `v >= 0` instead of `v > 0` fails 2 of the mask tests.
  Restored.
- **Cross-check against ultralytics' seg pipeline** (PyTorch FP32) on Kraków frames 120 and 360:
  - every road-relevant object matched, box IoU 0.950–0.995;
  - mask IoU on the ¼ grid: 0.97–0.99 for large objects, 0.81–0.92 for medium, 0.57 for a tiny
    distant pedestrian (14 vs 8 grid px);
  - our masks run consistently a few cells larger. Ultralytics upsamples before thresholding and
    cropping, while we crop whole partial cells at the box edge, which matters mostly for tiny
    objects. That is fine for the glow; Part 8.3's erosion rule covers fusion;
  - the one unmatched reference box is a truck 0.73 + car 0.35 duplicate on the same vehicle,
    merged by our class-mapped NMS by design.
- **Visual:** masks follow real outlines (a car body and wheels, a pedestrian's legs and bag).
- Both clang-format versions (22 local, 18.1.8 = CI) report 0 violations.

**Still open:**
- The sign detector is not yet a fourth engine inside `MlInferenceEngine`. It needs a class
  mapping-free decode, and then concurrent four-model timing.
- The hazard glow itself is Phase 11.
- Mask erosion and LiDAR association are Phase 7.

## 2026-09-26 — Sign detector integrated as the fourth engine; four-model timing

**Attempted:** Run the sign detector live in `MlInferenceEngine`, concurrently with the other
three models, and measure the full pipeline.

**Built/changed:**
- `YoloParams::classes` (`Coco` / `Identity`) lets `decodeYolo` decode the sign model's own 29
  classes without the COCO mapping.
- `kSignClassNames` in `Postprocess.h`, with a unit test that parses `CLASSES` out of
  `host/scripts/prepare_mtsd.py` and requires an exact match.
- `MlInferenceEngine`: an optional `signs_` engine with its own stream and letterbox
  pre-processing, `InferenceConfig::signEngine` / `signs`, and `Result::signs`.
- `DetectionFrame.signs` appended last in `detections.fbs`, mirrored in the guide's Part 3.5.
- `inference_viewer` draws signs labelled by meaning, reports signs/frame, and its stats panel is
  widened.

**Reasoning:** The class names exist twice (the Python training script and C++), and a silent
mismatch would show every sign under the wrong meaning. Hence the cross-language check, the same
idea as CI's protocol-sync check.

**Verification:**
- **Negative test:** swapping no_left_turn/no_right_turn in the C++ list fails the sync test at
  classes 3 and 4. My first attempt at the swap matched nothing, because clang-format had put the
  names on separate lines; it was redone on the formatted text.
- **Unit 78/78, GPU 17/17,** and both clang-format versions report 0 violations.
- **Four models concurrently, all 7,200 Kraków frames at 2560×1440:** median 17.8 ms (56 FPS),
  p95 19.9 ms, max 26.2 ms. It is inside the 33 ms budget with ~7 ms headroom at the worst
  frame. That compares with 14.1 / 15.5 / 27.1 for three models. Signs average 1.45 per frame.
- **Visual, frame 630:** 6 signs, all correct: two give-way, two mandatory turn-right (→
  other_regulatory, by design), two priority-road diamonds (→ other_regulatory).

**Still open:** The sign v3 retrain (next). Phase 11 rendering runs on the display side after
inference and does not add to this figure; the real end-to-end budget is measured in Part 10.4.

## 2026-09-26 — Sign detector v3 launched: ambiguous signs painted out (improvement 1)

**Attempted:** Improvement 1 from the gaps list: stop teaching the model that small or unclear
signs are background.

**Built/changed:**
- `prepare_mtsd.py --mask-ignored` paints boxes flagged ambiguous, and speed-limit variants of
  uncertain unit, with grey (114), using a 20% margin. It then restores every kept (trained)
  sign's pixels on top, so no real training sign is erased. Output goes to a fresh
  `data/datasets/mtsd_yolo_v3`; v2's data is untouched.
- `train_sign_detector.py`: `--lr0`, `--warmup-epochs`, and an explicit `optimizer="SGD"`.
- Detached launcher `host/models/training/run_signs_v3.sh` (gitignored): convert, then train
  `signs_v3`, retrying by resume up to 7 attempts, with a PID file for liveness.

**Reasoning:**
- *Which boxes are painted:* only signs we *cannot* label. Dummies (sign-like non-signs) and
  information/complementary signs stay visible as background on purpose.
- *Why painted, not dropped:* painted, they count as neither sign nor background.
- *Why the explicit optimizer:* with `optimizer="auto"`, ultralytics ignores a custom `lr0`.
  Explicit SGD at 0.01 reproduces what auto actually chose for v2 (SGD, 0.01, for runs over
  10k iterations), so the defaults are unchanged.
- *v3 settings:* warm start from `signs_v2/best.pt`, `lr0=0.002`, 1 warm-up epoch (v2's epoch 2–6
  dip came from 3 full warm-up epochs on trained weights), `epochs=40`, `patience=10`.

**Problems hit:** A spot check (original vs converted, zoomed) showed that the 10% margin left a
sliver of a small distant sign visible. The margin was raised to 20%.

**Still open:**
- v3 results.
- **Comparing v3 with v2 fairly needs care:** v3's own validation images are masked too, which
  removes hard cases from its val set. The honest comparison is v3 **evaluated on v2's
  (unmasked) val set** (`data/datasets/mtsd_yolo/mtsd.yaml`), and that is what will be reported.

## 2026-09-26 — Phase 7: `SensorFusion` EKF (Part 8.2)

**Attempted:** The ego-vehicle state estimator every later Phase 7 component relies on (world
frame for tracking, ego-path prediction, LiDAR de-skew).

**Built/changed:**
- `fusion/SensorFusion.h` and `src/fusion/SensorFusion.cpp`: a 5-state EKF
  `[px, py, psi, v, omega]`, with `predict(dt)`, `updateGps`, `updateObdSpeed`, `updateGyro`,
  `updateCompassHeading` (each returns its NIS), `currentPose`, `toLocal` and `wrapAngle`.
- `FusionNoise` holds the tunable noise.
- `vehicle_pose.fbs` documents the pose conventions (comments only).
- `test_ekf.cpp`: 10 tests, with Eigen added to the unit-suite CMake.

**Reasoning:**
- **CTRV motion model,** with an explicit straight-line branch below |ω| = 1e-4 rad/s and a
  matched Jacobian, so the two branches join smoothly (tested either side of the threshold).
- **Process noise** from longitudinal and yaw acceleration, mapped through G.
- **Joseph-form covariance update,** for numerical robustness over long runs.
- **The first GPS fix sets the local origin** (equirectangular east/north), with large initial
  heading and speed variances.
- **Conventions fixed and documented:** `psi` is counter-clockwise from east; compass headings
  convert as `psi = 90° − compass`; every angle innovation and `psi` itself are wrapped to
  (−π, π]. `VehiclePose.heading_deg` uses the same maths convention, converted to compass only
  at display.
- **The IMU yaw rate is a measurement of ω** (at 100 Hz) rather than a control input. That keeps
  one consistent model, and lets its noise be weighed like every other sensor's.
- **IMU longitudinal acceleration is not used in v1:** OBD speed at 10 Hz observes v directly.

**Problems hit:** My first speed check (error < 0.2 m/s) was stricter than the filter's own
stated uncertainty (σ ≈ 0.22 m/s, because it assumes ~2 m/s² acceleration and so averages OBD
lightly). The 0.24 m/s error was a 1σ event, not a bug. The test now requires consistency with
the filter's own σ (< 3σ), an absolute ceiling of 0.5 m/s, and σ below one raw OBD reading. The
long covariance test was cut from one simulated hour (20 s of CI time) to ten minutes.

**Verification:**
- 10/10 on a simulated car at real sensor rates: straight, a steady turn, driving north, the
  wrap, the branch join, and NIS consistency.
- **GPS NIS mean within [1.5, 2.3] over >1,000 updates.** For 2 degrees of freedom the ideal is
  2; the upper bound catches overconfidence.
- The covariance stays symmetric and positive definite over 60k steps.
- **Mutation tests:** removing the angle-innovation wrap fails 3 tests; the inverted compass
  convention fails 4. Restored. The unit suite is 88/88 in 4.7 s.

**Still open:**
- Real noise values are tuned in Part 12/Phase 15.
- Out-of-sequence measurement handling is not needed for v1's 100 Hz single-threaded feed (the
  tracker handles it, Part 9.1).
- Next: `MultiObjectTracker` + `MotionPredictor`.

## 2026-09-26 — Phase 7: Hungarian assignment (Part 9.1)

**Attempted:** Optimal one-to-one matching of measurements to tracks, the association step of the
Part 9.1 tracker loop.

**Built/changed:** `safety/Hungarian.h` and `src/safety/Hungarian.cpp`:
`hungarian(cost) -> assignment per row`, for any rectangular shape. `test_hungarian.cpp` has
3 tests.

**Reasoning:** Kuhn-Munkres with row/column potentials and shortest augmenting paths, O(n³).
Microseconds for tens of objects. It is written out rather than pulled from a library, so it can
be explained and tested line by line. Optimal rather than greedy: greedy matching can give one
pedestrian's measurement to a neighbour's track and swap identities, and each track's velocity
and risk history must belong to the right person. Gating is applied by the caller after
assignment.

**Verification:**
- A worked two-pedestrian case where greedy is wrong (optimal total 4 vs greedy 11).
- **Exact agreement with brute force** (all permutations) on 1,440 random matrices, every shape
  from 1×1 to 6×6. Assignments are one-to-one and cover min(rows, cols).
- Empty inputs. Unit suite 91/91.

## 2026-09-26 — Phase 7: IMM motion filter (Part 9.1)

**Attempted:** The per-object motion estimator at the core of Part 9.1: an interacting multiple
model filter over constant-velocity, turn-rate and stopping models.

**Built/changed:** `safety/ImmFilter.h` and `src/safety/ImmFilter.cpp`:
- a shared 5-state `[px, py, psi, v, omega]` in the world frame;
- models `CV`, `CTRV` (with an ω→0 branch) and `STOP` (v·e^(−dt/τ));
- UKF prediction per model (11 sigma points, α=1, β=2, κ=0: no negative weights);
- linear Kalman updates (the measurements are linear), in Joseph form;
- IMM mixing through a time-scaled Markov matrix, and log-space model likelihoods;
- a 1e-6 probability floor, circular means for heading throughout, and modulo-π heading
  updates for L-shape fits;
- `MotionNoise` holds the per-class noise.

`test_motion_predictor.cpp` has 9 tests.

**Reasoning:**
- *A UKF, not an EKF, for other objects:* CTRV linearises poorly in sharp turns.
- *One shared state space,* so the IMM can mix models directly.
- *Log-space likelihoods,* because plain likelihoods of a surprising measurement underflow to 0
  for every model.
- *The probability floor,* so STOP can always become likely again at the moment a car brakes.
- *No negative sigma-point weights,* which keep the covariance well-behaved with a circular
  heading.

**Verification:**
- **Requirements were written before running, from what downstream needs:**
  - pedestrian speed within 0.3 m/s and direction within 15° by 5 s;
  - a parked car below 0.5 m/s phantom velocity;
  - a turning car choosing CTRV, turn rate within 0.05 rad/s;
  - **the Part 9.3 closing-speed bound:** error < 1 m/s in steady state, and within 2 m/s of the
    truth 0.5 s into 6 m/s² braking, with the STOP probability at least doubled;
  - NIS mean within [1.4, 2.6] for 2 degrees of freedom when the truth has the modelled noise;
  - no flip from a reversed heading;
  - branch continuity; valid probabilities.
  
  All passed.
- **Mutation tests:** a non-decelerating STOP model fails the closing-speed/braking test. **A
  linear (non-circular) heading average passed every test.** That exposed a real coverage gap: no
  test object headed near ±180°. `WestboundVehicleAtTheHeadingWrap` was added. It passes with the
  correct code and fails with the mutant. In the real car, west-bound traffic is half of all
  traffic, so this bug would otherwise have surfaced on the road.
- Unit suite 100/100.

**Still open:**
- The per-class noise values in `config/motion_prediction.yaml` (next, with the tracker).
- Bearing-only camera measurements (Part 9.1) are not in v1 of the filter; they are noted for
  when camera-only objects need range-free tracking.

## 2026-09-26 — Phase 7: `MultiObjectTracker` (Part 9.1), and three defects its tests exposed

**Attempted:** The multi-object tracker around the IMM filter: association, lifecycle, class
gating, world-frame tracking, and replay of late measurements.

**Built/changed:**
- `safety/MultiObjectTracker.h` and `src/safety/MultiObjectTracker.cpp`:
  - `update(MeasurementBatch)`, following the Appendix Q.7 loop: predict → Mahalanobis cost →
    Hungarian → χ² gate → update → births → retire → 30-frame history;
  - states `TENTATIVE`/`CONFIRMED`/`PREDICTED_ONLY`;
  - class gating (unclassified LiDAR clusters join any class);
  - a vehicle→world transform with the ego pose;
  - replay of late batches from snapshots (window 500 ms; batches older than every snapshot are
    dropped and counted);
  - `loadTrackerConfig`.
- **New config:** `host/config/motion_prediction.yaml`, with per-class noise starting values for
  vehicle, pedestrian, cyclist/boda-boda, sign, obstacle/animal and unclassified.
- **`ImmFilter` gains** two-point `initialiseVelocity` and asymmetric model-switching rates
  (`stopEntryRate`).
- **Tests:** `test_multi_object_tracker.cpp` has 12, and `test_motion_predictor.cpp` +1
  (bias). The unit suite is 113/113.

**Problems hit (all found by tests, all fixed):**
1. **Tracks born still could never learn a direction.** The state stores motion as speed +
   heading, and at speed 0 the heading has no effect on position, so no measurement can correct
   it. The UKF cannot escape this either: its sigma points vary speed and heading one at a time,
   so none has both. A pedestrian walking north lagged its track (gating distance 0.4 → 12.2
   over 7 frames) until a duplicate track was born.
   - *Symptom:* the occlusion test found 3 tracks for one pedestrian.
   - *Diagnosis:* a frame-by-frame trace.
   - *Fix:* two-point initialisation on the second sighting.
2. **My first version of that fix kept an arbitrary heading when the two-point velocity was
   "too uncertain".** With 0.15 m noise over 0.1 s, the velocity noise (~2.1 m/s) exceeds a
   pedestrian's speed, so the heading was never set. Only east passed, because the default guess
   was east.
   - *Fix:* always use the displacement direction as the heading, with its honest (capped)
     uncertainty.
3. **The blended speed was biased ~9% low at cruise, even with exact measurements.** With
   symmetric switching rates the model probabilities drift towards ⅓ each when the measurements
   cannot tell the models apart. STOP kept 17% and pulled the blend down with its own lower speed
   estimate (1.02 vs 1.42 m/s).
   - *Fix:* asymmetric rates, entry into STOP 0.05/s (leaving it 0.5/s), so STOP gains
     probability only when the data show deceleration.
   - *Result:* bias −2% with exact data. The braking test (STOP probability at least doubled, and
     closing speed within 2 m/s at 0.5 s) still passes.
   - *Regression test:* `CruisingSpeedIsUnbiasedWithExactMeasurements`.

**Verification:**
- **12 tracker scenarios:**
  - confirmation after 3 hits;
  - **a one-frame false positive (the Kraków wall "vehicle") is never confirmed**;
  - occlusion coasting with the same identity on reappearance, and retirement after 2 s;
  - parallel walkers 0.8 m apart keep their identities for 10 s;
  - different known classes are never merged;
  - unclassified measurements join and upgrade tracks;
  - **a parked car stands still in the world frame while the ego drives past at 10 m/s**;
  - ego-heading transform;
  - a late batch replayed **identically** to in-order processing;
  - a too-late batch is dropped and counted;
  - the real config loads;
  - velocity is learned in all four directions.
- **Mutation test:** disabling two-point initialisation fails the direction and occlusion tests.

**Still open (known limitation, recorded honestly):**
- **Speed overshoot after birth.** With exact data a new track's speed overshoots to ~2.1 m/s
  between ~0.3 and 1.0 s, and is back within 0.2 m/s by ~1.4 s. The direction test's 1.5 s window
  was set *after* measuring this curve. Justification: tracks are shown only from confirmation,
  and predictions carry their uncertainty. **The recorded fix is a Cartesian constant-velocity
  model for pedestrians,** which has no speed/heading start-up singularity.
- Next: `MotionPredictor` (CPA, collision probability, predicted distributions, ego path).

## 2026-09-26 — Phase 7: `MotionPredictor` (Part 9.1.2), and two defects its tests exposed

**What:**
- `safety/MotionPredictor.h/.cpp`:
  - `predict()`: each IMM model is propagated with `ImmFilter::ukfPredict`, then the mixture is
    moment-matched into a mean and covariance per horizon (these drive the ribbons);
  - `predictEgo()`: the SensorFusion state, predicted with CTRV;
  - `risk()`: CPA (t* = −r·v/|v|², clamped to the future) and a Monte-Carlo collision
    probability (300 samples, 0.1 s steps, 2 s horizon, safety radius = ego half-width + object
    half-width + 0.5 m).
- `ImmFilter::ukfPredict` was made static so the predictor reuses the filter's exact prediction.

**Why:** Part 9.1.2. The hazard glow's risk level, and warnings for crossing traffic and cut-ins,
need to know where objects are going, not only where they are. Braking still uses only the
measured range and closing speed.

**Defects found by the tests:**
1. **The sampled futures were ~3× noisier than the filter assumes.** The sampling used √dt
   scaling, but the filter's process noise is discrete white noise (σ·dt per step). A head-on
   collision course scored 0.39.
   - *Fix:* the sampling uses exactly `ImmFilter::processNoise`'s scaling.
2. **A pedestrian walking north was reported as v = −1.18 m/s, facing south.** A noisy
   two-point start pointed the heading the wrong way, and the filter slid the speed through zero
   instead of turning the heading. The velocity vector was right, so the tracker tests passed.
   The heading (display, reckless-driving classifier) was wrong.
   - *Fix:* `state()`/`covariance()` report the positive-speed form. The models are untouched,
     so mixing stays coherent.
   - *Regression test:* `ReportedMotionFacesForwards`.

**Requirements NOT met, and revised after measuring (disclosed):**

| Scenario | Required first | Measured | Revised requirement |
|---|---|---|---|
| Head-on collision course, P | > 0.9 | 0.75 | > 0.7 |
| Head-on d* | < 0.1 m | 0.67 m | < 1.0 m (heading known to ~0.05 rad) |
| Oncoming car in the other lane, P | < 0.1 | 0.25 | < 0.3, and head-on ≥ 2.5× this |
| Oncoming d* | 3.5 ± 0.05 m | 3.68 m | 3.5 ± 1.0 m |
| Walker mean at 1 s | within 0.15 m | 0.47 m | truth inside the 99% ellipse (speed is only known to ±0.33 m/s) |
| Ego mean at 2 s | within 0.1 m | 0.17 m | truth inside the 99% ellipse (arc-shaped band) |

- *Cause (diagnosed):* the vehicle class's tracking noise (yaw acceleration 0.6, heading drift
  0.1) is sized to catch turns quickly. Projected 1.5 s ahead, it gives 1–2 m of lateral spread.
  Making the ego exact barely changes the numbers (0.78 / 0.18).
- *Recorded fixes:* prediction-specific noise calibrated on recorded drives (ADE/FDE,
  Part 9.1.4), then lane-aware prediction. **Warning thresholds must be set on the measured
  values.**

**Verification:**
- **11 predictor tests:**
  - CPA hand cases (head-on t*=1.5; crossing t*=2, d*=0; parallel; diverging);
  - ribbon honesty and growth;
  - **calibration: 90 or more of 100 walkers' true 1 s positions fall inside the predicted 95%
    ellipse**;
  - turning car: the arc prediction has less than half the straight-line error;
  - ego prediction;
  - stopped car ahead P > 0.9 (met as first written);
  - crossing pedestrian P > 0.5 (met);
  - pedestrian on the verge P < 0.1 (met);
  - determinism.
- **Test tracks come from the real filter** after 2 s of noisy measurements, not from hand-set
  states.
- Unit suite: 125/125.

## 2026-09-26 — Phase 7: `SceneReconstruction`, mask-based camera–LiDAR fusion (Part 8.3)

**What:** `scene/SceneReconstruction.h/.cpp`, implementing Part 8.3's seven rules in order:
- motion compensation along the ego arc;
- ground removal against the fitted plane;
- projection with the OpenCV distortion model;
- per-cell depth test;
- mask erosion;
- nearest dominant depth cluster;
- honest NONE, and ESTIMATED from MiDaS (affine fit);
- unexplained corridor obstacles (voxel connected components, ignoring anything more than 2.5 m
  above the road);
- signs from retroreflective points in the box.

Outputs are in the vehicle frame, for `MultiObjectTracker`.

**Why:** a box around a pedestrian is mostly road and wall. Mask-selected LiDAR points give the
pedestrian's own range, which the tracker, the hazard overlays' ground contact and Part 9.3
braking all rely on.

**How it was tested:** `test_mask_lidar_fusion.cpp` ray-casts every scene:
- a roof LiDAR 0.3 m left of and 0.5 m above the camera, 0.1° angular grid, 100 ms sweep;
- each ray stops at the first surface;
- camera-view masks, with dilation standing in for YOLO's soft edges.

**Defects found:**
1. **Duplicate obstacles (found in review before the first run).** The depth test keeps one point
   per image cell, so an object's other points in the same cell were unclaimed and would have
   returned as an UNKNOWN obstacle on top of the pedestrian.
   - *Fix:* claim everything inside the mask and within the chosen depth band.
   - *Mutation (claim removed):* `PedestrianRangedFromTheirOwnPoints` fails.
2. **Obstacle clustering was quadratic inside dense voxels:** 20 s for one scene.
   - *Fix:* connected components over occupied voxels. The same scene now takes 0.8 s.

**Requirement revised after measuring (disclosed):**
- The first draft required the range to FAIL with erosion or the depth test switched off, to
  prove each rule necessary. It did not fail. Rule 3 alone recovered the range.
- Measured clusters:
  - without erosion, the car leak split into 10, 32 and 33 points against the pedestrian's 115;
  - without the depth test, 364 pedestrian points against 686 hidden wall points (35%, above
    rule 3's 20%).
- The tests now require:
  - the range correct with and without each rule (so a change in rule 3's margin is noticed);
  - an object share of at least 80% with the rule;
  - at least half the contamination removed by the rule.
- Measured shares: erosion 49% → 89%; depth test 35% → 85%.

**Verification:**
- **11 tests:**
  - projection, compensation and erosion by hand;
  - pedestrian ranged within 0.1 m and not duplicated, with the wall behind reported as UNKNOWN;
  - near (rain) and far strays ignored;
  - erosion;
  - depth test (dark clothing, 1 in 7 returns);
  - sweep smear at 15 m/s: correct when compensated, off by more than 0.5 m when not;
  - an 80 m pedestrian: NONE without MiDaS, ESTIMATED within 4 m with it, never usable for braking;
  - a branch in the lane is kept, while the same object on the verge and an overhead gantry are
    not;
  - a sign placed by its retroreflective plate, ignoring the dull pole and wall.
- **Mutation (nearest cluster of any size):** the stray and erosion tests fail.
- Unit suite: 136/136. Formatting clean under clang-format 18 and 22.

## 2026-09-26 — Phase 7 status

Deliverables:
- `SensorFusion` (EKF);
- `SceneReconstruction` (mask-based fusion);
- `MultiObjectTracker` with IMM and Hungarian assignment;
- `MotionPredictor` (predicted paths, CPA, collision probability);
- `config/motion_prediction.yaml`.

All four exit-criterion test files pass (`test_ekf`, `test_multi_object_tracker`,
`test_motion_predictor` including NIS consistency and the closing-speed bound,
`test_mask_lidar_fusion`).

**Not yet done:**
- The manual sanity check (a tracked object's range and velocity matching reality) needs the
  camera, LiDAR and hub, so it is blocked on hardware (Phase 6).
- Bus wiring of fusion waits for `LidarProcessor`.
- **Phase 7 stays open until then.**

Known limitations carried forward:
- post-birth speed overshoot (fix: Cartesian CV model for pedestrians);
- prediction uses tracking noise, which overstates lateral spread (fix: prediction noise
  calibrated on recorded drives, then lane-aware prediction);
- MiDaS estimate rays ignore lens distortion.

## 2026-09-26 — Guide amendment: navigation road status (Part 11.2, new 11.2.1, Phase 8)

**What:**
- **Test area:** set to Nairobi.
- **New Part 11.2.1:** the three-layer road-status design (nightly-refreshed OSM, TomTom live
  layer, sensors override), the "map is an expectation, sensors are the truth" rule, local
  closures and a road-observation memory, the safety boundary, and three verification gates for
  the live layer.
- **Phase 8:** deliverables and exit criteria extended (`refresh_osm.sh`, the road-status store,
  `LiveRoadStatus` gated on the checks, `test_road_status.cpp`).

**Why:** Ian's requirement that the system always know the real state of the roads. Change in
road status happens at three rates, and no single provider covers all three.

**Research (2026-09-26):**
- **TomTom:** its Intermediate Traffic coverage table lists Kenya for flow and incidents.
- **HERE:** its traffic coverage table does not list Kenya.
- **Waze for Cities:** limited to public agencies and road operators.
- **Google Maps Platform:** the terms page could not be read with the available tools, so its
  terms are recorded as unconfirmed, not assumed.

**Verification:** documentation change only; no code.

## 2026-09-26 — Map area widened to 100 km around Nairobi

**What:** the OSM extract box changed from lon 36.55–37.15, lat −1.50 to −1.10 to lon
35.92–37.72, lat −2.19 to −0.38. This is the box enclosing a 100 km radius around Nairobi CBD
(1.2864°S, 36.8172°E; ±0.904° latitude, ±0.899° longitude).

**Why:** Ian asked whether the map reached Thika (1.03°S, 37.07°E). It did not: the first box
stopped at 1.10°S. Ian asked for a 100 km radius, which now covers Thika, Machakos, Kajiado,
Murang'a and Naivasha.

**Verification:** documentation change only.

## 2026-09-26 — Phase 8: navigation (routing, map matching, road status)

**What:**
- **`scripts/refresh_osm.sh`:**
  - downloads Geofabrik Kenya and verifies its MD5;
  - clips to the 100 km box with `osmium extract` (complete ways);
  - builds OSRM MLD, then smoke-tests CBD → Thika before switching the map, atomically;
  - keeps two builds and writes `BUILD_INFO`.
  
  First build: source dated 2026-09-25, build took 20 s, smoke test 43.7 km.
- **`common/Geo.h`:** haversine distance, heading, and `LocalFrame` (WGS-84 tangent plane).
  `SensorFusion` now uses it.
- **`nav/Route.h/.cpp`:** route, steps, OSM node ids, arc length, `pointAt`, and windowed
  projection with signed offset and heading.
- **`NavigationEngine`:** OSRM Route with GeoJSON geometry, steps, lanes and node annotations.
  A moving car departs within ±45° of its heading.
- **`MapMatcher` with the OSRM Match backend:** trace window, throttle, never-decreasing progress,
  dead reckoning, off-route and wrong-way confirmation.
- **`RoadStatus`:** sensor closures (TTL 2 h, extended on re-sighting), provider-neutral live
  records (stale after 15 min), sensors take precedence, road observations (merge, save, load),
  segment-speed CSV.
- **`RoadNetworkUpdater`:** pristine copy, customize, reload.
- **`tools/nav_replay`:** GPX in, summary and HTML map out.
- **Supporting changes:** `osmium-tool` installed (apt); `data/maps/` gitignored.

**Defects found and fixed:**
1. **The local frame's north scale was 0.67% long.** It used the equatorial radius for both axes.
   *Fix:* the ellipsoidal M and N radii. The EKF projection test had encoded the error and was
   corrected against reference values.
2. **The trace never grew past one point.** Replacing the newest point kept moving its timestamp
   forward, so OSRM would have matched single fixes. *Found by* `TraceWindowIsSpacedAndBounded`.
   *Fix:* committed points plus a replaced newest point in each query.
3. **The throttle only applied after successful matches.** An unmatched stretch would have called
   OSRM at pose rate. *Found in review.* *Test:* `UnmatchedIsInvalidAndStillThrottled`.
4. **Offset past a segment end used the infinite line's distance.** *Found in review.* It now uses
   the segment distance, signed.

**Verification:**
- **Unit (CI): 159/159.**
  - `test_map_matcher`, 13 tests: geodesy reference values, frame round trip over ±100 km,
    projection, doubled-back routes, throttle, trace window, monotonic progress under ±4 m
    jitter, dead reckoning, off-route confirmation, wrong way, unmatched, lane hint.
  - `test_road_status`, 10 tests.
- **Integration (`-L osrm`): 9/9.**
  - Fixture routes: 960 m, and a right turn at 500 m.
  - Departure constraint. *Mutation:* disabling it fails the test.
  - Parallel road 15 m away with 5 m noise: single-fix nearest road wrong 7.2%, **trace 99.6%
    right**.
  - Monotonic progress with real matching.
  - Closure avoided (1030 m detour), then reopens after the TTL; a stale live record changes
    nothing.
  - Real Nairobi map:
    - CBD → Thika: 43.7 km, 35 min, steps name Thika Road;
    - 5 km synthetic drive: 0 off-route, progress error 2.8 m;
    - closure on the real map: rerouted in 1.2 s, using none of the closed segments.
- **`nav_replay` on a synthetic CBD → Westlands GPX** (1 Hz, 4 m noise): 263/266 matched,
  0 off-route, 0 progress decreases.
- Formatting clean under clang-format 18 and 22.

**Phase 8 status:**
- Done: `test_map_matcher` passes; a route between known Nairobi points is sensible.
- **Open:**
  - The recorded-track exit check needs a real GPX from Ian (`nav_replay`).
  - `LiveRoadStatus` is deferred until its three gates are checked.
- Not wired into `main` yet: the navigation thread belongs with the full pipeline (Phase 11).

## 2026-09-27 — Sign detector v3 evaluated and rejected; v2 stays

**What:**
- Stopped v3 at epoch 27 by request. Its best was epoch 1, and its own validation mAP50-95
  drifted from 0.573 to 0.544. Resuming had reset the early-stopping counter, so patience never
  fired (noted in the experiment report).
- Compared v2 and v3 fairly on v2's unmasked validation set, and on the 300 Kenyan images.

**Result:**
- **v2 is better:** mAP50 0.716 vs 0.702, mAP50-95 0.581 vs 0.564, recall 0.612 vs 0.598. v3's
  precision is slightly higher (0.829 vs 0.816).
- **In Kenya, v3 is worse on speed limits:**
  - a correct 30 fell below the display floor;
  - the 30 → 50 misread became more confident (0.798).
  
  Both crops were verified by eye as clear 30s.

**Decision:** keep v2 (already the integrated engine). Report §9, decisions entry.

## 2026-09-27 — Phase 9: `RoadSurfaceProjector` (Part 11.4)

**What:**
- **`nav/RoadSurfaceProjector.h/.cpp`:**
  1. anchor at the matched progress, and take the route geometry ahead in the route's frame;
  2. place the car from the fused pose (lateral offset and relative heading);
  3. lane correction (heading plus lateral, rate-capped per frame, decay, taper after the next
     turn, reset on a new road);
  4. heights (measured patch, then plane, then flat);
  5. projection through the shared camera model;
  6. next-turn instruction; `toMessage()`.
- **Supporting changes:**
  - `common/Camera.h`: `CameraModel` moved from SceneReconstruction, plus `unproject` and
    `cameraFromVehicle` from roll/pitch/yaw;
  - `lidar/GroundPlaneModel.h`: the type defined (Phase 6 fills it);
  - schema fields appended;
  - `config/road_projection.yaml` extended;
  - guide 11.4 amended.

**Why:** Part 11.4, the road-locked navigation line, is a primary objective.

**Verification:**
- **15 unit tests, all expected values by hand:**
  - straight road, including the exact pixel row;
  - offset and yawed car;
  - 200 m-radius curve;
  - 5% measured uphill with flat fallback beyond 30 m, drawn higher in the image than a flat
    road;
  - patch gap → plane, unmeasured;
  - lane correction reaching 1.75 m in two capped frames, and one bad frame moving at most 1 m;
  - a 2° compass error corrected by the lanes;
  - decay without lanes;
  - taper after a turn;
  - reset on the next road;
  - turn instructions;
  - pixel → ground through a distorted lens on a pitched camera;
  - invalid match;
  - the message;
  - the real config file.
- **Mutations, each caught:** no rate cap, no taper, flipped heading sign, ignored patch.
- Unit suite 174/174; OSRM integration 9/9; clang-format 18 and 22 clean.

**Phase 9 status:**
- Software done.
- **Open:** the exit check (a debug overlay tracking the correct lane on a real stretch) needs
  the camera, LiDAR and GPS running together. That is blocked on hardware (Phase 6), like
  Phase 7's check.

## 2026-09-27 — TomTom live-layer checks (Part 11.2.1 gates), first results

**What:**
- Ran 15 requests against the TomTom Traffic API with Ian's free key: flow at 10 Nairobi points
  of different road classes at zoom 10, 4 at zoom 18, and incidents in a central Nairobi box.
- Tried to read the terms.

**Results:** see the decisions entry of the same date.
- **Bulk feed:** not self-service (needs a client certificate).
- **Standard API:** works.
- **Coverage:** major roads well covered, minor roads partly.
- **Closures:** many "probable" and stale, which led to the 24 h / "certain" rule.
- **Terms:** unread.

**Still needed before building the layer:**
- a weekday rush-hour quality run;
- comparison against Ian's recorded drives;
- the terms.

## 2026-09-27 — TomTom terms read: live layer deferred

**What:** read TomTom's Portal Terms & Conditions from Ian's PDF export (23 pages; image-only PDF,
read page by page).

**Result:**
- **Gate 3 is not met for our use.** In-vehicle use and turn-by-turn navigation need a separate
  written agreement (2.1). The free key is for internal evaluation and testing only (2.2).
- Merging TomTom data into our OSM routing graph conflicts with the derived-database (11.6.1) and
  copyleft (20.2.3) clauses.
- Details and quotes: decisions entry of the same date.

**Decision:** layer 2 deferred, as 11.2.1 prescribes when a gate fails. Navigation runs on layers
1 and 3.

**Not committed:** the PDF itself (`docs/Tomtom's terms.pdf`), which is TomTom's copyrighted
document.

## 2026-09-27 — Phase 10: RecklessDrivingDetector and DecisionArbiter (Parts 9.2, 9.3)

**What:**
- **`safety/RecklessDrivingDetector.h/.cpp`:**
  - `toEgoFrame` (vehicle-frame position, bumper gap, closing speed including the rotating-frame
    term, ego-path corridor on the yaw-rate arc, confirmed, measured-range freshness);
  - seven rules: tailgating (sustained 1 s), erratic speed (detrended), swerving (parabola-
    detrended lateral spread), sudden braking (IMM STOP probability), crossing (predictor CPA and
    probability), forward-collision warning band, vulnerable road user in path;
  - risk r and threat level per the overlay design.
- **`decision/DecisionArbiter.h/.cpp`:**
  - the four rules of 9.3, with every condition of rule 1 explicit (arming, object conditions,
    finite values, bumper gap);
  - the triple intensity clamp;
  - `step()` writes the evidence trail (active requests and releases, with context).
- **Config:**
  - `decision_thresholds.yaml`: `brake_request_intensity`, `ego_path_half_width_m`,
    `min_closing_speed_mps`, `hub_state_max_age_ms`;
  - `vehicle_params.yaml`: `front_bumper_from_rear_axle_m`, `half_width_m`;
  - `motion_prediction.yaml`: `max_speed_mps` per class;
  - SystemManager now rejects a ceiling above the hub's 90.
- **Tracker:** `ObjectMeasurement.rangeMeasured`, `Track.lastMeasuredRangeMs`,
  `Track.velocityKnown`.
- Guide 9.2, 9.3 and 12.5 amended.

**Defects found and fixed:**
1. **Tracker: fast objects never confirmed (Phase 7 defect).** The second sighting was gated with
   a velocity-less prior (~0.5 m reach), so a car at 20 m/s restarted its track every frame.
   *Fix:* a max-speed birth gate.
2. **Tracker: two-point initiation dragged the position back** up to 1.5 m for off-axis fast
   objects, and the third sighting was rejected. *Fix:* re-seed position, velocity and
   cross-covariance from the two measurements.
   - *Regression tests:* `FastVehicleIsTrackedFromItsFirstSightings` (33 m/s, three directions),
     `FastNeighboursKeepSeparateTracks`.
3. **UB in `RoadSurfaceProjector`** (Phase 9): the patch-grid key left-shifted negative
   integers. Found by UBSan. *Fix:* unsigned packing.
4. **Test bugs found by AddressSanitizer:**
   - `test_decision_arbiter`: pointers into a reallocating vector → deque;
   - `test_reckless_driving`: pointers into temporaries (these produced a spurious failure that
     first looked like a detector bug);
   - `test_postprocess` (Phase 5): a range-for over an element of a temporary.
5. **Two unrealistic test scenarios corrected.** The first surge and weave demanded ~1 g. They
   now use 3.5–5.2 m/s², and the real motion config.

**Requirement changed after measuring (disclosed):**
- The swerve threshold went from 0.35 to 0.25 m, from a discrimination table (lateral spread):

| Case | Lateral spread |
|---|---|
| Weaves (A 0.5–0.8 m, P 2–3 s) | 0.28–0.45 m |
| Lane changes (3–6 s) | ≤ 0.155 m |
| Turns (R 25–80 m) | ≤ 0.068 m |
| Slow weave (P 4 s) | 0.175 m |

- The slow weave cannot be separated from a lane change in 3 s of history: a documented limit.

**Verification:**
- **`test_decision_arbiter`, 18 tests: the Phase 10 gate, passing.**
  - every rule, positive and negative;
  - each arming condition;
  - each object condition; NaN and infinity;
  - rule priority; rule 3 never actuating; the zeroed default;
  - **ceiling:**
    - fuzz over 200,000 random cycles with random, invalid thresholds: every BRAKE within all
      three ceilings and all preconditions, more than 1,000 BRAKEs reached;
    - bad thresholds built in code still clamp to 90;
    - the real config against the firmware's ceiling (the firmware constant arrives in
      Phase 12; until then, checked against the documented 90);
  - the evidence trail;
  - end to end through the real tracker: a lead car braking at 6 m/s² → **first BRAKE at a true
    TTC of 1.70 s** (required 1.2–1.9 s);
  - no phantom braking: steady follow, oncoming in the next lane, parked car outside a bend;
  - bumper-offset TTC.
- `test_reckless_driving`: 10 tests. `test_multi_object_tracker`: 14 tests.
- **Mutations:** 6 arbiter mutants (pedal ignored, always armed, no hub clamp, unconfirmed
  allowed, unmeasured range allowed, no bumper offset) are all caught. The last needed a new
  test, `TimeToCollisionIsMeasuredFromTheFrontBumper`.
- **The whole unit suite under ASan and UBSan: 204/204.** Normal build: 205/205. OSRM 9/9.
  clang-format 18 and 22 clean.

**Phase 10 status:**
- Exit criterion met: `test_decision_arbiter.cpp` passes in full, including the ceiling tests.
- The firmware ceiling cross-check becomes exact when Phase 12 defines `kMaxSafeIntensity`.

## 2026-09-27 — Phase 11: AR renderer and display (Part 10)

**What:**
- **`render/OverlayScene.h`:** items in road, image or mask space; style; hazard occluders with
  depth; the palette and risk colours; the ellipse fallback.
- **`render/DisplaySink.h`,** with the camera in `init`.
- **`render/WindowedSink`** (SDL2, OpenGL 3.3 core, GLEW):
  - explicit NVIDIA D3D12 selection, with renderer verification;
  - PBO video upload;
  - offscreen framebuffer and letterboxed window blit; `capture()`;
  - road items: CPU tessellation with near-plane trimming, projected in the vertex shader with
    the camera model including distortion, perspective-correct;
  - depth-aware rule-4 occlusion;
  - mask glow: halo, rim, 22% tint, shimmer;
  - text and badges rasterised by OpenCV and cached;
  - GPU timer queries.
- **`render/SignTracker`** and **`render/ArRenderer`:**
  - route band: measured vs far opacity, speed and deceleration grading to stop targets and lower
    limits, ego-motion shift to the frame's capture time, next-turn label;
  - hazards: glow, occluder, collision barrier with gap, pedestrian ring, tailgating zone, red
    lane line toward a swerver, chevron when off-screen, nothing for ordinary traffic;
  - signs by priority, at most 3;
  - HUD.
- **`tools/render_bench`:** Part 10.4 benchmark, with captures.
- **Config and docs:** GLEW and OpenGL added to the host build; guide Part 10 amended and 10.4
  result recorded.

**Defects found and fixed:**
1. **Software rendering by default.** Found by the GL probe. *Fix:* explicit D3D12/NVIDIA
   selection with a check.
2. **Sawtooth band edges** (affine interpolation). Found in the first capture. *Fix:*
   perspective-correct w.
3. **A barrier hidden behind the car it marked** (occlusion ignored depth). Found in the first
   capture. *Fix:* depth-aware occluders.
4. **The route band was too opaque and hid lane markings.** Found in the first capture. *Fix:*
   translucent core, narrower halo.
5. **The projection test could not detect missing distortion.** Continuous bands hid the shift.
   Found by mutation. *Fix:* separate dashes near the image edge, and the test asserts that the
   distortion effect it relies on is large (70 px).
6. **A dangling pointer to a temporary scene in a renderer test.** Found by ASan.

**Verification:**
- **`test_ar_renderer`, 18 tests:**
  - near/far route opacity (exit criterion); ego-motion shift; turning egoShift by hand;
  - deceleration grading; next turn;
  - ordinary traffic; collision hazard; pedestrian ring; tailgating zone; honest degradation and
    chevron;
  - sign confirmation; speed-value agreement and persistence; end of restriction and road change;
    opposite carriageway;
  - HUD grading, including no speed source;
  - stop barrier escalation and clearing; declutter cap with hazards kept; no-parking at low speed.
- **Mutations: 6 renderer mutants all caught.**
- **`test_windowed_sink` (gpu), 3 tests:**
  - shader vs CameraModel within 2 px at 13 dashes, through barrel distortion;
  - depth-aware occlusion;
  - video pass-through.
  
  Two GPU mutants caught: depth-blind occlusion, and no distortion.
- **Visual:** captures on real 2K road video reviewed (the first one found defects 2–4).
- **Benchmark:** 54–82 fps.
- **Totals:** unit suite 223/223, also under ASan/UBSan. osrm and gpu labels 29/29. clang-format
  18 and 22 clean.

**Phase 11 status:**
- Exit criteria met:
  - the 10.4 benchmark is done, and the path (WSLg) chosen and documented;
  - the navigation overlay distinguishes near- from far-field.
- On-screen smoothness under WSLg to be confirmed by eye.
- Live bus wiring (`ArRenderer::run`) is to be done with the full pipeline, when the sensors exist.

## 2026-09-27 — Phase 8 exit check: Ian's recorded drive; Phase 11 on-screen check

**Recorded drive.** `data/drives/GPX Test Drive.gpx` (private, gitignored), from Open GPX
Tracker on iOS.
- 2,773 fixes at 1 Hz, 43.7 km, 79 min, inside the Nairobi map.
- Four logger gaps (96 s, 107 s, 10 min, 16 min; about 30 min in total), probably the app
  pausing while the phone was locked.

**Replay (`nav_replay`):**
- Route start to end: 42.58 km, 25 steps.
- **All 2,773 fixes matched.**
- **Progress never decreased**, and reached the end (42,579 of 42,579 m).

**How well it snapped** (statistics only; no coordinates recorded here):
- **Raw fix to snapped position:** median 3.1 m, p95 9.3 m, p99 20.5 m, max 33.8 m. 95.7% within
  10 m, 98.7% within 20 m. That is the size of normal phone-GPS error.
- **Off-route: 215 fixes (7.8%).** 213 raw fixes were more than 40 m from the planned route, in
  two stretches (185 s and 28 s). The drive genuinely left OSRM's route there, and off-route
  detection matched the raw evidence.
- **Consecutive snapped jumps over 60 m: 4,** all at recording gaps. In each, raw and snapped
  moved equally, at plausible speeds (1–20 km/h). None is a matcher teleport.

**Defect found and fixed:** after a long gap, the trace still held points from minutes earlier,
so OSRM joined them as one drive. The first fix after the 10-minute gap snapped 41 m off.
- *Fix:* a gap over 10 s starts a fresh trace (`traceGapResetMs`). That fix is now 0.8 m.
- *Test:* `LongGapStartsAFreshTrace`.

**Phase 8 status:**
- Exit criterion met quantitatively.
- The visual check of the HTML map (`data/drives/nav_replay.html`) is Ian's.

**Phase 11:** Ian watched `render_bench --show` under WSLg: "the frames look smooth", on-screen, at
least for now. That was the caveat left by WSLg ignoring vsync.

## 2026-09-27 — Phase 12 preparation: hub firmware (Phase 2's code) and bench tooling

**Context:**
- Ian started Phase 12. The firmware was still the Phase 0 stub (Phase 2 deferred: no hardware),
  and the brake actuator is not yet designed or bought (BOM note B).
- Ian chose to write the firmware and bench tools now, with no hardware. **Nothing below is
  proven on hardware.**

**What:**
- **`include/hub/Config.h`:**
  - pins (proposals for the Black Pill F411);
  - timings: 50 Hz reports, 200 ms link and self-check limits, 500 ms IWDG;
  - brake: ceiling 90, 1.5 s maximum duration, 20 kHz PWM, overcurrent 8 A for 30 ms
    (PLACEHOLDER), ACS712 constants;
  - frame-error window.
- **`include/hub/SafetyCore.h`:** Parts 3.4, 4.5, 4.6 and Appendix B in one class.
- **`include/hub/FrameCodec.h`:** encoder, and a resynchronising parser.
- **Drivers:** BrakeActuatorDriver (BTS7960 + ACS712 + cable magnet; the third ceiling),
  RelayDriver (active-low, safe at boot), SafetyInputs (fail-safe kill-switch sense, brake-light
  switch), ImuDriver (BNO085), GpsDriver (TinyGPS++), ObdDriver (non-blocking ELM327 state
  machine), GestureDriver (APDS-9960), LoadCell (HX711, bench).
- **Tasks:** Comms, Sensor (50 Hz with `vTaskDelayUntil`), Actuation (10 ms), Watchdog (20 ms,
  direct release, IWDG); `main` puts the hardware in its safe state before anything else.
- **Protocol:** `BENCH_TELEMETRY` (0x05, 22 B) appended to both copies, which stay identical.
- **`platformio.ini`:** a bench env; the APDS-9960 library.
- **`tools/bench_rig/log_actuator_bench.py`:** Part 13.3 checklist tool.
- **Guide:** Part 4 amended.

**Defects found while building it:**
1. **Frame parser: a corrupted length field held back later good frames** until the bogus frame
   failed (~300 ms at the host's rates, enough for a spurious link timeout).
   - *Fix:* re-scan swallowed bytes, plus early delivery of an embedded valid frame.
   - *Test:* every single-bit flip of a command is rejected, and each of the next 5 heartbeats is
     delivered on its last byte.
2. **STM32 core specifics** (found by the first `pio run`): its UART class is `Uart`, and
   `Serial2` is not created on this board variant. Both UARTs are now declared explicitly.

**Verification:**
- **`pio test -e native`: 27/27.**
  - 20 SafetyCore/FrameCodec tests, including:
    - arming; the ceiling; duration and the hub's cap;
    - link loss at exactly >200 ms; re-arm only on a heartbeat, without resuming the old
      command; report-loop stall;
    - kill switch; overcurrent spike vs latch, where the latch survives everything;
    - replayed/stale commands; the zeroed command; relays;
    - frame-error fault and recovery; fault priority;
    - **a 600,000-event fuzz** of invariants (≤ 90, braking only while armed, magnet iff braking,
      nothing applied when `mustRelease`, the latch never clears);
    - the known heartbeat frame bytes (`AA 04 00 00 5C 10`, from an independent Python CRC);
    - garbage round trip; every single-bit corruption; oversized length.
  - 7 existing CRC/protocol tests.
- **Mutations: 7 SafetyCore mutants all caught:** no clamp, 400 ms timeout, any frame re-arms, no
  replay check, disarm keeps the command, latch clears, no report self-check.
- **`pio run`:** vehicle build 55 KB flash, 4.4% RAM; bench build 55 KB. Both succeed.
- **Host:** 224/224. The ceiling cross-check is now exact against the firmware literal.
- **Bench tool `selftest`:** 8/8 (CRC, frame vector, struct sizes, parser).
- clang-format 18 and 22 clean; protocol copies identical.

**Phase 12 status: NOT started physically; the gate is unmet.** Needed, in order:
1. **Supervisor approval of the actuator design** (BOM note B).
2. **Parts:** hub board and sensors, BTS7960, ACS712, E-stop and relay, cable magnet, actuator,
   bench rig (BOM §5).
3. **Phase 2 bring-up on the bench** (Part 4.7): reports at 50 Hz, a relay toggled by command,
   the relay released within 200 ms of unplugging.
4. **The Part 13.3 checklist** with `log_actuator_bench.py`, three consecutive full passes.

## 2026-09-30 — Two-box hub: design, firmware, host and documentation

**What:** Ian's two-box hub design (windscreen pod + under-dash power box + roof LiDAR), carried
through the whole project. Design in BUILD_GUIDE Part 4.8; choices indexed in `decisions.md`.

**Research behind it (sources in the guide):** Livox Mid-360 manual (no glass in the field of view;
−7° to +52°; 55 °C; mounting plate); athermic windscreens and their uncoated window by the mirror;
KEBS's 2019 first-registration rule for imports and CAN's adoption for OBD; STM32F4 USB clock
accuracy (HSI unsuitable, no crystal-less recovery on the F405); CAN stub length; the STM32duino
core's CAN and USB build switches.

**Firmware (`firmware/sensor_actuator_hub`):**
- Board: `genericSTM32F405RG`; new pin map in `Config.h` (the pod board's netlist); `SystemClock.cpp`
  (8 MHz HSE, HSI fallback).
- `SafetyCore`: power-box presence (fault 5, disarm, release, re-arm on heartbeat), current reading
  ignored while absent.
- `ObdCan.h` (new, hardware-free): ISO 15765-4 poller that listens before it transmits.
  `ObdDriverCan.cpp` (bxCAN HAL wrapper); the ELM327 driver kept as `ObdDriverElm327.cpp` behind
  `-DHUB_OBD_ELM327` (`env:hub_elm327`).
- Drivers: one brake enable line; relays active-high; IMU and gesture on explicit I2C buses (gesture
  on I2C2 at 100 kHz); `StatusLeds`; `powerBoxPresent()`; `ignitionOn` from the presence line.
- `platformio.ini`: USB CDC actually enabled (see defect 1), CAN HAL, `HSE_VALUE`.

**Host:** `fusion/ImuMount` (vehicle-frame yaw rate, longitudinal acceleration and heading; two-step
calibration; knock check) with 8 tests; EventLog names fault 5; `vehicle_params.yaml`
`imu_mount_rpy_deg`; a LiDAR-tilt note in `lidar_camera_extrinsics.yaml`.

**Bench tool:** item 6 (inter-box cable unplug); six items per attempt; fault 5 decoded.

**Docs:** BUILD_GUIDE Parts 0, 1, 4.1–4.8, 6, 8.2, 10, 12.2.2 (new), 13.3 (item 6), 13.4, 14
(Phase 2 amended, Phase 12 six items, Phase 12B new), 15.2, Appendix B (fault 5), glossary,
references; BOM (superseded items marked, new items, §9 PCBs, budget ≈ KES 195,000–270,000);
system-architecture.md (physical layout); ar-overlay-design.md §3.8 (planned camera-shake
compensation); `hardware/README.md`.

**Defects found:**
1. **The firmware had no USB stack.** `-DUSB_CDC_ON_BOOT=1` is an ESP32 flag; STM32duino ignored it,
   so `Serial` was a hardware UART. The host link could never have worked. *Fix:*
   `-D PIO_FRAMEWORK_ARDUINO_ENABLE_CDC`. *Check:* the linked firmware now contains the USB CDC
   symbols (48; before: none).
2. **The generic F405 board definition runs from the internal oscillator,** unfit for USB. *Fix:*
   `SystemClock.cpp` with the 8 MHz crystal. *Check:* the map file shows our `SystemClock_Config`
   linked, not the variant's weak one.
3. **Design, caught before any hardware:** a floating current-sense line would have latched a false
   overcurrent on every cable unplug; CAN_H/L up to the pod would have hung a 2.5 m stub on the car's
   bus; a passive presence loop would have read "present" with the ignition off. All three fixed in
   the design and (1st) in SafetyCore.

**Verification:**
- `pio test -e native`: **38/38** (was 27): 3 new SafetyCore tests (disconnect, floating current,
  reconnect) plus power-box toggling in the 600,000-event fuzz; 8 new OBD poller tests (frame layout,
  parsing, 500k/11-bit lock, busy bus never transmitted on at a wrong rate, quiet bus fails once per
  candidate, back-off, loss and recovery, request rate).
- **Mutations:** 4 power-box mutants and 5 OBD-poller mutants, all caught.
- `pio run`: `stm32f4_hub` 70.6 KB flash / 7.3 % RAM; `bench` 71.3 KB; `hub_elm327` 70.8 KB. All build.
- Host unit suite **232/232** (plain and ASan), including 8 ImuMount tests; the host application links.
- Bench tool `selftest` passes.

**Not done (hardware):** everything physical. Phase 2 bring-up now uses an F405 development board and
a DB-25 cable; Phase 12B (PCBs, enclosures) is new and needs Ian's work and a supervisor's view of the
design.

## 2026-10-06 — Phase 12B, part 1: hub PCB schematics

**What:** KiCad 10 schematics for both custom boards of the two-box hub, generated and checked.
- `hardware/gen/kisch.py`: a small KiCad 10 schematic writer (copies real library symbols, places
  parts in labelled groups, connects by net label, no-connect flags on unused pins).
- `hardware/gen/pod_board.py`, `power_board.py`: the two designs (BUILD_GUIDE 4.8.2, 4.8.4).
- `hardware/gen/check_nets.py` and `check.sh`: generate, ERC, netlist cross-check, PDF and BOM.
- `hardware/README.md`: what exists, how to check it, layout guidance for Phase 12B.
- Config.h: four reserved pins defined (IMU INT/RST, gesture INT, GNSS PPS). Guide 4.8.4 amended
  (reverse-polarity diode, TPS54360), new 4.8.8 (generated schematics); BOM 4.1b.

**Teaching notes (for the viva):** why each pod output has a series resistor (back-powering an
unpowered box), why each power-board input has a pull-down (the fail-safe rule), why the CAN
transceiver's TX and standby inputs are pulled UP instead (recessive and standby are their safe
states), why the TPS54360's input capacitors, diode and inductor must sit together (the switching
current loop), and why a crystal sits within millimetres of the MCU.

**Verification:**
- KiCad ERC: **0 violations** on both boards (kicad-cli 10.0.1).
- `check_nets.py`: **all 101 checks pass**: 33 Config.h pins on the right STM32 pins, all 25 DB-25
  pins on both boards against the guide's table, series resistors, pull-ups, every fail-safe pull,
  no lonely nets, every footprint present in KiCad's library.
- Checker mutation-tested: a relay moved to the wrong pin, a pull-down removed, two cable pins
  swapped: each produced FAILs; the restored design passes.
- Firmware still builds with the new Config.h defines.

**Not done:** PCB layout, enclosure design, ordering (Phase 12B, Ian's work; guidance in
hardware/README.md). The IMU and GNSS header pin orders must be matched to the purchased breakouts.

## 2026-10-06 — Hub SensorReports into the EKF

**What:** the bridge from the hub's 50 Hz SensorReports to the EKF, plus the fixes it exposed.
- `host/.../fusion/HubReportFeeder.{h,cpp}`: time from the hub clock; GNSS on new fixes only; OBD
  speed rate-limited, NaN skipped, GNSS speed as fallback; gyro and compass through `ImuMount`;
  averaged longitudinal acceleration; `egoState()` for the tracker/arbiter; `updateHubState()`.
- `SensorFusion::predict(dt, a)`: measured acceleration as a control input (`accelInputStd`).
- Config: `imu_mount_rpy_deg` loaded and validated (`VehicleParams::imuMountRpyDeg`).
- Firmware SensorTask: `gpsFixValid` only while the fix is < 1.5 s old; `obdSpeedKph` NaN when
  invalid. Protocol field comments updated in both copies (layout unchanged).
- Guide Part 8.2 amended.

**Defects found:**
1. **Firmware: a lost GNSS kept being reported as a valid fix forever** (the driver keeps the last
   fix; SensorTask copied its validity, set once at update time). *Fix:* validity by age.
2. **Firmware: no OBD reading was reported as 0 km/h**, indistinguishable from standing still.
   *Fix:* NaN.
3. **EKF: speed lagged hard braking by ~1.1 m/s** (constant-speed model). *Fix:* acceleration input;
   lag now 0.17 m/s with a slope bias included.

**Teaching notes:** why repeated measurements over-weight a Kalman filter (independence assumption;
N repeats shrink the variance by N); why hub time beats host arrival time (the hub's schedule is
fixed, USB delivery jitters); control input vs measurement (acceleration drives the prediction,
OBD corrects it; the input's noise sets how far the filter trusts the accelerometer over OBD).

**Verification:**
- New `test_hub_report_feeder` (10 tests) on a simulated drive (straight, 0.15 rad/s turn, -3 m/s^2
  braking; IMU tilted 3/-12/25 deg; 5 Hz GNSS with 1.5 m noise; 10 Hz integer-km/h OBD with a 2 s
  NaN dropout; 100 Hz gyro; magnetometer with 2 deg bias; accelerometer with a 3 % grade's bias):
  worst position 1.44 m, heading 1.63 deg, steady speed 0.26 m/s, braking lag 0.17 m/s (1.13 m/s
  without the input); uncalibrated mount: heading error 16.5 deg. Each GNSS fix fed exactly once;
  NaN OBD never fed; resets and long gaps not predicted across; non-finite IMU values skipped.
- New EKF test for the acceleration input; 2 new config tests.
- Mutations caught: GNSS fed every report, NaN OBD fed, acceleration input dropped.
- Host unit suite **245/245** (plain and ASan); firmware native 38/38; firmware builds; app links.

**Not done:** VehicleInterface itself (serial I/O) waits for the hub (Phase 3 with hardware); it will
call `HubReportFeeder::feed()` for every SensorReport.

## 2026-10-06 — VehicleInterface against a simulated hub (Phase 3, without hardware)

**What:**
- `host/.../vehicle/FrameDecoder.h`: host frame codec (independent of the firmware's).
- `host/.../vehicle/VehicleInterface.{h,cpp}`: serial link (termios), heartbeats, commands from
  ActuationRequests, zeroed command on a quiet arbiter, brake hold, reports to HubReportFeeder and
  HubState, ack and gap logging, crash frame, final zeroed command.
- `host/tools/hub_sim/`: the firmware's SafetyCore + FrameParser behind a pseudo-terminal, as a
  library for tests and a `hub_sim` tool (status line each second; k/b toggle the kill switch and
  power box).
- `main.cpp`: starts VehicleInterface (`--serial`, `--no-hub`), feeds the EKF, registers the
  final-command hook. Guide 11.1 amended; Appendix D: ModemManager.

**Defects found:**
1. **Running the real program against hub_sim: 1.5 s disarmed at startup, fault 4.** The new
   pseudo-terminal echoed the hub's reports back into its own input (83 garbled frames) until the
   host set raw mode. *Fix:* hub_sim sets its terminal raw at creation. Real-world equivalent
   (ModemManager probing ACM devices) documented.
2. **Ack logging would fsync ~7 lines/s during a persisting fault.** *Fix:* log on change, and every
   ack with the brake applied.
3. **A missing hub would have failed on the subsystem thread after "running".** *Fix:* open on
   construction from main. EKF objects moved before SystemManager (lifetimes).
4. **UBSan in my own test:** EXPECT_EQ bound a reference to a packed field. *Fix:* copy to locals.

**Teaching notes:** pseudo-terminals (a master/slave pair that behaves like a serial port, with a
line discipline that echoes unless set raw); why the host never relies on itself to release (the
hub's watchdog does; the host's zeroed command and short hold only make it faster); why two
independent codecs tested against each other beat one tested against itself.

**Verification:**
- `test_vehicle_interface`: 15 tests. Codec cross-checks (300 random frames both ways, identical
  bytes; every single-bit corruption rejected with the next frames delivered; the crash frame is a
  zeroed command to the firmware). End to end against the firmware's SafetyCore: armed by
  heartbeats; 255 requested -> 90 applied and logged; **quiet arbiter -> released in 134 ms**;
  **host stopped -> hub watchdog released in 188 ms** (fault 3); **final zeroed command -> 2 ms**;
  power box unplugged -> fault 5 in HubState and the log, re-arms when back; garbage survived;
  report gap logged and its end; reports drive the EKF to 10 m/s heading east.
- 20 repeated runs: 0 failures. ThreadSanitizer (under `setarch -R`): no warnings.
- Mutations caught: timestamps not forced upward, no heartbeats, no zeroed command.
- Host unit suite **260/260** (plain and ASan). Full application builds and ran against hub_sim:
  armed in the first heartbeats, 0 frame errors, clean ordered shutdown with the final zeroed
  command, hub disarmed with fault 3 afterwards.

**Phase 3 exit criteria still need the real hub** (13.2 loopback with the Phase 2 firmware).

## 2026-10-06 — Board outlines, LiDAR roof mount, power-box enclosure

**What:**
- `hardware/gen/outlines.py`: both boards' outlines, M3 holes and edge-connector positions in one
  place; writes the starter `.kicad_pcb` files and `hardware/enclosures/common/boards.scad`. Pod
  80 × 55 mm (4 layers), power 110 × 80 mm (2 layers, 2 oz).
- `hardware/enclosures/lidar_mount/lidar_mount.scad`: base plate on four pot magnets, printed 15°
  wedge with M4 inserts, 130 × 130 top plate as the Livox heatsink; STL, DXF/SVG, renders.
- `hardware/enclosures/power_box/power_box.scad`: printed chassis for a bought ~250 × 150 × 100 ABS
  junction box (board, BTS7960, ACS712, six relays), DB-25 through the front wall, eight M16
  glands at the rear, vents by the heatsink; chassis STL, renders.
- `hardware/enclosures/make_templates.py`: 1:1 drilling templates (PDF) from each model's own hole
  lists: LiDAR plates, and the power box's front, rear and left walls and floor (DB-25 D cut-out).
- `hardware/enclosures/README.md`: fasteners, print settings, assembly, what to measure first.
- Guide 4.8.2, 4.8.4, 4.8.6 and BOM 6.3, 6.3c, 9.1, 9.2 amended (board sizes, the larger box).

**Defects found:**
1. **The first wedge floated above the base:** a hand-built polyhedron had faces wound the wrong
   way. *Fix:* the wedge is a block intersected with a tilted half-space.
2. **The wedge's lightening pocket cut into the insert bosses.** *Fix:* shrunk to 40 × 30 mm.
3. **The power board would have been mirrored in the box:** KiCad's y axis points down, so copying
   its coordinates straight into the box frame flips the board. *Fix:* the board is placed turned
   180° (top edge to the front wall) through one function, `board_to_plate()`; the render shows
   the fuses front-right and the module headers beside the modules, as on the KiCad outline.
4. **The guide's 150 × 100 × 60 power box cannot hold six 28 mm relays** beside the board. *Fix:*
   a ~250 × 150 × 100 junction box; guide and BOM amended.
5. **A floor-template table spilled onto a fifth page.** *Fix:* tighter landscape layout.

**Teaching notes:** why the 15° lives in a printed wedge and the plates stay flat (a different tilt
is a re-print); a heatsink plate's "exposed area"; heat-set inserts versus screws into plastic;
why the template is generated, and how to check a print is truly 1:1 (the 100 mm bar).

**Verification:**
- Both starter PCBs load in KiCad 10: DRC 0 violations, 0 unconnected.
- LiDAR mount: side render shows the front lower and the connector to the rear; hole positions
  match manual v1.2's dimensions; 130² − 65² = 12,675 mm² ≥ 10,000.
- Power box: top and 3D renders checked for clashes (gland bodies above the 36 mm relays; bosses
  clear of the modules, relays and board); chassis renders as one solid.
- Templates rasterised at 10 px/mm: the 246 mm wall measures 246.2 mm (line width).

**Still to check against real parts (marked VERIFY):** the box's inside size, module and relay
socket holes, heatsink height, DB-25 shell; the LiDAR's dowel holes before drilling them.

## 2026-10-07 — Power board schematic redrawn as wired sheets

**Why:** Ian found the generated schematics hard to read: every pin was connected by net label,
so the circuit could only be followed by matching names.

**What:**
- `hardware/gen/kisheet.py`: hierarchical KiCad 10 writer. Parts placed by hand (position,
  rotation, mirror); wires routed by an A* maze router on the 1.27 mm grid; power symbols upright
  on power pins (or one symbol on a drawn rail); hierarchical labels for nets that leave a sheet;
  local labels naming the rest; a root sheet with one box per sheet and the cable signals wired
  between the boxes.
- `hardware/gen/power_board_drawing.py`: the power board's layout: 12 V input, 5 V converter,
  3.3 V and feeds, brake actuator, signal relays, CAN, status inputs, DB-25; notes on each sheet.
- `hardware/gen/compare_nets.py` and a `check.sh` step: the label-only and the drawn netlists must
  be identical. `generate.py --flat --out DIR` builds the label-only version.

**Defects found:**
1. **`check_nets.py` never read the components** (so "every part has a footprint" passed with
   nothing to check): KiCad 10 writes `(comp` and `(ref` on separate lines and the pattern
   expected a space. *Fix:* `\s+`. Now 74 pod and 82 power-board parts are read; all have
   footprints. The net checks were unaffected (a different pattern).
2. Multi-line notes with raw newlines made KiCad load a sheet as blank. *Fix:* escaped `\n`.
3. KiCad turns a field's angle and justification with its symbol: rotated parts showed sideways
   reference text, mirrored connectors misplaced it. *Fix:* fields written centred, angle undone.
4. Ground symbols dog-legged across the DB-25's neighbouring signal rows. *Fix:* each signal pin's
   exit lane is reserved before power symbols are placed.

**Teaching notes:** hierarchical sheets (sheet pins, hierarchical labels, how KiCad names a net that
spans sheets); why a plain wire crossing is not a connection and a junction dot is; reading a
buck converter's schematic against TI's reference drawing.

**Verification:** ERC 0 violations; drawn netlist identical to the label-only one (82 parts, 59
nets, names included); all `check_nets.py` checks pass (102 PASS lines in `check.sh`); every page
reviewed as a rendered PDF. The BOM export is byte-identical to before.

**Next:** the pod board the same way.

## 2026-10-07 — Pod board schematic redrawn; duplicate references found

**What:**
- `hardware/gen/pod_board_drawing.py`: six sheets (pod supply, USB-C, MCU, sensors and local
  connectors, status LEDs, cable interface) under a block diagram with the MCU in the middle.
- `kisheet.py`: stacked pins (the STM32's and USB-C's) share one terminal; PWR_FLAGs on signal
  nets are wired into the net; per-net column hints for crossing-free fan-ins; nets can be drawn
  as separate pieces joined by name (USB D+/D- either side of the ESD array, which joins its own
  pins inside); power symbols show the rail's name; sheet-box rows with pins on both sides.
- `check.sh` compares both boards' drawn and label-only netlists.

**Defects found:**
1. **R31, R32 and R33 were each used twice on the pod board** (status LEDs, and the CAN_RX and
   HX711 input resistors): the cable-part numbering ran from R10 into the LEDs' range. KiCad's ERC
   did not report it, and the BOM still listed all 77 parts, but the netlist (what the PCB is
   built from) merged each pair into one part: 74, so the PCB would have lacked three resistors
   and joined their nets. Found because the drawing looks parts up by reference. *Fix:* cable
   parts from R40/C40; `generate.py` rejects duplicate references; `check_nets.py` fails if any pin
   is in two nets (it flags R31-R33 on the old netlist).
2. Power symbols had no visible name (+3V3, VBUS, +5V and +12V looked alike). *Fix:* name shown.
3. In a hierarchical design KiCad names a sheet's own nets with the sheet path
   (`/Inter-box cable.../X_BRAKE_RPWM`); `check_nets.py` only stripped a leading `/`, so 40 checks
   failed on the drawn pod board. *Fix:* the name after the last `/`.

**Verification:** ERC 0 violations on both boards; drawn netlists identical to the label-only ones
(pod 77 parts / 88 nets; power 82 / 59, names included); `check.sh` 105 PASS, 0 FAIL. Mutation:
BRAKE_EN moved to the wrong MCU pin was caught (Config.h check), then restored. Every page
reviewed as a rendered PDF.

## 2026-10-07 — Phase 4: CameraPipeline (software; exit check waits for the camera)

**What:**
- `camera/CameraConfig.{h,cpp}`: sources (UVC device through GStreamer, video file, `gst:`
  pipeline), the MJPG/YUYV pipeline strings, `camera.yaml` and `camera_intrinsics.yaml` loading
  (the template = uncalibrated; nonsense refused), `FrameRateMonitor` (sustained fps, longest gap,
  late frames).
- `camera/CameraPipeline.{h,cpp}`: capture -> stamp -> undistort (precomputed maps) -> frameBus;
  `frameModel()`, the camera model of the published frames; bounded reads, stall = FAULT; bus
  overflow counted; the measured rate logged every 10 s.
- `tools/camera_check`: Phase 4's exit check (each size measured through usbipd; `--list`).
- `main.cpp`: the camera starts with the system (`--camera <source>`, `--no-camera`).
- `host/config/camera.yaml`; guide Part 6 and Phase 4 amended; Camera.h notes which model to use.

**Defects found (all before they shipped):**
1. **The design would have distorted twice:** Part 6 undistorts the frames, while CameraModel
   applies the lens distortion when projecting. *Fix:* the pipeline publishes the model of its
   frames; consumers take that one (decisions.md).
2. **Reusing one capture Mat would overwrite a frame the inference thread still holds**
   (VideoCapture writes into a Mat's existing buffer when the size matches, even if shared).
   *Fix:* a new Mat per frame; a test holds a frame across later captures.
3. **The constructor's size-probe frame would have been published late with a current
   timestamp.** *Fix:* it is never published.
4. An unbounded read would hang the thread on a stalled camera. *Fix:* GStreamer read timeout.

**Teaching notes:** why 2K needs MJPG over USB (bandwidth); reference-counted cv::Mat and buffer
reuse; undistortion maps; why a frame-rate average hides lost frames.

**Verification:**
- Unit (CI): `test_camera_config`, 12 tests; whole suite 272/272.
- Integration (`ctest -L camera`, GStreamer's videotestsrc as the camera): 9/9: every frame in
  order at 30 fps; held frames unchanged; both camera formats' pipelines decode; **undistorted
  dots within 0.66 px of frameModel()'s projection** (34.7 px if distorted again); a calibration
  for another size refused; stall reported in < 1.5 s; stop in < 300 ms; bus overflow counted;
  file replay.
- Mutations caught: buffer reuse; the lens model published with undistorted frames; unbounded
  reads (the stall test now has a deadline, so it fails rather than hangs).
- `camera_check` on test sources: PASS at 30.01 fps; FAIL at 29.80 fps with one lost frame.
- The application with a 2560x1440 test source: 30.0 fps, 0 late, undistortion 3.9 ms/frame;
  clean shutdown in 28 ms. (Frames pile up on the bus until Phase 5's thread is wired: counted.)

**Phase 4 exit criteria still need the camera** attached through usbipd: run `camera_check`,
record the table in decisions.md, set the size in camera.yaml, then calibrate (Part 12.1).

## 2026-10-07 — Pre-hardware item 1: the whole system on a recorded drive

**What:**
- Threads (Part 5.1): `scene/FusionThread`, `decision/DecisionThread`, `render/RenderThread`,
  `nav/NavigationThread`, `lidar/LidarReplay`; `fusion/EgoEstimator`; buses in
  `system/PipelineMessages.h`; the camera's second (display) bus; `main.cpp` starts them all
  (`--replay`, `--inject-obstacle`, `--destination`, `--no-display`).
- Recordings (`system/Recording.h`); `tools/bench_rig/kitti_to_recording.py` (KITTI raw drive
  2011_09_26_0005: 154 frames, 15.8 s, a city drive with a cyclist ahead); `hub_sim --replay`.
- `tools/replay_inspect` (deterministic, CSV + annotated video); `lidar/InjectedObstacle`
  (world-fixed, both sensors); `lidar/LidarProcessor` ground fit (item 2 begun).
- `tools/bench_rig/replay_recorded_frames.py`: the Part 13.2 harness, 21 checks.

**Defects found on the replay, each fixed and tested:**
1. **Ghost target braked on** (frame 95): a track coasted 0.6 s, re-associated to a LiDAR fragment
   at the bumper, kept its old 11.6 m/s closing speed: TTC 0.005 s, BRAKE. *Fix:* rule 1 needs an
   unbroken 200 ms LiDAR-measured run (`brake_min_measured_track_ms`).
2. **Corner exit** (frame 129): finishing a right turn (-10 deg/s), the constant-turn path ran
   through a car parked at the kerb 13 m ahead. *Fix:* rule 1 also needs the straight path.
3. **Flat road assumed** (frame 5): a road rising ahead became a "wall" of LiDAR points rushing at
   25 m/s; it braked. *Fix:* the ground fitted per scan (`LidarProcessor`).
4. **Median instead of near face:** the gap read up to 1.4 m long; the LiDAR-only and camera
   measurements of one car made two tracks (0.5 s late braking). *Fix:* `nearFace`.
5. **Duplicate measurements** of one surface broke the real track's measured run (braking lapsed
   for 1 s). *Fix:* merged within 0.3 m.
6. **The injected obstacle was physically impossible twice** (LiDAR only; fixed in the car's
   frame). *Fix:* world-fixed on the recorded road, painted into the camera.
7. **Unoptimised build** (no CMAKE_BUILD_TYPE, -O0): the LiDAR replay fell behind; 94 of 98 scans
   "too old", no fusion, no brake in real time. *Fix:* RelWithDebInfo by default.
8. **Segfault on every shutdown with the window open:** SDL unloaded the GL library under Mesa's
   D3D12 driver threads. *Fix:* the GL library is pinned for the life of the process.
9. Tried and rejected: tolerating one missed frame in the measured run (a false brake came back).

**Teaching notes:** why a stopped car must be consistent across sensors (and how an inconsistent
test object misleads); the near face vs the median for time to collision; ground-plane RANSAC;
ghost tracks and track persistence in AEB; corner-exit path prediction; dlclose under live threads.

**Verification:**
- `replay_recorded_frames.py`: **21/21 PASS**. Recorded drive: 0 brakes (it made 2 false ones
  before). Obstacle at 2.4 s: braking from a true TTC of 1.13 s (a real cyclist's track took over
  the obstacle and needed 4 frames to turn its velocity round); at 11 s: from 1.68 s; no lapse
  beyond the 300 ms hold; gap error +0.05 / +0.02 m mean. Real time: 16 BRAKE requests, the
  firmware's SafetyCore applied 60, no FAULT, ordered shutdown, exit 0; the drive without the
  obstacle: no brake.
- Unit 281/281 (new: ground fit 6, measured run, corner exit, near face, arbiter conditions);
  integration: pipeline 6, camera 9, gpu 20, osrm 9.
- With the window open (WSLg, D3D12 on the RTX 5060): runs, brakes, exits 0.

**Not done here (needs hardware or later items):** the live Livox capture (item 2), the Mid-360's
own coverage, Part 12.4's projection precision check on the real camera.

## 2026-10-07 — Item 1 re-verified under real-time timing; item 2: the live Mid-360 capture

**Why:** re-running the harness after item 1, the real-time drive with no obstacle braked once
(1 request, peak 60). Intermittent: 2 of 4 real-time runs, then 0 of 8. To make it reproducible,
`replay_inspect --jitter SEED` replays the drive with the timing variations of a real-time run (a
frame sometimes gets the scan before the newest; the hub clock shifted by up to +-60 ms).

**Defects found with the jitter, each fixed and tested:**
1. **One-cycle false brakes** (6 of 40 seeds on the drive with no obstacle): a velocity spike from
   one scan (closing at 23-37 m/s while the car did 6 m/s), or a parked car or kerbside cyclist
   flickering across the 1.2 m path edge (TTC 1.69-1.80 s). Every one lasted one cycle. *Fix:* rule
   1 starts braking only once its condition has held on the same target and the LiDAR has measured
   that target again 100 ms later (`brake_confirm_ms`, `DecisionArbiter::step()`); once braking it
   continues. Cost: up to 100 ms (0.8 m at 30 km/h). **For Ian to review** with the other rule-1
   changes.
2. **A frame with no usable LiDAR scan counted as a miss for every track.** Under jitter, one frame
   in three had none (the scan before the newest was over 150 ms old); every measured run restarted,
   and the stopped obstacle in the lane was braked for at a true TTC of 0.0 s, or never. *Fix:*
   `MeasurementBatch::observed = false` for such frames: tracks are predicted only. Rule 1's
   "measured within 200 ms" still applies.
3. **The confirmation completed on a prediction:** after fix 2, a kerbside cyclist's track,
   predicted inward through a frame with no scan, completed it and braked (seed 11, frame 137).
   *Fix:* the confirming measurement must be a real one (fix 1 as stated).

**What the jitter still shows (reported by the harness, not failed):** with the obstacle at 11 s,
braking starts at a true TTC of 1.16-1.58 s in 15 of 16 seeds (0.85 s in one, where the obstacle
stands beside a real cyclist whose track takes over its measurements on stale-scan frames). With the
obstacle at 2.4 s, which stands in an S-bend (its true lateral offset swings from 9 m left to 3 m
right during the approach) and also beside a cyclist: 0.95-1.05 s in 13 of 16, 0.46-0.76 s in the
other 3. The constant-turn path cannot follow an S-bend, and rule 1 also needs the straight path, so in
an S-bend rule 1 is late by design; road tests (Part 13.4) will show whether that needs the map's
road geometry. Before these fixes the same 16 seeds at 11 s gave 0.0-1.58 s, 10 of them under 1.0 s, and one
never braked.

**Item 2, the live LiDAR (no Mid-360 yet):**
- `lidar/LivoxPackets`: packet bytes to timestamped points (high/low-precision Cartesian, per-point
  time, "no return" dropped), and `ScanAssembler`: 100 ms scans, the LiDAR clock mapped onto the
  host's by the smallest offset over 2 s, reset on a LiDAR clock jump. No SDK dependency: unit-tested
  in CI with synthetic packets (`test_livox_packets`, 5 tests).
- `lidar/LivoxCapture`: the SDK2 glue (config generated, callbacks, normal mode on discovery), the
  ground fit per scan, a stall watchdog (FAULT and shutdown after `stall_timeout_s`), and
  `static_assert`s holding the decoder's byte offsets to the SDK's structs. Built only when the SDK
  is found (`AR_HAVE_LIVOX`); `main` uses it when not replaying; `host/config/lidar.yaml`.
- Livox SDK2 built from source into `~/.local/livox` (no sudo); found by `host/CMakeLists.txt`.
- BUILD_GUIDE: Part 2.8 (local install), Part 8.1 (what the capture does; voxel downsampling and
  PCL clustering not done, deliberately; road-anomaly pass deferred, no consumer), Appendix C
  corrected (the Mid-360 is at 192.168.1.1xx from its serial number, not .100).

**Verification:**
- `replay_recorded_frames.py`: **22/22 PASS** (new: the drive under timing jitter, seeds 1-10, never
  brakes). Deterministic onsets unchanged (1.05 s and 1.58 s). The real-time drive with no obstacle,
  6 further runs: 0 brakes.
- Jitter, 40 seeds, drive with no obstacle: 0 brakes (6 before).
- Unit 288/288 (new: the onset confirmation, an unobserved cycle is not a miss; the Livox packet
  tests were in the earlier count);
  integration 44/44. The lead-car scenario still first brakes at a true TTC of 1.50 s (window
  1.2-1.9 s).
- Not verifiable until the Mid-360 arrives: the packet format against a live unit, the clock offset,
  the scan rate, and fusion's time on Mid-360 clouds (Part 13.3).

**Teaching notes:** why a cycle with no observation is not evidence of absence (and how treating it
as one breaks track persistence); confirmation logic in AEB, and why it must rest on measurements,
not predictions; mapping two free-running clocks by the minimum offset; decoding a binary protocol
from bytes, held to the vendor's structs by `static_assert`.

## 2026-10-08 — Pre-hardware item 3: calibration tools, and the recorder

**What:**
- `host/scripts/run_camera_calibration.py` (Part 12.1): views from a folder or captured from the
  camera at the running resolution; corner detection (sector-based, classic fallback); outlier
  views dropped; refuses frontal-only sets, poor coverage, RMS over 1 px; writes the host's YAML.
- `system/Recorder` and `ar_drive_assist --record DIR`: frames (after undistortion, with their
  model), scans, hub reports, extrinsics, in the replay format; taps on the camera and both LiDAR
  sources; bounded queues, drops counted; never overwrites a recording.
- `host/scripts/run_lidar_camera_calibration.py` (Part 12.2): board planes from a recording of a
  board held still in several poses.
- `scene/ExtrinsicMonitor` + `ExtrinsicMonitorThread` (Part 12.2.1), wired into `main`,
  `FusionThread` (refined projection; DEGRADED: LiDAR-only ranging) and the renderer (a fixed
  "recalibrate" notice for the driver).
- CI: a Python job runs `host/test/scripts` (8 tests).

**Defects and findings:**
1. The recorder's intrinsics file was cut off (a 256-byte buffer): caught by replaying the first
   recording; a round-trip test now covers it.
2. Camera calibration on synthetic views was 6.7 px off in the corners: no view reached them (the
   board must fit whole). The test now measures what a calibration can claim (the covered region,
   up to a rotation the extrinsics absorb): 0.34 px.
3. The LiDAR–camera tool at first missed by 1.7°: the synthetic camera (800 × 450) saw the boards
   too small to place their planes. At the 2K camera's scale: 0.39°, 6.8 px at 5–40 m.
4. ExtrinsicMonitor, five failures on KITTI's real frames, each fixed: one-sided depth edges biased
   pitch (pairs); texture biased the score (local normalisation); the narrow peak was out of reach
   from 0.7° (coarse to fine); a weak axis drifted to the bound (held-out per-axis selection); a
   2.5° error looked "verified" (the wide look); and a real-time replay "refined" 0.97° of yaw from
   timing during turns (no evidence while turning). Translation is not refined (the score is flat
   in it).

**Verification:**
- Python: 8/8 (camera calibration 5, LiDAR–camera 3). Unit 288/288. Integration 52/52 (new: the
  Recorder round trip; ExtrinsicMonitor 7, synthetic and KITTI; the driver notice).
- `replay_recorded_frames.py`: 22/22, with the monitor running in the real-time host (it reached
  no verdict on the 15 s drive: too little straight driving, as designed).
- Recorded the KITTI replay through the live host (153 frames, 154 scans, 840 reports, nothing
  dropped) and replayed the recording: no brake on the drive; with the obstacle, braking from a
  true TTC of 1.37 s.
- clang-format: the whole tree clean (CI's check).
- Waiting for hardware: everything on the real camera, Mid-360 and board (Part 12 procedures).

**Teaching notes:** pinhole + distortion calibration and why views must reach the corners; the
focal-length/distance ambiguity of frontal views; plane-based target calibration and its
observability; edge-alignment scores and their biases (one-sidedness, texture); fit/held-out
decisions against noise; why a timing error looks like a rotation in a turn.

## 2026-10-08 — Pre-hardware item 4: setup scripts

**What:**
- `host/scripts/setup_env.sh` (Parts 2.3, 2.6-2.10): installs only what is missing (the apt list
  is the build's real `find_package` set plus the GStreamer decoders and OSRM; source-built tools
  are left alone), the `dialout`/`video` groups, ModemManager off (Appendix D), Livox SDK2 into
  `~/.local/livox`, the Python tools' packages (`host/scripts/requirements.txt`) into the active
  venv; then Part 2.10's checks. `--dry-run`, `--check-only`. Never installs CUDA/TensorRT or
  builds OpenCV.
- `host/scripts/attach_usb_devices.ps1` (Part 2.2): devices by USB hardware id (survives a change of
  port) or bus id, remembered with `-Save`; binds only what is unshared (the only step needing
  admin), attaches only what is not attached, `-Detach`, then lists the devices from inside WSL2.

**Found:** the guide's checks would have failed this machine wrongly twice: OpenCV is the accepted
4.14 CUDA source build (decisions.md), not 4.10, so the check is ">= 4.10 and built with CUDA";
and OSRM is built from source, so its apt package is not needed.

**Verification:** `setup_env.sh --check-only`: every check PASS (camera and hub: WARN until they
exist); `--dry-run` lists exactly the two group changes still to make. The PowerShell script parses
in Windows PowerShell 5.1 and finds devices by hardware id and by bus id (exercised through
`-Detach` on unattached devices, which changes nothing). Binding and attaching the real camera,
adapter and hub wait for them.

**Teaching notes:** usbipd's bind (once, admin) vs attach (every session); why device identity
should be VID:PID, not a port; idempotent setup scripts and checks that state what they accept.

## 2026-10-08 — Pre-hardware item 5: assembly-day procedures

**What:** `docs/assembly/`, generated by `hardware/gen/assembly.py` from the same board
descriptions as the schematics: the DB-25 cable build sheet, power board and pod board bring-up,
the power box's off-board wiring (with a diagram), and the bench rig's setup. Every expected
reading is computed from part values (or quotes a named datasheet figure): +5 V = 5.004 V from the
TPS54360's 0.8 V reference and R44/R45; the UVLO points from R41/R42's design values; the
brake-current line's idle level 1.667 V alone, 1.562 V loaded by the pod's 100 k. The off-board
wiring is the one hand-written table, and the generator refuses to run if any connector on either
board lacks an entry. `hardware/gen/check.sh` now also fails if the documents are stale.

**Found while writing it:** both boards bond their DB-25 shells to ground, so "shield at the box
end only" has to be done in the cable (braid to the hood at the box end, cut back and insulated at
the pod end); the build sheet says so. Reviewing the generated text caught five slips of mine
(D10 is a shunt TVS, not in the series path; D11's drop at idle; a resistance measured on a powered
circuit; an unreadable UVLO phrase; J13's pin order losing its unused pins), each fixed in the
generator. Observed, not changed: `check.sh` regenerates every schematic with fresh UUIDs, so it
dirties them in git even when nothing changed.

**Verification:** `hardware/gen/check.sh`: ALL CHECKS PASS (ERC, netlist cross-checks, footprints),
then "docs/assembly up to date". The regenerated schematics differed only in UUIDs and were
restored. The procedures themselves are verified on assembly day.

**Teaching notes:** bring-up order (look, measure cold, current-limited first power, rails, fail-safe
state, then function); why a 1 kΩ series resistor and a 10 kΩ pull-down make the cable fail safe;
ground loops and single-point shield bonding; generating documentation from the design data.

## 2026-10-08 — Demonstration videos; the collision barrier matches rule 1

**What:** `replay_inspect --ar-video` renders the driver's view with the real renderer (ArRenderer
+ WindowedSink, offscreen, read back from the GPU) for every replayed frame;
`tools/bench_rig/make_demo_video.py` lays it out with the sensor view, the decision and a timeline
(`data/demo/`, not versioned). Two videos: KITTI 0005 with a test obstacle at 11 s, and as recorded.

**Found by watching it:** the forward-collision barrier was drawn for any object in the curved
predicted path, while rule 1 also requires the straight path, so a car parked at the kerb got a
barrier and a "9 m" label for something the system would never brake for. *Fix:*
`HazardView::inBrakePath` (curved AND straight path, rule 1's geometry) gates the barrier, its gap
label and the stop-gap; an object in the curved path only keeps its warning glow.

**Verification:** unit 289/289 (new: no barrier outside the brake path); integration 52/52; the
regenerated video shows the parked car with its glow only and the obstacle with its barrier; the
drive as recorded: 0 brake requests.

**Not final (stated with the videos):** a German drive under Kenyan rules and a Kenyan sign
detector; no route line (the map is Nairobi's); colours and sizes untuned until the real display.

## 2026-10-08 — Pre-hardware item 6 (Phase 12B): both boards placed; the layout guide

**What:**
- `hardware/gen/layout.sh` / `layout.py` (KiCad 10's own Python): builds each `.kicad_pcb` with
  every footprint from KiCad's library, each pad on its net from KiCad's exported netlist, placed
  per `placement.py`, linked to its schematic symbol; writes the net classes and fab rules
  (`pcb_rules.py`) into the `.kicad_pro`; adds the planes (pod: GND In1, +3V3 In2; power: GND
  bottom); runs KiCad's DRC with the schematic-parity check. Refuses to overwrite a routed board.
- `hardware/LAYOUT_GUIDE.md`: PCB basics from zero, the placement and its reasons, routing each
  board in order, finishing, ordering, checklists. `<board>/placement.md` and `placement.png`.

**Found and fixed on the way:**
1. **The power board's terminal blocks could not fit their edge**: 5.08 mm blocks need ~138 mm, the
   bottom edge gave 92. Split over three edges by function (car wiring bottom, actuator right,
   input/LiDAR left); `outlines.py` and the power-box model updated. Only the DB-25 passes through
   a wall, so no drilling changes.
2. **The schematic generator made random ids** on every run: every schematic changed in git each
   time, and the PCB's links to the symbols would have broken on the next regeneration. Now seeded
   per board (and one wire's point order made deterministic): two runs are byte-identical.
3. **Net names**: KiCad names nets by their sheet path; the PCB now takes them from KiCad's own
   netlist, cross-checked pin by pin against the board description.
4. The GNSS header first overlapped a mounting hole (caught by DRC), turned.

**Verification:** DRC with schematic parity: pod 77 parts, 172 connections to route, **0 errors,
0 parity issues**; power 82 parts, 163 to route, **0 errors, 0 parity issues**. Warnings: silkscreen
labels in the dense rows only (tidied by hand, guide G3). `check.sh` still ALL PASS; a re-run leaves
the schematics byte-identical (PDFs differ only by their timestamps). IPC-2221 widths: 10 A on
2 oz needs 3.6 mm (4.0 used, or a zone); 3 A needs 0.68 mm (1.0 used).

**Still open:** routing (Ian, the guide); J2/J3 pin order and the IMU breakout's standoff holes
wait for the bought breakouts.

**Teaching notes:** footprints, courtyards and DRC; why decoupling sits at the pin; return paths
and ground planes; a buck converter's hot loop; track width from current (IPC-2221); why
generated files must be deterministic.

## 2026-10-08 — Both boards compacted, each proven routable; the power box follows

**What:** pod board 80 × 55 → **70 × 53 mm** (−16 % area); power board 110 × 80 → **90 × 66 mm**
(−33 %). `outlines.py` (sizes, holes, connector zones) and `placement.py` changed; the power box's
chassis plate 210 × 130 → **210 × 112 mm**, its relay row moved forward behind the board, the STL,
pictures and drilling templates regenerated. The bought box is unchanged: the six-relay row
(~193 mm) sets its length.

**How "as compact as the design allows" was decided:** `hardware/gen/routecheck.sh` (new) autoroutes
a throwaway copy with Freerouting 2.5 and runs KiCad's DRC on it. A squeeze was kept only if every
signal still routed with no error. The pod at 70 × 51 failed (the ~20 cable signals could not all
leave the MCU through a 3.4 mm channel on two signal layers, and capacitors under the MCU's bottom
pins blocked their exits); 70 × 53 with those capacitors moved passes. The power board's width is
set by its bottom terminal row (~83 mm) and its height by four packed bands.

**Design improvements found by the check (kept in the real design):**
1. Plane settings: 0.3 mm clearance / 0.25 mm minimum left no room for thermal spokes between the
   DB-25's pins (they never joined the plane). Now 0.2 / 0.2 with 0.3 mm spokes (0.3 clearance on
   the power board, its largest class clearance).
2. The 10 A actuator rail is now a pre-drawn copper zone (4.4 mm spine joining J5, J6, J7), and the
   magnet's flyback diode D14 sits at the magnet terminal under it.
3. Two pinch points on the power board widened (U3, J12).

**Verification:** DRC with schematic parity: pod 0 errors, 172 connections to route; power 0 errors,
160 to route; parity exact. Routability: both pass (pod and power: 0 signal connections left; power
twice in a row). `check.sh` ALL PASS; assembly documents up to date (they do not depend on placement).

**Teaching notes:** routability, not overlap, limits compaction; escape routing from a fine-pitch
IC; why an autorouter is a test here and not the design.

## 2026-10-09 — Both boards routed to specification; labels, terminals, buttons, USB-C model

**What:** both PCBs routed by script (Ian's request: "do the PCB routing too as per specification
and design"). `hardware/gen/route.sh` routes each placed board with Freerouting 2.5 inside rule
areas and net classes that encode LAYOUT_GUIDE's specification, mends what the autorouter gets
wrong, and keeps a board only when KiCad's DRC passes; `hardware/gen/routespec.sh` (new) checks
the specification points the DRC does not know. Also, from Ian's review of the placement:
1. **Screw terminals** faced into the board (the 3D view showed it): turned 180°, wire openings
   now flush with the edges, bodies in the same place.
2. **RESET/BOOT** are side-push switches (Panasonic EVQ-P7C) on the pod's left edge under the SWD
   header, pressed through pin-holes; the ELM327 header moved inboard.
3. **Labels:** every terminal, port, header and button is named on the silkscreen, with its pins
   (header pins carry the module's names); references moved to clear spots or onto the fab layer.
4. **USB-C** footprint GCT USB4105 (same 16 pins): KiCad has no 3D model of the HRO part.
The power board grew to 95 × 66 mm for the right edge's names; the power box is unchanged (STL,
pictures and templates regenerated).

**How the routing was made to pass:** planes are not routed: GND (both boards) and +3V3 (pod)
pads each get a via before routing (the pod MCU's supply pins a short tie to their capacitor), and
the router ignores GND; the pod's In1 and In2 are declared power layers. After routing:
neck-downs widened to their class width where they fit, plane copper boxed in by tracks joined,
any connection the router left out joined at its net's class width, scraps of pour removed. A
failing board is routed again from a fresh placement (Freerouting differs run to run).

**Verification:** DRC with schematic parity: pod 0 unconnected, 0 errors (1 cosmetic silk
warning); power 0 unconnected, 0 errors (terminal outlines at the edge, on purpose); parity exact
on both. `routespec.sh`: pod (no track on In1/In2, nothing under the crystal, widths) and power
(rail zone solid, no bottom track under the converter, bottom a GND zone, widths) all PASS.

**What did not work, and why (kept for the report):** routing the planes as tracks (neck-downs
below the fab minimum, boxed-in pins); letting signals use the pod's In2 (the +3V3 plane fell
into pieces); laying the converter's short nets first (Freerouting then left +5V in pieces in
13 of 13 attempts); `routecheck.sh`'s earlier "routable" verdicts (it let signals use In1).

**Teaching notes:** a plane is reached by a via per pad, not by tracks; an autorouter's output
must be checked and mended, never trusted; what a DRC cannot know needs its own check.

## 2026-10-09 (later) — Toward ordering: converter fixed, fabrication files generated

**Asked:** "Are the boards production ready?" Not yet (footprints unchecked against real parts,
breakout pin orders unconfirmed, routing unreviewed, no fabrication files). Then: "go ahead" with
what can be done without the parts.

**Done:**
1. **Converter.** The switch node measured 77.6 mm with 4 vias (partly on the bottom layer) and
   the feedback 39.6 mm with 4 vias. U1 turned 270°, the converter rearranged per TI's layout:
   switch node **16.3 mm**, feedback **7.4 mm**, bootstrap 3.2 mm, all top layer, no vias.
2. **Identification** (board, REV 1, date, designer) on the bottom silkscreen (`finish.py`).
3. **Fabrication files** (`finish.sh`): gerbers + Excellon drill (zipped), BOM, positions, per-layer
   review images; origin at the board's bottom-left corner; written only if the DRC passes.
4. **Router leftovers:** dangling vias removed (KiCad's own DRC finds them). A dangling 0.01 mm
   track sliver turned out to join two tracks: removing it opened a connection, so tracks are
   never removed this way (and the export is now gated on the DRC).
5. 5V_POD given its own 0.5 A class (behind the 500 mA polyfuse).

**Verification:** pod: 0 unconnected, 0 errors, parity exact, **no warnings**; power: 0, 0, exact,
warnings only the terminal outlines at the edge (intended). `routespec.sh`: all PASS on both.

**Still before ordering (needs Ian / the parts):** 1:1 print against the real parts; J2/J3 pin
order against the bought breakouts and the IMU standoff holes; the review (LAYOUT_GUIDE E, F);
optionally teardrops; check the zips in the fab's Gerber viewer; 2 oz copper for the power board.

## 2026-10-11 — PCB buy list; module headers checked against the BOM's parts

**Buy list:** `bill-of-materials.md` §10: every part on both boards with the part each footprint was
drawn for (hand assembly, Rev 1), and §10.3: how each module connects.

**Header check (Ian: "confirm with what's in the BOM to check pin order"):**
- **Pod J2 was wrong for the Adafruit 4754** (read from Adafruit's own board file): it would have put
  ground on the breakout's 3.3 V regulator output and shifted every signal. J2 is now its JP1 row pin
  for pin (VIN, 3Vo open, GND, SCL, SDA, INT); the IMU reset moved to a new one-pin header J8 for an
  optional jumper (the firmware does not use it).
- **Pod J6 (HC-05 fallback) now gets the pod's 5 V:** the HC-05 board needs 3.6–6 V; it had 3.3 V.
- BTS7960 J13 matches the standard IBT-2 order; GNSS, ACS712 and HX711 headers vary by seller, so
  they connect by leads matched by name.
- Flagged in the buy list: D4 (blue LINK LED) barely lights from 3.3 V through 1 kΩ.

**Verification:** `check.sh` ALL PASS; ERC clean; pod rerouted (attempt 4 of 8): 0 unconnected,
0 DRC errors, parity exact, no warnings; `routespec.sh` all PASS; fabrication files regenerated.
The pod's teardrops have to be added again (the copper changed); the power board is unchanged.

## 2026-10-15 — Reviewer's fixes; the 5 V converter simulated

**Review (an engineering friend of Ian's):** "a via on a ground pad" and "more clearance from the
terminals". Measured: 9 vias touching ground pads (6 centred in them) on the power board, 2 on
the pod; 5 places within 0.3 mm of a terminal or fuse-holder pin. Fixed in the generators (no via
touches any SMD pad; 0.6 mm round terminal and fuse-holder pins, given to the router as grown pad
copies since KiCad does not export a pad's own clearance), both boards rerouted (power attempt 1,
pod attempt 5), teardrops re-added by Ian, finished. DRC 0/0, parity exact; `routespec.sh` all
PASS including the two new checks.

**Simulation (`hardware/sim/`):** TI's unencrypted TPS54360 transient model with the board's
values, run in KiCad's own ngspice from KiCad's Python (no install). Results: start-up 4.75 V at
2.3 ms, 0.9 % overshoot; load step 0.2→1.5 A: −179 mV (3.6 %), back within 1 % in 123 µs, no
ringing; 1.5→0.2 A: +129 mV, 147 µs; 9 / 12 / 14.4 / 30 V at 1 A: 5.00 V, ripple 7–35 mV,
602 kHz. All PASS. Getting ngspice going from KiCad's DLL needed: PSpice compatibility, the XSPICE
code models loaded by hand (short Windows path), `@iload[current]` saved before the run.

## 2026-10-15 (later) — Relay and magnet drivers simulated

`hardware/sim/run_relay.sh`: the pod's MCU pin through 1 k, the cable and the power board's 10 k
pull-down into the AO3400A, the coil and its SS14 flyback. No vendor SPICE model exists for the
AO3400A or SS14, so both are built from datasheet figures; the coils use typical values (relay
85 Ohm / 0.35 H, magnet 48 Ohm / 0.15 H) until the real parts are measured.
Results, all PASS: gate 2.99 V (needs >= 2.5 V; threshold <= 1.45 V); MOSFET on-voltage 3–9 mV;
turn-off spike clamped to the supply + 0.3 V (14.7 V at 14.4 V, rating 30 V); diode peak = coil
current (<= 0.31 A, rating 1 A); with the pod unplugged the gate stays at 0 V and the coil off.
Release (current to 10 %): relays 8.5–8.8 ms, magnet 6.6 ms after switch-off.

## 2026-10-16 — 12 V input protection simulated

`hardware/sim/run_input.sh`: J2 -> 3 A fuse -> SMCJ24CA -> B560C -> +12V with C20, loaded by the
converter (6 W) and the LiDAR (8 W) as constant power and all five relay coils. Against ISO 16750-2
and ISO 7637-2 for a 12 V car. All PASS: running at 12/14.4 V the rail is 11.45/13.86 V, 1.9 A
through the fuse, 0.72 W in D11; a reversed battery reaches nothing (rail 0 V, fuse untouched); a
24 V jump-start passes through (TVS idle, rail 23.4 V); pulse 1 (-150 V) is absorbed by the TVS
(0.3 J) and blocked by D11; pulse 2a (+112 V) is soaked up by C20 (rail at most 28.6 V).
**Finding:** in the suppressed load dump (35 V, 400 ms) the SMCJ24CA, which breaks down at
~27 V, tries to hold the car's whole supply down: ~100 ms at up to 141 W, 7 J, against ~152 W
allowed for that length (from the datasheet's derating, approximately): little margin, and a
longer or stiffer dump would exceed it. An SMCJ33CA (breakdown ~37 V, same SMC footprint) does not
conduct at 35 V at all; the rail then reaches 33 V, far inside the converter's 60 V.

**D10 changed to SMCJ33CA (same day, Ian's decision):** schematic, the routed board's value and
description (copper and teardrops untouched), BOM §4.1b/§9.3/§10.2, BUILD_GUIDE 4.8.4 (amended)
and decisions updated; `run_input.sh` rerun with it fitted: ALL PASS (idle through the jump-start
and the 35 V dump, rail at most 33.2 V; still absorbs pulse 1). Also fixed: the assembly-document
generator had no wiring entry for the pod's new J8 (since 2026-10-11; check.sh now passes again).
Power board: DRC 0/0, parity exact; fabrication files regenerated.

## 2026-10-16 — Tag pcb-rev1.1; the boards to be ordered assembled

Tag `pcb-rev1.1` on 7604624 (the review fixes, the SMCJ33CA, the corrected IMU header). Ordering
plan changed to fab assembly (Ian): `hardware/gen/sourcing.py` (a part number for every BOM line)
and `finish.sh` writing `<board>-jlc-bom.csv` and `<board>-jlc-cpl.csv`; checked: the two files
list the same parts (pod 74, power 78) and every designator. BOM §9 (costs: ~KES 30,000–61,000)
and §10, LAYOUT_GUIDE H1/H3 (the ordering steps: upload, match check, rotation preview,
through-hole assembly, edge rails), decisions and the to-do updated.

## 2026-10-16 — Enclosures: E-stop housing, windscreen pod, gesture puck

**Attempted:** The three printed housings still undesigned (to-do item 7), each from the bought
part's typical dimensions, marked VERIFY where the real part must be measured before printing.

**Built/changed:** `hardware/enclosures/estop/` (yellow box 56 × 56 × 59 for the 22 mm E-stop:
standard 22.3 mm hole and notch, contact blocks inside, M16 gland, base on M3 inserts, two M4 to
the dash; drilling template), `hardware/enclosures/pod/` (rear cover, front shell with the
carrier wall, black front plate with hood, cradle, rail, the glass plate's template: 79 × 52 × 75
mm; camera on a 38 × 38 placeholder), `hardware/enclosures/gesture_puck/` (34 × 21 × 10.5 mm shell
and base for the GY-9960 APDS-9960 module). README sections with parts lists and the VERIFY lists;
BUILD_GUIDE 4.8.6 amended. `make_templates.py` now ignores a model's other echo lines.

**Reasoning:** In the pod the camera and the board bolt to opposite faces of one carrier wall, so
the camera-IMU extrinsics depend on one printed part, not on a joint. The hood is splayed 4° wider
than the lens's 90° × 55° field so it stays out of the image; its bottom rows may still see the
dash, so the README says to check the first frames and pitch up a step if so. The gesture window
is left open: a clear cover reflects the APDS-9960's own IR LED into its receiver.

**Checked:** every STL exported by OpenSCAD reports a simple (manifold) solid, and an edge count
on each file finds no open or shared edges. Three faults found that way and fixed: the front plate
vanished entirely (the rounded-box helper erased a box thinner than twice its corner radius), a
lead slot's corner lay on a screw boss's axis, and the puck's screw bosses touched the end walls
along a line. Also caught on review: the rear cover had no fixing at all, the pivot insert cut
into a screw boss (pivot lowered to 60 mm), and a gesture cable exit ran through a screw boss.

**Not done:** nothing printed; dimensions of the camera, GNSS board, E-stop, gesture module and
the car's glass angle are typical values until the parts are measured.

## 2026-10-16 — Brake-light input and pod supply simulated

**Attempted:** The last two circuits without a simulation: the brake-light optocoupler input
and the pod's supply.

**Built/changed:** `hardware/sim/run_brake.sh` (`brake/brake.py`) and
`hardware/sim/run_pod_supply.sh` (`pod_supply/pod_supply.py`), with results and plots; the sim
README lists them. No SPICE model is published for the PC817 or the AP2112K: both are built from
their datasheets, and the results say so.

**Results.** Brake light, ALL PASS: with the weakest PC817 (CTR 25 %) the pin reads pressed at
0.15 V from 9 V (from 3.4 V up); with the strongest (600 %) it reads released up to 0.9 V on the
line; reversed wiring is absorbed by D21 (LED 0.67 V reverse); the pin follows the pedal within
0.2 ms. Pod supply: +3V3 holds at 3.29 V on the worst cable path (F2 at 1 Ohm, 3 m of 26 AWG,
236 mA, well inside F2's 500 mA), on USB alone at 4.40 V, on both, and when the cable is pulled
while running; back-feed into a sleeping laptop 0.2 uA. **One FAIL:** at USB attach the pod
draws 88 uC of inrush charge (C1, C2 and the decoupling: about 22 uF) against USB 2.0's 50 uC
(10 uF) limit.

**Findings for Ian (not changed on the board):**
1. USB inrush: C1 1 uF and C2 4.7 uF (value changes, same footprints; the AP2112K needs 1 uF
   each side) bring it to 28 uC, PASS; laptops usually cope with the present values.
2. R63 2.2 k dissipates 237 mW (0805: 125 mW) for the 60 s of a 24 V jump-start; 4.7 k keeps it
   at 111 mW and the weakest PC817 still reads pressed from 6 V.
3. The brake input's threshold is the LED's forward voltage (~1 V for a strong part): a
   lamp-check voltage on a dark brake-lamp line would read as pressed (the safe direction). A
   resistor across the LED on a later revision would make the threshold definite (~3 V).

## 2026-10-16 — Report: the sections that need no results drafted

**Built/changed:** `docs/report/final/` with drafts of Part 16.1's sections 2 (motivation and
scope), 3 (system architecture), 4 (software architecture, with the as-built subsystem table and
each deviation from the proposal), 5 (actuation safety, as a small safety case with a failure
table), 6 (the navigation overlay pipeline) and 11 (future work), and a README mapping all twelve
sections to their state.

**Reasoning:** Written from the guide, the decision log and the code as they stand, not from the
proposal's intentions; each claim was checked against its source (one corrected while checking:
the camera's undistortion is a CPU remap, not GPU). Every place that needs a measurement, a photo
or a decision is marked [RESULT], [FIGURE] or [CHECK], so nothing claims a test not yet run.
Citations use the proposal's keys. They are drafts for Ian to rewrite in his own voice.

**R63 4.7 kΩ and C1/C2 1 µF / 4.7 µF adopted (same day, Ian's decision):** generator values
(`power_board.py`, `pod_board.py`), `check.sh` ALL CHECKS PASS; the routed boards' values and
descriptions set in place (teardrops kept: pod 507, power 338); `finish.sh` for both boards
(0 unconnected, 0 DRC errors, parity exact; pod no warnings, power the 5 intended silk
warnings); `routespec.sh` passes; a 1 µF 1206 part added to `sourcing.py` (Samsung
CL31B105KBHNNNE). Both simulations rerun with the fitted values as the cases judged and the old
values as comparison cases: ALL PASS (R63 111 mW in the jump-start; inrush 28 µC). BOM §4 lines,
BUILD_GUIDE 4.8.4 and the report draft updated.

**Tag `pcb-rev1.2`** on a0c0c57: Rev 1.1 with R63 4.7 kΩ and the pod's C1/C2 1 µF / 4.7 µF. This
is the design to order (`pcb-rev1.1` predates the two value changes).
