kiogimwenda/AR_Windscreen/hardware/pod_board/pod_board.pdf

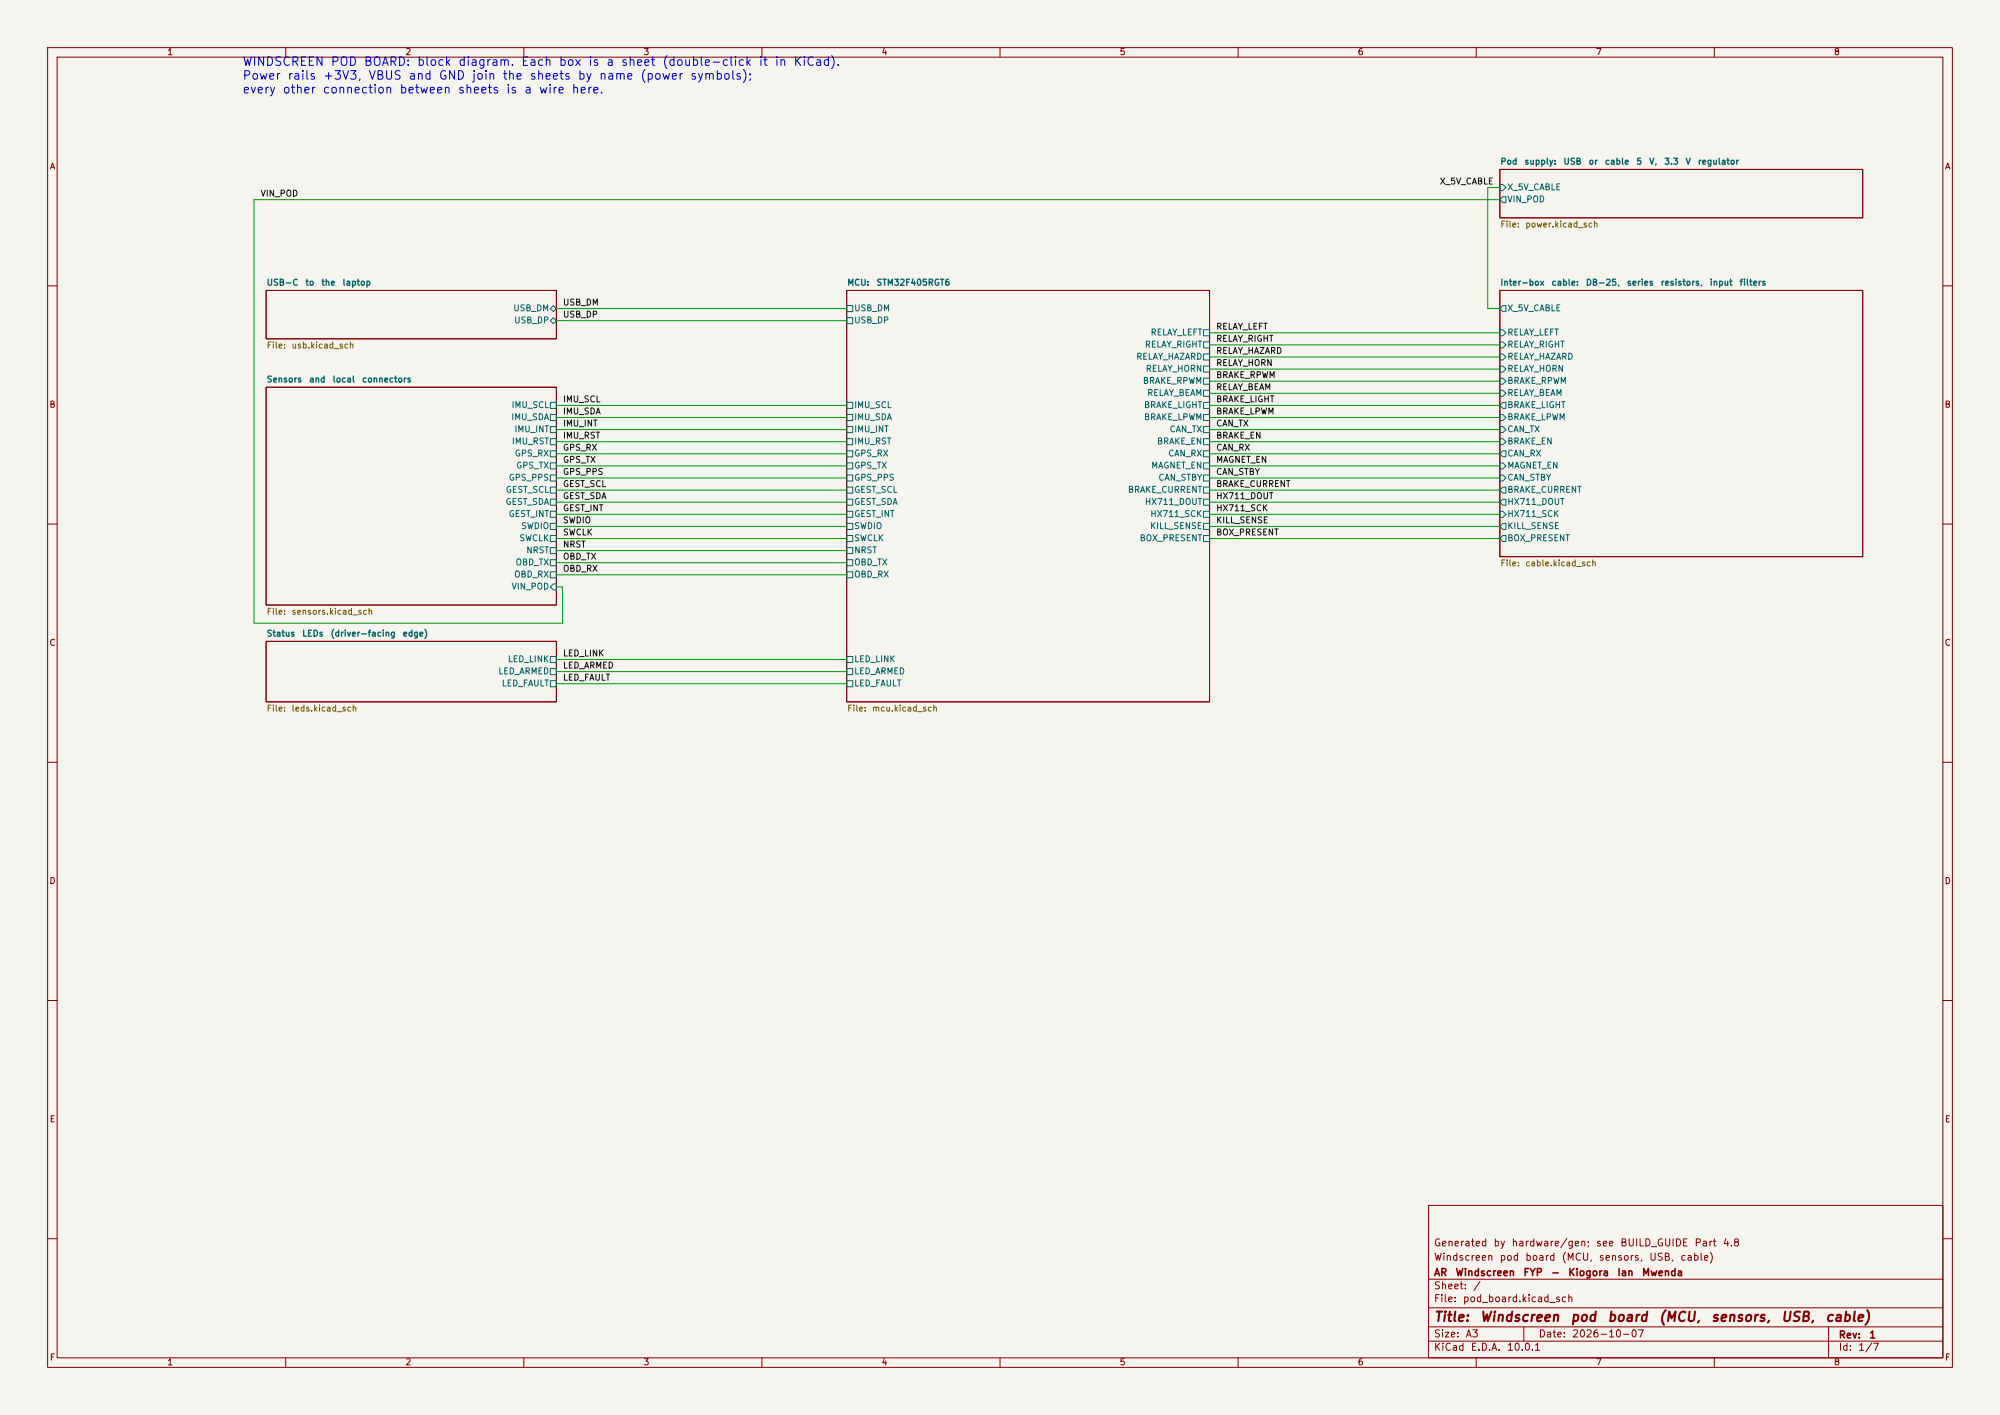
[picture p64: page 1]

RELAY_BEAM WINDSCREEN POD BOARD: block diagram. Each box is a sheet (double-click it in KiCad).
Power rails +3V3, VBUS and GND join the sheets by name (power symbols);
every other connection between sheets is a wire here.

Pod supply: USB or cable 5 V, 3.3 V regulator File: power.kicad_sch X_5V_CABLE RELAY_LEFT GPS_PPS GPS_RX GPS_TX
LED_FAULT MCU: STM32F405RGT6

Inter-box cable: DB-25, series resistors, input filters File: cable.kicad_sch X_5V_CABLE
VIN_POD

USB_DP USB-C to the laptop

LED_FAULT Status LEDs (driver-facing edge) File: leds.kicad_sch

Generated by hardware/gen; see BUILD_GUIDE Part 4.8
Windscreen pod board (MCU, sensors, USB, cable)
AR Windscreen FYP - Kiogora Ian Mwenda
Sheet: /
File: pod_board.kicad_sch
Title: Windscreen pod board (MCU, sensors, USB, cable)

Size: A3 | Rev: 1 | F Date: 2026-10-07
KiCad E.D.A. 10.0.1 | Id: 1/7

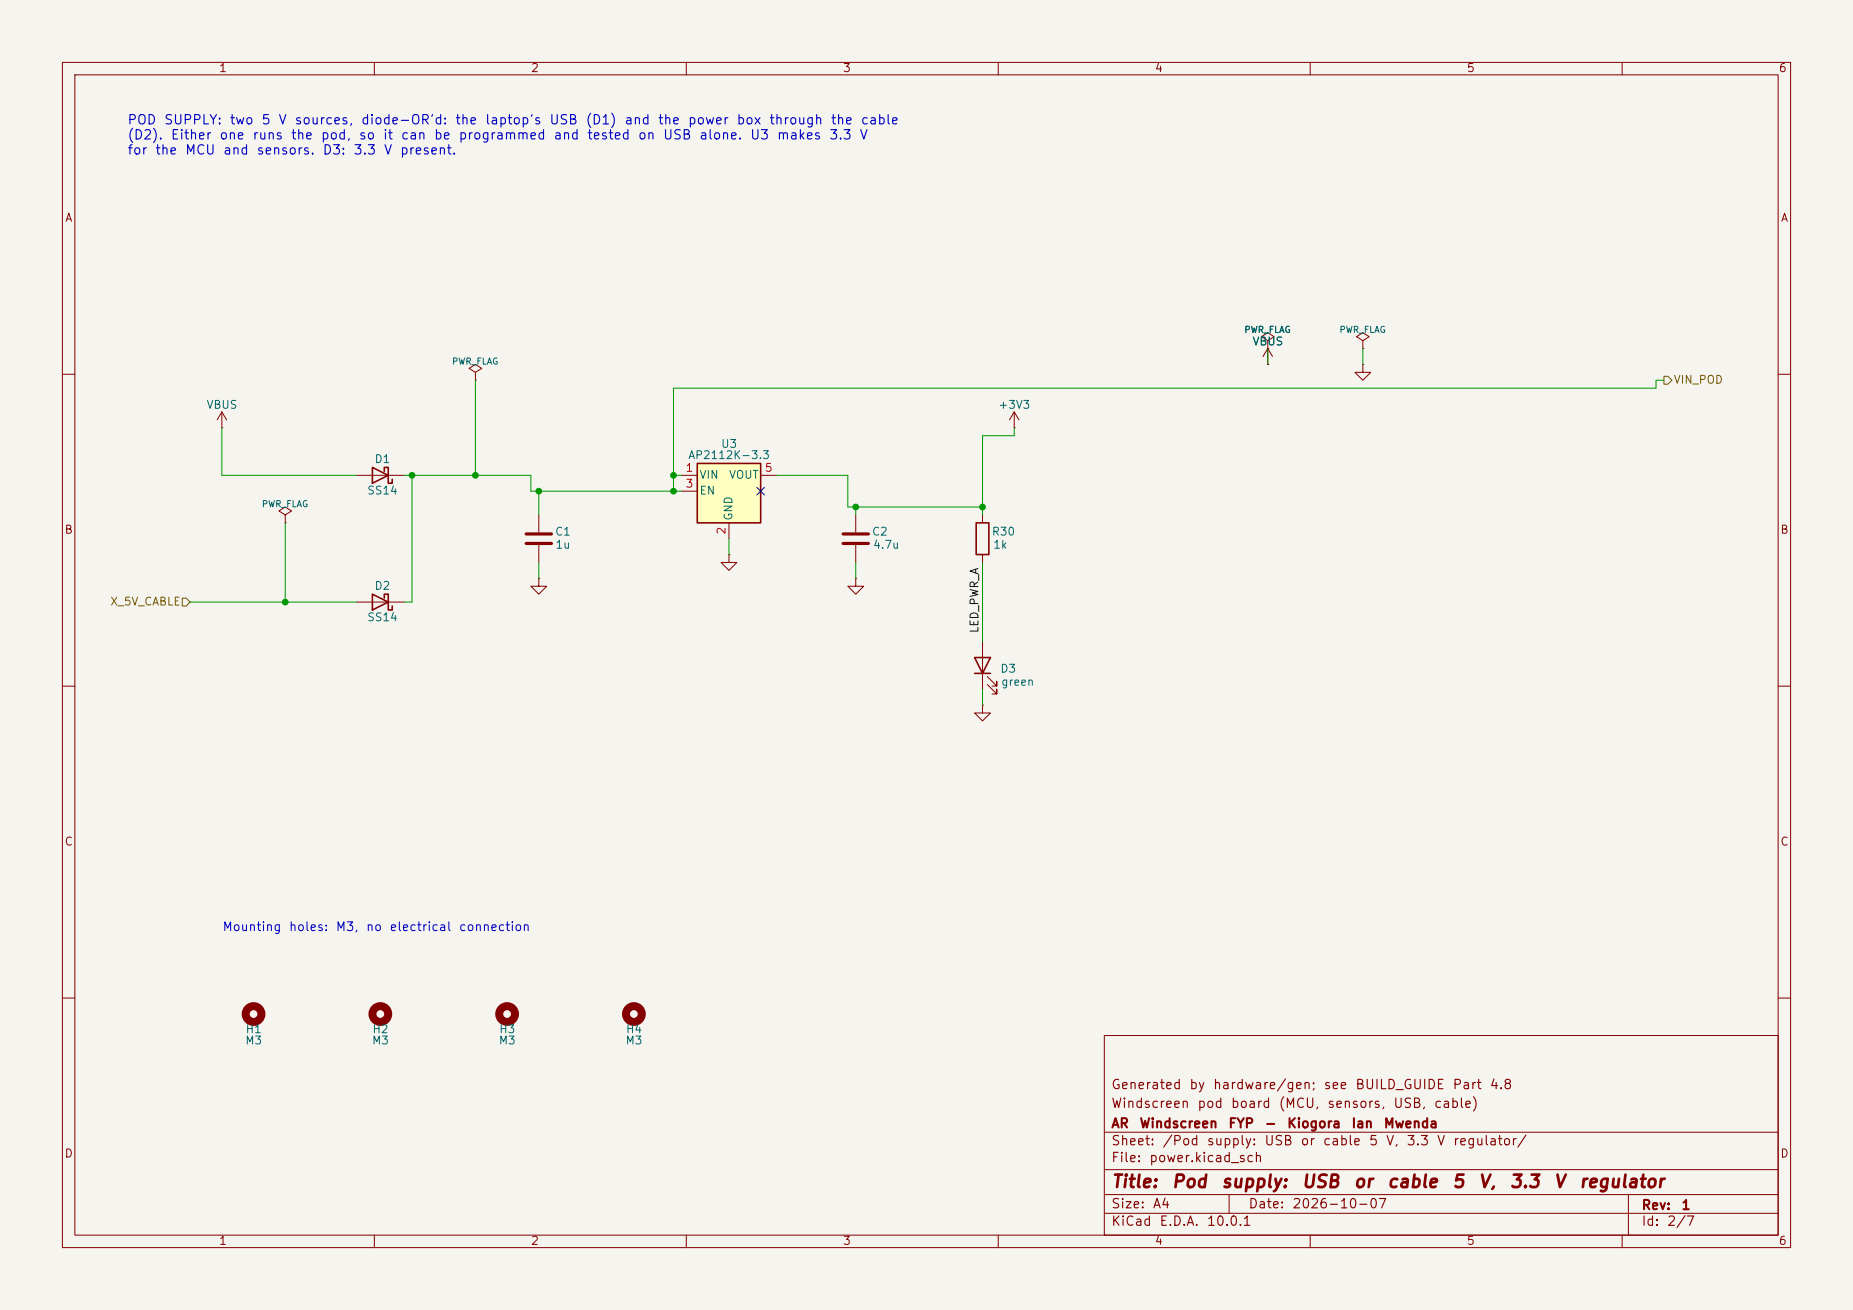
[picture p65: page 2]

POD SUPPLY: two 5 V sources, diode-OR'd: the laptop's USB (D1) and the power box through the cable
(D2). Either one runs the pod, so it can be programmed and tested on USB alone. U3 makes 3.3 V

Mounting holes: M3, no electrical connection

Generated by hardware/gen; see BUILD_GUIDE Part 4.8
Windscreen pod board (MCU, sensors, USB, cable)
AR Windscreen FYP - Kiogora Ian Mwenda
Sheet: /Pod supply: USB or cable 5 V, 3.3 V regulator/
File: power.kicad_sch
Title: Pod supply: USB or cable 5 V, 3.3 V regulator

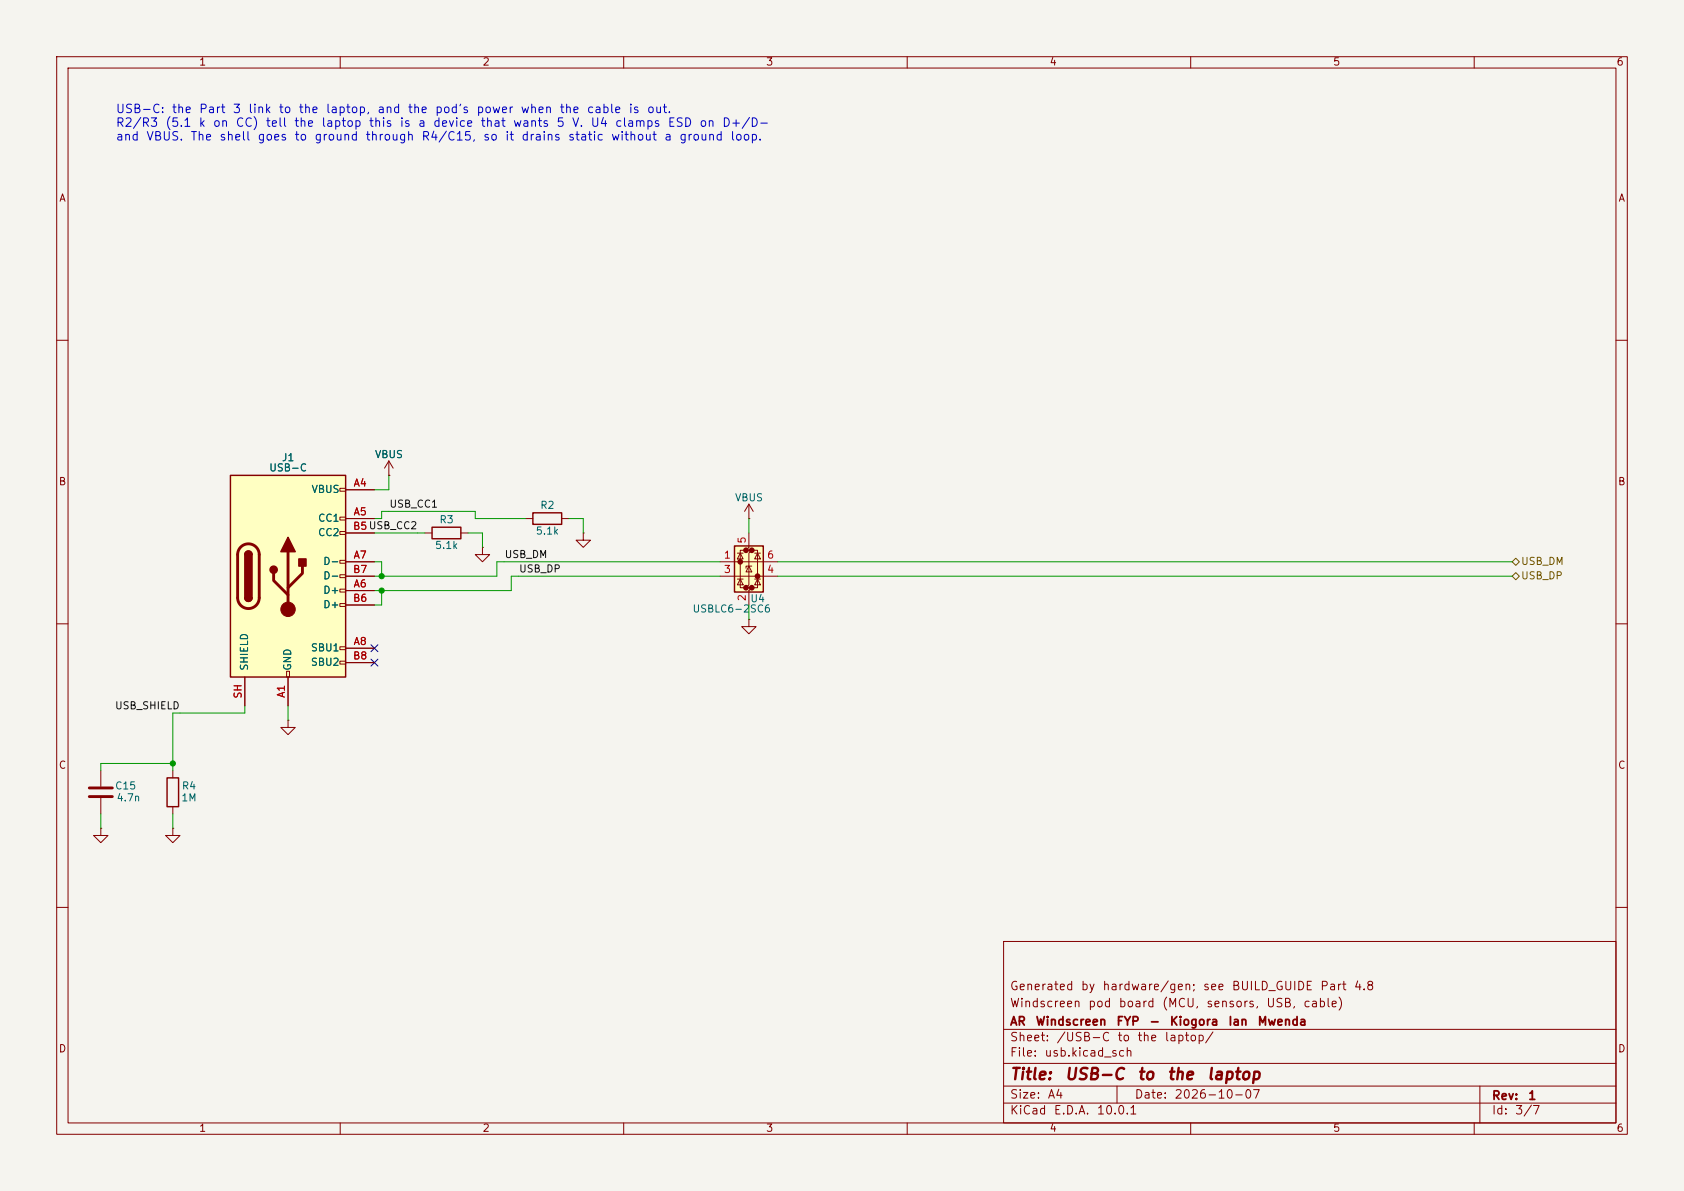
[picture p66: page 3]

R2/R3 (5.1 k on CC) tell the laptop this is a device that wants 5 V. U4 clamps ESD on D+/D-
and VBUS. The shell goes to ground through R4/C15, so it drains static without a ground loop. J1 USB-CGND A1

Generated by hardware/gen; see BUILD_GUIDE Part 4.8 GND A1

Windscreen pod board (MCU, sensors, USB, cable)
AR Windscreen FYP - Kiogora Ian Mwenda
Sheet: /USB-C to the laptop/
File: usb.kicad_sch
Title: USB-C to the laptop

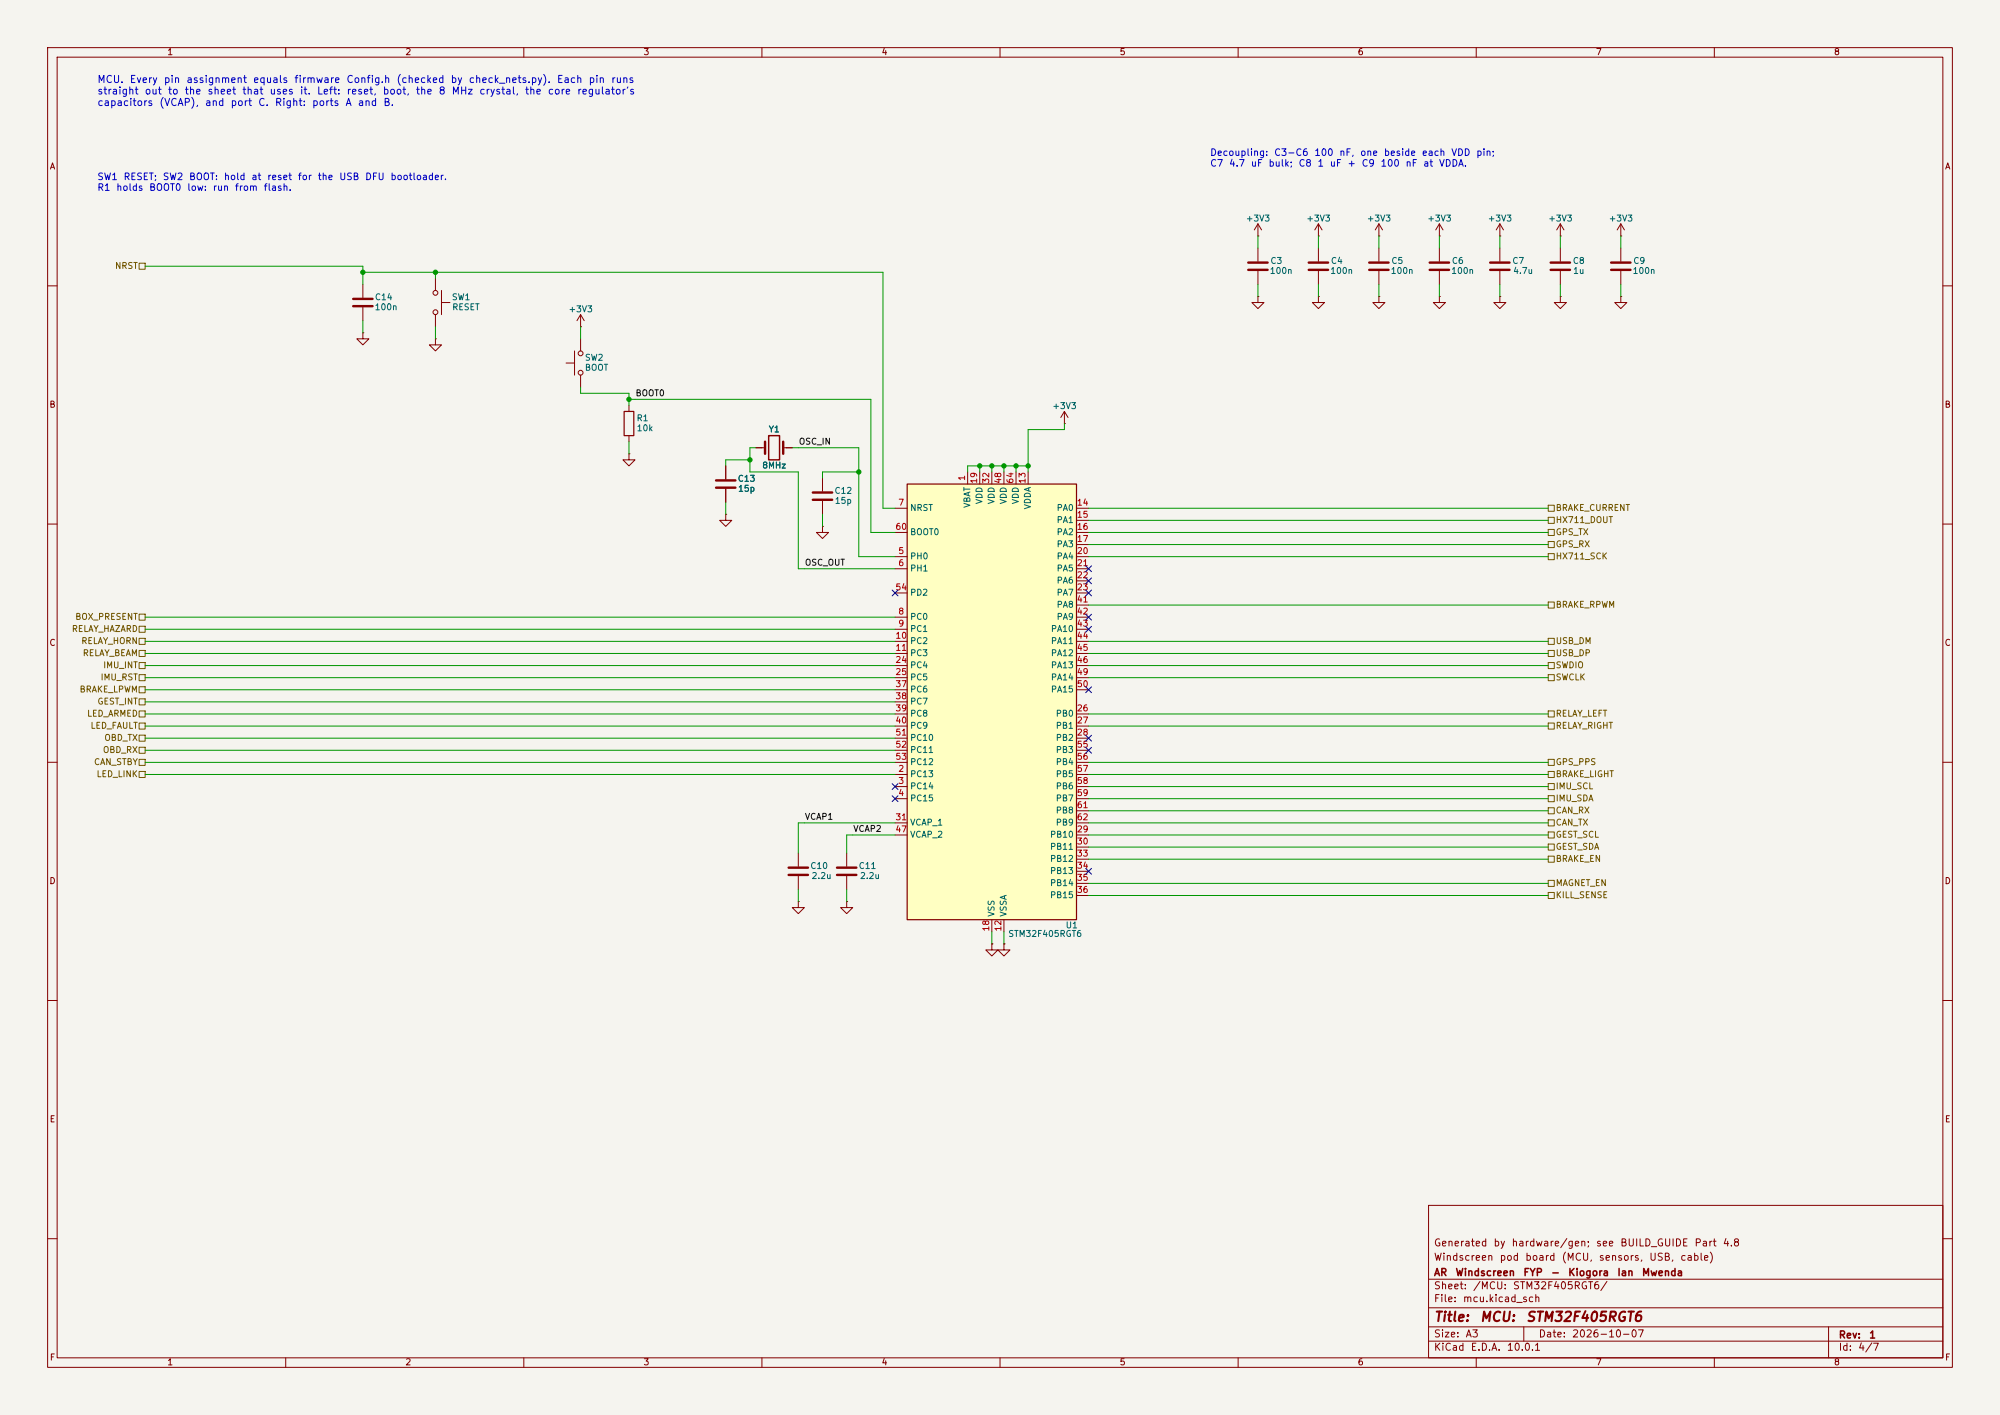
[picture p67: page 4]

MCU. Every pin assignment equals firmware Config.h (checked by check_nets.py). Each pin runs
straight out to the sheet that uses it. Left: reset, boot, the 8 MHz crystal, the core regulator's
capacitors (VCAP), and port C. Right: ports A and B.

Generated by hardware/gen; see BUILD_GUIDE Part 4.8
Windscreen pod board (MCU, sensors, USB, cable)
AR Windscreen FYP - Kiogora Ian Mwenda
Sheet: /MCU: STM32F405RGT6/
File: mcu.kicad_sch
Title: MCU: STM32F405RGT6

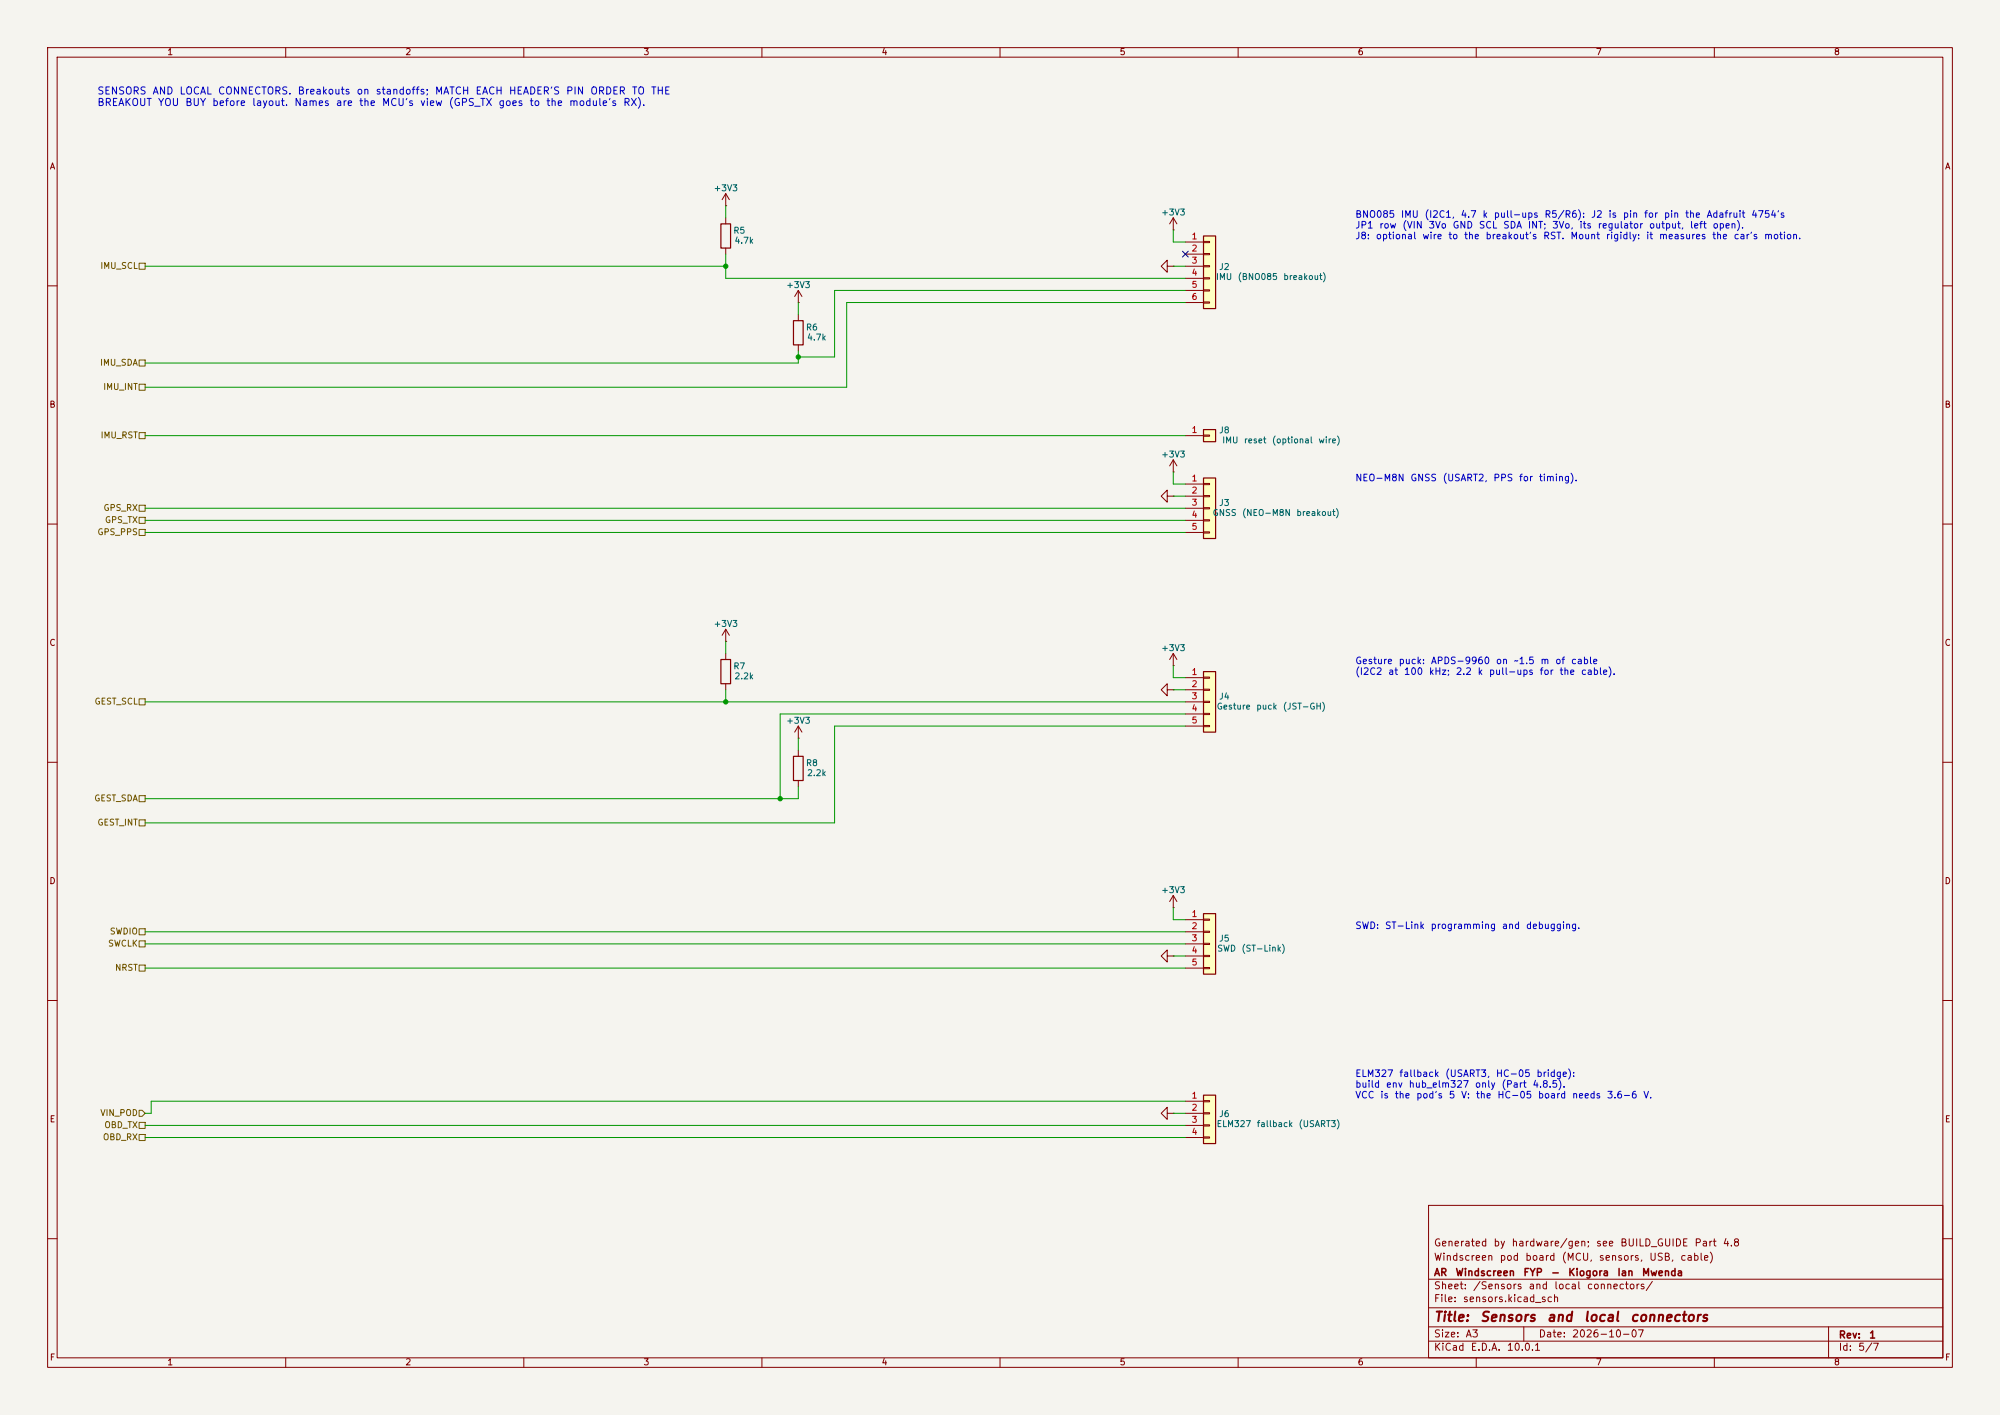
[picture p68: page 5]

JP1 row (VIN 3Vo GND SCL SDA INT; 3Vo, its regulator output, left open). J8: optional wire to the breakout's RST. Mount rigidly: it measures the car's motion. SENSORS AND LOCAL CONNECTORS. Breakouts on standoffs; MATCH EACH HEADER'S PIN ORDER TO THE
BREAKOUT YOU BUY before layout. Names are the MCU's view (GPS_TX goes to the module's RX).

IMU reset (optional wire) +3V3

(I2C2 at 100 kHz; 2.2 k pull-ups for the cable). SWD: ST-Link programming and debugging. NEO-M8N GNSS (USART2, PPS for timing). BNO085 IMU (I2C1, 4.7 k pull-ups R5/R6): J2 is pin for pin the Adafruit 4754's

ELM327 fallback (USART3, HC-05 bridge): build env hub_elm327 only (Part 4.8.5). VCC is the pod's 5 V: the HC-05 board needs 3.6-6 V.

Generated by hardware/gen; see BUILD_GUIDE Part 4.8
Windscreen pod board (MCU, sensors, USB, cable)
AR Windscreen FYP - Kiogora Ian Mwenda
Sheet: /Sensors and local connectors/
File: sensors.kicad_sch
Title: Sensors and local connectors

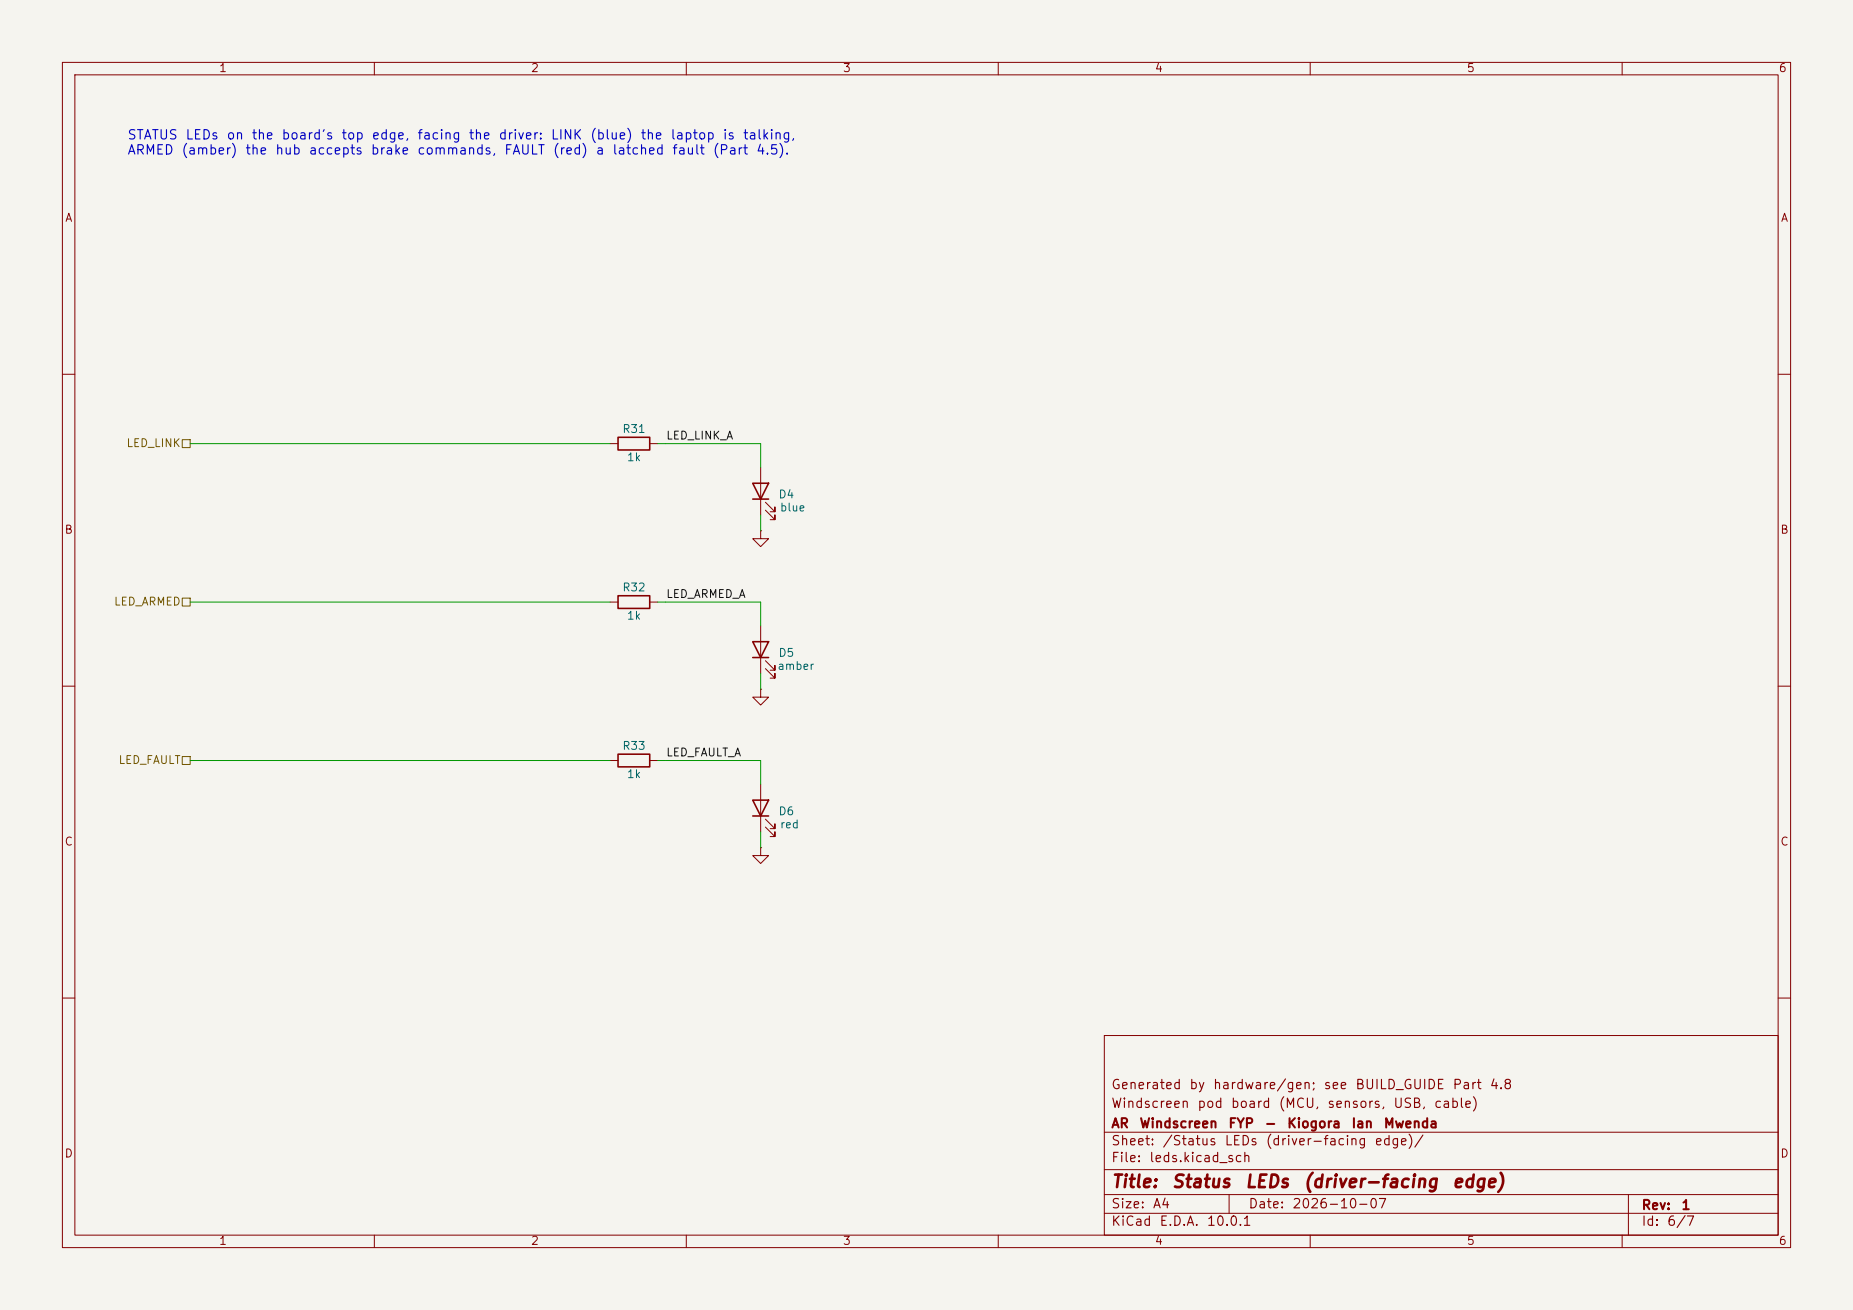
[picture p69: page 6]

LED_ARMED_A STATUS LEDs on the board's top edge, facing the driver: LINK (blue) the laptop is talking,
ARMED (amber) the hub accepts brake commands, FAULT (red) a latched fault (Part 4.5).

Generated by hardware/gen; see BUILD_GUIDE Part 4.8
Windscreen pod board (MCU, sensors, USB, cable)
AR Windscreen FYP - Kiogora Ian Mwenda
Sheet: /Status LEDs (driver-facing edge)/
File: leds.kicad_sch
Title: Status LEDs (driver-facing edge)

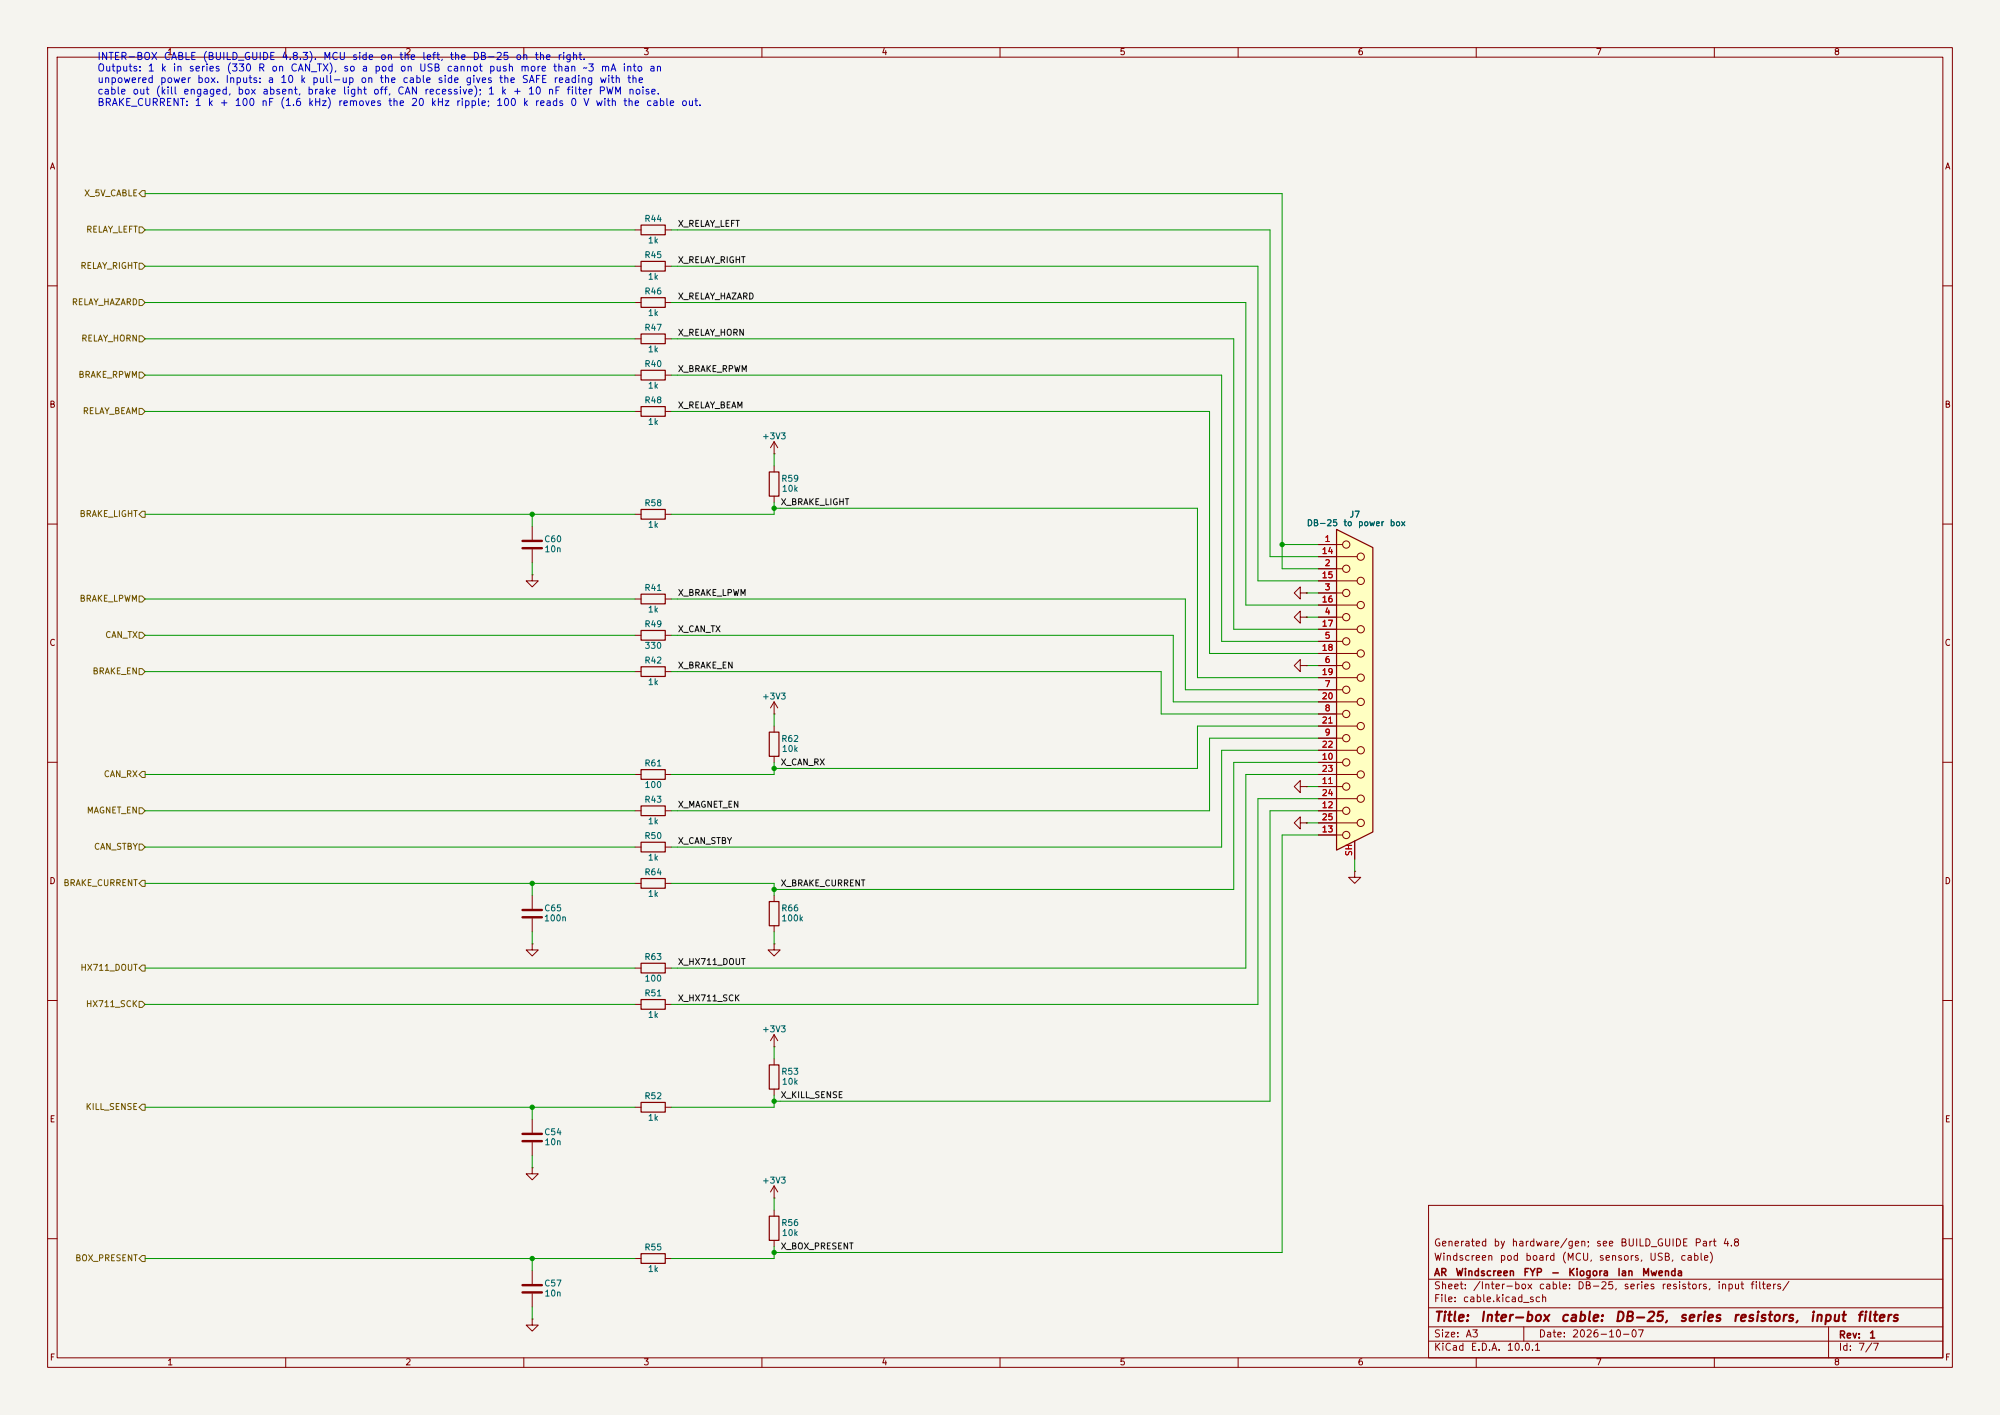
[picture p70: page 7]

INTER-BOX CABLE (BUILD_GUIDE 4.8.3). MCU side on the left, the DB-25 on the right.
Outputs: 1 k in series (330 R on CAN_TX), so a pod on USB cannot push more than ~3 mA into an
unpowered power box. Inputs: a 10 k pull-up on the cable side gives the SAFE reading with the
cable out (kill engaged, box absent, brake light off, CAN recessive); 1 k + 10 nF filter PWM noise.

BRAKE_LIGHT
J7 DB-25 to power box HX711_DOUT

Generated by hardware/gen; see BUILD_GUIDE Part 4.8
Windscreen pod board (MCU, sensors, USB, cable)
AR Windscreen FYP - Kiogora Ian Mwenda
Sheet: /Inter-box cable: DB-25, series resistors, input filters/
File: cable.kicad_sch
Title: Inter-box cable: DB-25, series resistors, input filters
