kiogimwenda/AR_Windscreen/hardware/enclosures/lidar_mount/drilling_templates.pdf

## top plate: 1:1 drilling template

100 mm: measure before drilling 3 mm aluminium, 130 × 130 mm, corners R8. Coordinates from the plate's centre. Print at 100 % (actual size). Centre-punch each red cross, pilot-drill 2.5 mm, then drill to size (a step drill for the large holes). Deburr.

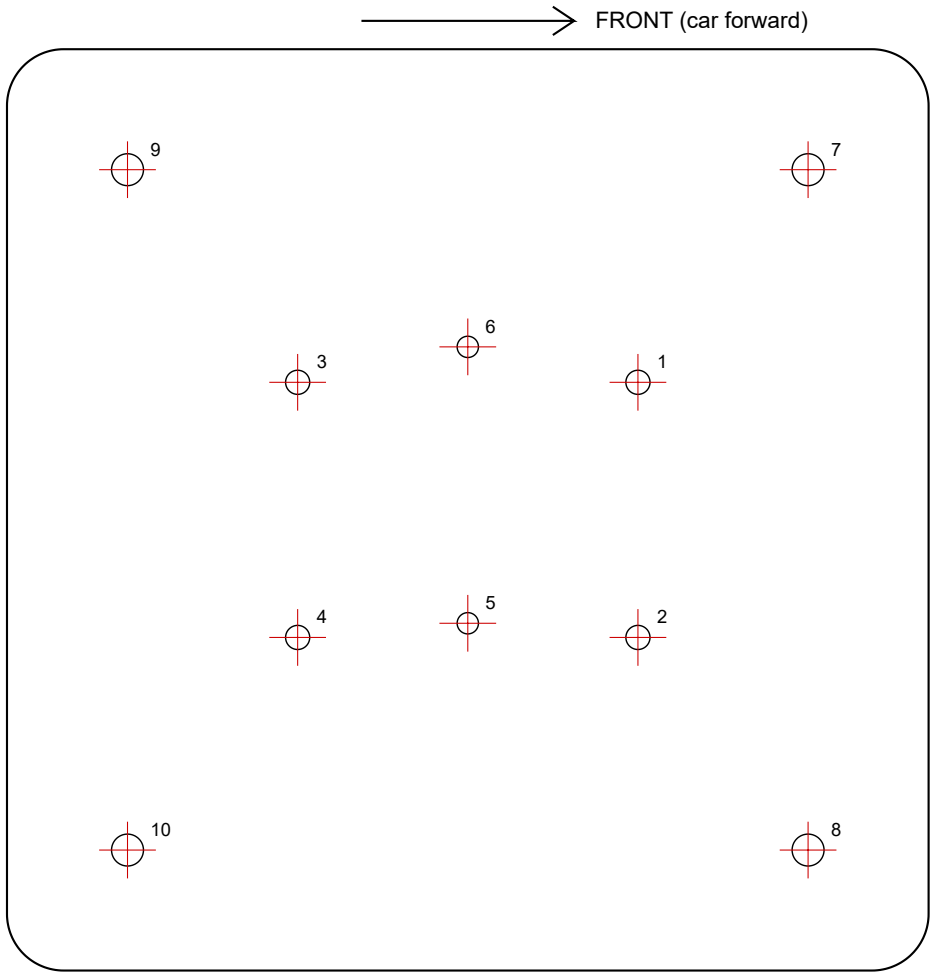
[picture p80: figure]
FRONT (car forward)

# | Size | For | (x, y) mm

1 | Ø 3.4 mm | M3 clear (LiDAR, from below) | (24.0, 18.0)
2 | Ø 3.4 mm | M3 clear (LiDAR, from below) | (24.0, -18.0)
3 | Ø 3.4 mm | M3 clear (LiDAR, from below) | (-24.0, 18.0)
4 | Ø 3.4 mm | M3 clear (LiDAR, from below) | (-24.0, -18.0)
5 | Ø 3 mm | dowel 3x5 press (check against the LiDAR first) | (0.0, -16.0)
6 | Ø 3 mm | dowel 3x5 press (check against the LiDAR first) | (0.0, 23.0)
7 | Ø 4.5 mm | M4 clear (to wedge inserts) | (48.0, 48.0)
8 | Ø 4.5 mm | M4 clear (to wedge inserts) | (48.0, -48.0)
9 | Ø 4.5 mm | M4 clear (to wedge inserts) | (-48.0, 48.0)
10 | Ø 4.5 mm | M4 clear (to wedge inserts) | (-48.0, -48.0)

## base plate: 1:1 drilling template

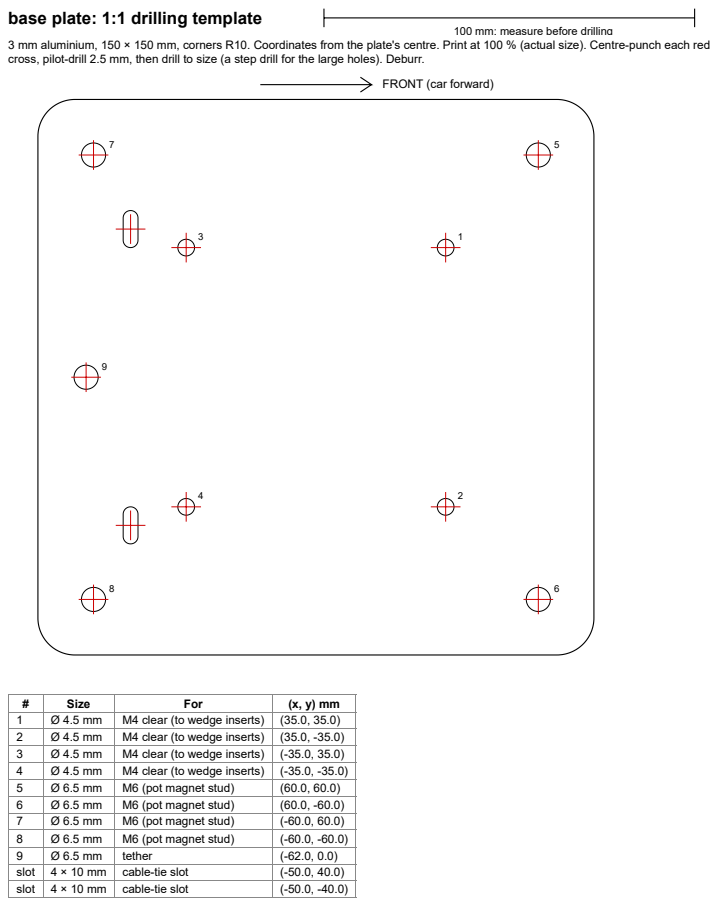
[picture p81: page 2]

100 mm: measure before drilling

3 mm aluminium, 150 × 150 mm, corners R10. Coordinates from the plate's centre. Print at 100 % (actual size). Centre-punch each red
cross, pilot-drill 2.5 mm, then drill to size (a step drill for the large holes). Deburr.

FRONT (car forward)

# | Size | For | (x, y) mm
1 | Ø 4.5 mm | M4 clear (to wedge inserts) | (35.0, 35.0)
2 | Ø 4.5 mm | M4 clear (to wedge inserts) | (35.0, -35.0)
3 | Ø 4.5 mm | M4 clear (to wedge inserts) | (-35.0, 35.0)
4 | Ø 4.5 mm | M4 clear (to wedge inserts) | (-35.0, -35.0)
5 | Ø 6.5 mm | M6 (pot magnet stud) | (60.0, 60.0)
6 | Ø 6.5 mm | M6 (pot magnet stud) | (60.0, -60.0)
7 | Ø 6.5 mm | M6 (pot magnet stud) | (-60.0, 60.0)
8 | Ø 6.5 mm | M6 (pot magnet stud) | (-60.0, -60.0)
9 | Ø 6.5 mm | tether | (-62.0, 0.0)
slot | 4 × 10 mm | cable-tie slot | (-50.0, 40.0)
slot | 4 × 10 mm | cable-tie slot | (-50.0, -40.0)
