kiogimwenda/AR_Windscreen/hardware/pod_board/pod_board.kicad_pcb

## KiCad design hardware/pod_board/pod_board.kicad_pcb (2026-10-16)

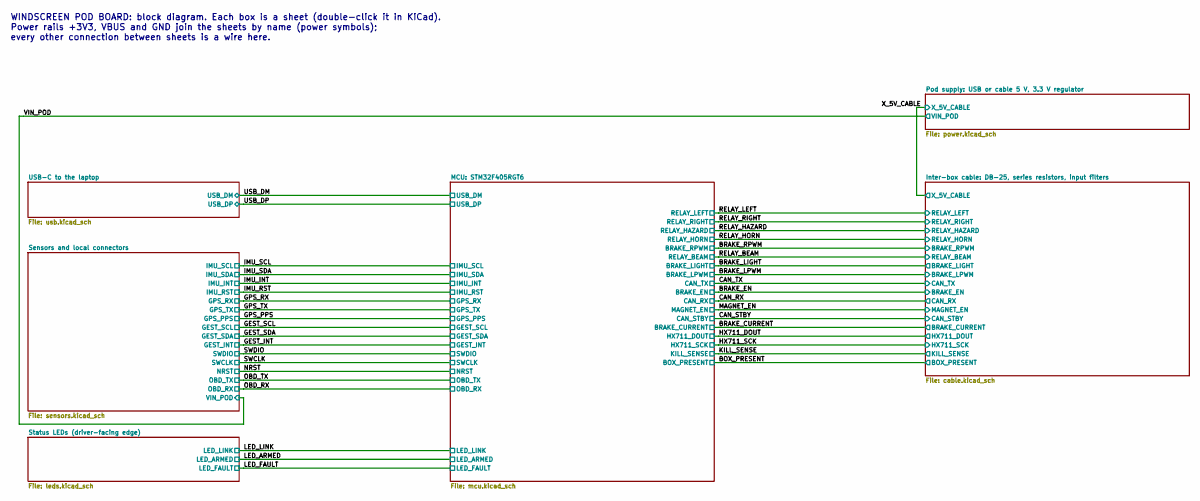
[picture p82: schematic pod_board.kicad_sch, Windscreen pod board (MCU, sensors, USB, cable)]

Notes on the sheet:
WINDSCREEN POD BOARD: block diagram. Each box is a sheet (double-click it in KiCad). Power rails +3V3, VBUS and GND join the sheets by name (power symbols); every other connection between sheets is a wire here.

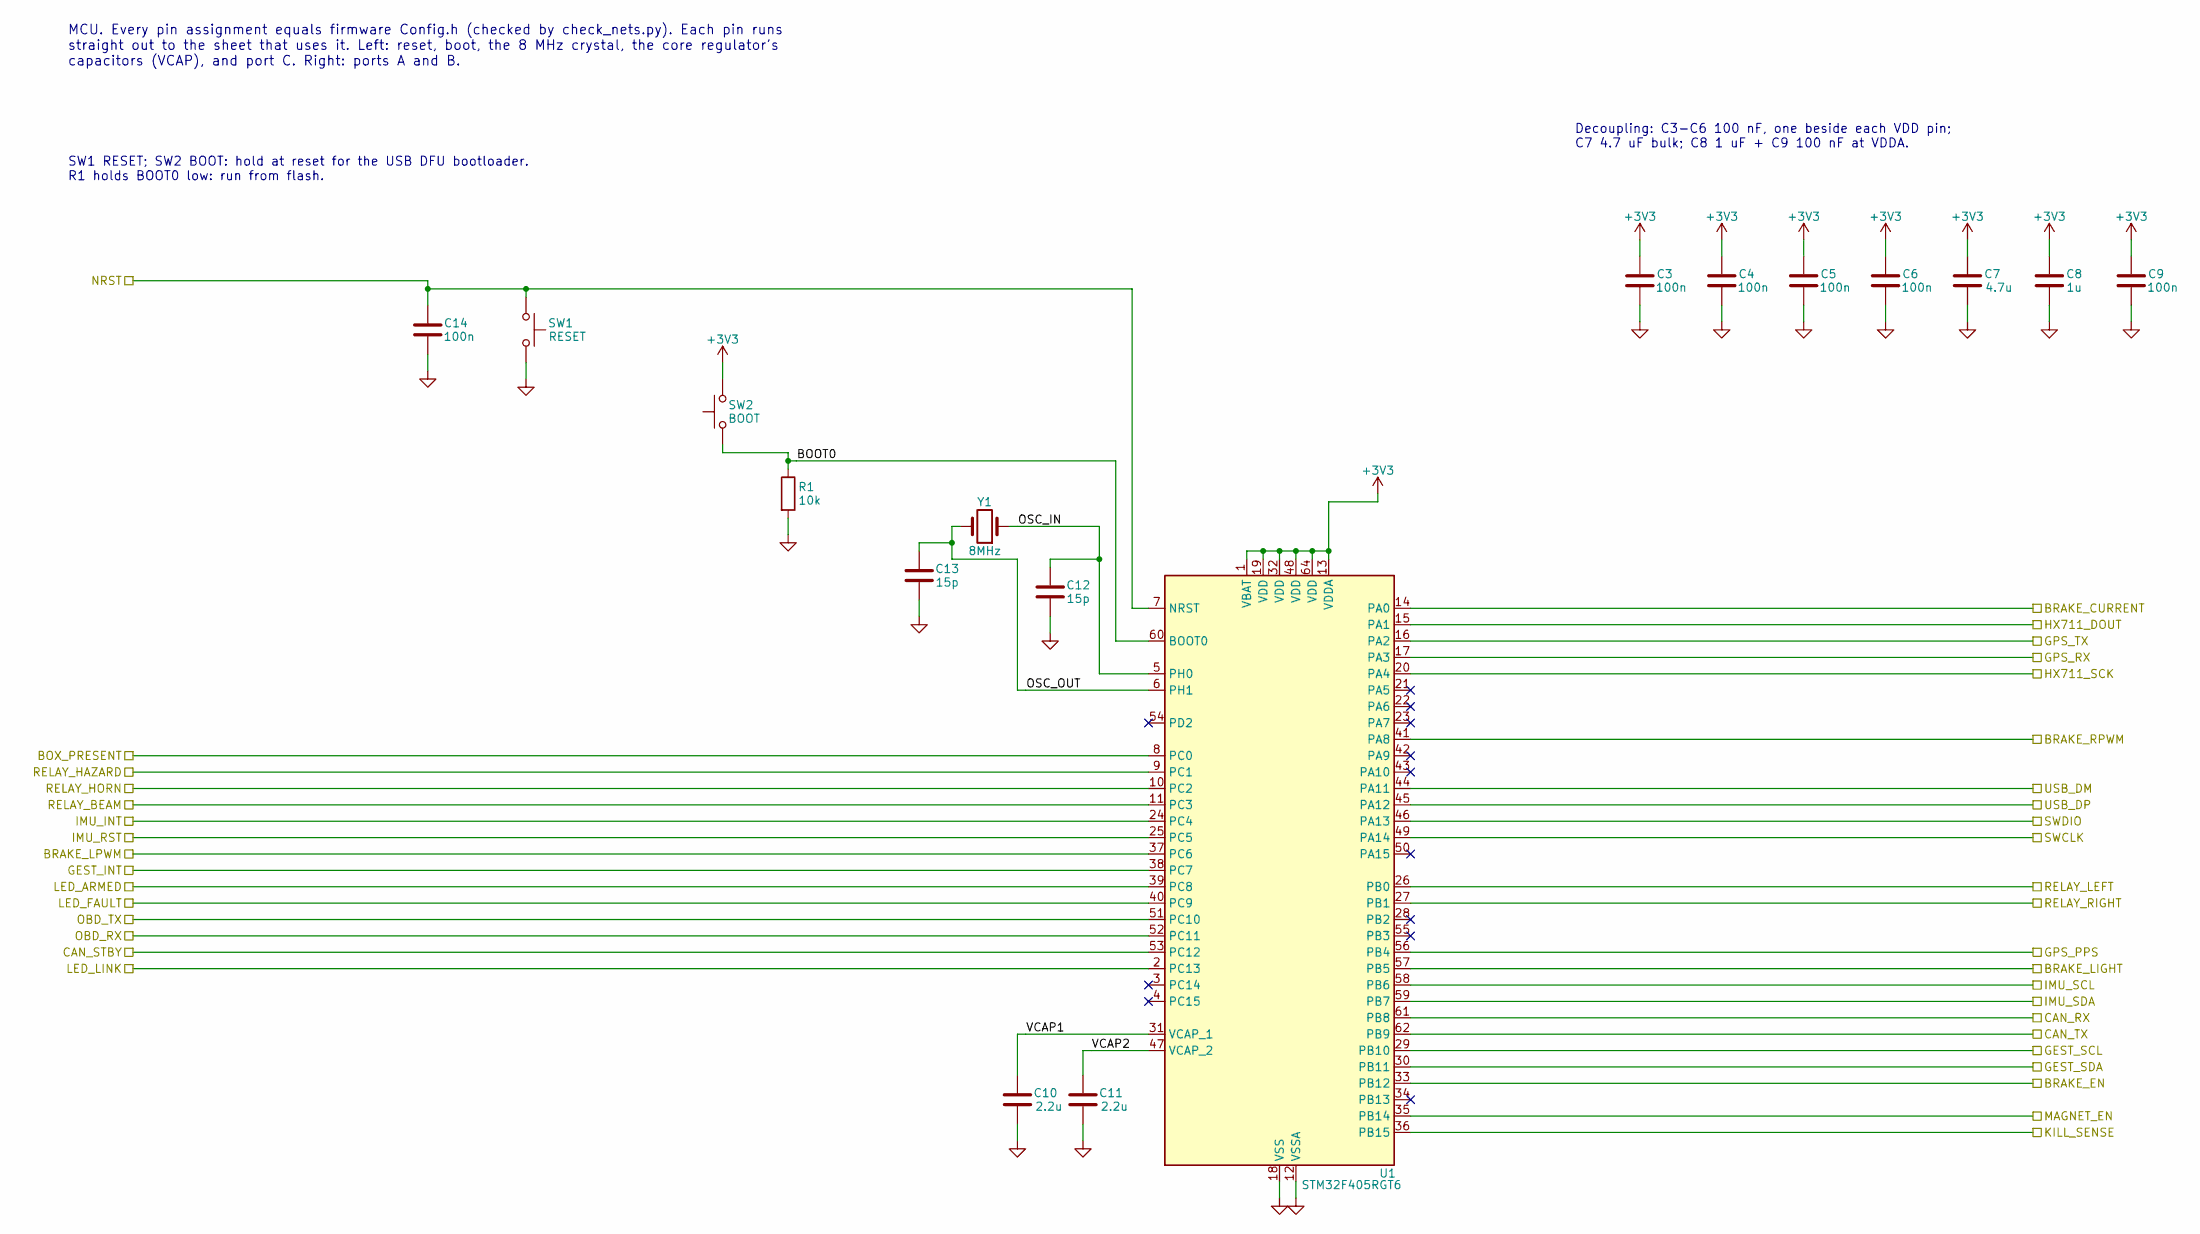
[picture p83: schematic mcu.kicad_sch, MCU: STM32F405RGT6]

Parts:
C3, C4, C5, C6, C9, C14: 100n; C_0805_2012Metric
C7: 4.7u; C_1206_3216Metric
C8: 1u; C_0805_2012Metric
C10, C11: 2.2u; C_0805_2012Metric
C12, C13: 15p; C_0805_2012Metric
R1: 10k; R_0805_2012Metric
SW1: RESET; SW_SPST_EVQP7C
SW2: BOOT; SW_SPST_EVQP7C
U1: STM32F405RGT6; LQFP-64_10x10mm_P0.5mm
Y1: 8MHz; Crystal_SMD_HC49-SD

Connections:
+3V3: C3.1, C4.1, C5.1, C6.1, C7.1, C8.1, C9.1, SW2.2, U1.1 (VBAT), U1.13 (VDDA), U1.19 (VDD), U1.32 (VDD), U1.48 (VDD), U1.64 (VDD); also elsewhere on the board
/BOX_PRESENT: U1.8 (PC0); also elsewhere on the board
/BRAKE_CURRENT: U1.14 (PA0); also elsewhere on the board
/BRAKE_EN: U1.33 (PB12); also elsewhere on the board
/BRAKE_LIGHT: U1.57 (PB5); also elsewhere on the board
/BRAKE_LPWM: U1.37 (PC6); also elsewhere on the board
/BRAKE_RPWM: U1.41 (PA8); also elsewhere on the board
/CAN_RX: U1.61 (PB8); also elsewhere on the board
/CAN_STBY: U1.53 (PC12); also elsewhere on the board
/CAN_TX: U1.62 (PB9); also elsewhere on the board
/GEST_INT: U1.38 (PC7); also elsewhere on the board
/GEST_SCL: U1.29 (PB10); also elsewhere on the board
/GEST_SDA: U1.30 (PB11); also elsewhere on the board
/GPS_PPS: U1.56 (PB4); also elsewhere on the board
/GPS_RX: U1.17 (PA3); also elsewhere on the board
/GPS_TX: U1.16 (PA2); also elsewhere on the board
/HX711_DOUT: U1.15 (PA1); also elsewhere on the board
/HX711_SCK: U1.20 (PA4); also elsewhere on the board
/IMU_INT: U1.24 (PC4); also elsewhere on the board
/IMU_RST: U1.25 (PC5); also elsewhere on the board
/IMU_SCL: U1.58 (PB6); also elsewhere on the board
/IMU_SDA: U1.59 (PB7); also elsewhere on the board
/KILL_SENSE: U1.36 (PB15); also elsewhere on the board
/LED_ARMED: U1.39 (PC8); also elsewhere on the board
/LED_FAULT: U1.40 (PC9); also elsewhere on the board
/LED_LINK: U1.2 (PC13); also elsewhere on the board
/MAGNET_EN: U1.35 (PB14); also elsewhere on the board
/MCU: STM32F405RGT6/BOOT0: R1.1, SW2.1, U1.60 (BOOT0)
/MCU: STM32F405RGT6/OSC_IN: C12.1, U1.5 (PH0), Y1.1
/MCU: STM32F405RGT6/OSC_OUT: C13.1, U1.6 (PH1), Y1.2
/MCU: STM32F405RGT6/VCAP1: C10.1, U1.31 (VCAP_1)
/MCU: STM32F405RGT6/VCAP2: C11.1, U1.47 (VCAP_2)
/NRST: C14.1, SW1.1, U1.7 (NRST); also elsewhere on the board
/OBD_RX: U1.52 (PC11); also elsewhere on the board
/OBD_TX: U1.51 (PC10); also elsewhere on the board
/RELAY_BEAM: U1.11 (PC3); also elsewhere on the board
/RELAY_HAZARD: U1.9 (PC1); also elsewhere on the board
/RELAY_HORN: U1.10 (PC2); also elsewhere on the board
/RELAY_LEFT: U1.26 (PB0); also elsewhere on the board
/RELAY_RIGHT: U1.27 (PB1); also elsewhere on the board
/SWCLK: U1.49 (PA14); also elsewhere on the board
/SWDIO: U1.46 (PA13); also elsewhere on the board
/USB_DM: U1.44 (PA11); also elsewhere on the board
/USB_DP: U1.45 (PA12); also elsewhere on the board
GND: C3.2, C4.2, C5.2, C6.2, C7.2, C8.2, C9.2, C10.2, C11.2, C12.2, C13.2, C14.2, R1.2, SW1.2, U1.12 (VSSA), U1.18 (VSS), U1.63 (VSS); also elsewhere on the board

Notes on the sheet:
MCU. Every pin assignment equals firmware Config.h (checked by check_nets.py). Each pin runs straight out to the sheet that uses it. Left: reset, boot, the 8 MHz crystal, the core regulator's capacitors (VCAP), and port C. Right: ports A and B.
Decoupling: C3-C6 100 nF, one beside each VDD pin; C7 4.7 uF bulk; C8 1 uF + C9 100 nF at VDDA.
SW1 RESET; SW2 BOOT: hold at reset for the USB DFU bootloader. R1 holds BOOT0 low: run from flash.

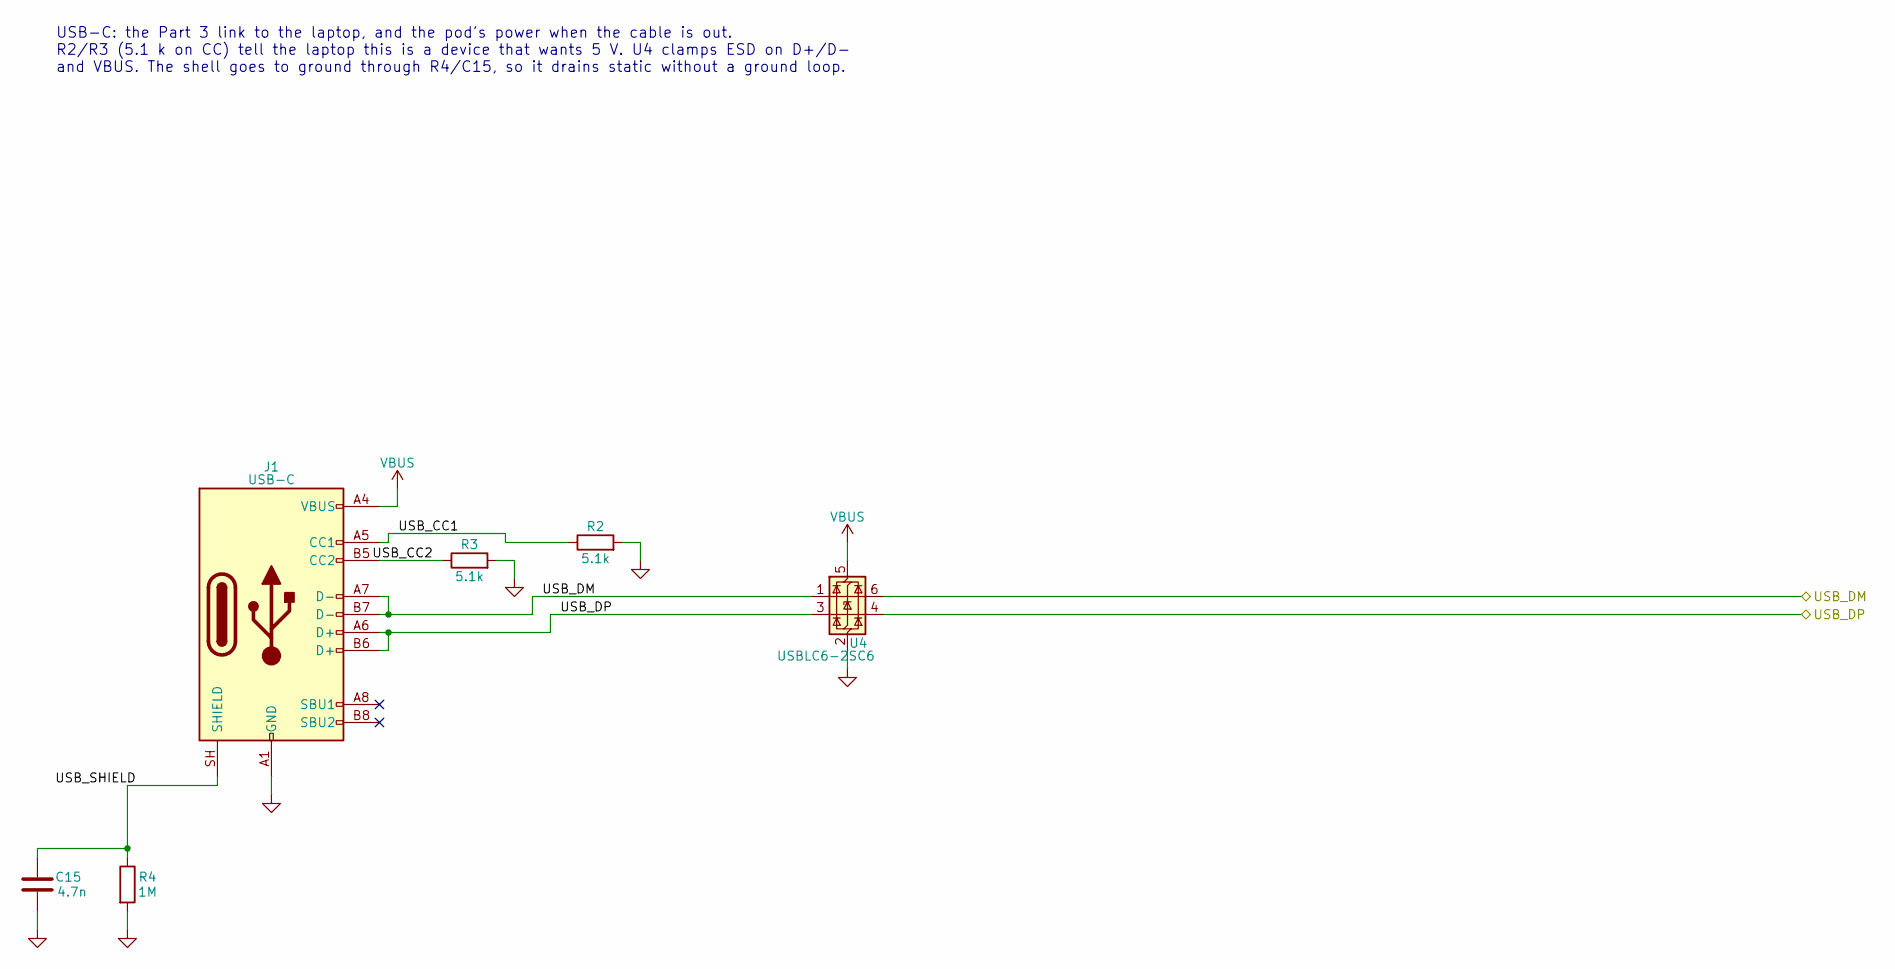
[picture p84: schematic usb.kicad_sch, USB-C to the laptop]

Parts:
C15: 4.7n; C_0805_2012Metric
J1: USB-C; USB_C_Receptacle_GCT_USB4105-xx-A_16P_TopMnt_Horizontal
R2, R3: 5.1k; R_0805_2012Metric
R4: 1M; R_0805_2012Metric
U4: USBLC6-2SC6; SOT-23-6

Connections:
/USB-C to the laptop/USB_CC1: J1.A5 (CC1), R2.1
/USB-C to the laptop/USB_CC2: J1.B5 (CC2), R3.1
/USB-C to the laptop/USB_SHIELD: C15.1, J1.SH (SHIELD), R4.1
/USB_DM: J1.A7 (D-), J1.B7 (D-), U4.1 (I/O1), U4.6 (I/O1); also elsewhere on the board
/USB_DP: J1.A6 (D+), J1.B6 (D+), U4.3 (I/O2), U4.4 (I/O2); also elsewhere on the board
GND: C15.2, J1.A1 (GND), J1.A12 (GND), J1.B1 (GND), J1.B12 (GND), R2.2, R3.2, R4.2, U4.2 (GND); also elsewhere on the board
VBUS: J1.A4 (VBUS), J1.A9 (VBUS), J1.B4 (VBUS), J1.B9 (VBUS), U4.5 (VBUS); also elsewhere on the board

Notes on the sheet:
USB-C: the Part 3 link to the laptop, and the pod's power when the cable is out. R2/R3 (5.1 k on CC) tell the laptop this is a device that wants 5 V. U4 clamps ESD on D+/D- and VBUS. The shell goes to ground through R4/C15, so it drains static without a ground loop.

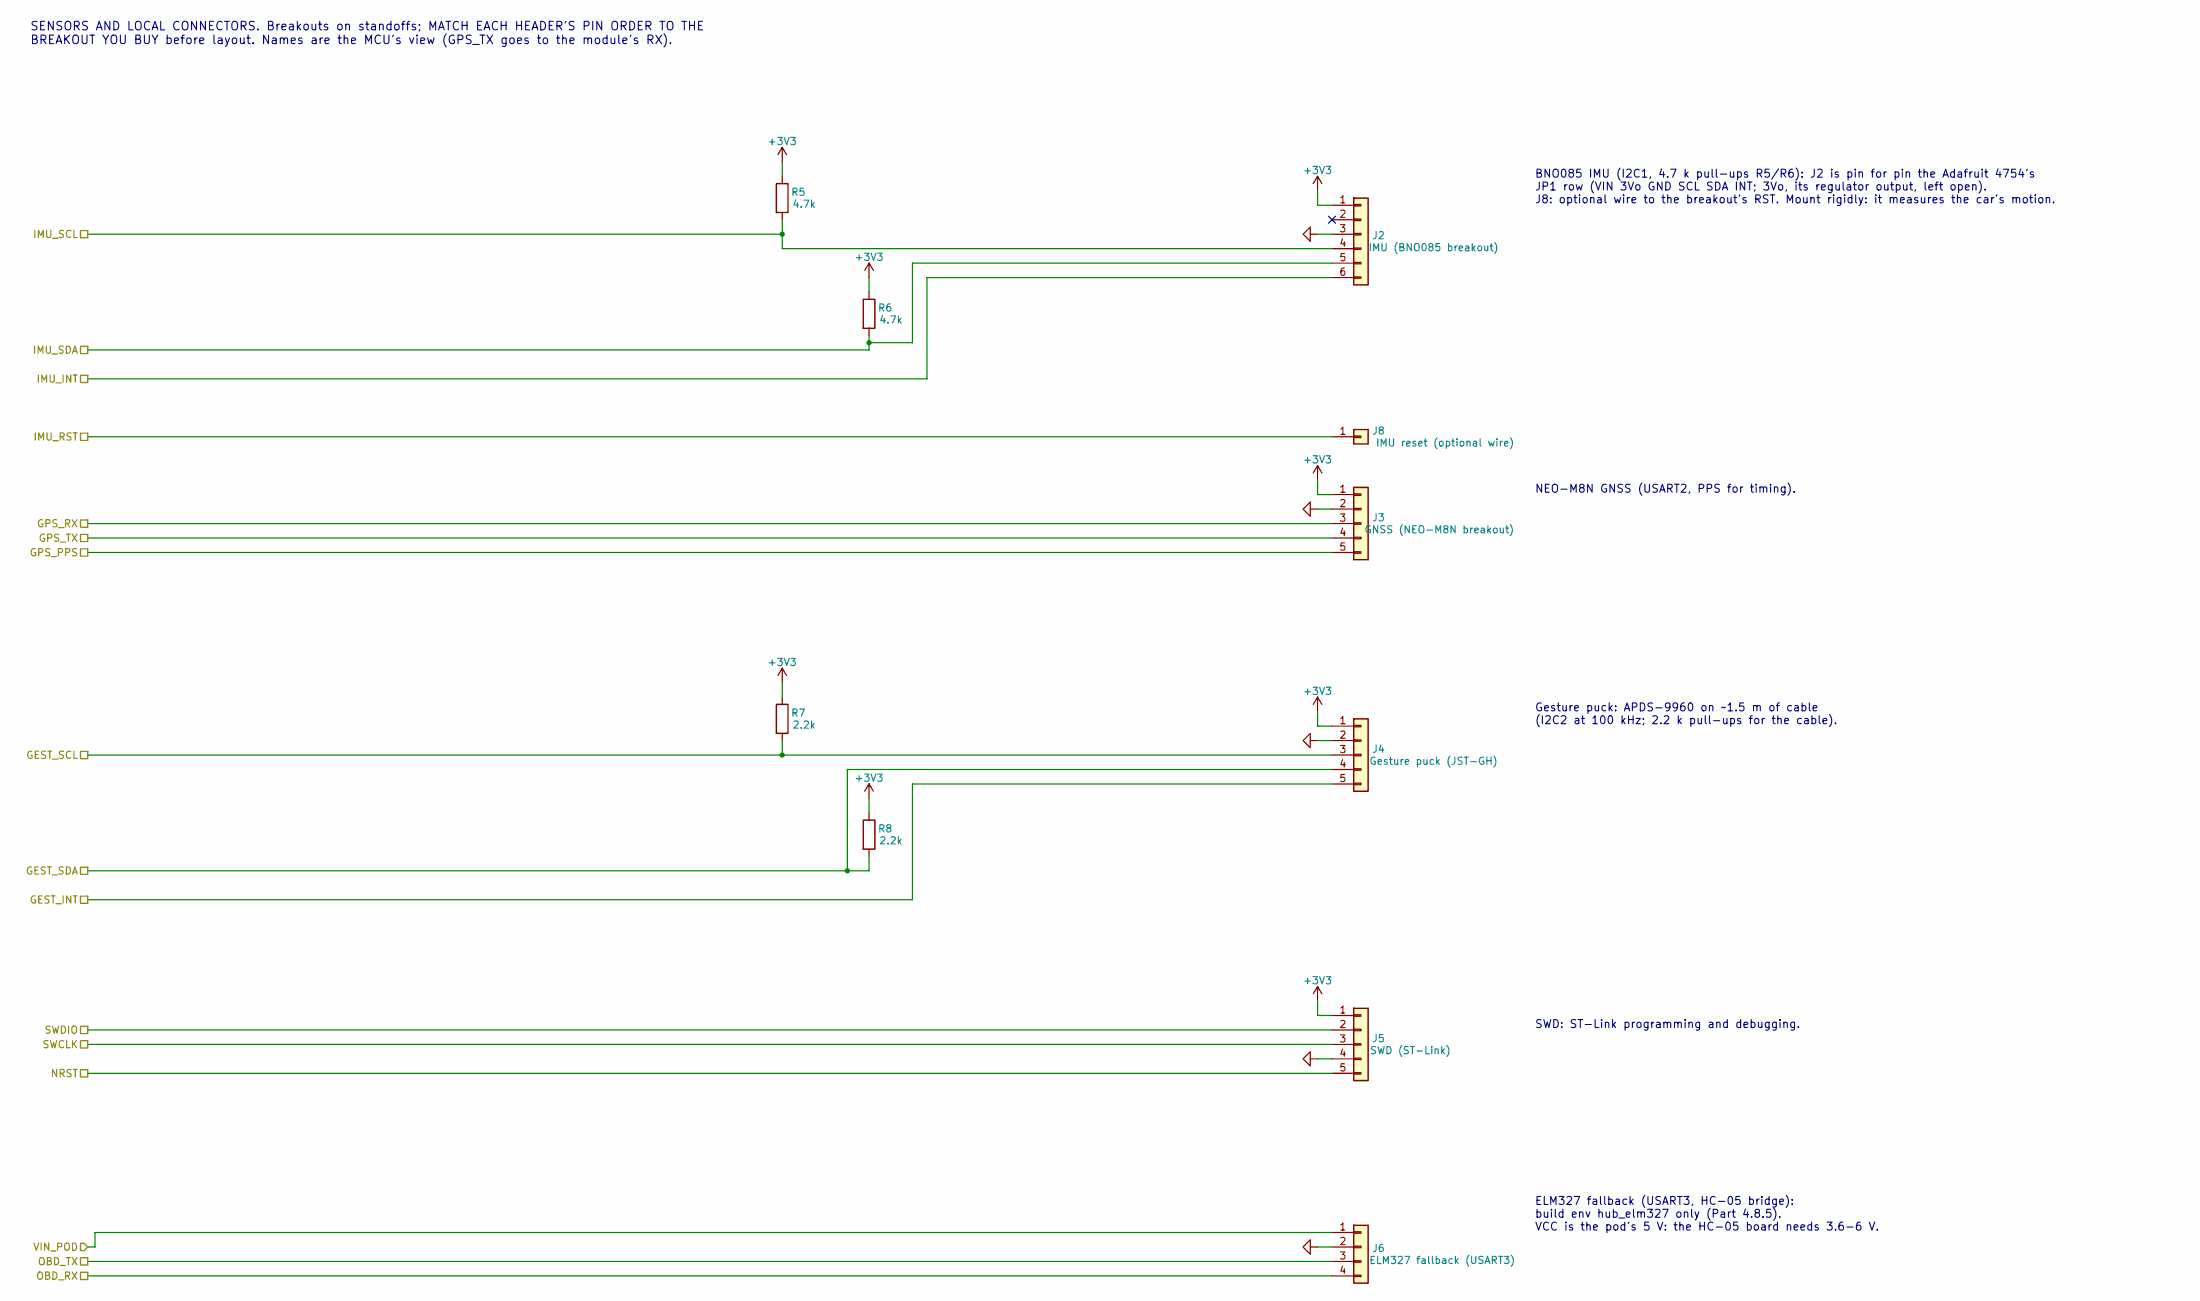
[picture p85: schematic sensors.kicad_sch, Sensors and local connectors]

Parts:
J2: IMU (BNO085 breakout); PinHeader_1x06_P2.54mm_Vertical
J3: GNSS (NEO-M8N breakout); PinHeader_1x05_P2.54mm_Vertical
J4: Gesture puck (JST-GH); JST_GH_SM05B-GHS-TB_1x05-1MP_P1.25mm_Horizontal
J5: SWD (ST-Link); PinHeader_1x05_P2.54mm_Vertical
J6: ELM327 fallback (USART3); PinHeader_1x04_P2.54mm_Vertical
J8: IMU reset (optional wire); PinHeader_1x01_P2.54mm_Vertical
R5, R6: 4.7k; R_0805_2012Metric
R7, R8: 2.2k; R_0805_2012Metric

Connections:
+3V3: J2.1, J3.1, J4.1, J5.1, R5.1, R6.1, R7.1, R8.1; also elsewhere on the board
/GEST_INT: J4.5; also elsewhere on the board
/GEST_SCL: J4.3, R7.2; also elsewhere on the board
/GEST_SDA: J4.4, R8.2; also elsewhere on the board
/GPS_PPS: J3.5; also elsewhere on the board
/GPS_RX: J3.3; also elsewhere on the board
/GPS_TX: J3.4; also elsewhere on the board
/IMU_INT: J2.6; also elsewhere on the board
/IMU_RST: J8.1; also elsewhere on the board
/IMU_SCL: J2.4, R5.2; also elsewhere on the board
/IMU_SDA: J2.5, R6.2; also elsewhere on the board
/NRST: J5.5; also elsewhere on the board
/OBD_RX: J6.4; also elsewhere on the board
/OBD_TX: J6.3; also elsewhere on the board
/SWCLK: J5.3; also elsewhere on the board
/SWDIO: J5.2; also elsewhere on the board
/VIN_POD: J6.1; also elsewhere on the board
GND: J2.3, J3.2, J4.2, J5.4, J6.2; also elsewhere on the board

Notes on the sheet:
SENSORS AND LOCAL CONNECTORS. Breakouts on standoffs; MATCH EACH HEADER'S PIN ORDER TO THE BREAKOUT YOU BUY before layout. Names are the MCU's view (GPS_TX goes to the module's RX).
BNO085 IMU (I2C1, 4.7 k pull-ups R5/R6): J2 is pin for pin the Adafruit 4754's JP1 row (VIN 3Vo GND SCL SDA INT; 3Vo, its regulator output, left open). J8: optional wire to the breakout's RST. Mount rigidly: it measures the car's motion.
NEO-M8N GNSS (USART2, PPS for timing).
Gesture puck: APDS-9960 on ~1.5 m of cable (I2C2 at 100 kHz; 2.2 k pull-ups for the cable).
SWD: ST-Link programming and debugging.
ELM327 fallback (USART3, HC-05 bridge): build env hub_elm327 only (Part 4.8.5). VCC is the pod's 5 V: the HC-05 board needs 3.6-6 V.

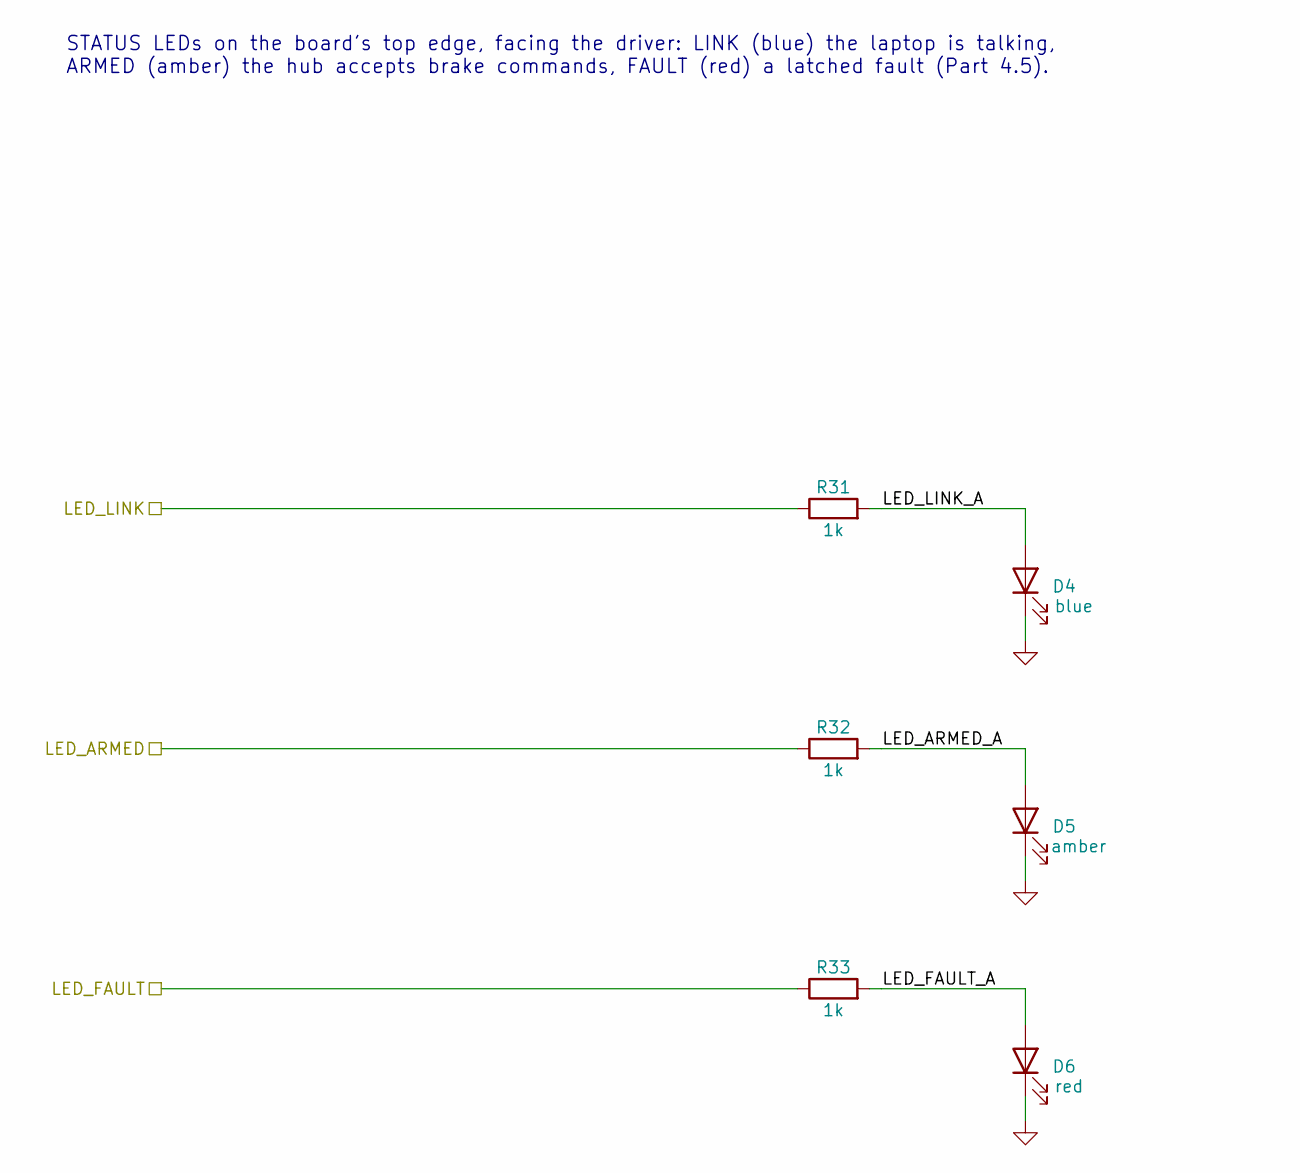
[picture p86: schematic leds.kicad_sch, Status LEDs (driver-facing edge)]

Parts:
D4: blue; LED_0805_2012Metric
D5: amber; LED_0805_2012Metric
D6: red; LED_0805_2012Metric
R31, R32, R33: 1k; R_0805_2012Metric

Connections:
/LED_ARMED: R32.1; also elsewhere on the board
/LED_FAULT: R33.1; also elsewhere on the board
/LED_LINK: R31.1; also elsewhere on the board
/Status LEDs (driver-facing edge)/LED_ARMED_A: D5.2 (A), R32.2
/Status LEDs (driver-facing edge)/LED_FAULT_A: D6.2 (A), R33.2
/Status LEDs (driver-facing edge)/LED_LINK_A: D4.2 (A), R31.2
GND: D4.1 (K), D5.1 (K), D6.1 (K); also elsewhere on the board

Notes on the sheet:
STATUS LEDs on the board's top edge, facing the driver: LINK (blue) the laptop is talking, ARMED (amber) the hub accepts brake commands, FAULT (red) a latched fault (Part 4.5).

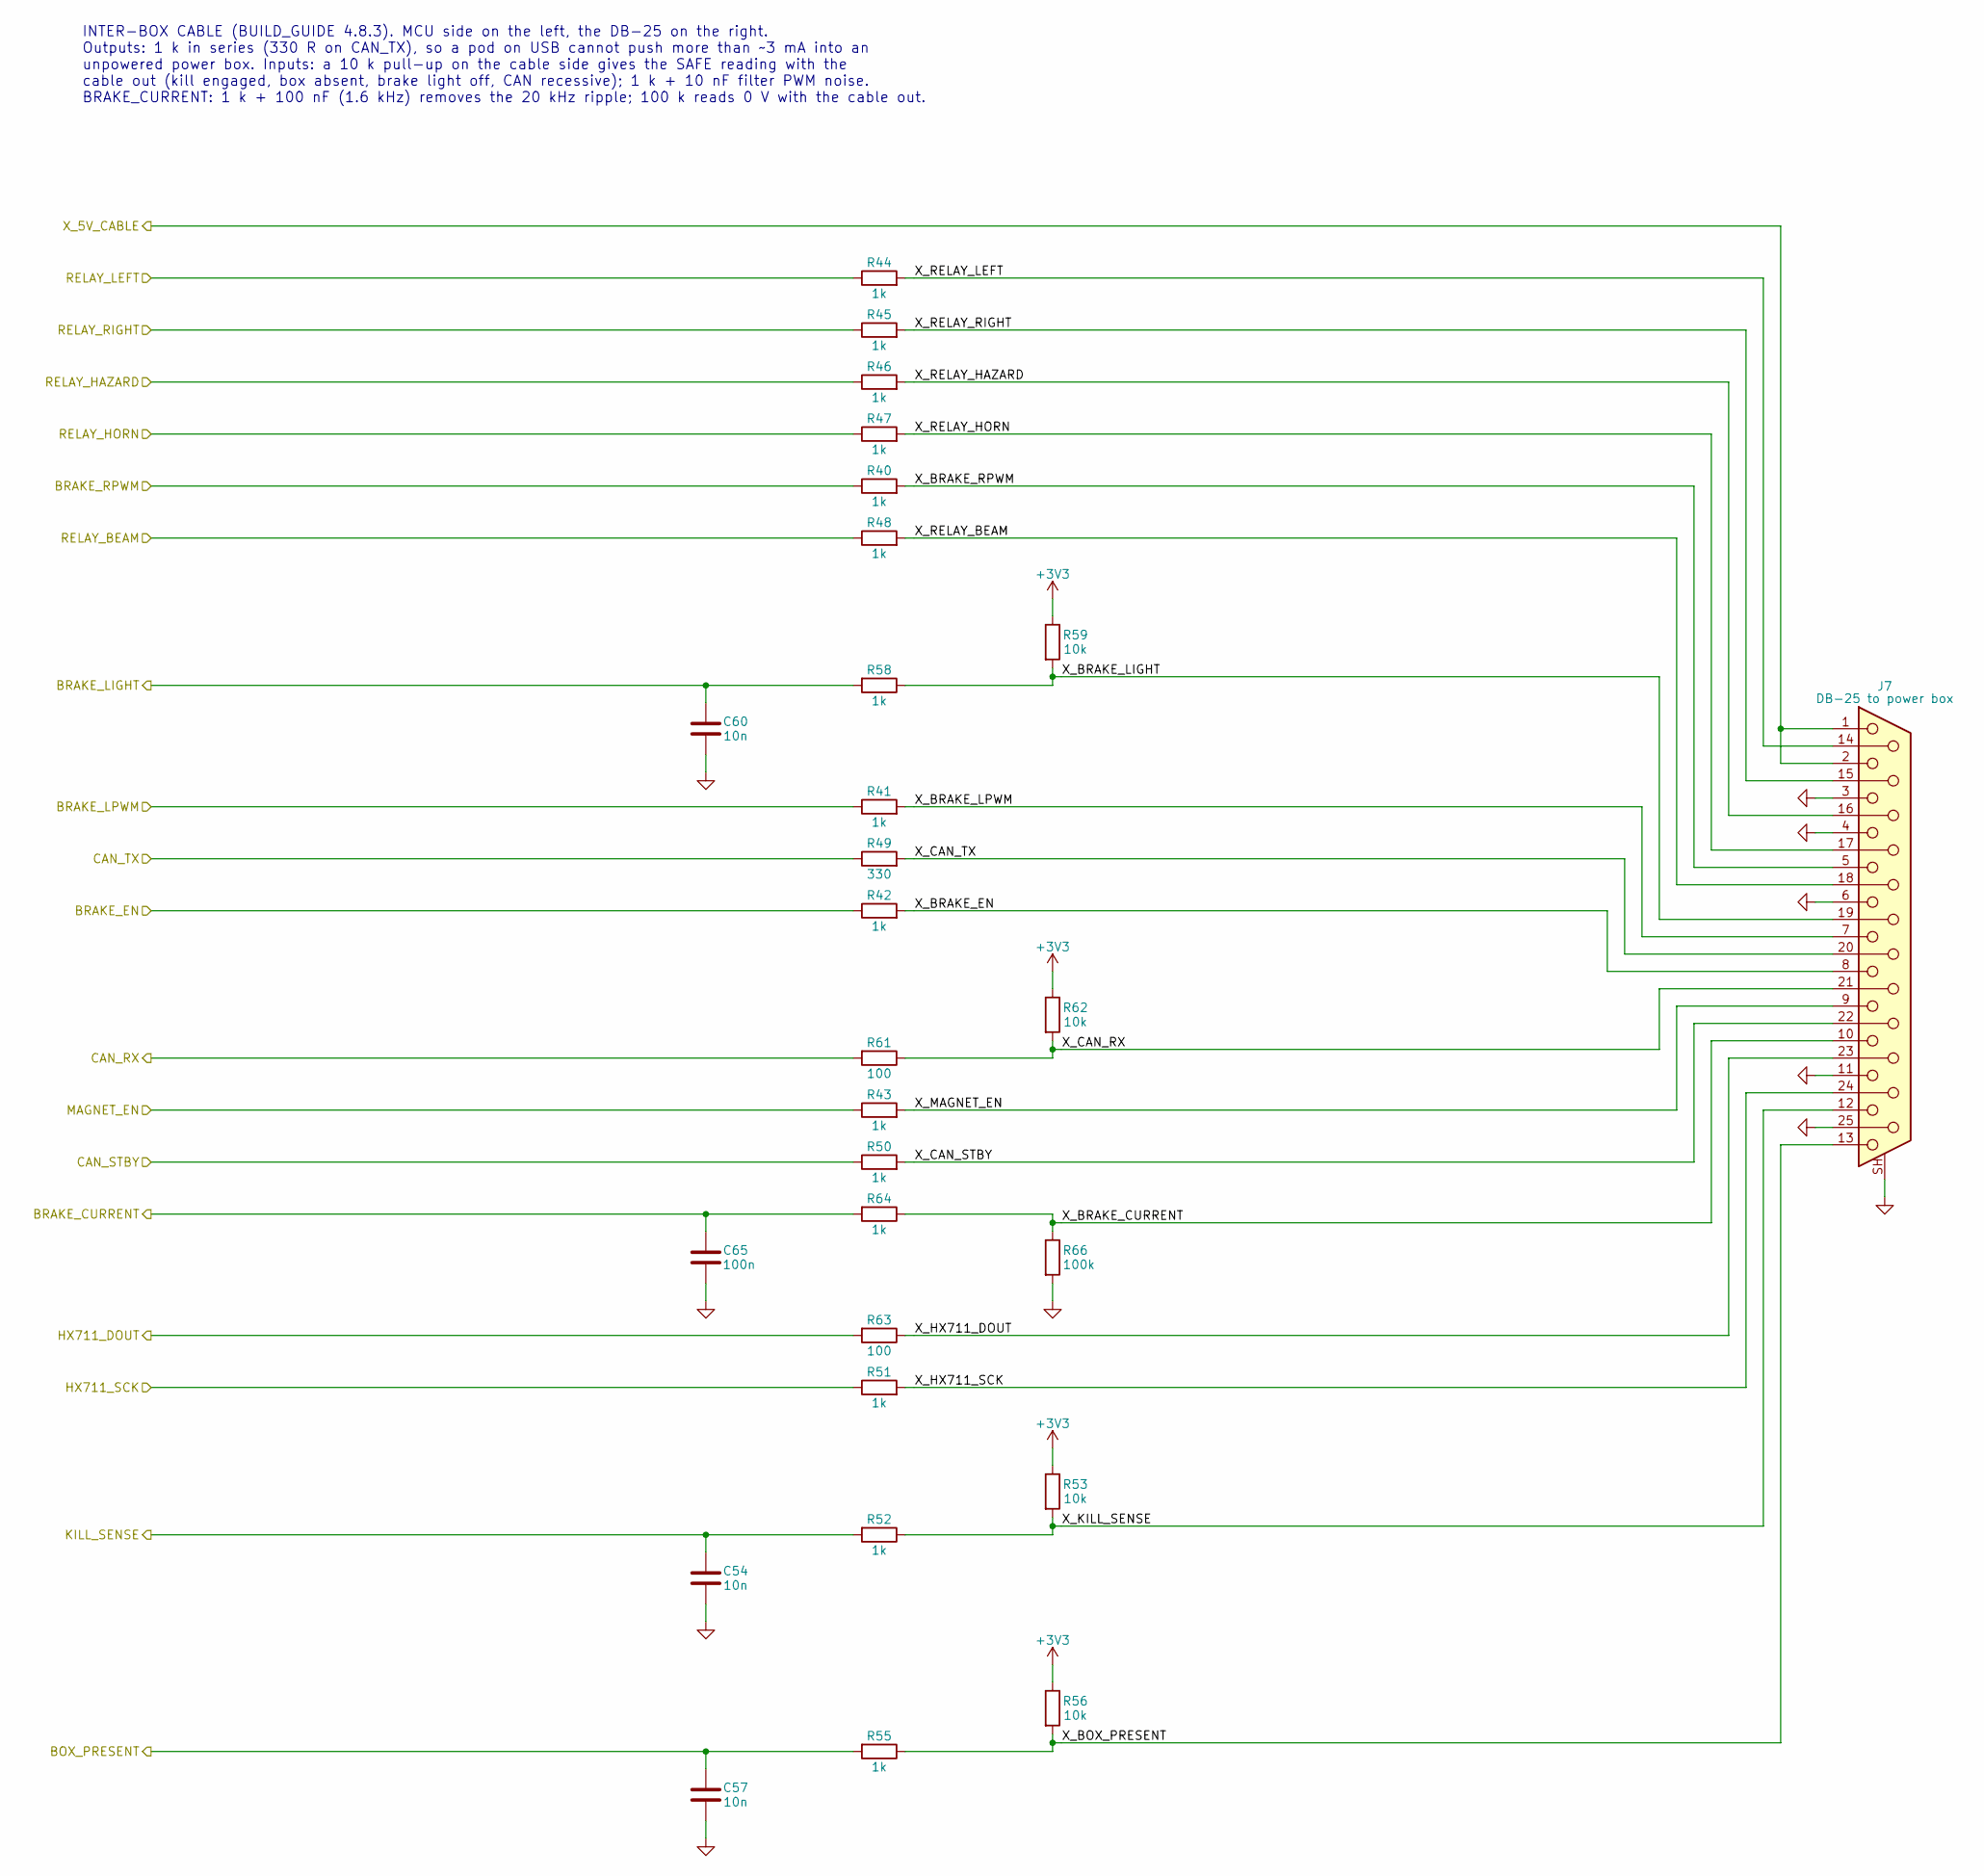
[picture p87: schematic cable.kicad_sch, Inter-box cable: DB-25, series resistors, input filters]

Parts:
C54, C57, C60: 10n; C_0805_2012Metric
C65: 100n; C_0805_2012Metric
J7: DB-25 to power box; DSUB-25_Socket_Horizontal_P2.77x2.84mm_EdgePinOffset4.94mm_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
R40, R41, R42, R43, R44, R45, R46, R47, R48, R50, R51, R52, R55, R58, R64: 1k; R_0805_2012Metric
R49: 330; R_0805_2012Metric
R53, R56, R59, R62: 10k; R_0805_2012Metric
R61, R63: 100; R_0805_2012Metric
R66: 100k; R_0805_2012Metric

Connections:
+3V3: R53.1, R56.1, R59.1, R62.1; also elsewhere on the board
/BOX_PRESENT: C57.1, R55.2; also elsewhere on the board
/BRAKE_CURRENT: C65.1, R64.2; also elsewhere on the board
/BRAKE_EN: R42.1; also elsewhere on the board
/BRAKE_LIGHT: C60.1, R58.2; also elsewhere on the board
/BRAKE_LPWM: R41.1; also elsewhere on the board
/BRAKE_RPWM: R40.1; also elsewhere on the board
/CAN_RX: R61.2; also elsewhere on the board
/CAN_STBY: R50.1; also elsewhere on the board
/CAN_TX: R49.1; also elsewhere on the board
/HX711_DOUT: R63.2; also elsewhere on the board
/HX711_SCK: R51.1; also elsewhere on the board
/Inter-box cable: DB-25, series resistors, input filters/X_BOX_PRESENT: J7.13, R55.1, R56.2
/Inter-box cable: DB-25, series resistors, input filters/X_BRAKE_CURRENT: J7.10, R64.1, R66.1
/Inter-box cable: DB-25, series resistors, input filters/X_BRAKE_EN: J7.8, R42.2
/Inter-box cable: DB-25, series resistors, input filters/X_BRAKE_LIGHT: J7.19, R58.1, R59.2
/Inter-box cable: DB-25, series resistors, input filters/X_BRAKE_LPWM: J7.7, R41.2
/Inter-box cable: DB-25, series resistors, input filters/X_BRAKE_RPWM: J7.5, R40.2
/Inter-box cable: DB-25, series resistors, input filters/X_CAN_RX: J7.21, R61.1, R62.2
/Inter-box cable: DB-25, series resistors, input filters/X_CAN_STBY: J7.22, R50.2
/Inter-box cable: DB-25, series resistors, input filters/X_CAN_TX: J7.20, R49.2
/Inter-box cable: DB-25, series resistors, input filters/X_HX711_DOUT: J7.23, R63.1
/Inter-box cable: DB-25, series resistors, input filters/X_HX711_SCK: J7.24, R51.2
/Inter-box cable: DB-25, series resistors, input filters/X_KILL_SENSE: J7.12, R52.1, R53.2
/Inter-box cable: DB-25, series resistors, input filters/X_MAGNET_EN: J7.9, R43.2
/Inter-box cable: DB-25, series resistors, input filters/X_RELAY_BEAM: J7.18, R48.2
/Inter-box cable: DB-25, series resistors, input filters/X_RELAY_HAZARD: J7.16, R46.2
/Inter-box cable: DB-25, series resistors, input filters/X_RELAY_HORN: J7.17, R47.2
/Inter-box cable: DB-25, series resistors, input filters/X_RELAY_LEFT: J7.14, R44.2
/Inter-box cable: DB-25, series resistors, input filters/X_RELAY_RIGHT: J7.15, R45.2
/KILL_SENSE: C54.1, R52.2; also elsewhere on the board
/MAGNET_EN: R43.1; also elsewhere on the board
/RELAY_BEAM: R48.1; also elsewhere on the board
/RELAY_HAZARD: R46.1; also elsewhere on the board
/RELAY_HORN: R47.1; also elsewhere on the board
/RELAY_LEFT: R44.1; also elsewhere on the board
/RELAY_RIGHT: R45.1; also elsewhere on the board
/X_5V_CABLE: J7.1, J7.2; also elsewhere on the board
GND: C54.2, C57.2, C60.2, C65.2, J7.3, J7.4, J7.6, J7.11, J7.25, J7.SH (PAD), R66.2; also elsewhere on the board

Notes on the sheet:
INTER-BOX CABLE (BUILD_GUIDE 4.8.3). MCU side on the left, the DB-25 on the right. Outputs: 1 k in series (330 R on CAN_TX), so a pod on USB cannot push more than ~3 mA into an unpowered power box. Inputs: a 10 k pull-up on the cable side gives the SAFE reading with the cable out (kill engaged, box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

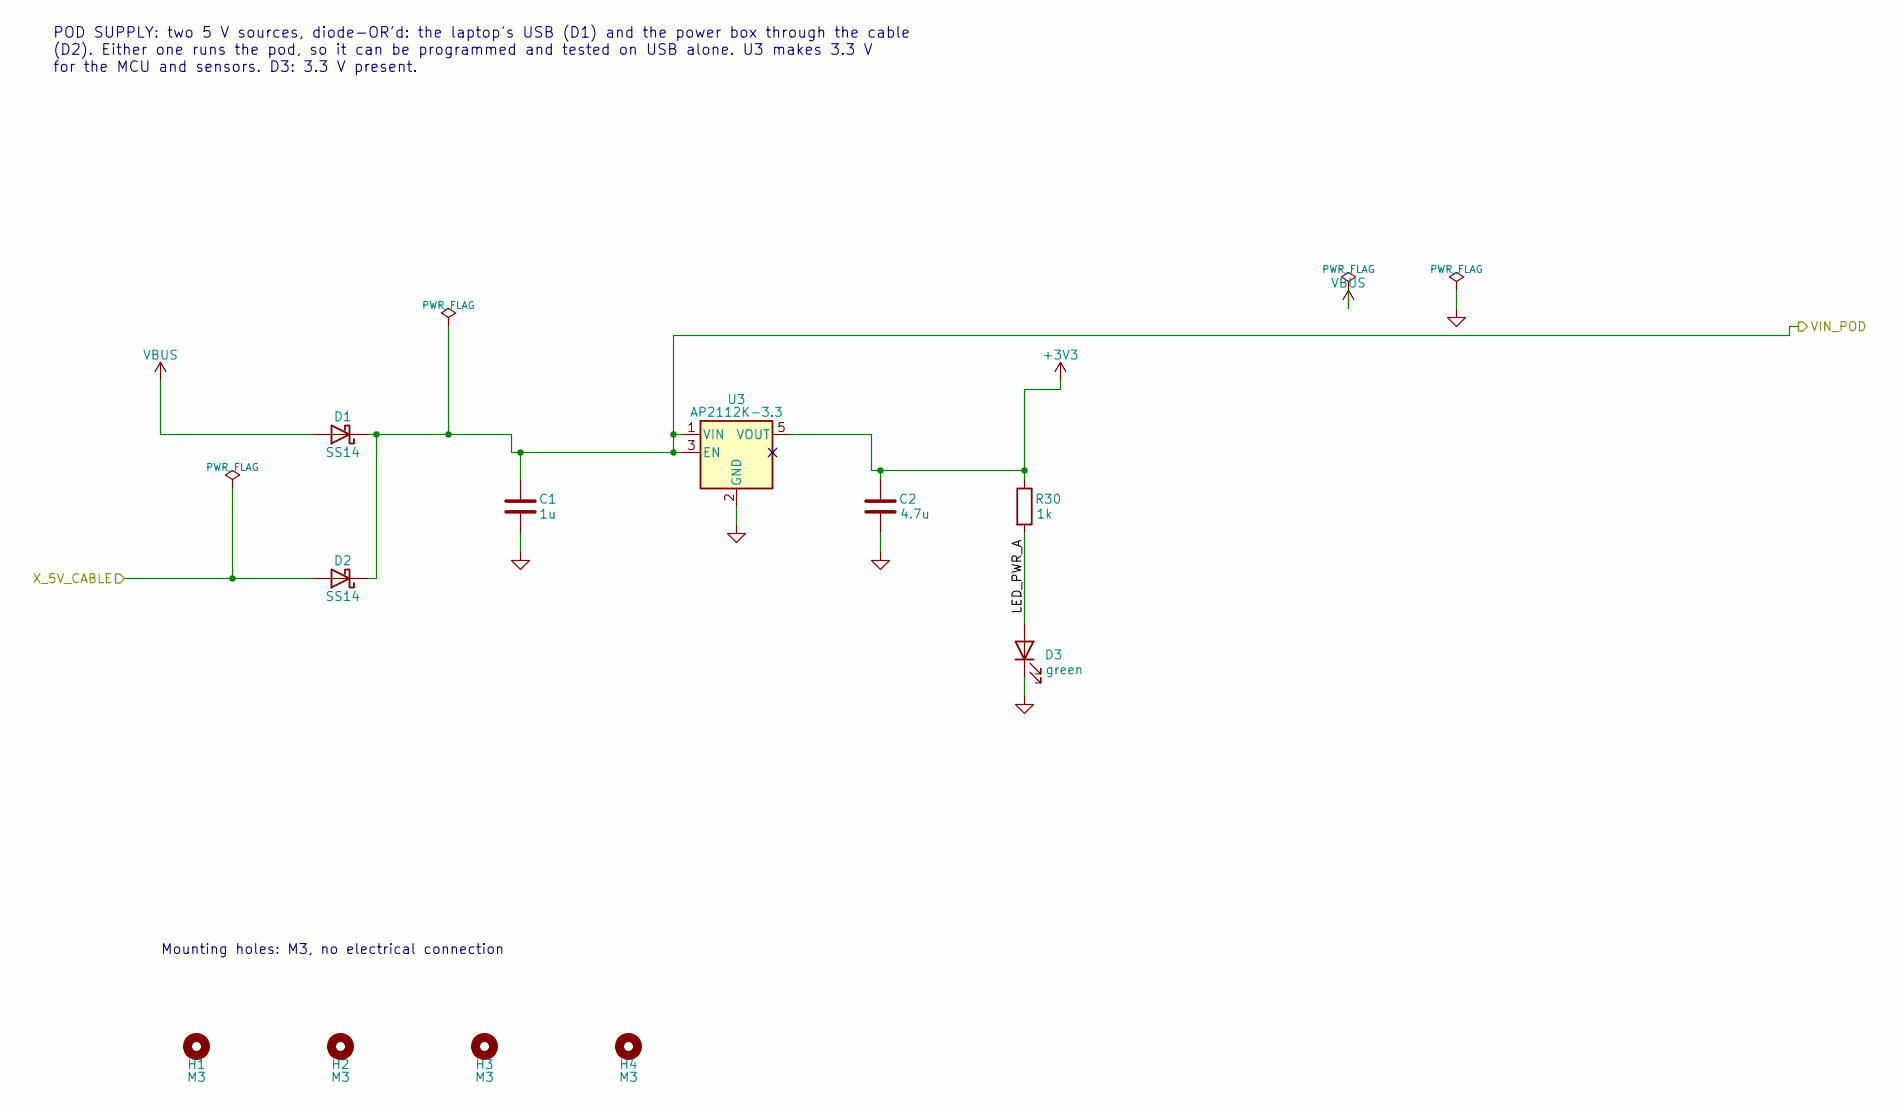
[picture p88: schematic power.kicad_sch, Pod supply: USB or cable 5 V, 3.3 V regulator]

Parts:
C1: 1u; C_1206_3216Metric
C2: 4.7u; C_1206_3216Metric
D1, D2: SS14; D_SMA
D3: green; LED_0805_2012Metric
H1, H2, H3, H4: M3; MountingHole_3.2mm_M3
R30: 1k; R_0805_2012Metric
U3: AP2112K-3.3; SOT-23-5

Connections:
+3V3: C2.1, R30.1, U3.5 (VOUT); also elsewhere on the board
/Pod supply: USB or cable 5 V, 3.3 V regulator/LED_PWR_A: D3.2 (A), R30.2
/VIN_POD: C1.1, D1.1 (K), D2.1 (K), U3.1 (VIN), U3.3 (EN); also elsewhere on the board
/X_5V_CABLE: D2.2 (A); also elsewhere on the board
GND: C1.2, C2.2, D3.1 (K), U3.2 (GND); also elsewhere on the board
VBUS: D1.2 (A); also elsewhere on the board

Notes on the sheet:
POD SUPPLY: two 5 V sources, diode-OR'd: the laptop's USB (D1) and the power box through the cable (D2). Either one runs the pod, so it can be programmed and tested on USB alone. U3 makes 3.3 V for the MCU and sensors. D3: 3.3 V present.
Mounting holes: M3, no electrical connection
