kiogimwenda/AR_Windscreen/hardware/pod_board/pod_board.kicad_pcb

## KiCad design hardware/pod_board/pod_board.kicad_pcb (continued)

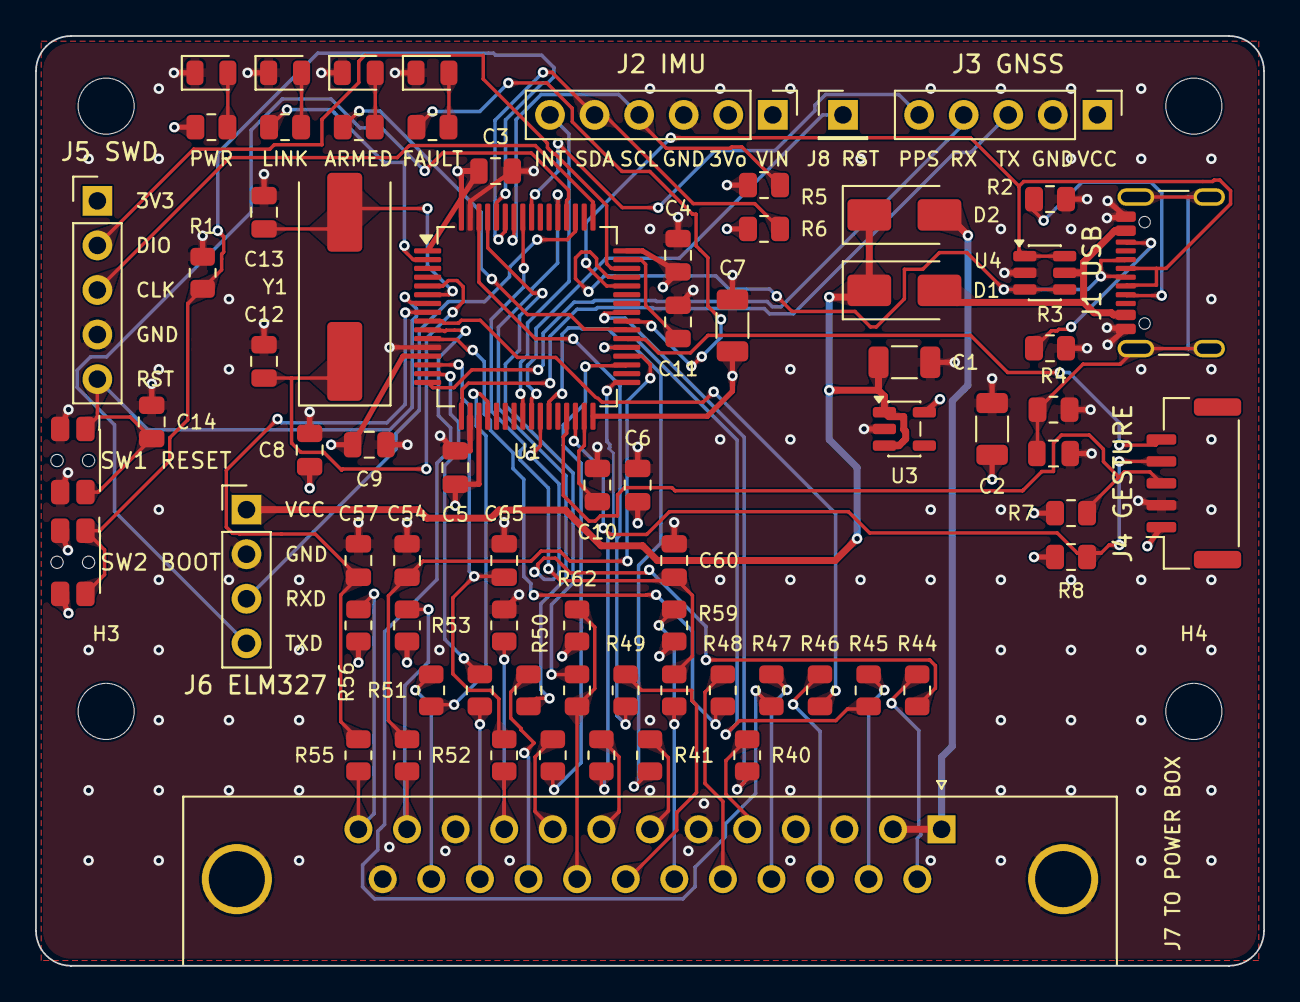
[picture p89: board pod_board.kicad_pcb from above]

Board: 4 copper layers, 70.0 x 53.0 mm, 78 parts (0 on the bottom side), 73 nets.
