kiogimwenda/AR_Windscreen/hardware/power_board/power_board.kicad_pcb

## KiCad design hardware/power_board/power_board.kicad_pcb (2026-10-16)

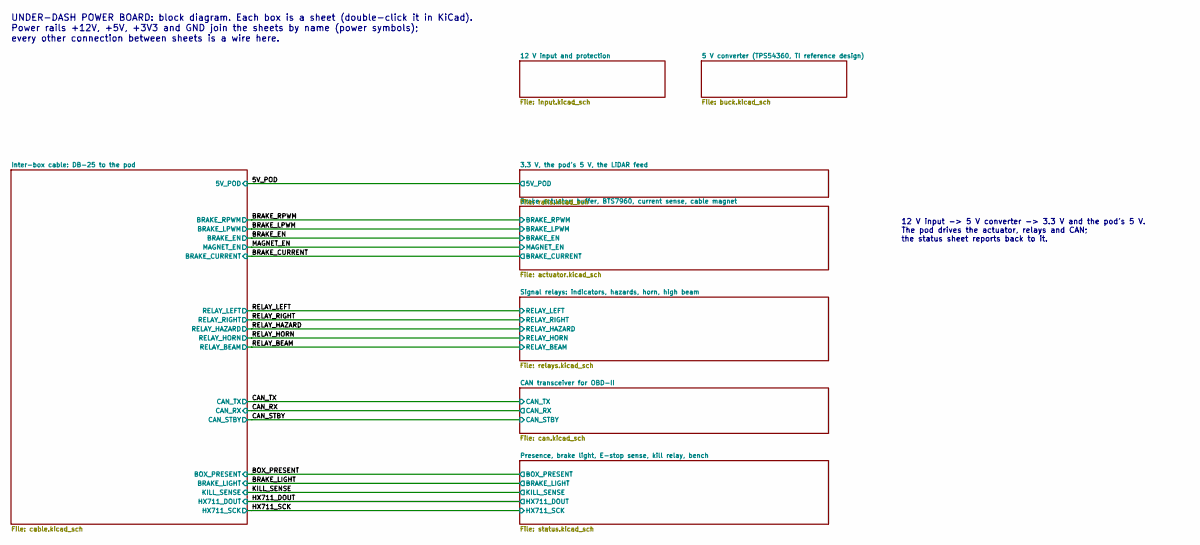
[picture p90: schematic power_board.kicad_sch, Under-dash power board (power, actuator, relays, CAN)]

Notes on the sheet:
UNDER-DASH POWER BOARD: block diagram. Each box is a sheet (double-click it in KiCad). Power rails +12V, +5V, +3V3 and GND join the sheets by name (power symbols); every other connection between sheets is a wire here.
12 V input -> 5 V converter -> 3.3 V and the pod's 5 V. The pod drives the actuator, relays and CAN; the status sheet reports back to it.

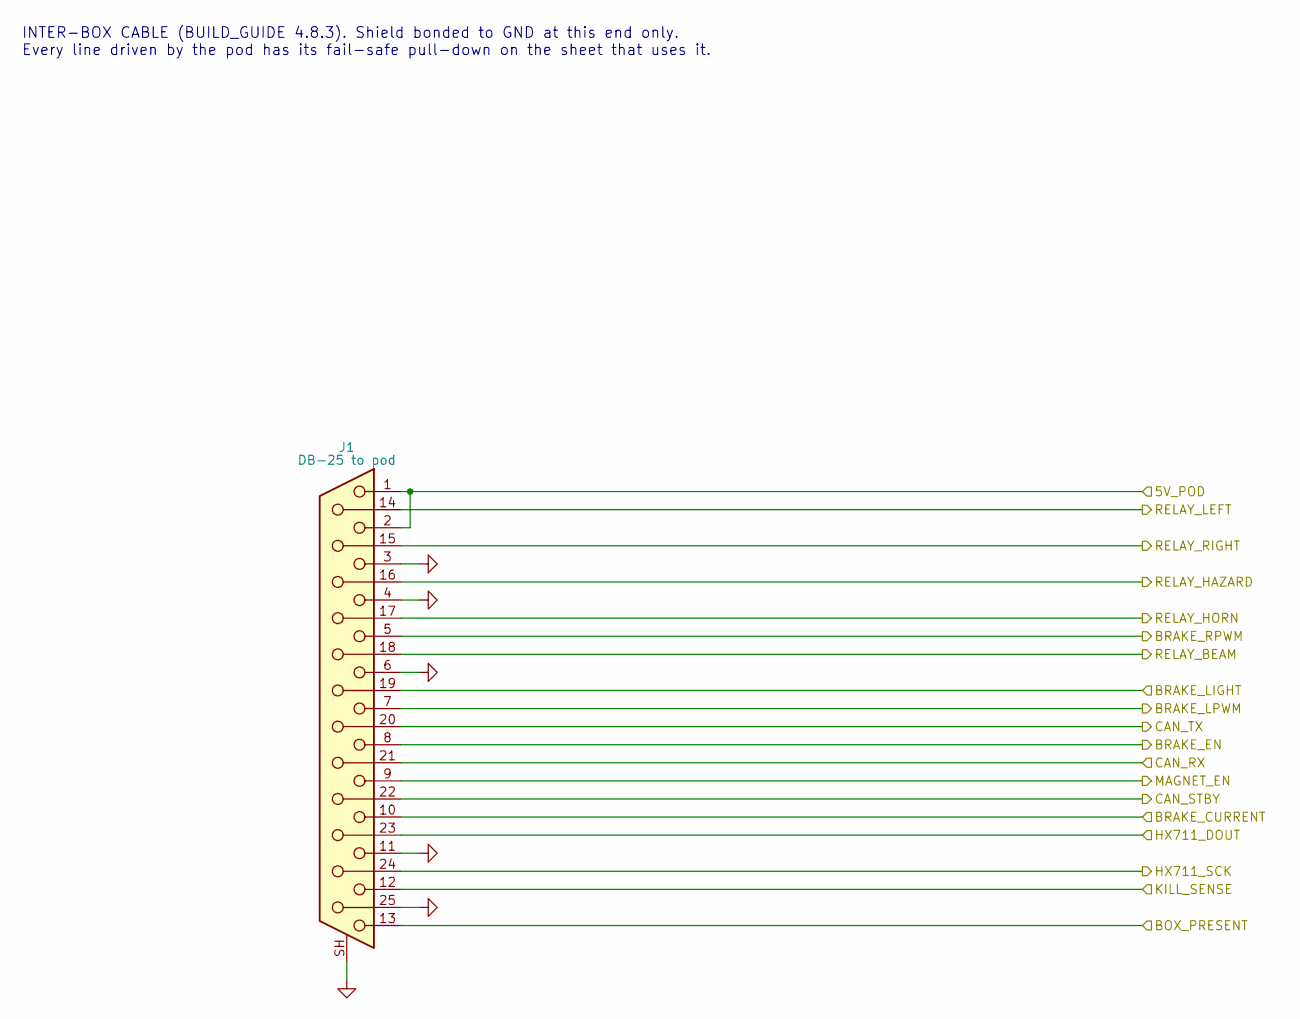
[picture p91: schematic cable.kicad_sch, Inter-box cable: DB-25 to the pod]

Parts:
J1: DB-25 to pod; DSUB-25_Socket_Horizontal_P2.77x2.84mm_EdgePinOffset4.94mm_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

Connections:
/5V_POD: J1.1, J1.2; also elsewhere on the board
/BOX_PRESENT: J1.13; also elsewhere on the board
/BRAKE_CURRENT: J1.10; also elsewhere on the board
/BRAKE_EN: J1.8; also elsewhere on the board
/BRAKE_LIGHT: J1.19; also elsewhere on the board
/BRAKE_LPWM: J1.7; also elsewhere on the board
/BRAKE_RPWM: J1.5; also elsewhere on the board
/CAN_RX: J1.21; also elsewhere on the board
/CAN_STBY: J1.22; also elsewhere on the board
/CAN_TX: J1.20; also elsewhere on the board
/HX711_DOUT: J1.23; also elsewhere on the board
/HX711_SCK: J1.24; also elsewhere on the board
/KILL_SENSE: J1.12; also elsewhere on the board
/MAGNET_EN: J1.9; also elsewhere on the board
/RELAY_BEAM: J1.18; also elsewhere on the board
/RELAY_HAZARD: J1.16; also elsewhere on the board
/RELAY_HORN: J1.17; also elsewhere on the board
/RELAY_LEFT: J1.14; also elsewhere on the board
/RELAY_RIGHT: J1.15; also elsewhere on the board
GND: J1.3, J1.4, J1.6, J1.11, J1.25, J1.SH (PAD); also elsewhere on the board

Notes on the sheet:
INTER-BOX CABLE (BUILD_GUIDE 4.8.3). Shield bonded to GND at this end only. Every line driven by the pod has its fail-safe pull-down on the sheet that uses it.

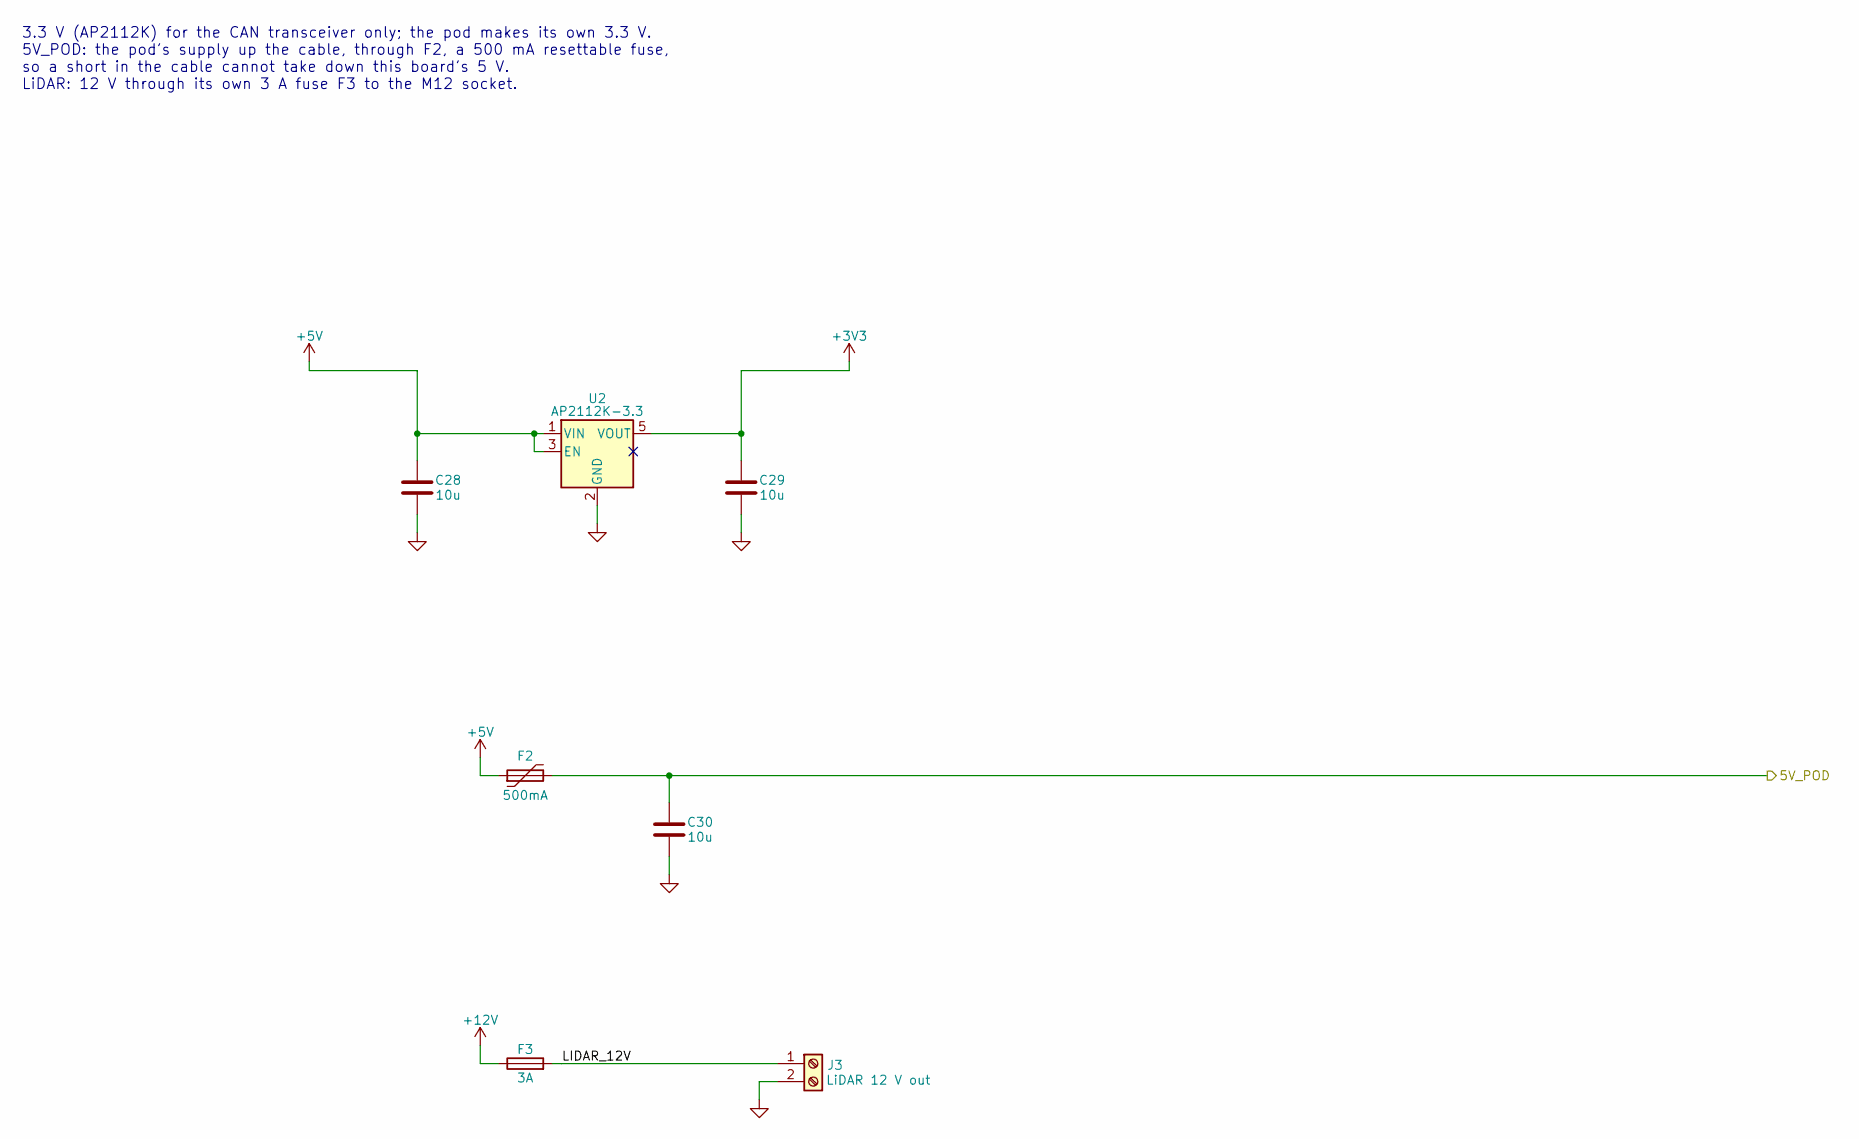
[picture p92: schematic rails.kicad_sch, 3.3 V, the pod's 5 V, the LiDAR feed]

Parts:
C28, C29, C30: 10u; C_1206_3216Metric
F2: 500mA; Fuse_1206_3216Metric
F3: 3A; Fuseholder_Blade_Mini_Keystone_3568
J3: LiDAR 12 V out; TerminalBlock_Phoenix_MKDS-1,5-2-5.08_1x02_P5.08mm_Horizont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
U2: AP2112K-3.3; SOT-23-5

Connections:
+3V3: C29.1, U2.5 (VOUT); also elsewhere on the board
+5V: C28.1, F2.1, U2.1 (VIN), U2.3 (EN); also elsewhere on the board
+12V: F3.1; also elsewhere on the board
/3.3 V, the pod's 5 V, the LiDAR feed/LIDAR_12V: F3.2, J3.1
/5V_POD: C30.1, F2.2; also elsewhere on the board
GND: C28.2, C29.2, C30.2, J3.2, U2.2 (GND); also elsewhere on the board

Notes on the sheet:
3.3 V (AP2112K) for the CAN transceiver only; the pod makes its own 3.3 V. 5V_POD: the pod's supply up the cable, through F2, a 500 mA resettable fuse, so a short in the cable cannot take down this board's 5 V. LiDAR: 12 V through its own 3 A fuse F3 to the M12 socket.

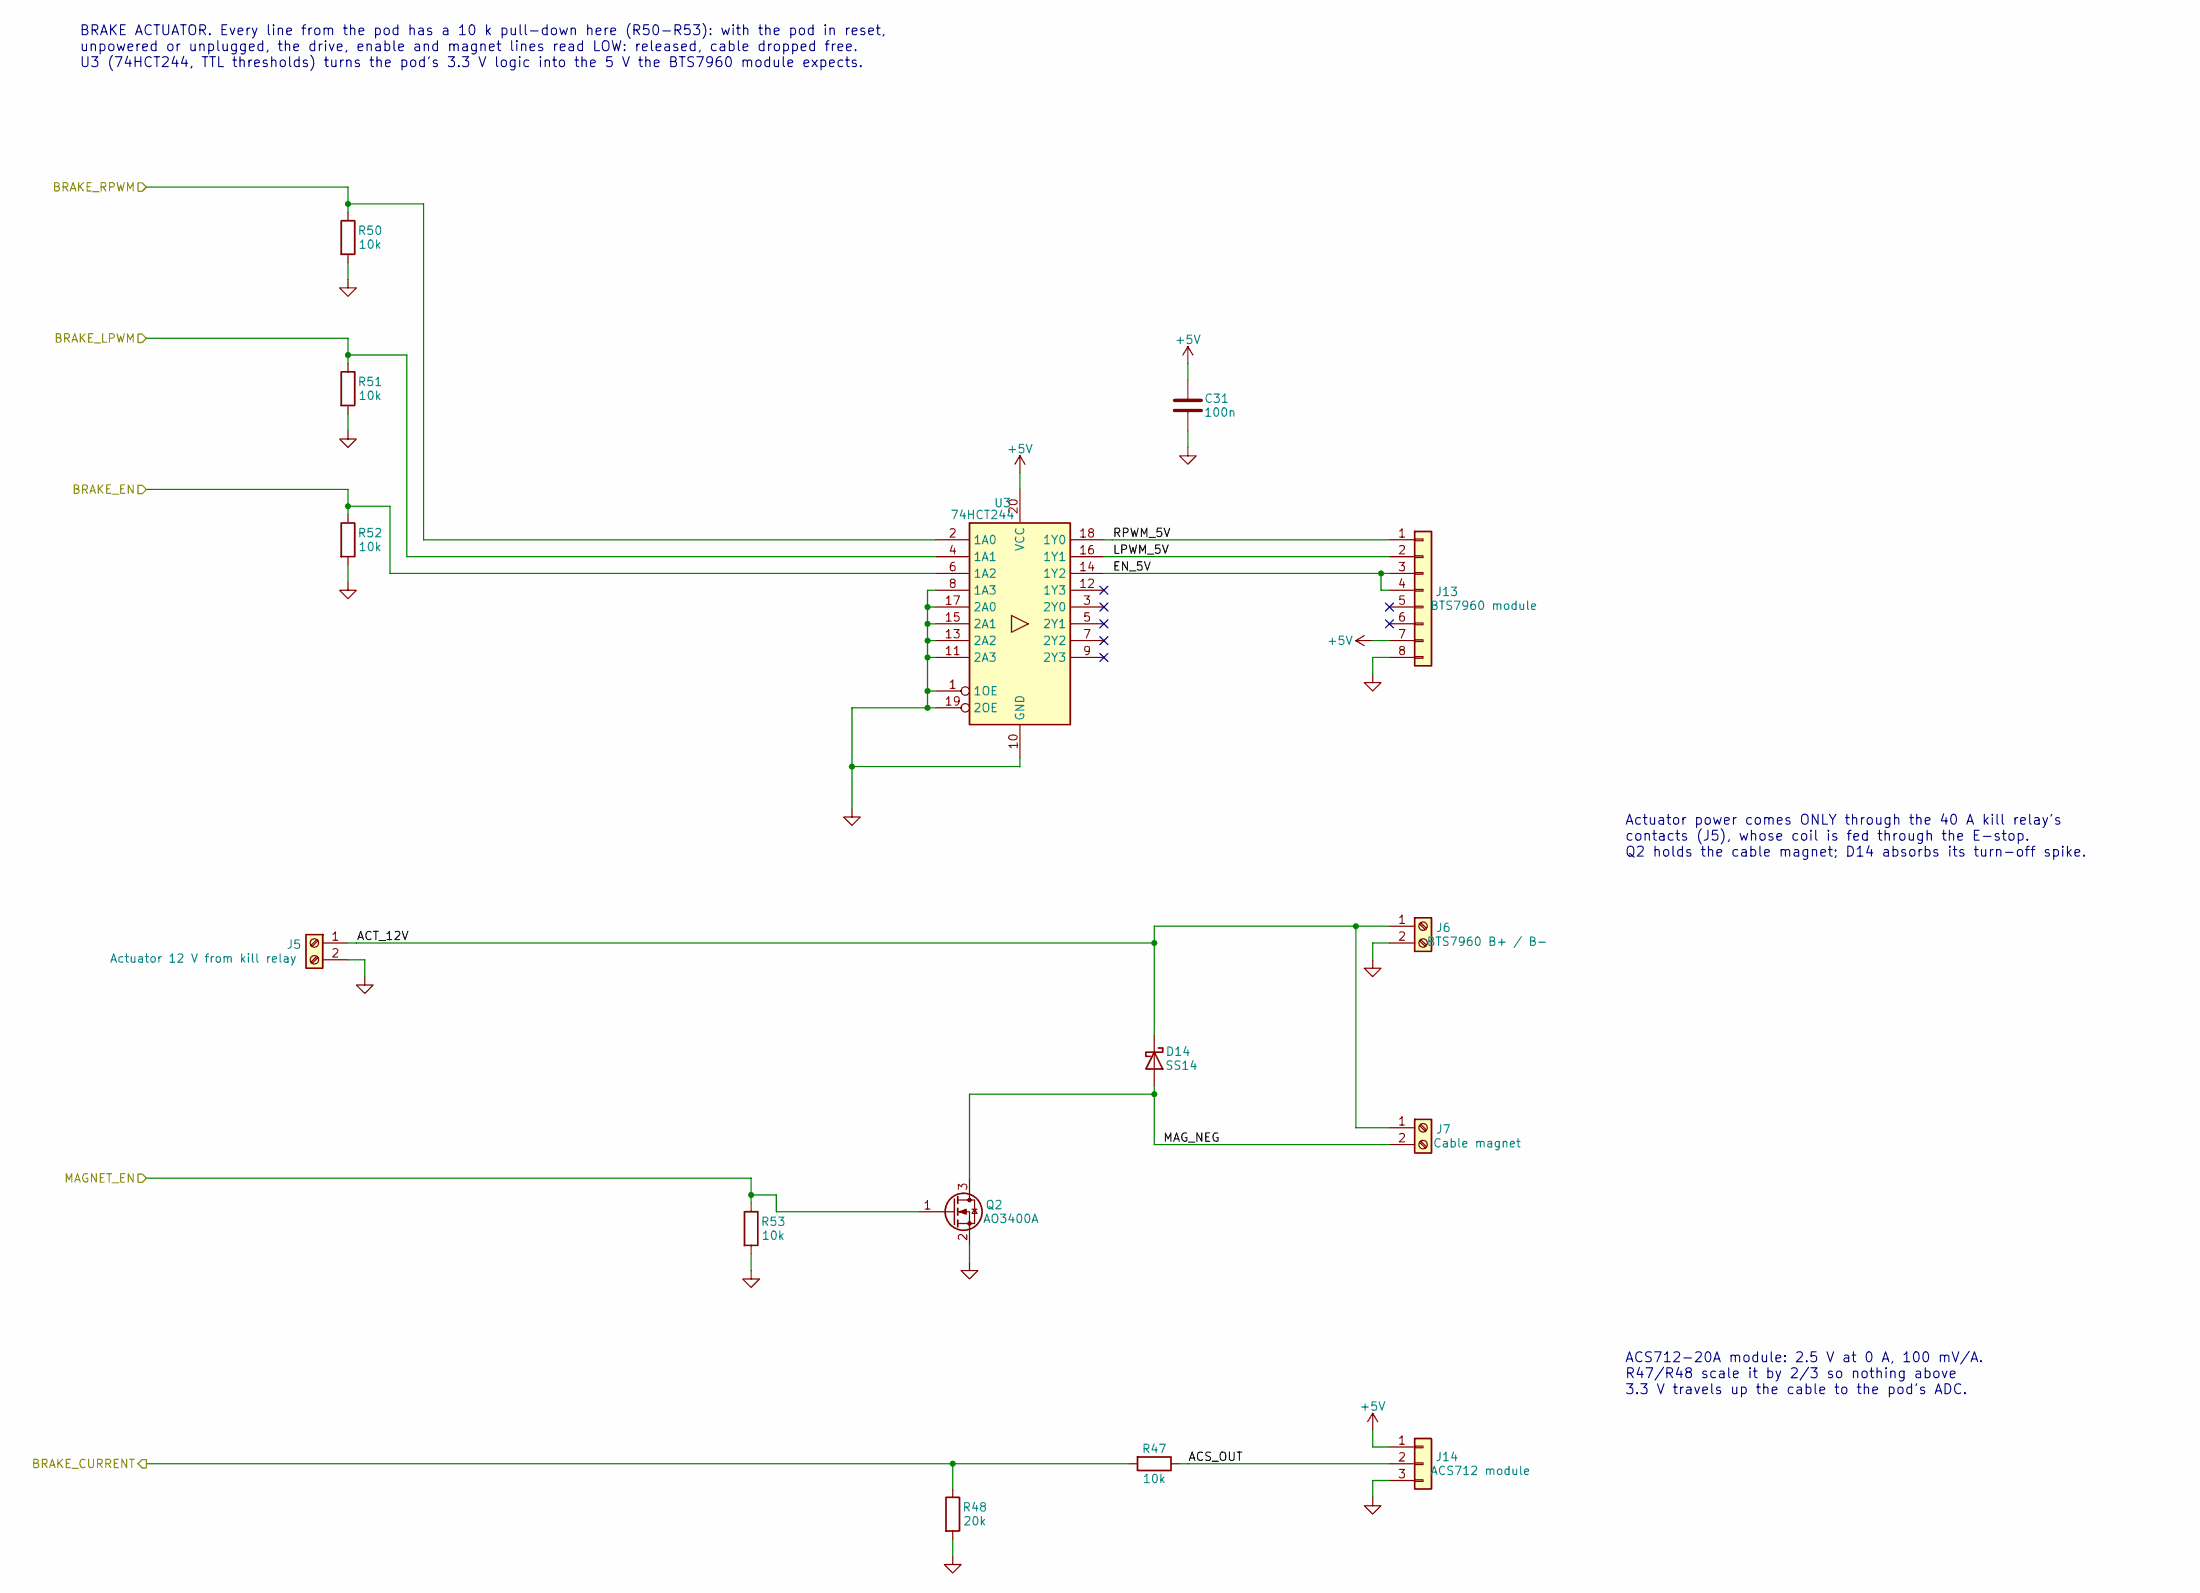
[picture p93: schematic actuator.kicad_sch, Brake actuator: buffer, BTS7960, current sense, cable magnet]

Parts:
C31: 100n; C_0805_2012Metric
D14: SS14; D_SMA
J5: Actuator 12 V from kill relay; TerminalBlock_Phoenix_MKDS-1,5-2-5.08_1x02_P5.08mm_Horizont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
J6: BTS7960 B+ / B-; TerminalBlock_Phoenix_MKDS-1,5-2-5.08_1x02_P5.08mm_Horizont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
J7: Cable magnet; TerminalBlock_Phoenix_MKDS-1,5-2-5.08_1x02_P5.08mm_Horizont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
J13: BTS7960 module; PinHeader_1x08_P2.54mm_Vertical
J14: ACS712 module; PinHeader_1x03_P2.54mm_Vertical
Q2: AO3400A; SOT-23
R47, R50, R51, R52, R53: 10k; R_0805_2012Metric
R48: 20k; R_0805_2012Metric
U3: 74HCT244; SOIC-20W_7.5x12.8mm_P1.27mm

Connections:
+5V: C31.1, J13.7, J14.1, U3.20 (VCC); also elsewhere on the board
/BRAKE_CURRENT: R47.2, R48.1; also elsewhere on the board
/BRAKE_EN: R52.1, U3.6 (1A2); also elsewhere on the board
/BRAKE_LPWM: R51.1, U3.4 (1A1); also elsewhere on the board
/BRAKE_RPWM: R50.1, U3.2 (1A0); also elsewhere on the board
/Brake actuator: buffer, BTS7960, current sense, cable magnet/ACS_OUT: J14.2, R47.1
/Brake actuator: buffer, BTS7960, current sense, cable magnet/ACT_12V: D14.1 (K), J5.1, J6.1, J7.1
/Brake actuator: buffer, BTS7960, current sense, cable magnet/EN_5V: J13.3, J13.4, U3.14 (1Y2)
/Brake actuator: buffer, BTS7960, current sense, cable magnet/LPWM_5V: J13.2, U3.16 (1Y1)
/Brake actuator: buffer, BTS7960, current sense, cable magnet/MAG_NEG: D14.2 (A), J7.2, Q2.3 (D)
/Brake actuator: buffer, BTS7960, current sense, cable magnet/RPWM_5V: J13.1, U3.18 (1Y0)
/MAGNET_EN: Q2.1 (G), R53.1; also elsewhere on the board
GND: C31.2, J5.2, J6.2, J13.8, J14.3, Q2.2 (S), R48.2, R50.2, R51.2, R52.2, R53.2, U3.1 (1OE), U3.8 (1A3), U3.10 (GND), U3.11 (2A3), U3.13 (2A2), U3.15 (2A1), U3.17 (2A0), U3.19 (2OE); also elsewhere on the board

Notes on the sheet:
BRAKE ACTUATOR. Every line from the pod has a 10 k pull-down here (R50-R53): with the pod in reset, unpowered or unplugged, the drive, enable and magnet lines read LOW: released, cable dropped free. U3 (74HCT244, TTL thresholds) turns the pod's 3.3 V logic into the 5 V the BTS7960 module expects.
Actuator power comes ONLY through the 40 A kill relay's contacts (J5), whose coil is fed through the E-stop. Q2 holds the cable magnet; D14 absorbs its turn-off spike.
ACS712-20A module: 2.5 V at 0 A, 100 mV/A. R47/R48 scale it by 2/3 so nothing above 3.3 V travels up the cable to the pod's ADC.

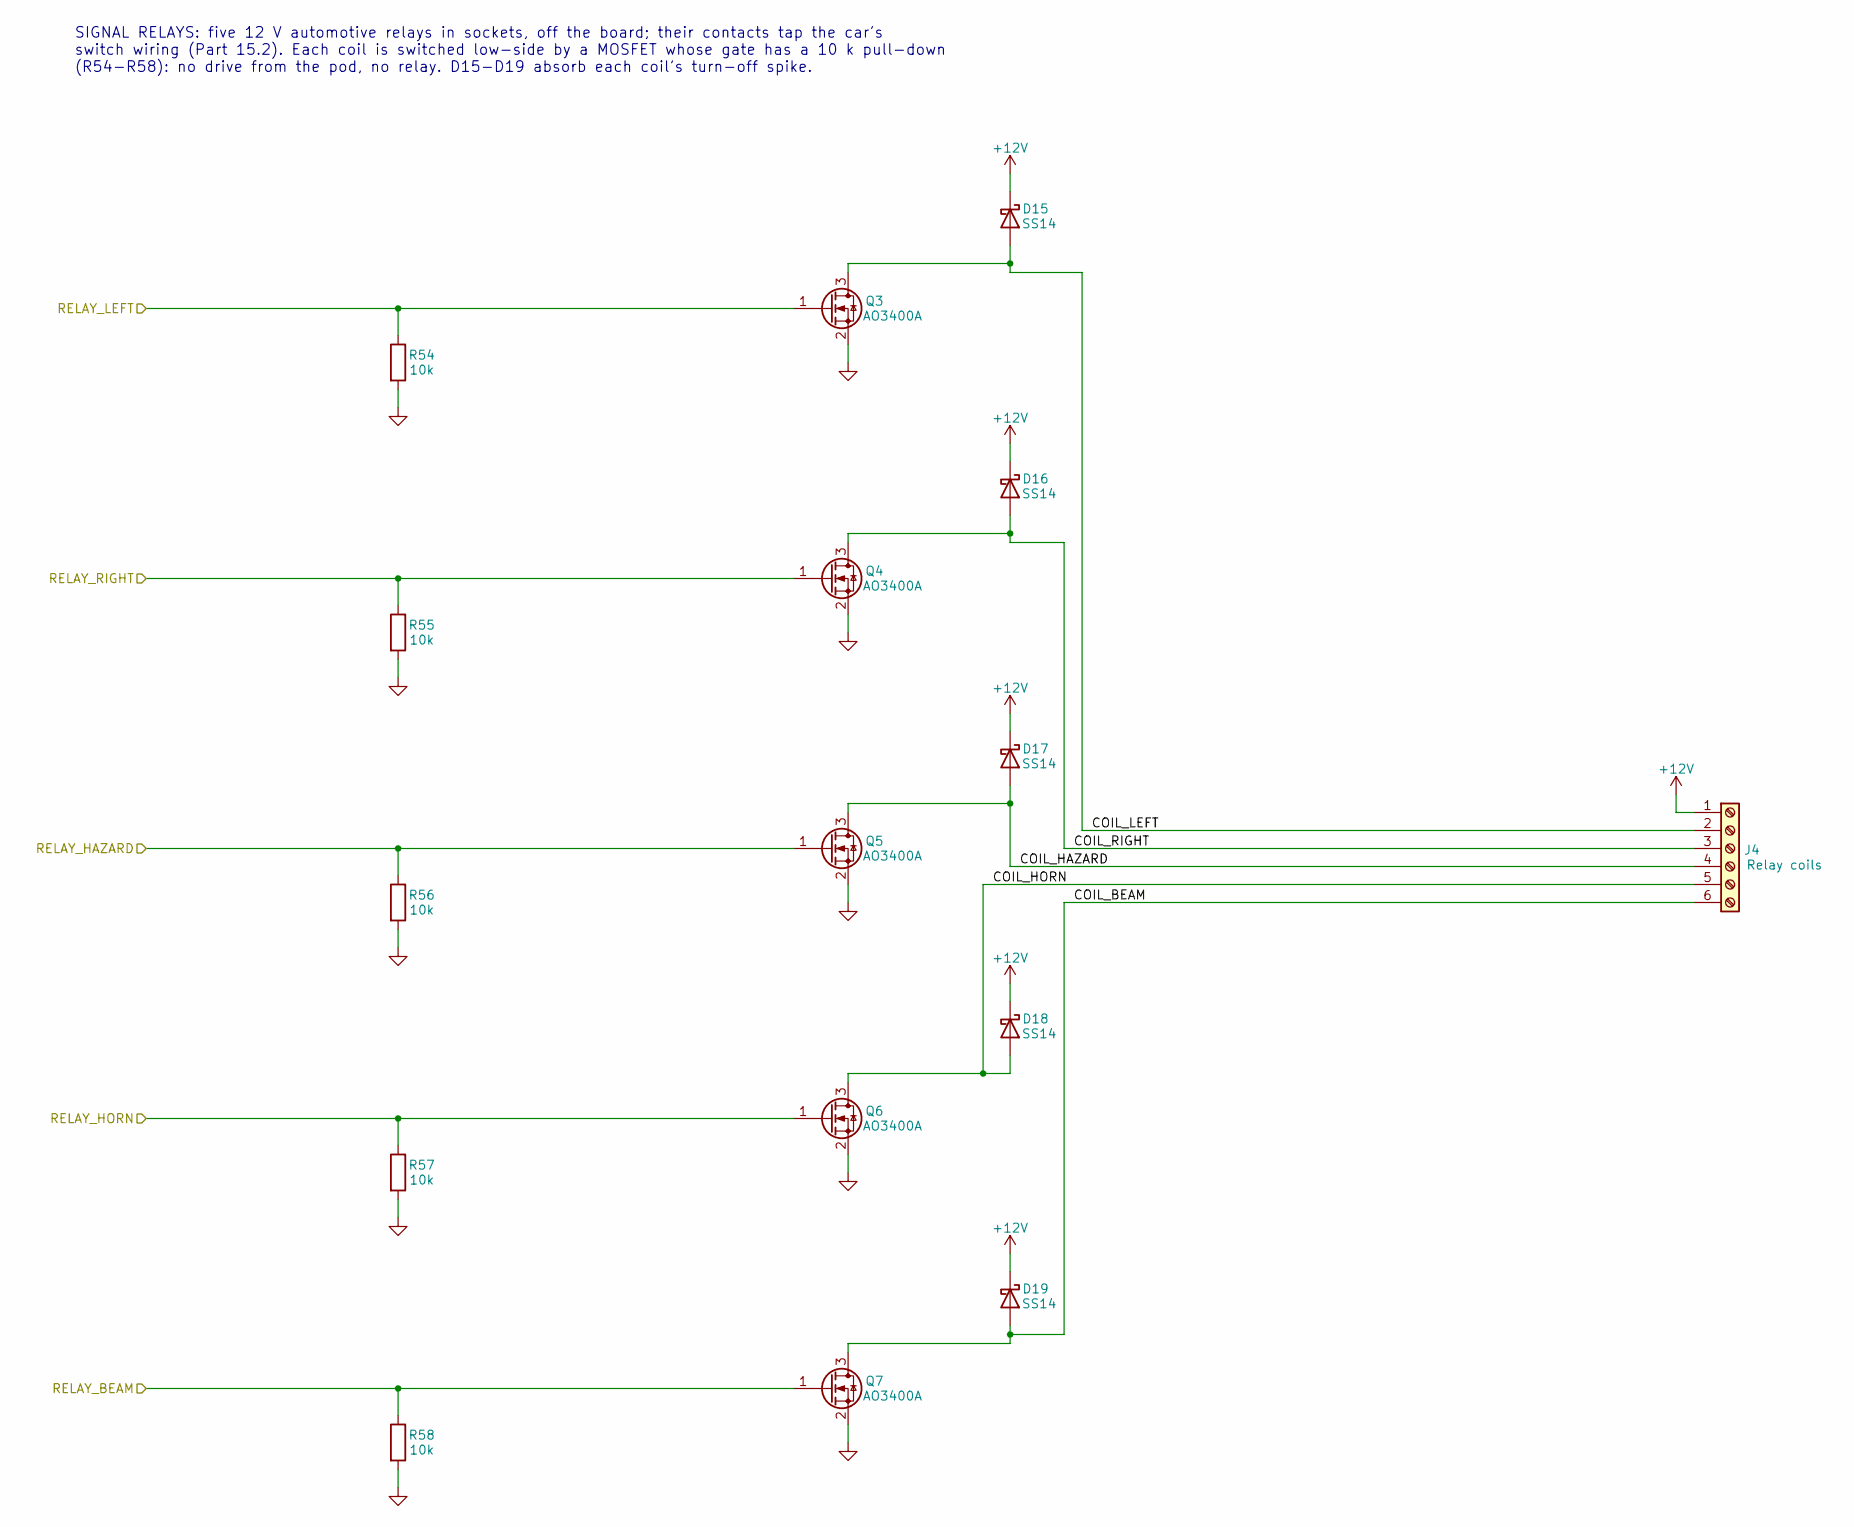
[picture p94: schematic relays.kicad_sch, Signal relays: indicators, hazards, horn, high beam]

Parts:
D15, D16, D17, D18, D19: SS14; D_SMA
J4: Relay coils; TerminalBlock_Phoenix_MKDS-1,5-6-5.08_1x06_P5.08mm_Horizont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
Q3, Q4, Q5, Q6, Q7: AO3400A; SOT-23
R54, R55, R56, R57, R58: 10k; R_0805_2012Metric

Connections:
+12V: D15.1 (K), D16.1 (K), D17.1 (K), D18.1 (K), D19.1 (K), J4.1; also elsewhere on the board
/RELAY_BEAM: Q7.1 (G), R58.1; also elsewhere on the board
/RELAY_HAZARD: Q5.1 (G), R56.1; also elsewhere on the board
/RELAY_HORN: Q6.1 (G), R57.1; also elsewhere on the board
/RELAY_LEFT: Q3.1 (G), R54.1; also elsewhere on the board
/RELAY_RIGHT: Q4.1 (G), R55.1; also elsewhere on the board
/Signal relays: indicators, hazards, horn, high beam/COIL_BEAM: D19.2 (A), J4.6, Q7.3 (D)
/Signal relays: indicators, hazards, horn, high beam/COIL_HAZARD: D17.2 (A), J4.4, Q5.3 (D)
/Signal relays: indicators, hazards, horn, high beam/COIL_HORN: D18.2 (A), J4.5, Q6.3 (D)
/Signal relays: indicators, hazards, horn, high beam/COIL_LEFT: D15.2 (A), J4.2, Q3.3 (D)
/Signal relays: indicators, hazards, horn, high beam/COIL_RIGHT: D16.2 (A), J4.3, Q4.3 (D)
GND: Q3.2 (S), Q4.2 (S), Q5.2 (S), Q6.2 (S), Q7.2 (S), R54.2, R55.2, R56.2, R57.2, R58.2; also elsewhere on the board

Notes on the sheet:
SIGNAL RELAYS: five 12 V automotive relays in sockets, off the board; their contacts tap the car's switch wiring (Part 15.2). Each coil is switched low-side by a MOSFET whose gate has a 10 k pull-down (R54-R58): no drive from the pod, no relay. D15-D19 absorb each coil's turn-off spike.

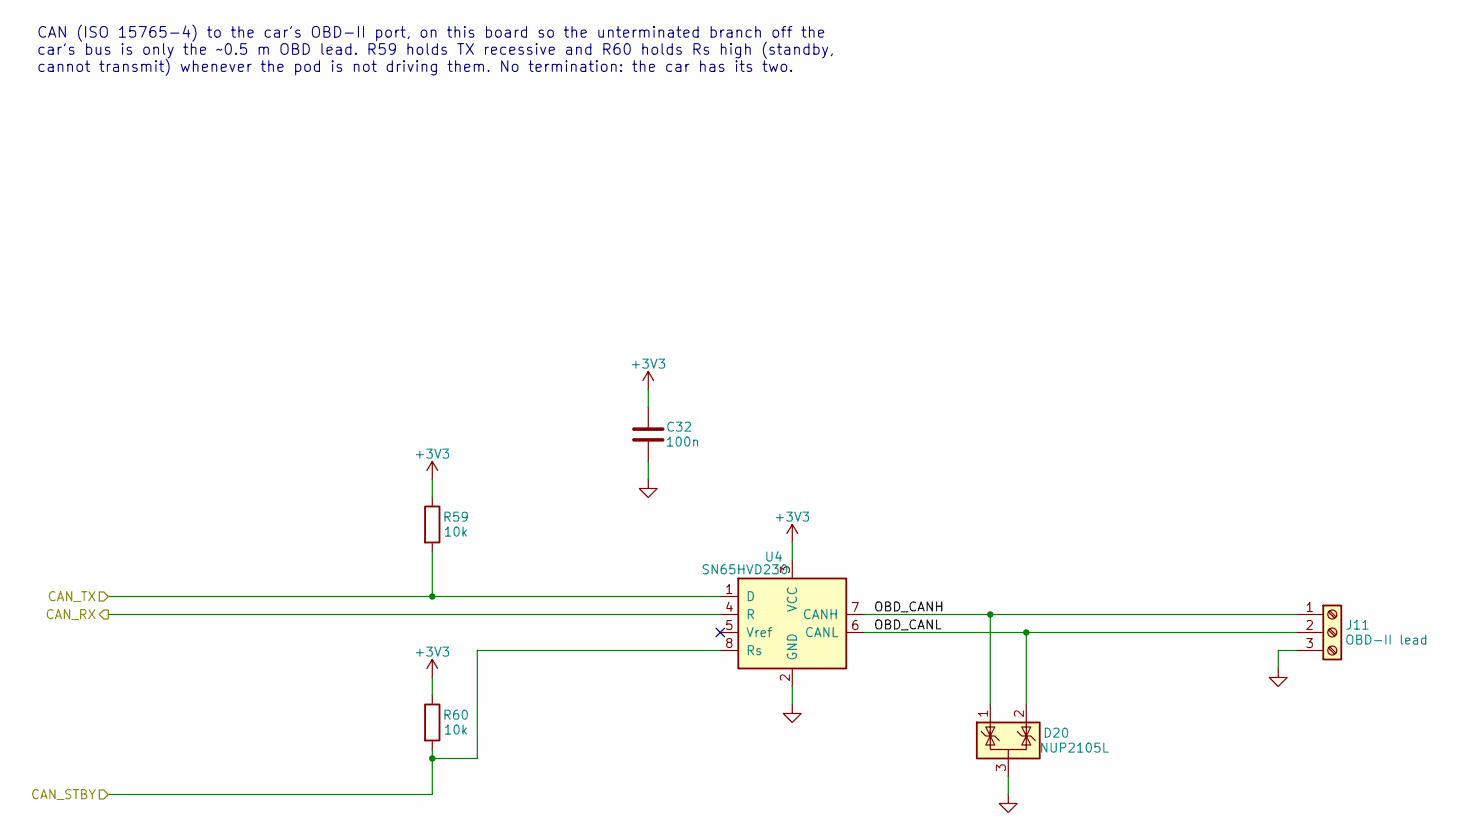
[picture p95: schematic can.kicad_sch, CAN transceiver for OBD-II]

Parts:
C32: 100n; C_0805_2012Metric
D20: NUP2105L; SOT-23
J11: OBD-II lead; TerminalBlock_Phoenix_MKDS-1,5-3-5.08_1x03_P5.08mm_Horizont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
R59, R60: 10k; R_0805_2012Metric
U4: SN65HVD230; SOIC-8_3.9x4.9mm_P1.27mm

Connections:
+3V3: C32.1, R59.1, R60.1, U4.3 (VCC); also elsewhere on the board
/CAN transceiver for OBD-II/OBD_CANH: D20.1 (K), J11.1, U4.7 (CANH)
/CAN transceiver for OBD-II/OBD_CANL: D20.2 (K), J11.2, U4.6 (CANL)
/CAN_RX: U4.4 (R); also elsewhere on the board
/CAN_STBY: R60.2, U4.8 (Rs); also elsewhere on the board
/CAN_TX: R59.2, U4.1 (D); also elsewhere on the board
GND: C32.2, D20.3 (A), J11.3, U4.2 (GND); also elsewhere on the board

Notes on the sheet:
CAN (ISO 15765-4) to the car's OBD-II port, on this board so the unterminated branch off the car's bus is only the ~0.5 m OBD lead. R59 holds TX recessive and R60 holds Rs high (standby, cannot transmit) whenever the pod is not driving them. No termination: the car has its two.

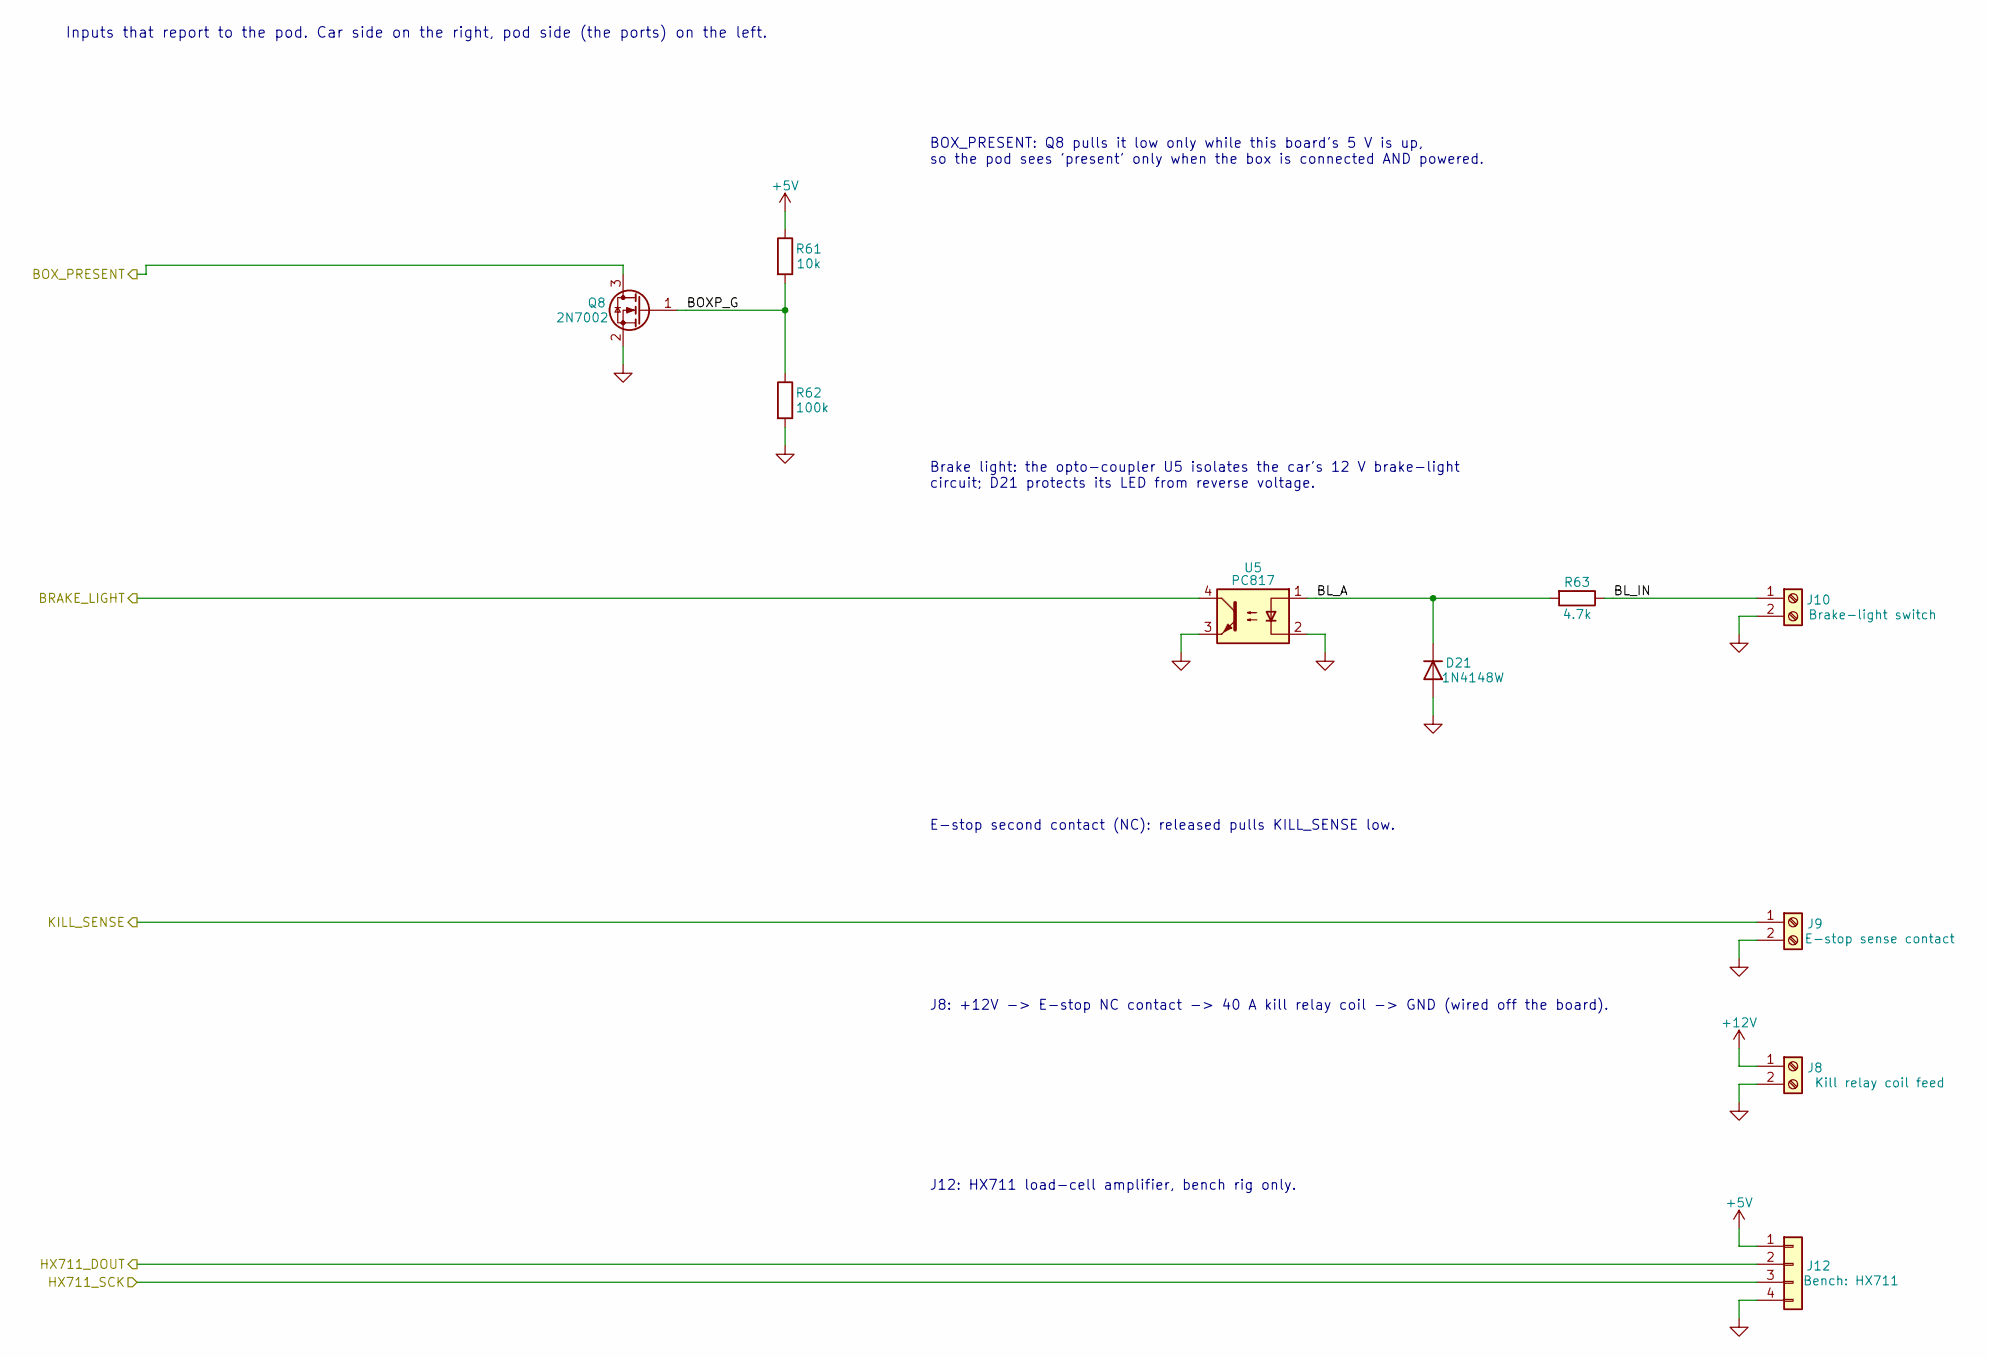
[picture p96: schematic status.kicad_sch, Presence, brake light, E-stop sense, kill relay, bench]

Parts:
D21: 1N4148W; D_SOD-123
J8: Kill relay coil feed; TerminalBlock_Phoenix_MKDS-1,5-2-5.08_1x02_P5.08mm_Horizont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
J9: E-stop sense contact; TerminalBlock_Phoenix_MKDS-1,5-2-5.08_1x02_P5.08mm_Horizont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
J10: Brake-light switch; TerminalBlock_Phoenix_MKDS-1,5-2-5.08_1x02_P5.08mm_Horizont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
J12: Bench: HX711; PinHeader_1x04_P2.54mm_Vertical
Q8: 2N7002; SOT-23
R61: 10k; R_0805_2012Metric
R62: 100k; R_0805_2012Metric
R63: 4.7k; R_0805_2012Metric
U5: PC817; DIP-4_W7.62mm

Connections:
+5V: J12.1, R61.1; also elsewhere on the board
+12V: J8.1; also elsewhere on the board
/BOX_PRESENT: Q8.3 (D); also elsewhere on the board
/BRAKE_LIGHT: U5.4; also elsewhere on the board
/HX711_DOUT: J12.2; also elsewhere on the board
/HX711_SCK: J12.3; also elsewhere on the board
/KILL_SENSE: J9.1; also elsewhere on the board
/Presence, brake light, E-stop sense, kill relay, bench/BL_A: D21.1 (K), R63.2, U5.1
/Presence, brake light, E-stop sense, kill relay, bench/BL_IN: J10.1, R63.1
/Presence, brake light, E-stop sense, kill relay, bench/BOXP_G: Q8.1 (G), R61.2, R62.1
GND: D21.2 (A), J8.2, J9.2, J10.2, J12.4, Q8.2 (S), R62.2, U5.2, U5.3; also elsewhere on the board

Notes on the sheet:
Inputs that report to the pod. Car side on the right, pod side (the ports) on the left.
BOX_PRESENT: Q8 pulls it low only while this board's 5 V is up, so the pod sees 'present' only when the box is connected AND powered.
Brake light: the opto-coupler U5 isolates the car's 12 V brake-light circuit; D21 protects its LED from reverse voltage.
E-stop second contact (NC): released pulls KILL_SENSE low.
J8: +12V -> E-stop NC contact -> 40 A kill relay coil -> GND (wired off the board).
J12: HX711 load-cell amplifier, bench rig only.

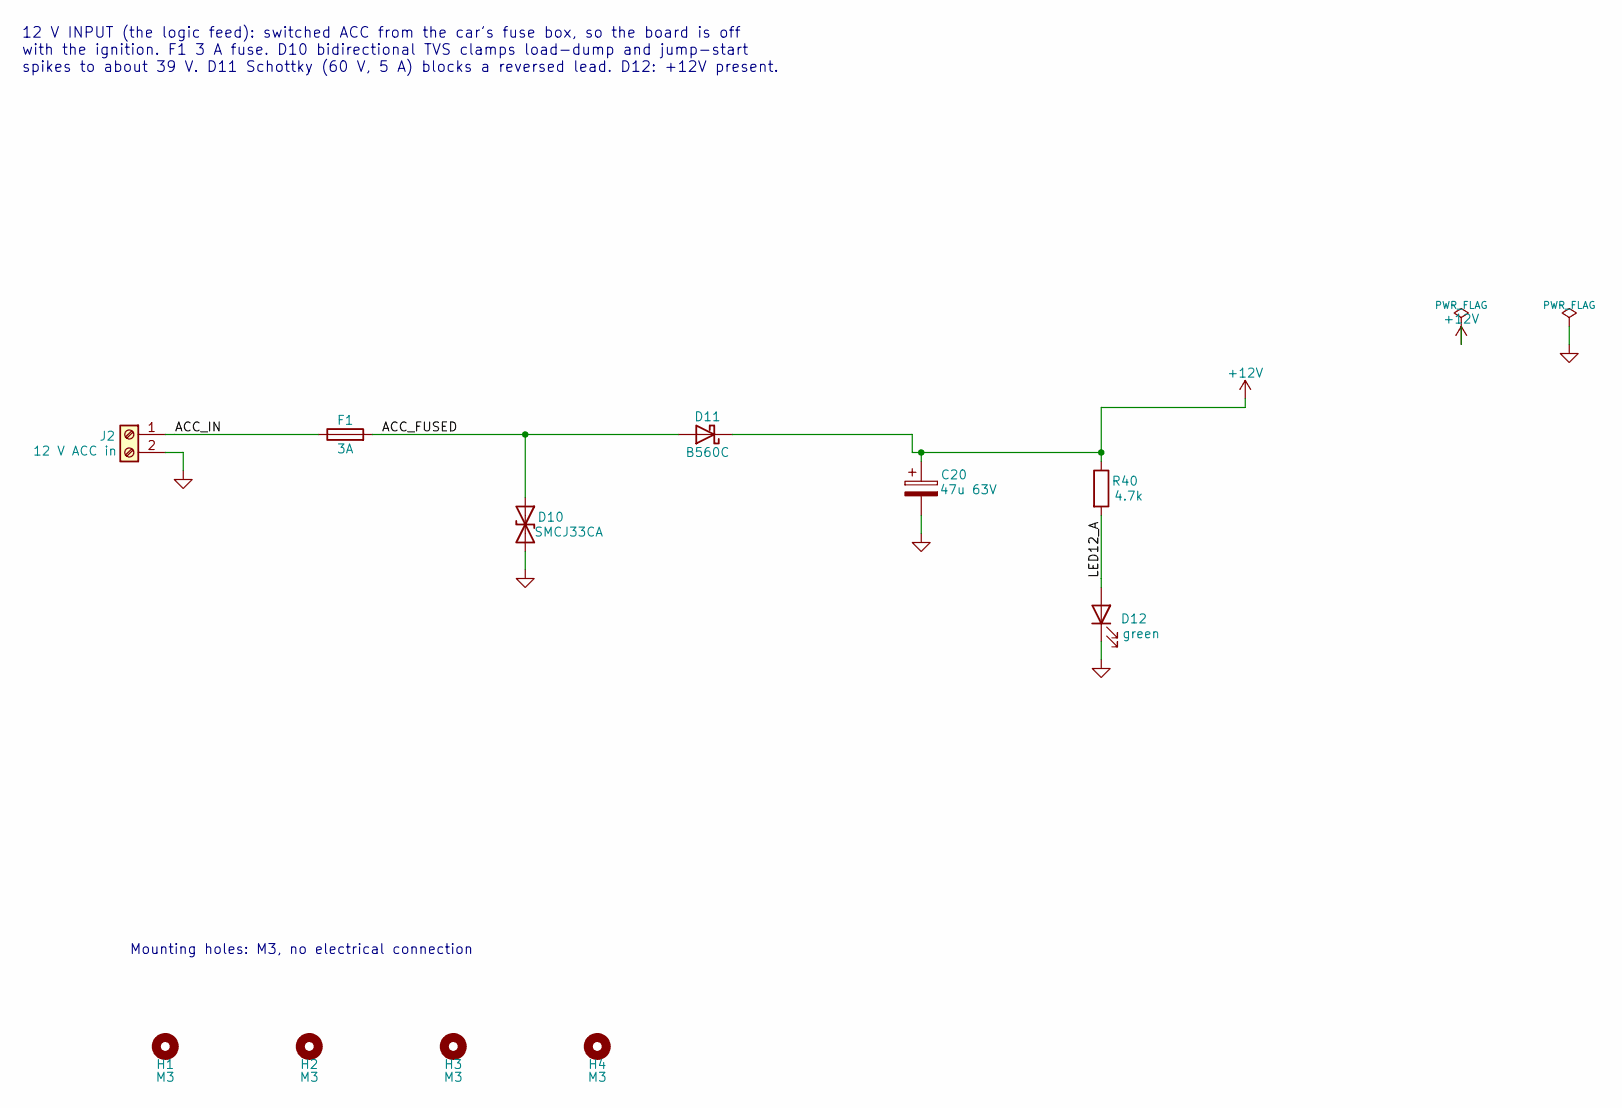
[picture p97: schematic input.kicad_sch, 12 V input and protection]

Parts:
C20: 47u 63V; CP_Radial_D8.0mm_P3.50mm
D10: SMCJ33CA; D_SMC
D11: B560C; D_SMC
D12: green; LED_0805_2012Metric
F1: 3A; Fuseholder_Blade_Mini_Keystone_3568
H1, H2, H3, H4: M3; MountingHole_3.2mm_M3
J2: 12 V ACC in; TerminalBlock_Phoenix_MKDS-1,5-2-5.08_1x02_P5.08mm_Horizont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
R40: 4.7k; R_0805_2012Metric

Connections:
+12V: C20.1, D11.1 (K), R40.1; also elsewhere on the board
/12 V input and protection/ACC_FUSED: D10.1 (A1), D11.2 (A), F1.2
/12 V input and protection/ACC_IN: F1.1, J2.1
/12 V input and protection/LED12_A: D12.2 (A), R40.2
GND: C20.2, D10.2 (A2), D12.1 (K), J2.2; also elsewhere on the board

Notes on the sheet:
12 V INPUT (the logic feed): switched ACC from the car's fuse box, so the board is off with the ignition. F1 3 A fuse. D10 bidirectional TVS clamps load-dump and jump-start spikes to about 39 V. D11 Schottky (60 V, 5 A) blocks a reversed lead. D12: +12V present.
Mounting holes: M3, no electrical connection
