kiogimwenda/AR_Windscreen/hardware/power_board/power_board.kicad_pcb

## KiCad design hardware/power_board/power_board.kicad_pcb (continued)

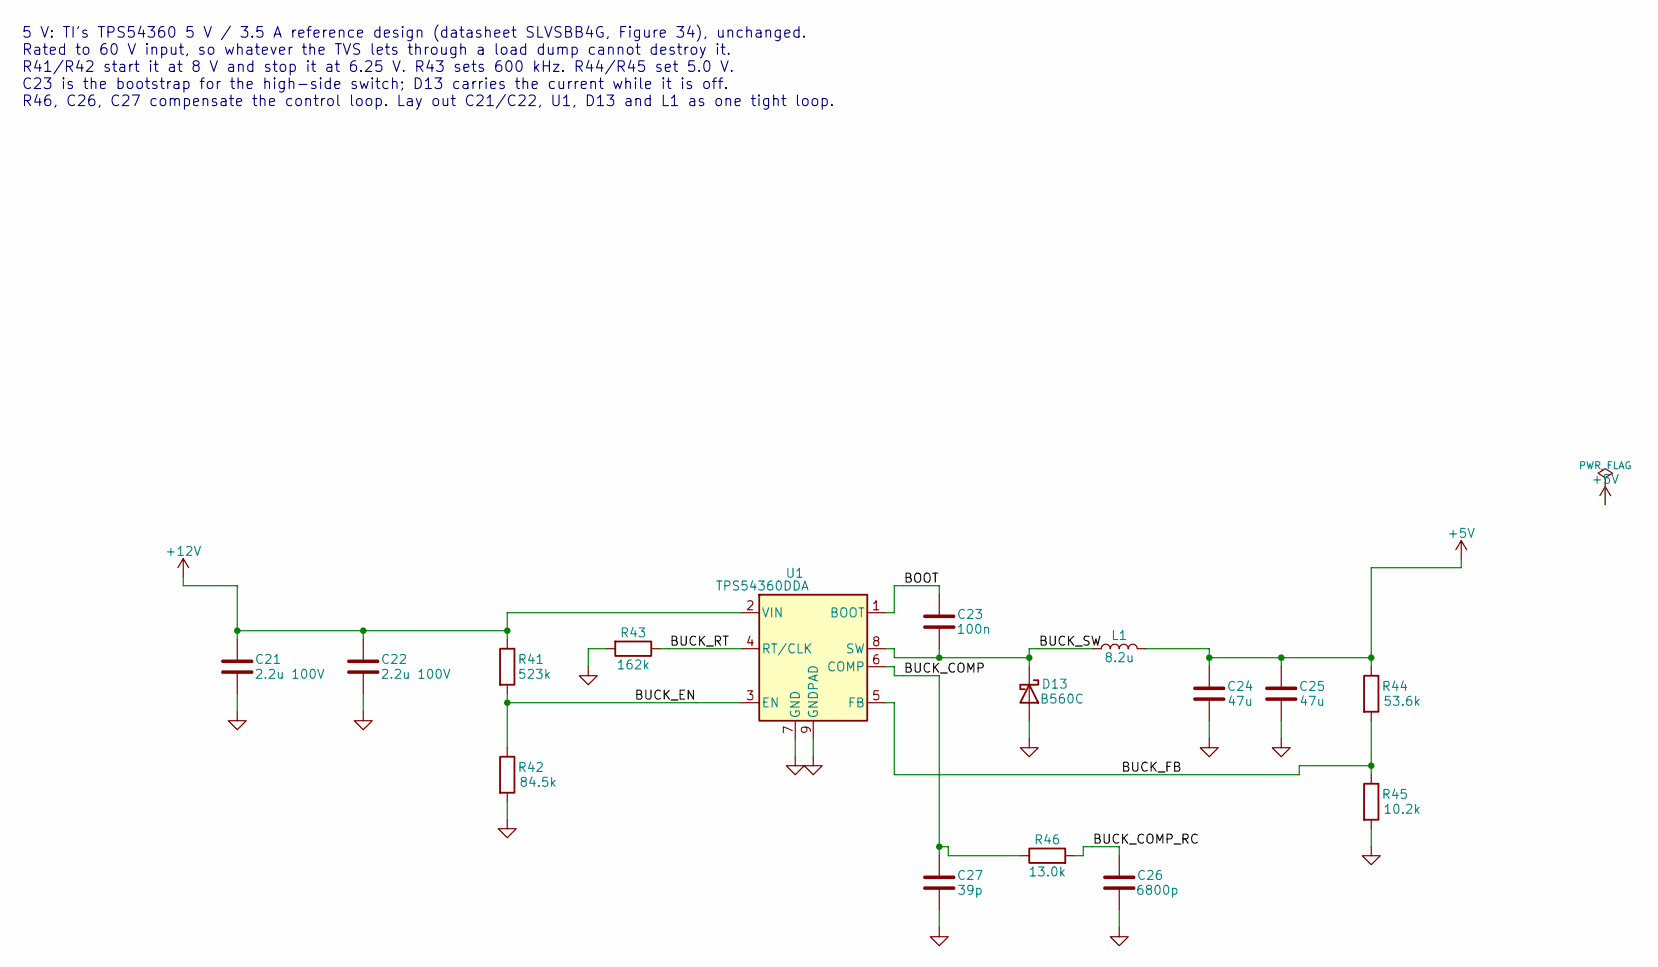
[picture p98: schematic buck.kicad_sch, 5 V converter (TPS54360, TI reference design)]

Parts:
C21, C22: 2.2u 100V; C_1210_3225Metric
C23: 100n; C_0805_2012Metric
C24, C25: 47u; C_1210_3225Metric
C26: 6800p; C_0805_2012Metric
C27: 39p; C_0805_2012Metric
D13: B560C; D_SMC
L1: 8.2u; L_Bourns_SRR1260
R41: 523k; R_0805_2012Metric
R42: 84.5k; R_0805_2012Metric
R43: 162k; R_0805_2012Metric
R44: 53.6k; R_0805_2012Metric
R45: 10.2k; R_0805_2012Metric
R46: 13.0k; R_0805_2012Metric
U1: TPS54360DDA; TI_SO-PowerPAD-8_ThermalVias

Connections:
+5V: C24.1, C25.1, L1.2, R44.1; also elsewhere on the board
+12V: C21.1, C22.1, R41.1, U1.2 (VIN); also elsewhere on the board
/5 V converter (TPS54360, TI reference design)/BOOT: C23.1, U1.1 (BOOT)
/5 V converter (TPS54360, TI reference design)/BUCK_COMP: C27.1, R46.1, U1.6 (COMP)
/5 V converter (TPS54360, TI reference design)/BUCK_COMP_RC: C26.1, R46.2
/5 V converter (TPS54360, TI reference design)/BUCK_EN: R41.2, R42.1, U1.3 (EN)
/5 V converter (TPS54360, TI reference design)/BUCK_FB: R44.2, R45.1, U1.5 (FB)
/5 V converter (TPS54360, TI reference design)/BUCK_RT: R43.1, U1.4 (RT/CLK)
/5 V converter (TPS54360, TI reference design)/BUCK_SW: C23.2, D13.1 (K), L1.1, U1.8 (SW)
GND: C21.2, C22.2, C24.2, C25.2, C26.2, C27.2, D13.2 (A), R42.2, R43.2, R45.2, U1.7 (GND), U1.9 (GNDPAD); also elsewhere on the board

Notes on the sheet:
5 V: TI's TPS54360 5 V / 3.5 A reference design (datasheet SLVSBB4G, Figure 34), unchanged. Rated to 60 V input, so whatever the TVS lets through a load dump cannot destroy it. R41/R42 start it at 8 V and stop it at 6.25 V. R43 sets 600 kHz. R44/R45 set 5.0 V. C23 is the bootstrap for the high-side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

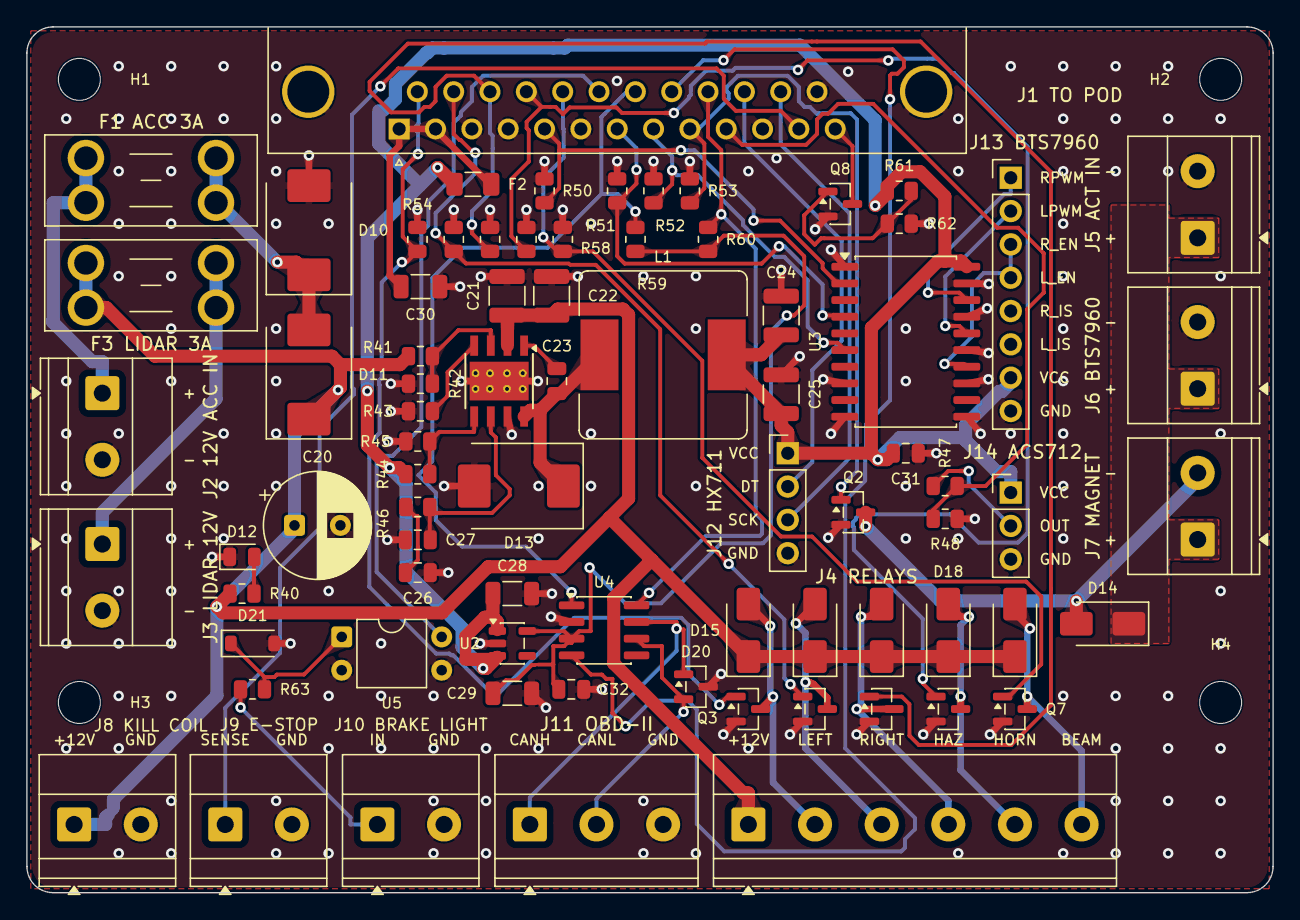
[picture p99: board power_board.kicad_pcb from above]

Board: 2 copper layers, 95.0 x 66.0 mm, 82 parts (0 on the bottom side), 50 nets.
