kiogimwenda/AR_Windscreen/host/config/decision_thresholds.yaml

# DecisionArbiter thresholds — see docs/BUILD_GUIDE.md Part 12.5.
# Conservative placeholders, tuned during Part 13 field testing, never guessed once and left alone.
ttc_brake_threshold_s: 1.8        # time-to-collision below which a brake request is emitted
hard_brake_decel_g: 0.4           # IMU deceleration threshold for hazard-lights-on
tailgating_min_gap_s: 1.0         # following-distance-in-seconds threshold
brake_actuator_max_intensity: 90  # must match BrakeActuatorDriver::kMaxSafeIntensity (Part 4.4).
                                  # test_decision_arbiter.cpp asserts no input combination ever
                                  # produces a BRAKE request above this value (Part 13.1), and
                                  # SystemManager refuses to start if it exceeds the hub's 90.
# Added in Phase 10 (Part 9.3):
brake_request_intensity: 60       # rule 1's requested intensity; <= brake_actuator_max_intensity.
                                  # A conservative placeholder, set on the bench in Part 13.3.
ego_path_half_width_m: 1.2        # an object counts as "in lane" within this of the ego path
                                  # (half the car's width plus a margin)
min_closing_speed_mps: 0.5        # below this closing speed no time-to-collision is computed
                                  # (a stopped car 30 m ahead at 0.1 m/s is not a 300 s TTC event)
brake_min_measured_track_ms: 200  # added 2026-10-07: rule 1 brakes only on a target measured by the
                                  # LiDAR without a break for this long (3 scans at 10 Hz). A track
                                  # that coasts and re-associates to another cluster starts again.
                                  # Cost: up to 200 ms on a truly sudden obstacle (1.7 m at 30 km/h).
                                  # Found on the KITTI replay (progress log); Ian to review.
brake_confirm_ms: 100             # added 2026-10-07: rule 1 STARTS braking only once its condition
                                  # has held on the same target on every cycle, and the LiDAR has
                                  # measured it again this long after it first qualified (a second
                                  # scan, at any camera rate; never a prediction). Once braking, it
                                  # continues while any target qualifies. Filters one-scan velocity
                                  # spikes and objects flickering across the path's edge (6 of 40
                                  # jittered KITTI replays). Cost: 100 ms (0.8 m at 30 km/h).
                                  # Ian to review.
hub_state_max_age_ms: 100         # a hub report older than this means "not known to be armed":
                                  # the hub reports at 50 Hz, so 100 ms is five missed reports
