kiogimwenda/AR_Windscreen/host/test/unit/test_motion_predictor.cpp

// Motion estimation and prediction tests — see docs/BUILD_GUIDE.md Part 9.1 and ImmFilter.h.
//
// Synthetic road users with known motion are measured at the LiDAR's 10 Hz with realistic
// position noise, and the IMM filter must recover their motion. Requirements are stated in each
// test BEFORE its numbers are known, derived from what the rest of the system needs. In
// particular, the closing-speed bound is required by Part 9.3 rule 1 (the brake rule uses the
// tracked closing speed).

#include <gtest/gtest.h>

#include <cmath>
#include <random>

#include "ar_drive_assist/safety/ImmFilter.h"
#include "ar_drive_assist/safety/MotionPredictor.h"

using namespace ar_drive_assist;

namespace {

constexpr double kPi = 3.14159265358979323846;
constexpr double kDt = 0.1;        // LiDAR rate
constexpr double kMeasStd = 0.15;  // m, mask-fused LiDAR position (Part 8.3), 1 sigma

struct Obj {
    double x = 0, y = 0, psi = 0, v = 0, w = 0, a = 0;  // a: longitudinal acceleration
    void step(double dt) {
        const double v0 = v;
        v = std::max(0.0, v + a * dt);
        const double vm = 0.5 * (v0 + v);
        if (std::abs(w) > 1e-9) {
            x += vm / w * (std::sin(psi + w * dt) - std::sin(psi));
            y += vm / w * (std::cos(psi) - std::cos(psi + w * dt));
        } else {
            x += vm * std::cos(psi) * dt;
            y += vm * std::sin(psi) * dt;
        }
        psi += w * dt;
    }
};

const Eigen::Matrix2d kR = Eigen::Matrix2d::Identity() * kMeasStd * kMeasStd;

double angErr(double a, double b) {
    return std::abs(ImmFilter::wrap(a - b));
}

}  // namespace

// A pedestrian walking at 1.4 m/s. Requirement: within 5 s, speed within 0.3 m/s and walking
// direction within 15 deg. That is what a crossing-conflict prediction (9.1.2) needs.
TEST(ImmFilter, PedestrianWalkingIsEstimated) {
    std::mt19937 rng(11);
    std::normal_distribution<double> n(0, kMeasStd);
    Obj o;
    o.v = 1.4;
    o.psi = 0.7;
    MotionNoise mn;
    mn.accelStd = 1.0;
    ImmFilter f({o.x + n(rng), o.y + n(rng)}, kR, mn);
    for (int k = 0; k < 50; ++k) {
        o.step(kDt);
        f.predict(kDt);
        f.updatePosition({o.x + n(rng), o.y + n(rng)}, kR);
    }
    const auto s = f.state();
    EXPECT_NEAR(s(3), 1.4, 0.3);
    EXPECT_LT(angErr(s(2), o.psi) * 180 / kPi, 15.0);
    EXPECT_LT((f.position() - Eigen::Vector2d(o.x, o.y)).norm(), 0.3);
}

// A parked car, i.e. no motion at all. Requirement: no phantom motion above 0.5 m/s after 3 s,
// because a phantom velocity on a parked car would create false crossing and cut-in warnings.
TEST(ImmFilter, StationaryObjectGetsNoPhantomVelocity) {
    std::mt19937 rng(12);
    std::normal_distribution<double> n(0, kMeasStd);
    ImmFilter f({n(rng), n(rng)}, kR, MotionNoise{});
    for (int k = 0; k < 30; ++k) {
        f.predict(kDt);
        f.updatePosition({n(rng), n(rng)}, kR);
    }
    EXPECT_LT(f.velocity().norm(), 0.5);
}

// A car in a steady turn (10 m/s, 0.3 rad/s: a 33 m radius). Requirement: the turning model
// becomes the most probable, and the estimated turn rate is within 0.05 rad/s. The predictor
// then extrapolates the curve instead of a straight line.
TEST(ImmFilter, TurningCarSelectsTheTurningModel) {
    std::mt19937 rng(13);
    std::normal_distribution<double> n(0, kMeasStd);
    Obj o;
    o.v = 10;
    o.w = 0.3;
    ImmFilter f({n(rng), n(rng)}, kR, MotionNoise{}, 0.0);
    for (int k = 0; k < 60; ++k) {
        o.step(kDt);
        f.predict(kDt);
        f.updatePosition({o.x + n(rng), o.y + n(rng)}, kR);
    }
    const auto& mu = f.modelProbabilities();
    EXPECT_GT(mu[int(MotionModel::CTRV)], mu[int(MotionModel::CV)]);
    EXPECT_GT(mu[int(MotionModel::CTRV)], mu[int(MotionModel::STOP)]);
    EXPECT_NEAR(f.state()(4), 0.3, 0.05);
}

// The Part 9.3 closing-speed bound. A lead vehicle cruises at 15 m/s, then brakes hard at 6 m/s^2.
// Requirements (fixed before running):
//   steady state: speed error < 1 m/s (under 10% of cruise, for a usable TTC);
//   braking: within 0.5 s of onset, the estimate within 2 m/s of the truth, and the STOP model's
//   probability clearly above its cruising level (the "sudden braking" warning signal, 9.2).
TEST(ImmFilter, ClosingSpeedBoundDuringCruiseAndHardBraking) {
    std::mt19937 rng(14);
    std::normal_distribution<double> n(0, kMeasStd);
    Obj o;
    o.v = 15;
    ImmFilter f({n(rng), n(rng)}, kR, MotionNoise{}, 0.0);
    double cruiseStopProb = 0;
    for (int k = 0; k < 40; ++k) {  // 4 s cruise
        o.step(kDt);
        f.predict(kDt);
        f.updatePosition({o.x + n(rng), o.y + n(rng)}, kR);
    }
    EXPECT_LT(std::abs(f.state()(3) - o.v), 1.0) << "steady-state closing-speed error";
    cruiseStopProb = f.modelProbabilities()[int(MotionModel::STOP)];

    o.a = -6.0;
    for (int k = 0; k < 5; ++k) {  // 0.5 s of braking
        o.step(kDt);
        f.predict(kDt);
        f.updatePosition({o.x + n(rng), o.y + n(rng)}, kR);
    }
    EXPECT_LT(std::abs(f.state()(3) - o.v), 2.0)
        << "estimate " << f.state()(3) << " vs truth " << o.v << " 0.5 s into braking";
    EXPECT_GT(f.modelProbabilities()[int(MotionModel::STOP)], 2.0 * cruiseStopProb);
}

// Consistency (9.1.3): when the truth moves with exactly the random acceleration the filter
// assumes, the innovation NIS must follow a chi-square distribution with 2 degrees of freedom
// (mean 2). The bounds allow sampling spread over ~500 updates plus the IMM's model mixing. A mean
// far ABOVE 2 would mean overconfidence, the dangerous direction for a predicted region.
TEST(ImmFilter, InnovationIsConsistent) {
    std::mt19937 rng(15);
    std::normal_distribution<double> n(0, kMeasStd), g(0, 1);
    MotionNoise mn;
    mn.accelStd = 1.0;
    Obj o;
    o.v = 5;
    ImmFilter f({n(rng), n(rng)}, kR, mn, 0.0);
    double nisSum = 0;
    int cnt = 0;
    for (int k = 0; k < 600; ++k) {
        o.a = mn.accelStd * g(rng);  // white acceleration, as modelled
        o.psi += mn.headingDriftStd * std::sqrt(kDt) * g(rng) * 0.3;
        o.step(kDt);
        f.predict(kDt);
        const double nis = f.updatePosition({o.x + n(rng), o.y + n(rng)}, kR);
        if (k > 50) {
            nisSum += nis;
            ++cnt;
        }
    }
    const double mean = nisSum / cnt;
    EXPECT_GT(mean, 1.4) << "filter is over-cautious";
    EXPECT_LT(mean, 2.6) << "filter is overconfident";
}

// An L-shape fit reports heading only modulo 180 deg. A measurement that is the reverse of the true
// heading must be read as the true heading, not flip the car around.
TEST(ImmFilter, HeadingMeasurementModPiDoesNotFlipTheVehicle) {
    ImmFilter f({0, 0}, kR, MotionNoise{}, 0.2);
    for (int k = 0; k < 10; ++k) f.updateHeadingModPi(0.2 + kPi, 0.05);  // reversed
    EXPECT_LT(angErr(f.state()(2), 0.2), 0.05);
}

// The CTRV straight-line branch and the curved branch must agree near omega = 0.
TEST(ImmFilter, TurnModelIsContinuousAtZeroTurnRate) {
    ImmFilter::State x;
    x << 0, 0, 0.3, 12, 0;
    const auto a = ImmFilter::propagate(MotionModel::CTRV, x, 0.1, 0.8);
    x(4) = 2e-4;
    const auto b = ImmFilter::propagate(MotionModel::CTRV, x, 0.1, 0.8);
    EXPECT_NEAR(a(0), b(0), 1e-3);
    EXPECT_NEAR(a(1), b(1), 1e-3);
    EXPECT_TRUE(a.allFinite() && b.allFinite());
}

// Model probabilities stay a valid distribution, and none reaches exactly 0.
TEST(ImmFilter, ModelProbabilitiesStayValid) {
    std::mt19937 rng(16);
    std::normal_distribution<double> n(0, kMeasStd);
    ImmFilter f({0, 0}, kR, MotionNoise{});
    for (int k = 0; k < 200; ++k) {
        f.predict(kDt);
        f.updatePosition({1.0 * k * kDt + n(rng), n(rng)}, kR);
        double s = 0;
        for (double m : f.modelProbabilities()) {
            ASSERT_GT(m, 0.0);
            s += m;
        }
        ASSERT_NEAR(s, 1.0, 1e-9);
    }
}

// Heading AT the +-180 deg wrap: a vehicle driving due west. The sigma points and the IMM's
// mixture straddle +-180 deg, so any plain (non-circular) average of headings pulls the estimate
// towards 0 deg, i.e. east, backwards. Found by a mutation test: every other test here heads at
// 0-103 deg and never exercises the wrap. In the real car, west-bound traffic is half of all
// traffic.
TEST(ImmFilter, WestboundVehicleAtTheHeadingWrap) {
    std::mt19937 rng(17);
    std::normal_distribution<double> n(0, kMeasStd);
    Obj o;
    o.v = 10;
    o.psi = kPi - 0.01;  // just under +180 deg
    o.w = 0.02;          // drifting across the wrap during the run
    ImmFilter f({n(rng), n(rng)}, kR, MotionNoise{}, o.psi);
    for (int k = 0; k < 50; ++k) {
        o.step(kDt);
        f.predict(kDt);
        f.updatePosition({o.x + n(rng), o.y + n(rng)}, kR);
    }
    EXPECT_LT(angErr(f.state()(2), o.psi) * 180 / kPi, 5.0)
        << "heading " << f.state()(2) << " vs truth " << ImmFilter::wrap(o.psi);
    EXPECT_NEAR(f.state()(3), 10.0, 0.5);
    EXPECT_LT((f.position() - Eigen::Vector2d(o.x, o.y)).norm(), 0.5);
}

// Regression test for a bias found while testing the tracker. With symmetric model-switching
// rates, the STOP model kept ~17% probability at steady cruise (the measurements cannot rule it out
// for a slow object) and dragged the blended speed ~9% low, even with PERFECT measurements. With
// exact data the estimate must converge to the truth.
TEST(ImmFilter, CruisingSpeedIsUnbiasedWithExactMeasurements) {
    for (double v : {1.4, 10.0}) {  // a pedestrian and a car
        ImmFilter f({0, 0}, kR, MotionNoise{}, 0.0);
        f.initialiseVelocity({v, 0}, Eigen::Matrix2d::Identity() * 0.01);
        double x = 0;
        for (int k = 0; k < 100; ++k) {
            x += v * kDt;
            f.predict(kDt);
            f.updatePosition({x, 0}, kR);
        }
        EXPECT_NEAR(f.state()(3), v, 0.05 * v) << "speed " << v;
        EXPECT_LT(f.modelProbabilities()[int(MotionModel::STOP)], 0.05) << "speed " << v;
    }
}

// =============================================================================================
// MotionPredictor: predicted paths, closest point of approach, collision probability (9.1.2).
// Requirements come from what the display and warnings need. None of this ever reaches the brake
// (Part 9.3).
// =============================================================================================
namespace {

constexpr int kVeh = 0, kPed = 1;

MotionNoise vehicleNoise() {  // config/motion_prediction.yaml, class "vehicle"
    return MotionNoise{3.0, 0.6, 0.1, 0.8, 0.5, 0.05, 8.0};
}
MotionNoise pedestrianNoise() {  // class "pedestrian"
    return MotionNoise{1.5, 1.0, 0.8, 0.5, 1.0, 0.05, 2.0};
}

// An established track, built the way the tracker builds one: the filter follows the object for
// 2 s of noisy 10 Hz measurements (two-point velocity initialisation on the second), ending at
// `pos` moving with `vel`. A brand-new filter would still carry its birth uncertainty.
Track makeTrack(int id, int cls, Eigen::Vector2d pos, Eigen::Vector2d vel, MotionNoise n) {
    std::mt19937 rng(100 + id);
    std::normal_distribution<double> g(0, kMeasStd);
    auto at = [&](int k) { return Eigen::Vector2d(pos + vel * (k - 20) * kDt); };
    auto noisy = [&](Eigen::Vector2d p) { return Eigen::Vector2d(p.x() + g(rng), p.y() + g(rng)); };
    Eigen::Vector2d prev = noisy(at(0));
    ImmFilter f(prev, kR, n);
    for (int k = 1; k <= 20; ++k) {
        const Eigen::Vector2d z = noisy(at(k));
        f.predict(kDt);
        if (k == 1) f.initialiseVelocity((z - prev) / kDt, 2 * kR / (kDt * kDt));
        f.updatePosition(z, kR);
    }
    return Track{id, cls, TrackState::CONFIRMED, f, 21, 0, 0, 0, {}, {}};
}

// Ego car at the origin heading east at v, as SensorFusion would report it.
ImmFilter::State egoState(double v, double psi = 0) {
    ImmFilter::State x;
    x << 0, 0, psi, v, 0;
    return x;
}
ImmFilter::Cov egoCov() {
    ImmFilter::Cov P = ImmFilter::Cov::Zero();
    P.diagonal() << 0.3 * 0.3, 0.3 * 0.3, 0.02 * 0.02, 0.3 * 0.3, 0.02 * 0.02;
    return P;
}

}  // namespace

// Hand-computed cases of t* = -(r.v)/|v|^2, d* = |r + v t*|.
TEST(MotionPredictor, ClosestPointOfApproachHandCases) {
    double t, d;
    MotionPredictor::cpa({30, 0}, {-20, 0}, t, d);  // head-on, closing at 20 m/s
    EXPECT_NEAR(t, 1.5, 1e-12);
    EXPECT_NEAR(d, 0.0, 1e-12);
    MotionPredictor::cpa({20, -10}, {-10, 5}, t, d);  // crossing, exact collision course
    EXPECT_NEAR(t, 2.0, 1e-12);
    EXPECT_NEAR(d, 0.0, 1e-12);
    MotionPredictor::cpa({0, 3.5}, {0, 0}, t, d);  // same speed, next lane: nothing changes
    EXPECT_EQ(t, 0.0);
    EXPECT_NEAR(d, 3.5, 1e-12);
    MotionPredictor::cpa({10, 0}, {5, 0}, t, d);  // pulling away: closest is now
    EXPECT_EQ(t, 0.0);
    EXPECT_NEAR(d, 10.0, 1e-12);
}

double maha2(const PredictedPoint& p, const Eigen::Vector2d& truth) {
    const Eigen::Vector2d d = truth - p.mean;
    return d.dot(p.cov.inverse() * d);
}

// Requirement: the ribbon is HONEST. The true future position lies inside the predicted
// uncertainty, and the uncertainty grows with the horizon (never narrows); by 2 s it is clearly
// wider than at 1 s. (A first version demanded the mean within 0.15 m at 1 s. After 2 s of noisy
// measurements the walker's speed is only known to ~0.3 m/s, so that was tighter than the
// filter's own knowledge; replaced 2026-09-26 by this consistency requirement.)
TEST(MotionPredictor, StraightPathTruthInsideGrowingUncertainty) {
    const MotionPredictor mp;
    const Track tr = makeTrack(1, kPed, {10, -3}, {0, 1.4}, pedestrianNoise());
    const auto p = mp.predict(tr, {0.5, 1.0, 1.5, 2.0});
    ASSERT_EQ(p.size(), 4u);
    for (const auto& q : p) EXPECT_LT(maha2(q, {10, -3 + 1.4 * q.t}), 9.21) << "t " << q.t;
    for (size_t i = 1; i < p.size(); ++i) EXPECT_GT(p[i].cov.trace(), p[i - 1].cov.trace());
    EXPECT_GT(std::sqrt(p[3].cov.trace()), 1.5 * std::sqrt(p[1].cov.trace()));
}

// The same over 100 independently measured walkers: at least 90% of true 1 s positions must fall
// inside the predicted 95% ellipse (chi-square 2 dof: 5.99). Fewer means over-confident ribbons.
TEST(MotionPredictor, PredictedUncertaintyIsCalibrated) {
    const MotionPredictor mp;
    int inside = 0;
    for (int id = 1; id <= 100; ++id) {
        const double dir = 0.063 * id;
        const Eigen::Vector2d vel(1.4 * std::cos(dir), 1.4 * std::sin(dir));
        const Track tr = makeTrack(id, kPed, {12, 2}, vel, pedestrianNoise());
        inside += maha2(mp.predict(tr, {1.0})[0], Eigen::Vector2d(12, 2) + vel) < 5.99;
    }
    EXPECT_GE(inside, 90);
}

// Reported speed is never negative, and the heading faces the way the walker actually moves.
TEST(MotionPredictor, ReportedMotionFacesForwards) {
    const Track tr = makeTrack(1, kPed, {10, -3}, {0, 1.4}, pedestrianNoise());
    const auto s = tr.filter.state();
    EXPECT_GE(s(3), 0.0);
    EXPECT_LT(std::abs(ImmFilter::wrap(s(2) - kPi / 2)), 0.7);  // ~2 sigma of the heading
    EXPECT_GT(tr.filter.velocity().y(), 0.8);
}

// A car in a steady 0.3 rad/s turn at 10 m/s (a roundabout). Requirement: the 1 s prediction must
// follow the arc, with less than half the error of a straight-line extrapolation (which misses by
// ~1.5 m sideways). This is why the IMM carries a turning model.
TEST(MotionPredictor, TurningCarIsPredictedAlongTheArc) {
    Obj o;
    o.v = 10;
    o.w = 0.3;
    ImmFilter f({o.x, o.y}, kR, vehicleNoise());
    for (int k = 0; k < 30; ++k) {
        const Eigen::Vector2d prev(o.x, o.y);
        o.step(kDt);
        f.predict(kDt);
        if (k == 0)
            f.initialiseVelocity(
                (Eigen::Vector2d(o.x, o.y) - prev) / kDt,
                Eigen::Matrix2d::Identity() * 2 * kMeasStd * kMeasStd / (kDt * kDt));
        f.updatePosition({o.x, o.y}, kR);
    }
    const Track tr{1, kVeh, TrackState::CONFIRMED, f, 30, 0, 0, 0, {}, {}};
    const Eigen::Vector2d now(o.x, o.y), vel(o.v * std::cos(o.psi), o.v * std::sin(o.psi));
    Obj future = o;
    for (int k = 0; k < 10; ++k) future.step(kDt);
    const Eigen::Vector2d truth(future.x, future.y);
    const double straightErr = (now + vel - truth).norm();
    const double predErr = (MotionPredictor().predict(tr, {1.0})[0].mean - truth).norm();
    EXPECT_GT(straightErr, 1.2);
    EXPECT_LT(predErr, 0.5 * straightErr) << "pred " << predErr << " straight " << straightErr;
}

TEST(MotionPredictor, EgoPredictionFollowsSensorFusionState) {
    const auto p = MotionPredictor().predictEgo(egoState(10), egoCov(), {1.0, 2.0});
    EXPECT_LT((p[0].mean - Eigen::Vector2d(10, 0)).norm(), 0.05);
    // At 2 s the mean sits ~0.17 m short: with an uncertain yaw rate the possible positions form
    // an arc-shaped band whose average lies inside the arc. The truth must be inside the ellipse.
    EXPECT_LT(maha2(p[1], {20, 0}), 9.21);
    EXPECT_GT(p[1].cov.trace(), p[0].cov.trace());
}
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
