kiogimwenda/AR_Windscreen/(commit log)

2026-09-18 Phase 0: scaffold repository structure and verify build environment
    Create the full directory tree from the build guide's Part 1 with stub
    files throughout, so the structure stays stable while individual files
    are filled in phase by phase. Every stub names the guide Part that
    specifies it and the phase that implements it.
    Includes the CI workflow, the shared protocol headers as identical
    firmware/host pairs so the sync check is meaningful from the start, the
    config templates the guide specifies literally, and a clang-format style
    the CI format job would otherwise enforce by accident.
    Three fixes to guide-specified build configuration were needed to get
    cmake and pio run passing, all record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
    [ArRenderer.h, BrakeActuatorDriver.cpp, BrakeActuatorDriver.h]
2026-09-19 Record Phase 0 check 4 as blocked on hardware procurement
    The camera check was logged as pending a Windows-side usbipd attach,
    which implied a camera existed. No project hardware has been purchased
    yet, which blocks the exit criteria of eight later phases outright and
    partially blocks two more.
2026-09-19 Phase 1: shared host/hub protocol and CRC, with tests on both sides
    Implement Protocol.h and Crc16.h as byte-for-byte identical copies under
    firmware/ and host/, per Part 3.
    Beyond Part 3.1's literal text, four additions in service of the
    "identical on both ends" requirement:
    - static_assert on every struct size, so a layout disagreement between
    the ARM and x86-64 toolchains is a build failure rather than the hub
    misreading a command on a bench. Negative-tested on the ARM
    cross-compile.
    - Frame geometry constants derived from the frame diagram, so the
    CRC-covered range is defined once instead of re-derived in both
    VehicleInterface and CommsTask.
    - <cstddef>, which Part 3.1's snip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
    [Crc16.h, HubProtocol.h, Protocol.h, test_crc16.cpp]
2026-09-24 Add hardware bill of materials with Kenyan sourcing
    Lists every hardware item referenced by Parts 4, 6, 8, 13.3 and 15 with
    local suppliers, prices and stock as of 2026-09-24, an import bundle for
    items not sold locally, and a budget summary. Flags the brake actuator as
    blocked on a mechanical design decision, since locally sold lead-screw
    actuators hold position when unpowered.
2026-09-24 Phase 3 (software part): message bus, event log, system manager
    RingBuffer SPSC message bus, FlatBuffers bus schemas generated at build
    time, EventLog with crash- and power-loss-durable actuation lines, and
    SystemManager with validated config loading, ordered shutdown that sends
    the final zeroed command after every subsystem has stopped, and
    async-signal-safe crash handling. 51 unit tests, multi-threaded ones clean
    under ThreadSanitizer.
    Also links OSRM with its full dependency list, guards against flatc and
    FlatBuffers header version mismatch, and removes libosrm-dev from CI,
    which does not exist on Ubuntu. VehicleInterface and the Phase 3 exit
    test wait for the Phase 2 hub.
    [RingBuffer.h, Types.h, main.cpp, test_event_log.cpp]
2026-09-26 Phase 5: TensorRT inference pipeline with segmentation masks
    Four TensorRT engines (YOLOv8m-seg, UFLDv2 CULane, MiDaS v2.1 Small, and the
    road-sign detector) with fixed-shape ONNX exports verified against PyTorch.
    - TrtEngine: TensorRT 10 name-based API, per-engine non-blocking CUDA
    streams, pinned host outputs, enqueue/sync split so models overlap.
    - GPU pre-processing (letterbox, band crop, normalisation, NCHW split) on
    each engine's stream.
    - Output decoding: YOLO boxes with class-mapped NMS (pedestrians never
    suppressed by other classes), YOLOv8-seg prototype masks, UFLDv2 lanes.
    - MlInferenceEngine: event-ordered upload, concurrent inference, detection,
    depth and mask buses (ma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
    [MlInferenceEngine.h, Postprocess.h, Preprocess.h]
2026-09-26 Road-sign detector: MTSD preparation, training, evaluation and report
    A fourth model (YOLOv8s fine-tuned on the Mapillary Traffic Sign Dataset,
    29 classes including one per speed-limit value), added because COCO knows
    only stop signs and traffic lights.
    - prepare_mtsd.py maps 401 MTSD labels onto 29 classes; horizontal-flip
    augmentation is disabled because it swaps left/right sign meanings.
    - train_sign_detector.py supports time budgets and early stopping.
    - Evaluation tooling for folders and video, openly licensed Kenyan imagery
    fetchers (KartaView, Wikimedia Commons), and results/progress viewers.
    Final model (epoch 53 of 60, full data): mAP50 0.716, mAP50-95 0.572,
    engine 2.48 ms. K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
    [align_csv.py, eval_sign_detector.py, extract_growing_zip.py, fetch_commons_kenya.py, fetch_kenya_imagery.py, prepare_mtsd.py, show_results.py, train_sign_detector.py]
2026-09-26 Guide amendments: AR overlay design, LiDAR fusion, motion prediction
    - Part 7.1: model table brought up to date (YOLOv8m-seg, sign detector,
    actual lane and depth models and sizes).
    - Part 10: overlays rendered on the GPU from an OverlayScene draw list;
    hazards shown with road-placed elements and a risk-coloured shimmering
    glow instead of boxes (docs/architecture/ar-overlay-design.md).
    - Part 8.3: mask-based camera-LiDAR fusion; unexplained LiDAR obstacles
    stay obstacles.
    - Part 12.2.1: startup and continuous LiDAR-camera extrinsic verification
    with bounded refinement; LiDAR-only ranges when degraded.
    - Part 9.1: IMM tracker and motion predictor with closest-point-of-approach
    ris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
2026-09-26 Sign engine integration and Phase 7 fusion, tracking and prediction
    Sign detector:
    - integrated as the fourth inference engine
    - v3 preparation: prepare_mtsd.py --mask-ignored greys out ambiguous signs
    - training script options for the retrain
    Phase 7 (software; the hardware sanity check is still open):
    - SensorFusion: 5-state CTRV EKF (GPS, OBD speed, gyro, compass), Joseph-form updates
    - Hungarian assignment
    - ImmFilter: CV/CTRV/STOP IMM with UKF prediction, asymmetric switching rates,
    two-point velocity initialisation, positive-speed reporting
    - MultiObjectTracker: world-frame tracking, class gating, track lifecycle,
    late-batch replay
    - MotionPredictor: predicted paths with uncertain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
2026-09-26 Guide: three-layer navigation road status, Nairobi 100 km map area
    Part 11.2.1: nightly-refreshed OSM base, TomTom live layer behind a
    provider-neutral adapter (gated on access, quality and terms checks),
    own sensors override the map. Nothing from a map reaches braking.
    Phase 8 deliverables and exit criteria extended accordingly.
2026-09-26 Phase 8: navigation - offline Nairobi routing, map matching, road status
    - refresh_osm.sh: Geofabrik Kenya (MD5-checked), clipped to 100 km around
    Nairobi CBD, OSRM MLD build, CBD->Thika smoke test, atomic switch
    - common/Geo.h: WGS-84 local tangent plane shared by SensorFusion and
    MapMatcher (fixes a 0.67% north-south scale error in the old frame)
    - NavigationEngine: full geometry, steps, lanes, OSM node ids; departure
    constrained to the direction of travel
    - MapMatcher: OSRM Match on a trace window, 10 Hz throttle, monotonic
    progress, dead reckoning, off-route and wrong-way confirmation; logic
    behind a MatchBackend so CI tests it without OSRM
    - RoadStatus + RoadNetworkUpdater: se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
    [Geo.h, MapMatcher.h, NavigationEngine.h]
2026-09-27 Phase 9: road-surface projector; sign detector v3 evaluated and rejected
    Phase 9 (software; the real-road check needs the hardware):
    - RoadSurfaceProjector: route geometry ahead of the matched progress,
    placed from the fused pose; lane correction of heading (whole line) and
    lateral lane position (current road, tapered after the next turn),
    rate-capped per frame, decaying without lanes; heights from the measured
    LiDAR patch, plane, or flat fallback; projection through the shared camera
    - common/Camera.h: one camera model for fusion and projection, with an
    iterative inverse distortion; GroundPlaneModel type defined
    - road_projected_route.fbs: vehicle-frame points and pose timestamp a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
    [Camera.h, GroundPlaneModel.h, RoadSurfaceProjector.h, SceneReconstruction.h, test_road_surface_projector.cpp]
2026-09-27 Phase 10: reckless-driving detector and decision arbiter; tracker fixes
    - RecklessDrivingDetector (Part 9.2): shared ego-frame computation, seven
    rules (tailgating, erratic speed, swerving, sudden braking, crossing,
    forward-collision warning, vulnerable road user in path), risk r and level
    - DecisionArbiter (Part 9.3): the four rules, with rule 1's conditions made
    explicit (armed state, confirmed track, LiDAR-measured range, ego path,
    finite values, front-bumper gap); triple brake-intensity clamp; evidence
    trail of every request and release
    - Config: brake_request_intensity and arbiter keys, bumper distance and
    half width, per-class max speed; SystemManager rejects a ceiling abov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
    [ImmFilter.h, MultiObjectTracker.h, RecklessDrivingDetector.h]
2026-09-27 Phase 11: GPU AR renderer and display; recorded-drive map-matching check
    - WindowedSink (SDL2 + OpenGL 3.3 on the RTX 5060 through Mesa D3D12,
    selected explicitly): PBO video upload, road-space items projected in
    the vertex shader with the calibrated camera model (with distortion,
    perspective-correct), hazard mask glow with shimmer, depth-aware
    occlusion (rule 4), cached labels and badges, GPU timers, capture()
    - ArRenderer + SignTracker: route band (measured vs far-field opacity,
    speed and a = v^2/2d grading, ego-motion shift to the frame's capture
    time), hazards, signs by priority (confirmation, speed-value agreement,
    left-hand traffic, persistence), HUD
    - tools/render_bench: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
    [ArRenderer.h, DisplaySink.h, MapMatcher.h, OverlayScene.h]
2026-10-06 Phase 12 preparation and two-box hub redesign
    Hub firmware for the actuator bench gate, written before any hardware:
    SafetyCore (every actuation safety rule, hardware-free, tested natively
    with a 600,000-event fuzz), frame parser resynchronisation, the bench
    build's telemetry and tools/bench_rig/log_actuator_bench.py.
    Two-box hub (BUILD_GUIDE Part 4.8): a windscreen pod (STM32F405, camera,
    IMU, GNSS) and an under-dash power box joined by a 25-way cable, every
    line of which defaults to off in hardware; roof LiDAR tilted 15 degrees.
    - OBD-II read straight from the car's CAN bus (ObdCan.h), listening
    before ever transmitting; ELM327 kept as a build-time fallback.
    - Power-box presence: fault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
    [BrakeActuatorDriver.cpp, BrakeActuatorDriver.h, Config.h]
2026-10-06 Phase 12B part 1: hub PCB schematics, generated and checked
    KiCad 10 schematics for the windscreen pod board and the under-dash
    power board (BUILD_GUIDE 4.8), generated from Python descriptions in
    hardware/gen and verified by hardware/gen/check.sh:
    - KiCad ERC: 0 violations on both boards;
    - check_nets.py, 101 checks: every Config.h pin on the right STM32 pin,
    all 25 DB-25 pins on both boards against the guide's 4.8.3 table,
    series resistors, safe-reading pull-ups, every fail-safe pull on the
    power board, no single-connection nets, footprints present;
    - the checker catches a misassigned pin, a missing pull-down and
    swapped cable pins (tested by breaking the design on purpose).
    Schem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
    [pod_board.kicad_sch, pod_board_bom.csv, power_board.kicad_sch, power_board_bom.csv]
2026-10-06 Hub SensorReports into the EKF; acceleration as a control input
    fusion/HubReportFeeder turns each 50 Hz SensorReport into the EKF's
    steps at each sensor's own rate: GNSS only on a new fix, OBD speed at
    most every 100 ms (NaN skipped, GNSS speed as fallback), gyro every
    report and compass at most once a second through ImuMount, time from
    the hub clock with resets and long gaps not predicted across. It also
    provides egoState() and updateHubState() for the tracker and arbiter.
    SensorFusion::predict(dt, a): the IMU's measured longitudinal
    acceleration as a control input (accelInputStd 1.5 m/s^2, chosen by a
    sweep). Braking lag in a simulated drive: 1.13 -> 0.17 m/s, with a
    3 % grade's bias on t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
    [HubProtocol.h, HubReportFeeder.h, Protocol.h, SensorFusion.h]
2026-10-06 VehicleInterface, tested against a simulated hub running the firmware's SafetyCore
    vehicle/VehicleInterface: termios serial link; heartbeats every 50 ms;
    the arbiter's requests as ActuationCommands, a zeroed command when no
    new request arrives for 150 ms, a 300 ms hold on brake commands;
    SensorReports to HubReportFeeder and HubState; acks logged when they
    show the brake applied or the hub's state changes; report gaps logged;
    crash frame registered; final zeroed command after all threads join.
    main starts it (--serial, --no-hub) and feeds the EKF.
    vehicle/FrameDecoder: the host's own codec, cross-tested against the
    firmware's byte for byte.
    tools/hub_sim: the firmware's SafetyCore and Frame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
    [FrameDecoder.h, HubSim.cpp, HubSim.h, VehicleInterface.h, main.cpp, test_vehicle_interface.cpp]
2026-10-06 Ignore KiCad's local history and lock files
2026-10-07 Board outlines, LiDAR roof mount and power-box enclosure
    Shared board outlines (gen/outlines.py) generate the starter KiCad PCBs and
    enclosures/common/boards.scad. OpenSCAD models for the LiDAR roof mount and
    the power-box chassis, with 1:1 drilling templates generated from their hole
    lists. Guide, BOM, decisions and progress log updated for the board sizes
    and the larger power box.
    [base_plate_2d.dxf, boards.scad, chassis.stl, lidar_mount.scad, pod_board.kicad_pcb, power_board.kicad_pcb, power_box.scad, top_plate_2d.dxf]
2026-10-07 Power board schematic redrawn as wired sheets under a block diagram
    kisheet.py writes hierarchical KiCad sheets with parts placed by hand and
    wires routed between pins; power_board_drawing.py lays out eight function
    sheets and the root block diagram. check.sh also builds the label-only
    version and requires identical netlists (compare_nets.py).
    Fixes check_nets.py reading no components from KiCad 10 netlists, which
    made the footprint check pass with nothing to check.
    [actuator.kicad_sch, buck.kicad_sch, cable.kicad_sch, can.kicad_sch, input.kicad_sch, pod_board.kicad_sch, power_board.kicad_sch, rails.kicad_sch]
2026-10-07 Pod board schematic redrawn as wired sheets; duplicate references fixed
    pod_board_drawing.py draws six sheets around an MCU sheet under a block
    diagram; check.sh now compares both boards' drawn and label-only netlists.
    kisheet.py: stacked pins, PWR_FLAGs on signal nets, column hints for
    crossing-free fan-ins, nets drawn in pieces joined by name, and visible
    rail names on power symbols.
    R31-R33 were used twice on the pod board, which KiCad's ERC does not
    report; the netlist merged each pair. Cable parts now start at R40/C40,
    generate.py rejects duplicate references and check_nets.py fails on a pin
    in two nets. check_nets.py also drops the sheet path from net names.
    [actuator.kicad_sch, buck.kicad_sch, cable.kicad_sch, can.kicad_sch, leds.kicad_sch, mcu.kicad_sch, pod_board.kicad_sch, pod_board_bom.csv]
2026-10-07 Phase 4: CameraPipeline, camera config and the camera_check exit tool
    CameraPipeline captures through GStreamer (or replays a file), stamps,
    undistorts through precomputed maps and publishes on frameBus, with the
    camera model of the published frames (frameModel()) so consumers never
    apply the lens distortion twice. Bounded reads; a stalled camera is a
    fault. The sustained rate, gaps and lost frames are logged.
    camera_check measures each candidate size and passes it only at >= 95 %
    of the requested rate with no lost frame. Unit tests for the config,
    calibration loading and rate measurement; integration tests (label
    camera) through GStreamer's test source.
    [Camera.h, CameraConfig.h, camera_check.cpp, main.cpp]
2026-10-08 Whole system on replay, live LiDAR capture, calibration tools, setup scripts, assembly procedures
    - Every thread runs from main on a recorded drive (KITTI) against hub_sim's SafetyCore;
    replay_inspect (deterministic, --jitter for real-time timing) and the replay harness (22 checks).
    - Rule 1: straight path, 200 ms measured run, and a measured 100 ms onset confirmation
    (brake_confirm_ms); a frame without a usable LiDAR scan is no longer a tracker miss.
    - Ground plane fitted per scan; near-face measurement; duplicate measurements merged.
    - Livox Mid-360 capture: packet decoding and clock mapping (unit-tested without the SDK), SDK2 glue.
    - Recorder (--record): the system records itself in t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
    [ArRenderer.h, CameraConfig.h]
2026-10-08 Demonstration videos from the real renderer; collision barrier only where rule 1 can brake
    - replay_inspect --ar-video renders the driver's view (ArRenderer + WindowedSink, offscreen) per
    replayed frame; tools/bench_rig/make_demo_video.py composes it with the sensor view, the
    decision and a timeline (output in data/demo/, not versioned).
    - The forward-collision barrier and its gap label now require the object to be in the path rule 1
    brakes in (curved and straight); an object in the curved path only keeps its warning glow.
    [ArRenderer.h, make_demo_video.py, replay_inspect.cpp, test_ar_renderer.cpp]
2026-10-11 PCBs routed, labelled and ready to order: Rev 1 fabrication files and buy list
    Both boards placed, routed and finished by script (hardware/gen): layout.sh places
    (placement.py, with silkscreen names for every terminal, port, header and button),
    route.sh routes with Freerouting inside rule areas and net classes from the layout
    guide and keeps a board only with 0 DRC errors, 0 unconnected and exact schematic
    parity, routespec.sh checks what the DRC cannot (planes, crystal, converter loop,
    IPC-2221 widths), finish.sh adds the bottom-silkscreen identification and writes
    the fabrication files (gerbers, drill, BOM, positions) only when the DRC passes.
    - Pod 70 x 53 mm, 4 layers: In1 solid GND, In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
2026-10-15 Review fixes: no via in SMD pads, 0.6 mm round terminal pins; 5 V converter simulated
    An engineer's review of the Rev 1 boards: a via on a ground pad, and thin tracks
    close to the screw terminals. Both measured true (9 vias touching ground pads on
    the power board, 2 on the pod; 5 places within 0.3 mm of a terminal pin).
    - route.py: no via touches any surface-mount pad (stitching and mending had let a
    via sit on its own net's pad); 0.6 mm round terminal and fuse-holder pins, given
    to Freerouting as grown pad copies (KiCad does not export a pad's own clearance);
    layout.py sets that clearance on the real pads for the DRC.
    - routespec.sh checks both rules; both boards rerouted, teardrops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
2026-10-15 Relay and magnet drivers simulated; shared simulation helpers
    hardware/sim/run_relay.sh: the pod's MCU pin through 1 k, the DB-25 cable and the
    power board's 10 k pull-down into the AO3400A, the coil and its SS14 flyback, at
    9, 12 and 14.4 V, plus the pod unplugged. All checks pass: gate 2.99 V (needs
    2.5 V), MOSFET on-voltage under 10 mV, turn-off spike clamped to supply + 0.3 V
    (rating 30 V), diode current within its 1 A, relays and magnet off with the pod
    unplugged. Release times reported (relays ~9 ms, magnet ~7 ms to 10 % current).
    No vendor SPICE model exists for the AO3400A or SS14: both built from their
    datasheets; the coils use typical values until the real parts are measured.
    siml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
2026-10-15 TVS D10 now SMCJ33CA; 12 V input protection simulated
    hardware/sim/run_input.sh simulates the power board's input (3 A fuse, TVS,
    B560C reverse diode, C20) against ISO 16750-2 and ISO 7637-2 for a 12 V car:
    normal running, reversed battery, 24 V jump-start, the centrally suppressed load
    dump (35 V for 400 ms) and pulses 1 and 2a. The SMCJ24CA first chosen breaks
    down at ~27 V, so in the suppressed load dump it tried to hold the car's whole
    supply down (~100 ms at up to 141 W, near its rating). The SMCJ33CA breaks down
    at ~37 V: it stays idle through that dump (rail at most 33 V; the buck, C20 and
    D11 are rated 60 V or more) and still clamps the fast spikes. Same SMC
    footprint: only the value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
2026-10-15 Order the boards assembled by the fab: part numbers and fab-format BOM/placement
    hardware/gen/sourcing.py ties every BOM line of both boards to an exact
    manufacturer part number (the buy list's; passives from the makers the fab
    stocks cheaply; where the number is not certain, what to match). finish.sh now
    writes <board>-jlc-bom.csv and <board>-jlc-cpl.csv (JLCPCB's format; PCBWay
    takes the same) and fails if a part has no entry. The two files list the same
    parts (pod 74, power 78) with every designator.
    LAYOUT_GUIDE H3 gives the ordering steps (assembly turned on, part-match and
    rotation checks, through-hole assembly, edge rails); BOM sections 9 and 10, the
    budget, decisions, progress log a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
2026-10-16 Enclosures, brake-light and pod-supply simulations, R63/C1/C2 values, report drafts
    Enclosures (hardware/enclosures/): the E-stop housing (yellow ASA box for the 22 mm
    mushroom, M16 gland, base to a dash panel), the windscreen pod (rear cover, front shell
    whose carrier wall holds board and camera, black front plate with hood, cradle with a
    +-8 deg pitch lock on a rail, glass plate template) and the gesture puck (APDS-9960
    module under an open window, VHB base). Typical part dimensions are marked VERIFY.
    Every STL is a manifold solid.
    Simulations: run_brake.sh (PC817 input through the cable to PB5: thresholds with the
    weakest and strongest optocoupler, reversed wiring, jump-start, load dump,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
2026-10-16 Name the pcb-rev1.2 tag as the design to order
2026-10-16 Report: circuit simulations with their figures (section 9.1)
